loka92/test1strsteel/README.md

# test1strsteel
test for str steel design
