loka92/test1strsteel/roof/detailing/README.md

# Alternative C - fabrication drawing package (detailing) - Rev 6a

`C_detail_drawings.dxf` (DXF R2013, `$INSUNITS = 6` metres), generated by `gen/main.py` from the design Rev 6a calculation model (`design/C/calc/model.py`, `bracing.py`, `members_C.csv`) and `bases_C.md` Rev 8. Audit: 0 errors, 0 fixes; 4953 entities (161 real DIMENSION entities). Title strip on every sheet: "Rev 6a superstructure / Rev 8 bases / bracing Rev 5a", date 2026-09-29, revision table (1 first issue, 2 Rev 3, 3 Rev 6a). PNG renders `S00.png` ... `S06.png` (3360 x 2400) are for checking.

## Design state drawn
- Sections: IPE 300 primaries and eave beams (P13 K19-K20 IPE 330), IPE 240 rafters / edge beams / T2 / ST1-ST2, HEA 140 columns and WP1.
- Levels: roof plane TOS(y) = 3.33 + 0.06 (35.87 - y); primary top TOS + 0.03; cap-plate top TOS - 0.27; column top TOS - 0.29; column length TOS - 0.335 (P13 columns TOS - 0.365), cut to the surveyed plate-top level; clear height 3.03 m under the cap-plate nuts, 3.07 m under the eave primary. No precamber.
- Bracing Rev 5a: 13 roof rod panels in 5 strips (RT-N-W, RT-N-E, RT-JOG, RT-W, RT-E), 8 wall bays B1-B7 and B9; rod gussets only at rod corners, combined gussets at the NE corner; fin plates FP1 (2 M20) and FP2 (2 x 2 M20) at the chord splices.
- Bases Rev 8: all 27 type E (4 dia 16 post-installed rebars at 70 x 240, debonded through the 300 mm slab, 250-300 mm into the column head; plates 300x400x20 or key-pair plates per schedule; Key A / Key A + B / inboard key pairs; K21 pier base P with saddle; WP1). No through-bolts, no ceiling access.
- Load basis Rev 3 on S00; north face jog; stair well open to the north face; gutters G-W / G-E, DP1-DP4.

## Sheets
| Sheet | Title | Content |
|---|---|---|
| S00 | Index and general notes | sheet index, load basis Rev 3, materials, bolts, welding, galvanising, tolerances, erection sequence incl. temporary plan bracing of the south bands, site verification (scan, cores, pull-out tests, slab-top survey), open items |
| S01 | Roof framing plan | true coordinates, all marks with leaders, grids 1-11 / A-H, dimensions, levels table, legend, detail bubbles, drainage |
| S01a | Enlarged partial plans EP-A to EP-D (2x) | east bay + NE corner, jog panel, notch corner, north jog / header / return |
| S02 | Column schedule and wall elevations | schedule per column (K, section, levels, base type, bays, face); elevations W, E, N1, N2, S1, S2, notch face |
| S03 | Sections A-A, B-B, C-C | true scale, levels in mm, clear heights |
| S04 | Connection details D1-D8 | fin plates FP1/FP2, cap plate on HEA 140, chord tie, brace gusset, rod gusset, well upstand, eave gutter, purlin cleat |
| S04a | Connection details D9-D11 | girt cleat and wall panel, WP1, wall sill / base rail |
| S05 | Base details and schedule | type E plan and section, key-pair plan, K21 pier and WP1, base schedule per column, slab and column-head verification notes |
| S06 | Bill of materials | member pieces from members_C.csv Rev 6a, cold-formed, plates, bolts, rebars, keys; 22.2 t |

## Layout check (automated, `gen/common.py check_sheet`)
Every TEXT/MTEXT bounding box is tested against every other text box and against all linework of the sheet other than its own member and leader. Result of the issued build:

| Sheet | Texts | Text-on-text overlaps | Text-on-line overlaps |
|---|---|---|---|
| S00 | 84 | 0 | 0 |
| S01 | 263 | 0 | 0 |
| S01a | 116 | 0 | 0 |
| S02 | 501 | 0 | 0 |
| S03 | 114 | 0 | 0 |
| S04 | 188 | 0 | 0 |
| S04a | 109 | 0 | 0 |
| S05 | 389 | 0 | 0 |
| S06 | 804 | 0 | 0 |

Layout rules applied: member marks beside their member with a leader where needed, never across a bracing X; enlarged partial plans for the dense areas instead of stacked labels; text heights 0.25 plan marks / 0.2 dimensions / 0.5 titles; lineweights by layer; dimension strings outside the drawing; grid bubbles outside the dimensions; legend, north arrow and scale bar on the plan sheets; standard title block and revision table on every sheet.

## Layers
S-COL, S-PRIM, S-RAFT, S-PURL, S-BRACE, S-OPEN, S-GRID, S-DIM, S-TEXT-MEMBER, S-TEXT-DIM, S-TEXT-NOTE, S-TITLE, S-DETAIL, S-HATCH, S-DRAIN, S-EXIST.

## Marks
`Cn/Kn` steel column over concrete column n; `WP1` wind post; `P1-P19` primaries / eave beams; `T2` trimmer; `R1-R11` rafter lines (pieces Rn.i south to north); `ST1/ST2` roof-truss posts; `B1-B7, B9` wall X bays; `RT-*` roof rod strips; `D1-D11` connection details; `E`, `P` base types; sections `A`, `B`, `C`.

## Regenerate
`cd gen && python3 main.py` (build, audit, overlap check, renders); `--norender` skips the PNGs.
