loka92/test1strsteel/roof/3d/README.md

# Alternative C - 3D concept model (design Rev 3, bases Rev 4b)

3D model of the post-and-beam braced steel roof over the existing slab, built for the client to understand the column / beam / bracing system. Everything is generated by `build_3d.py` from the design geometry - nothing is drawn by hand and no member is invented:

- `design/C/calc/model.py` - column nodes (27 concrete columns from `geometry.json`), the 11 rafter lines, the 20 primaries / eave beams / trimmer T2, the 10 braced bays B1-B10, the north-edge jog, `TOS(y) = 3.33 + 0.06 (35.87 - y)`, column tops TOS - 0.30, primary tops TOS + 0.05.
- `design/C/calc/bracing.py` - the 24 roof rod panels (RT-N-W, RT-N-E, RT-S-E, RT-S-W, RT-W, RT-E, RT-JOG).
- `detailing/gen/geom.py` (the drawing generator, cross-checked against model.py at run time) - purlin rows, roof-truss posts ST1 / ST2, WP1 at its Rev 4b position, base types B1 / B2 / P, girt rows, eave rails and the wall header.

Units m, world coordinates identical to the plan (S01) and `geometry.json`; z = 0 is the top of the existing slab. Regenerate with `cd roof/3d && python3 build_3d.py` (ezdxf 1.4, matplotlib). `model_stats.json` holds the entity counts and the source cross-checks.

## Files

| File | Content |
|---|---|
| `C_concept_3d.dxf` | DXF R2013, metres, 368 MESH solids + 64 3D polylines + 41 TEXT marks, audit 0 errors |
| `iso_SW.png`, `iso_SE.png` | isometrics from the south-west / south-east, all layers |
| `iso_NE_no_panel.png` | isometric from the north-east with the sandwich panel hidden (purlins, rafters, roof rods) |
| `elev_N.png`, `elev_S.png` | orthographic elevations from the north and the south |
| `section_xray.png` | panel and purlins hidden, framing faded, wall bays B1-B10 and roof rod panels highlighted and labelled |
| `overview.png` | 4-view composite (SW, SE, NE no panel, x-ray) |
| `build_3d.py`, `model_stats.json` | generator and its output statistics |

## Layers (AutoCAD colour index)

| Layer | Colour | Content | Entities |
|---|---|---|---|
| `3D-EXIST-SLAB` | 253 grey | existing slab 300 mm, L-shape less the notch, stair well (open to the north face) and elevator well as openings | 1 |
| `3D-EXIST-COL` | 253 grey | 27 existing concrete columns 0.2 x 0.4 x 3.5 m below the slab | 27 |
| `3D-COL` | 5 blue | 27 HEA 160 columns C1-C27 (160 x 152, web oriented as on S02) from the base plate to TOS - 0.30, 27 cap plates 200 x 280 x 20, wind post WP1 | 55 |
| `3D-PRIM` | 1 red | 19 IPE 330 primaries / eave beams (330 x 160), level, top at TOS + 0.05, column centre to column centre | 19 |
| `3D-RAFT` | 3 green | 11 IPE 270 rafter lines (270 x 135) on the 6 % plane, split into 51 simple-span pieces at the primaries (fin plates, flange faces + 10 mm); trimmer T2; roof-truss posts ST1 / ST2 (4 pieces) | 56 |
| `3D-PURL` | 8 grey | 110 Z200 purlin pieces (200 x 70) @ 1.5 m following the plane, only over roofed cells (none over the wells or the notch); 2 C200 eave rails | 112 |
| `3D-BRACE-WALL` | 6 magenta | 20 L70x7 diagonals (2 per bay, B1-B10) from the base gusset (+0.15) to the primary / rafter centre line | 20 |
| `3D-BRACE-ROOF` | 2 yellow | 48 M24 rods (2 per panel, 24 panels) at rafter mid-depth; drawn at r = 20 mm for visibility | 48 |
| `3D-BASE` | 30 orange | 28 base plates: B1 / P 300 x 400 x 25, B2 800 x 550 x 30 (centred in the model; the real B2 plates sit 100 outboard / 450 inboard, S05), WP1 250 x 250 x 15 | 28 |
| `3D-PANEL` | 9, 60 % transparent | PIR sandwich panel 50 mm on the purlins (TOS + 0.20 to + 0.25), one plate cut around the elevator well and the stair well; freeze the layer to see the framing | 1 |
| `3D-WALL` | 251 | wall panel outline of the 7 perimeter faces + the 0.5 m return at the jog, 54 girt rows, the wall header over the stair well, the well outlines on the slab | 65 |
| `3D-TEXT` | 7 | 3D-placed TEXT: C1-C27 above each column, B1-B10 outside each braced bay (facing outwards), WP1, T2, ST1, ST2 | 41 |

## Viewing the DXF

The model-space viewport is saved as a **SW isometric, flat shaded with edges** (VPORT direction -1,-1,1, target at the building centre), so AutoCAD / BricsCAD / DWG TrueView open it in 3D. Four named views are stored: `SW-ISO`, `SE-ISO`, `NE-ISO`, `NW-ISO` (`VIEW` > Restore). If the viewer ignores the saved viewport, type `VPOINT` and enter `-1,-1,1` (SW) or `1,-1,1` (SE), then `SHADE` (or `VSCURRENT` > Conceptual); `-VIEW` `_SWISO` also works. Freeze `3D-PANEL` to look at the framing, freeze `3D-PURL` as well to see the roof rods, isolate `3D-BRACE-WALL` + `3D-BRACE-ROOF` + `3D-COL` for the lateral system alone. All bodies are MESH entities (metre units, `$INSUNITS = 6`), so they also import into Rhino, SketchUp, Navisworks and Blender.

## How the system works (plain language)

**Gravity.** Loads land on the 50 mm sandwich panel, which spans 1.5 m between the Z200 purlins; the purlins carry them to the green IPE 270 rafters, the rafters to the red IPE 330 primaries on every column row, and the primaries down the 27 blue HEA 160 columns into the existing concrete columns under the slab. Every joint is a simple pin.

**Lateral (wind, seismic).** Wind on the wall panels goes into the girts, then the columns, which send half up to the roof. The yellow M24 rod panels turn the roof into a stiff plate (diaphragm) that carries the load sideways to the ten magenta X-braced wall bays B1-B10, whose diagonals take it down to the base plates, shear keys and anchors in the slab. Those bays must stay door-free.

**Level primaries, sloping rafters.** The primaries sit level on the column cap plates, so every column and cap detail is the same; the 6 % drainage fall is made by the rafters alone, whose tops follow the plane from 4.55 m (south) to 3.33 m (north).

**Openings.** The wells are not roofed; trimmer T2 and the rafters beside the wells give the purlins and the upstand an edge to bear on. The stair well reaches the north wall, so a wall header replaces the eave beam there.

**Thermal.** East-west movement is restrained by the path B2 - roof rods - B1 and designed for; elsewhere the fin-plate clearances release it.

## Mismatches found between model.py and the drawings

- WP1 is at the notch corner (77.89, 19.97) in `model.py` (wall-load model) but at (77.61, 20.25) on S01 / S02 (Rev 4b, moved 280 mm inboard); the drawn position is used here.
- Rafter lines are not on the column centres on lines 3, 5, 6 and 11: R72 is 100 mm east of K26 (71.99), R78 110 mm west of K10 (77.89), R82 (x 81.85) is 40-70 mm off K3, K11, K17, K21 and R95 (x 95.55) 40-70 mm off K4, K14, K18, K23. The drawings accept this ("columns at true positions") because the rafters bear on the primaries, not on the columns; the model shows the rafters where the design puts them.
- `model.py`'s docstring still describes Rev 2 levels (TOS 3.30, column length TOS - 0.34) while its functions and the drawings are Rev 3 (3.33, TOS - 0.35); the functions are used.
- The rafter / primary / bay / rod-panel lists in `model.py`, `bracing.py` and `detailing/gen/geom.py` agree exactly (checked at run time).
