loka92/test1strsteel/roof/design/C/bases_C.md

# Alternative C - base and anchor design note, Rev 8 (bases_C.md)

**Rev 8 = Rev 7 re-run with the Rev 6 sections (IPE 300 / IPE 240 / HEA 140, brief Rev 7): lighter roof (G, seismic mass -7 %), column HEA 140 on the plate, all 27 reactions re-tabulated; base plates 300 x 400 x 20 (were 25: plate T-stub <= 0.13, plate strip under the key moment <= 0.72 at the E-W bay bases K23 / K22 / K27 / K20 - the governing check there now), rebars, keys and the key-pair layouts unchanged; the reactions of every base are in the tables below and in reactions_C.csv. Levels (Rev 6a, review A1): column top = cap underside TOS - 0.29, base-plate top TOS - 0.335 (grout 25 + plate 20), column length L = TOS - 0.335 exactly; K19 and K20 under the IPE 330 primary P13 30 mm lower (TOS - 0.32 / - 0.365); every column is cut to the surveyed plate-top level.**

**Rev 7 = Rev 6 re-run with the rationalised bracing of design Rev 5 (8 wall bays, B8 and B10 removed): the forces at K15, K19 (B5 alone on the x 68 line), K20, K27 (B7 alone on the x 77.8 line), K10, K16 (no bay) changed; the detail, keys and plates are unchanged.**

**Rev 6 = Rev 5a re-run with load basis Rev 3 (design Rev 4): services 0.10, Q 0.40, no wall self-weight, wind q_p by direction with the flat-roof Table 7.2 zones, net bracing uplift per braced line, and the amplified two-mass seismic case (S_a 0.65 g E-W / 0.61 g N-S, q 1.5) which now governs every braced bay and its bases. The detail is unchanged; utilisations below are the new ones. Key pairs and plate sizes are kept: they are set by the edge condition of each column (parallel-edge shear at Key A), not by the force level, and the E-W bay bases K5, K7, K22, K23 now carry 64-71 kN seismic shear (K7 key pair 0.90).**

Self-contained note for the base reviewer. Rev 5a closes the Rev 5 sign-off (V1-V6) and adopts its recommendation: **one base detail at all 27 columns** - a post-installed rebar connection into the column head (EAD 330087, designed to EN 1992-1-1 8.4 / 8.7), debonded through the 300 mm slab, with the Rev 4b/5 shear keys. No through-bolts, no slab-cone check, no solid-zone criterion anywhere. Loads from `calc/run_all.py` (reactions_C.csv: every column and load case). Units kN, mm, MPa.

**Rev 5a in one paragraph.** V1: the column-head anchorage is a post-installed rebar connection, not an anchor: **4 x dia 16 B500 bars with a threaded end** (M16 thread, or an M16 8.8 rod only if the injection system holds an EAD 330087 assessment for it), embedded **300 mm into the column head where the scan allows, 250 mm minimum**, lapped 1:1 with the corner dia14 bars; capacity by bond f_bd = 2.7 MPa (C25, good bond): 4 x 33.9 = **136 kN at 250 mm** (163 kN at 300), steel 4 x 87 = 350 kN, receiving bars 4 x 67 = 268 kN; l_0 = max(1.5 l_b,rqd, 15 d = 240, 200) <= 250; d < 20 so the existing dia6/200 links are the only transverse steel needed (8.7.4), splitting covered by the EC2 cover rules. V2: the top 300 mm of each bar is **debonded (sleeve), the column part only is injected**, so the edge-slab cone is never loaded. V3: pattern **70 x 240** (26 mm clear to the corner bars), cover-meter scan of the column faces from below projected to the slab top plus GPR from above, 10 mm pilot drill with feed monitoring, relocation +/-15 mm on steel contact, plate holes match-drilled or 30 mm oversize with 10 mm plate washers; V4: proof test of 3 bars to >= 60 kN with displacement readings. K21 is P with the same rebar logic plus the saddle. The former B1 interior detail (4 M20 h_ef 250 in the slab, 800 x 800 solid zone) is kept in the appendix as the client's fewer-holes option. Holes to scan and drill: **27 x 4 = 108** (plus 37 key pockets set by the same scan).

## 1. The base detail (type E, all 27 columns; P = E + saddle at K21)

- Base plate 300 x 400 x 20 S275 (Key A / Key A + B bases) or the key-pair plate of section 3 (20 mm, no stiffeners: no lever, concentric uplift), on 25 +/- 5 mm non-shrink grout; **columns cut to the surveyed plate-top level**.
- **4 dia 16 B500 post-installed bars, threaded end M16 (EAD 330087 injection system), at 70 x 240** - 240 along the concrete column's long axis, 70 across, centred on the column - i.e. 35 / 120 mm from the column centre, 26 mm nominal clear to the corner dia14 bars (cover 30, links dia6). Hole 20 mm, depth 300 (slab) + 300 (column head; 250 minimum); the **top 300 mm debonded with a plastic sleeve, resin injected in the column part only** (V2). Plate holes 30 mm with 10 mm plate washers (or match-drilled after the bars are set); nuts snug + 1/4 turn.
- Shear as Rev 4b/5: Key A SHS 90x90x8 under the column centre (interior and Key A + Key B bases), Key B 60 mm bar 180 inboard (c1 250) where an outward shear > 3 kN points to an edge < 0.25 m, inboard key pairs at K1, K2, K5, K7, K10, K15, K18, K19, K20, K22, K23, K25, K27; rigid-post key-moment model; saddle at K21.
- **Scan / drill procedure (V3):** (1) cover-meter scan of all four column faces below the slab over the top 600 mm: bar positions, link spacing, cover (+/-3-5 mm); (2) GPR from above over the head to confirm and to see the slab top bars and the solid zone; (3) project the bars to the slab top, mark the 70 x 240 pattern and the key pockets, adjust +/-15 mm to keep >= 20 mm clear of every bar; (4) 10 mm pilot drill 600 deep with feed monitoring - on steel contact stop, relocate within +/-15 mm, re-pilot; (5) 20 mm production hole, clean (brush/blow x2), sleeve the top 300, inject the bottom 300, set the bar; (6) proof test 3 bars (one per zone) to >= 60 kN holding 2 min with displacement <= 1 mm (V4); (7) file the scan sheet with the final pattern per head.

**Wind post WP1** (notch corner, no concrete column): post 280 mm inboard on both axes at (77.61, 20.25), plate 250 x 250 x 15, one centred 60 mm key (c1 250 both ways), 2 M12 for location, no uplift. Demand 11.4 / 8.5 kN vs 41.9 kN -> 0.27.

## 2. Resistances (EN 1992-1-1 8.4 / 8.7 for the rebar connection; EN 1992-4 for the keys; EN 1993-1-8 and EN 1992-1-1 6.7 for plates and keys)

| Item | Formula / factors | Value |
|---|---|---|
| (appendix option B1) anchor steel, per M20 | 196 / 1.4 | 140.0 kN |
| (appendix option B1) cone, single, slab 300 | k 7.2 (cracked) sqrt(25) 250^1.5 | N0_Rk,c = 142.3 kN |
| (appendix option B1) cone group, interior (800 zone) | s_cr,N 750, c_cr 375: A_c,N/A0 = 800 x 800 / 750^2 = 1.138, psi_s 0.91 (zone-limited: h_ef 250 gives the same 98 kN as 200) | N_Rd,c = 98.0 kN |
| (for reference) cone group with one edge at 100 mm / corner | outboard row 60 mm from the face | 50.5 / 37.8 kN - why edge bases are type E |
| **E / P rebar bond in the column head (EC2 8.4)** | 4 x pi x 16 x l_b x f_bd, f_bd = 2.25 x 1.0 x 1.0 x f_ctd (1.2) = 2.7 MPa (C25, good bond): embed 250 (minimum) -> 4 x 33.9 | **N_Rd = 136 kN** (embed 300: 163 kN) |
| E rebar steel | dia 16 B500, 4 x 201 x 435 | 350 kN |
| E lap with the corner dia14 bars | each bar laps 1:1 with the nearest corner dia14 (26 mm clear, close lap, alpha6 1.5): receiving capacity 4 x 154 x 435 = 268 kN; K19: sigma_sd = 18.3 kN / 201 mm2 = 91 MPa -> l_b,rqd = 4 x 91 / 2.7 = 135, l_0 = 1.5 x 135 = 203 < l_0,min = 15 d = 240 <= 250 provided; d < 20: existing dia6/200 links are the transverse steel (8.7.4); splitting by the EC2 cover rules (c 30 >= d) | 268 kN |
| E slab part | debonded (sleeve) - the slab cone and the slab bond are never loaded (V2); the bar tip sits 250-300 mm inside a column that continues downward: no cone | - |
| Eccentric tension | psi_ec,N = 1/(1 + 2 e_N/s_cr,N) per direction, e_N = M_key/N_t (key moment V x 85 mm); max anchor N_t/4 + M/(2 s) | per case |
| Plate bearing (compression) | c = 61 mm, A_eff = 663 cm2 at 10 MPa | 663 kN |
| Plate T-stub under concentric uplift, per row | m = 65, l_eff 300, t 25 | 506 kN |
| Key A bearing (centre key and inboard pairs) | rigid stub, z0 = 113 mm, p_max = V z0/(b(z0 D - D^2/2)), b 90, D 180, sigma_Rd 1.5 f_cd = 25 MPa (confined, >= 250 mm from a face) | **V_Rd,A = 83.8 kN** per key |
| Key A bending / weld | SHS 90x90x8 W_pl 75 cm3 f_y 355 -> 26.6 kNm at lever 85; a = 8 | 313 / 673 kN |
| Key A parallel to an edge (EN 1992-4 7.2.2.5 with psi_alpha = 2) | c1 = edge distance - 45: c1 55 -> 18.5 kN, c1 155 -> 56.6 kN, c1 255 -> 90.9 kN | used at K3, K4, K6, K8, K11, K14, K16, K17, K24, K26 |
| Key towards an edge (Key B c1 250; key pair c1 >= 255; Key A 0.25-0.6 m) | 7.2.2.5, k9 1.7 cracked, d_nom 60 / 90, l_f 180, A_c,V/A0, psi_h | c1 250 (d 60): **41.9 kN**; c1 255 (d 90): **45.5 kN**; c1 355 (d 90): 58.2 kN |
| Key B bearing / bending | 60 mm bar, plain f_cd; W_pl d^3/6, f_y 335 | 37.2 / 142 kN |
| P (K21) saddle | two 15 mm plates 400 x 150 on the pier faces, cantilever 150 | 82.5 kN |

**Key-moment model (T3), one model for every key:** the shear resultant acts 85 mm below the plate; the moment V x 85 mm is carried by the grouted pocket as a rigid post (pressure linear about the rotation point z0 = 113 mm, p_max <= 25 MPa - the bearing check above), not by the anchors or bolts. Justification: the 180 mm stub in a C50 grout annulus (E about 30 GPa, 25 mm thick) in a 200 mm pocket has a rotational stiffness of the order of 10 MNm/rad, two orders above the couple of four M20 anchors 80 mm apart (about 4 x 250 kN/mm x 0.04^2 = 0.1 MNm/rad); the pocket therefore takes the moment before the anchors move. Hence the rebars carry N_t only, concentric. Bars carry no shear (30 mm oversize holes); keys and saddle carry no tension.

## 3. Final base table (ULS envelope; reactions_C.csv has every case). Rebar pattern 70 x 240: the 240 runs along the concrete column's long axis (E-W for the 0.4 x 0.2 columns K1, K2, K5, K9-K14, K21-K24; N-S for the others), the 70 across it; 4 holes per base, 108 in all.

| Col | Type | Long axis | Bays | Near edges (< 0.25 m) | Keys | Rebars (mm from the column centre) | N_c max (case) | N_t max (case) | V max (case) | Tension util. | Key util. | Plate util. | **Governing** | Base plate (mm from the column centre) | Scan / drill | Slab condition (keys and plate only) |
|---|---|---|---|---|---|---|---|---|---|---|---|---|---|---|---|---|
| K1 | **E** | E-W | B1 | +y | A-pair at (-300, -200) / (300, -200) | 4 dia16 B500 at (+/-120, +/-35), embed 300 (250 min) into the head, top 300 debonded | 48.7 (ULS2E) | 37.6 (ULS3N) | 41.7 (ULS4+x) | 0.28 | 0.43 | 0.07 | **0.43** (plate strip at key moment) | x -400..400, y -300..100 (800 x 400 x 20) | face cover-meter + GPR, pilot 10, relocate +/-15, plate holes 30 | solid 300 over the key bodies x -700..700, y -600..100 |
| K2 | **E** | E-W | B1 | +y | A-pair at (-300, -200) / (300, -200) | 4 dia16 B500 at (+/-120, +/-35), embed 300 (250 min) into the head, top 300 debonded | 44.2 (ULS2W) | 38.6 (ULS3E) | 41.7 (ULS4-x) | 0.28 | 0.43 | 0.07 | **0.43** (plate strip at key moment) | x -400..400, y -300..100 (800 x 400 x 20) | face cover-meter + GPR, pilot 10, relocate +/-15, plate holes 30 | solid 300 over the key bodies x -700..700, y -600..100 |
| K3 | **E** | N-S | - | +y | A centre | 4 dia16 B500 at (+/-35, +/-120), embed 300 (250 min) into the head, top 300 debonded | 17.4 (ULS2N) | 20.6 (ULS3N) | 14.1 (ULS2N) | 0.15 | 0.37 | 0.03 | **0.37** (Key B outward +y) | 300 x 400 x 20 | face cover-meter + GPR, pilot 10, relocate +/-15, plate holes 30 | solid 300 under the plate and Key A pocket (+/- 400) |
| K4 | **E** | N-S | - | +x,+y | A centre | 4 dia16 B500 at (+/-35, +/-120), embed 300 (250 min) into the head, top 300 debonded | 10.4 (ULS2N) | 13.3 (ULS3E) | 14.3 (ULS2N) | 0.10 | 0.36 | 0.02 | **0.36** (Key B outward +x) | 300 x 400 x 20 | face cover-meter + GPR, pilot 10, relocate +/-15, plate holes 30 | solid 300 under the plate and Key A pocket (+/- 400) |
| K5 | **E** | E-W | B2 | +y | A-pair at (-300, -200) / (300, -200) | 4 dia16 B500 at (+/-120, +/-35), embed 300 (250 min) into the head, top 300 debonded | 47.6 (ULS2E) | 41.7 (ULS3W) | 63.0 (ULS4+x) | 0.31 | 0.65 | 0.07 | **0.65** (plate strip at key moment) | x -400..400, y -300..100 (800 x 400 x 20) | face cover-meter + GPR, pilot 10, relocate +/-15, plate holes 30 | solid 300 over the key bodies x -700..700, y -600..100 |
| K6 | **E** | N-S | - | -x,+y | A centre | 4 dia16 B500 at (+/-35, +/-120), embed 300 (250 min) into the head, top 300 debonded | 12.4 (ULS2N) | 15.5 (ULS3N) | 15.7 (ULS2N) | 0.11 | 0.39 | 0.02 | **0.39** (Key B outward -x) | 300 x 400 x 20 | face cover-meter + GPR, pilot 10, relocate +/-15, plate holes 30 | solid 300 under the plate and Key A pocket (+/- 400) |
| K7 | **E** | N-S | B2 | +x,+y | A-pair at (-200, -700) / (-200, -100) | 4 dia16 B500 at (+/-35, +/-120), embed 300 (250 min) into the head, top 300 debonded | 43.5 (ULS4+x) | 27.4 (ULS4-x) | 63.0 (ULS4-x) | 0.20 | 0.88 | 0.07 | **0.88** (E key pair bearing) | x -300..100, y -800..150 (400 x 950 x 20) | face cover-meter + GPR, pilot 10, relocate +/-15, plate holes 30 | solid 300 over the key bodies x -600..100, y -1100..200 |
| K8 | **E** | N-S | - | -x | A centre | 4 dia16 B500 at (+/-35, +/-120), embed 300 (250 min) into the head, top 300 debonded | 19.3 (ULS2N) | 18.6 (ULS3W) | 14.0 (ULS2N) | 0.14 | 0.37 | 0.03 | **0.37** (Key B outward -x) | 300 x 400 x 20 | face cover-meter + GPR, pilot 10, relocate +/-15, plate holes 30 | solid 300 under the plate and Key A pocket (+/- 400) |
| K9 | **E** | E-W | - | - | A centre | 4 dia16 B500 at (+/-120, +/-35), embed 300 (250 min) into the head, top 300 debonded | 48.4 (ULS2N) | 38.4 (ULS3N) | 0.0 (ULS1) | 0.28 | 0.00 | 0.07 | **0.28** (E rebar bond in the column head, embed 250 min) | 300 x 400 x 20 | face cover-meter + GPR, pilot 10, relocate +/-15, plate holes 30 | solid 300 under the plate and Key A pocket (+/- 400) |
| K10 | **E** | E-W | - | +y | A-pair at (-300, -200) / (300, -200) | 4 dia16 B500 at (+/-120, +/-35), embed 300 (250 min) into the head, top 300 debonded | 36.4 (ULS2N) | 26.1 (ULS3N) | 0.0 (ULS1) | 0.19 | 0.00 | 0.05 | **0.19** (E rebar bond in the column head, embed 250 min) | x -400..400, y -300..100 (800 x 400 x 20) | face cover-meter + GPR, pilot 10, relocate +/-15, plate holes 30 | solid 300 over the key bodies x -700..700, y -600..100 |
| K11 | **E** | E-W | - | +y | A centre | 4 dia16 B500 at (+/-120, +/-35), embed 300 (250 min) into the head, top 300 debonded | 38.0 (ULS2N) | 26.2 (ULS3N) | 0.0 (ULS1) | 0.19 | 0.00 | 0.06 | **0.19** (E rebar bond in the column head, embed 250 min) | 300 x 400 x 20 | face cover-meter + GPR, pilot 10, relocate +/-15, plate holes 30 | solid 300 under the plate and Key A pocket (+/- 400) |
| K12 | **E** | E-W | - | - | A centre | 4 dia16 B500 at (+/-120, +/-35), embed 300 (250 min) into the head, top 300 debonded | 60.4 (ULS2N) | 44.6 (ULS3N) | 0.0 (ULS1) | 0.33 | 0.00 | 0.09 | **0.33** (E rebar bond in the column head, embed 250 min) | 300 x 400 x 20 | face cover-meter + GPR, pilot 10, relocate +/-15, plate holes 30 | solid 300 under the plate and Key A pocket (+/- 400) |
| K13 | **E** | E-W | - | - | A centre | 4 dia16 B500 at (+/-120, +/-35), embed 300 (250 min) into the head, top 300 debonded | 47.6 (ULS2N) | 38.7 (ULS3E) | 0.0 (ULS1) | 0.28 | 0.00 | 0.07 | **0.28** (E rebar bond in the column head, embed 250 min) | 300 x 400 x 20 | face cover-meter + GPR, pilot 10, relocate +/-15, plate holes 30 | solid 300 under the plate and Key A pocket (+/- 400) |
| K14 | **E** | E-W | B6 | +x | A centre | 4 dia16 B500 at (+/-120, +/-35), embed 300 (250 min) into the head, top 300 debonded | 33.0 (ULS4+y) | 27.8 (ULS3N) | 35.0 (ULS4-y) | 0.20 | 0.57 | 0.05 | **0.57** (Key A parallel to edge +x) | 300 x 400 x 20 | face cover-meter + GPR, pilot 10, relocate +/-15, plate holes 30 | solid 300 under the plate and Key A pocket (+/- 400) |
| K15 | **E** | N-S | B5 | -x | A-pair at (200, -300) / (200, 300) | 4 dia16 B500 at (+/-35, +/-120), embed 300 (250 min) into the head, top 300 debonded | 44.3 (ULS4+y) | 36.3 (ULS4-y) | 48.3 (ULS4-y) | 0.27 | 0.50 | 0.07 | **0.50** (plate strip at key moment) | x -100..300, y -400..400 (400 x 800 x 20) | face cover-meter + GPR, pilot 10, relocate +/-15, plate holes 30 | solid 300 over the key bodies x -100..600, y -700..700 |
| K16 | **E** | N-S | - | - | A centre | 4 dia16 B500 at (+/-35, +/-120), embed 300 (250 min) into the head, top 300 debonded | 19.5 (ULS2N) | 5.0 (ULS3N) | 0.0 (ULS1) | 0.04 | 0.00 | 0.03 | **0.04** (E rebar bond in the column head, embed 250 min) | 300 x 400 x 20 | face cover-meter + GPR, pilot 10, relocate +/-15, plate holes 30 | solid 300 under the plate and Key A pocket (+/- 400) |
| K17 | **E** | N-S | - | - | A centre | 4 dia16 B500 at (+/-35, +/-120), embed 300 (250 min) into the head, top 300 debonded | 20.8 (ULS2N) | 5.0 (ULS3S) | 0.0 (ULS1) | 0.04 | 0.00 | 0.03 | **0.04** (E rebar bond in the column head, embed 250 min) | 300 x 400 x 20 | face cover-meter + GPR, pilot 10, relocate +/-15, plate holes 30 | solid 300 under the plate and Key A pocket (+/- 400) |
| K18 | **E** | N-S | B6,B9 | +x | A-pair at (-200, -300) / (-200, 300) | 4 dia16 B500 at (+/-35, +/-120), embed 300 (250 min) into the head, top 300 debonded | 34.2 (ULS4+y) | 14.8 (ULS3E) | 36.2 (ULS4+y) | 0.11 | 0.37 | 0.05 | **0.37** (plate strip at key moment) | x -300..100, y -400..400 (400 x 800 x 20) | face cover-meter + GPR, pilot 10, relocate +/-15, plate holes 30 | solid 300 over the key bodies x -600..100, y -700..700 |
| K19 | **E** | N-S | B5 | -x | A-pair at (200, -300) / (200, 300) | 4 dia16 B500 at (+/-35, +/-120), embed 300 (250 min) into the head, top 300 debonded | 76.0 (ULS2N) | 50.2 (ULS3W) | 48.3 (ULS4+y) | 0.37 | 0.50 | 0.11 | **0.50** (plate strip at key moment) | x -100..300, y -400..400 (400 x 800 x 20) | face cover-meter + GPR, pilot 10, relocate +/-15, plate holes 30 | solid 300 over the key bodies x -100..600, y -700..700 |
| K20 | **E** | N-S | B7 | +x | A-pair at (-200, -300) / (-200, 300) | 4 dia16 B500 at (+/-35, +/-120), embed 300 (250 min) into the head, top 300 debonded | 84.2 (ULS2S) | 43.2 (ULS3N) | 63.8 (ULS4-y) | 0.32 | 0.66 | 0.13 | **0.66** (plate strip at key moment) | x -300..100, y -400..400 (400 x 800 x 20) | face cover-meter + GPR, pilot 10, relocate +/-15, plate holes 30 | solid 300 over the key bodies x -600..150, y -700..700 |
| K21 | **P** | E-W | - | +y,-y | saddle | 4 dia16 B500 at (+/-120, +/-35), embed 300 (250 min) into the head, top 300 debonded | 27.0 (ULS2N) | 9.3 (ULS3S) | 17.1 (ULS2E) | 0.07 | 0.21 | 0.04 | **0.21** (saddle plates) | 300 x 400 x 20 + saddle | face cover-meter + GPR, pilot 10, relocate +/-15, plate holes 30 | pier top 500 mm scanned; faces accessible |
| K22 | **E** | E-W | B3 | -y | A-pair at (-300, 200) / (300, 200) | 4 dia16 B500 at (+/-120, +/-35), embed 300 (250 min) into the head, top 300 debonded | 70.3 (ULS2E) | 27.4 (ULS3W) | 69.0 (ULS4+x) | 0.20 | 0.71 | 0.11 | **0.71** (plate strip at key moment) | x -400..400, y -100..300 (800 x 400 x 20) | face cover-meter + GPR, pilot 10, relocate +/-15, plate holes 30 | solid 300 over the key bodies x -700..700, y -100..600 |
| K23 | **E** | E-W | B3,B9 | +x,-y | A-pair at (-700, 200) / (-100, 200) | 4 dia16 B500 at (+/-120, +/-35), embed 300 (250 min) into the head, top 300 debonded | 54.8 (ULS4+x) | 45.1 (ULS3E) | 70.2 (ULS4-x) | 0.33 | 0.72 | 0.08 | **0.72** (plate strip at key moment) | x -800..200, y -100..300 (1000 x 400 x 20) | face cover-meter + GPR, pilot 10, relocate +/-15, plate holes 30 | solid 300 over the key bodies x -1100..200, y -100..600 |
| K24 | **E** | E-W | - | - | A centre | 4 dia16 B500 at (+/-120, +/-35), embed 300 (250 min) into the head, top 300 debonded | 16.5 (ULS2N) | 10.5 (ULS3E) | 13.4 (ULS2E) | 0.08 | 0.23 | 0.02 | **0.23** (Key A towards edge -y) | 300 x 400 x 20 | face cover-meter + GPR, pilot 10, relocate +/-15, plate holes 30 | solid 300 under the plate and Key A pocket (+/- 400) |
| K25 | **E** | N-S | B4 | -x | A-pair at (200, 0) / (200, 600) | 4 dia16 B500 at (+/-35, +/-120), embed 300 (250 min) into the head, top 300 debonded | 40.4 (ULS4-x) | 27.8 (ULS4+x) | 31.9 (ULS4+x) | 0.20 | 0.38 | 0.06 | **0.38** (E key pair bearing) | x -100..300, y -150..700 (400 x 850 x 20) | face cover-meter + GPR, pilot 10, relocate +/-15, plate holes 30 | solid 300 over the key bodies x -100..600, y -300..1000 |
| K26 | **E** | N-S | B4 | - | A centre | 4 dia16 B500 at (+/-35, +/-120), embed 300 (250 min) into the head, top 300 debonded | 42.2 (ULS4+x) | 26.0 (ULS4-x) | 31.9 (ULS4-x) | 0.19 | 0.38 | 0.06 | **0.38** (Key A SHS bearing) | 300 x 400 x 20 | face cover-meter + GPR, pilot 10, relocate +/-15, plate holes 30 | solid 300 under the plate and Key A pocket (+/- 400) |
| K27 | **E** | N-S | B7 | +x | A-pair at (-200, 0) / (-200, 600) | 4 dia16 B500 at (+/-35, +/-120), embed 300 (250 min) into the head, top 300 debonded | 50.4 (ULS4-y) | 40.9 (ULS4+y) | 63.8 (ULS4+y) | 0.30 | 0.66 | 0.08 | **0.66** (plate strip at key moment) | x -300..100, y -150..700 (400 x 850 x 20) | face cover-meter + GPR, pilot 10, relocate +/-15, plate holes 30 | solid 300 over the key bodies x -600..150, y -300..1000 |
| WP1 | post | - | - | +x,-y | one 60 mm key centred, c1 250 | 2 M12 location | 1.7 | 0 | 11.4 | - | 0.27 | - | **0.27** (key edge) | 250 x 250 x 15 at (77.61, 20.25) | GPR for the edge beam | notch edge beam, 600 x 600 around the post |

Worst base **K7 (E): 0.88 (E key pair bearing, ULS4-x)**; worst tension 0.37 at K19; worst key 0.88 at K7; worst plate 0.13 at K20. All 27 bases and WP1 <= 1.0 with the real slab edges; tension utilisations are on the 250 mm minimum embedment (136 kN), 0.83 x these with the 300 mm target embedment.

## 4. Worked checks

**K12 (E)** - 4 dia16 post-installed rebars 70 x 240, embed 250-300 into the column head, debonded through the slab; keys A centre. Governing tension case ULS3N: N_t 44.6 kN with V = (0.0, 0.0): Key A SHS bearing 0.00; E rebar bond in the column head, embed 250 min (N_Rd 136) 0.33; E rebar steel dia 16 B500 (11 kN each) 0.13; E corner dia14 bars receiving the lap 0.17; (info) E lap length l_0 240 mm vs 250 provided 0.00; plate T-stub 0.04; plate strip at key moment 0.00. Max shear case ULS1: 0.0 kN.

**K7 (E)** - 4 dia16 post-installed rebars 70 x 240, embed 250-300 into the column head, debonded through the slab; keys inboard pair. Governing tension case ULS4-x: N_t 27.4 kN with V = (-61.2, 0.0): E key pair bearing 0.88; E key pair outward (c1 >= 255) 0.23; E rebar bond in the column head, embed 250 min (N_Rd 136) 0.20; E rebar steel dia 16 B500 (7 kN each) 0.08; E corner dia14 bars receiving the lap 0.10; (info) E lap length l_0 240 mm vs 250 provided 0.00; plate T-stub 0.03; plate strip at key moment 0.65. Max shear case ULS4-x: 63.0 kN.

**K23 (E)** - 4 dia16 post-installed rebars 70 x 240, embed 250-300 into the column head, debonded through the slab; keys inboard pair. Governing tension case ULS4-x: N_t 43.2 kN with V = (-67.3, 9.0): E key pair bearing 0.48; E key pair outward (c1 >= 255) 0.17; E rebar bond in the column head, embed 250 min (N_Rd 136) 0.32; E rebar steel dia 16 B500 (11 kN each) 0.12; E corner dia14 bars receiving the lap 0.16; (info) E lap length l_0 240 mm vs 250 provided 0.00; plate T-stub 0.04; plate strip at key moment 0.72. Max shear case ULS4-x: 70.2 kN.

**K19 (E)** - 4 dia16 post-installed rebars 70 x 240, embed 250-300 into the column head, debonded through the slab; keys inboard pair. Governing tension case ULS4+y: N_t 22.6 kN with V = (0.0, 46.4): E key pair bearing 0.35; E key pair outward (c1 >= 255) 0.35; E rebar bond in the column head, embed 250 min (N_Rd 136) 0.17; E rebar steel dia 16 B500 (6 kN each) 0.06; E corner dia14 bars receiving the lap 0.08; (info) E lap length l_0 240 mm vs 250 provided 0.00; plate T-stub 0.02; plate strip at key moment 0.50. Max shear case ULS4+y: 48.3 kN.

## 5. Site conditions: no solid-zone criterion for the anchorage

- The rebar connection depends on the column head only (6 dia14, dia6 links, C25): confirmed by the face cover-meter scan and 3-6 cores at heads (grade); no slab cone is loaded anywhere, so the 800 x 800 solid-zone criterion of Rev 4b/5 is withdrawn.
- The slab must still be solid (no blocks) and 300 mm thick under each base plate and around the key pockets (Key A: +/- 400 mm; key pairs: the key breakout bodies of the table, +/- 700 along the wall for the standard pair) - GPR from above at all 27 heads, which is also needed for the slab top bars at the pockets.
- If a column head shows fewer than 4 sound corner bars or links > 200 mm, the embedment goes to 300-350 mm (bond alone: 4 x 33.9 kN per 250 mm) and the lap is re-checked with the scanned bars before drilling; if the head cannot be drilled at all, the appendix B1 detail with its solid-zone condition applies at that head.

## 6. Before anchor installation

1. Scan sequence of section 1 (faces from below, GPR from above, pilot drill); pockets 140 / 110 mm placed to cut at most one slab top bar.
2. Proof tests (V4): 3 production bars (one interior, one edge, one corner head) loaded to >= 60 kN, held 2 min, displacement <= 1 mm; injection system with an EAD 330087 assessment for post-installed rebar, installer certified for it.
3. Drill 20 mm x 600 (300 slab + 300 head; 250 head minimum where the scan forces a shallower hole), clean, sleeve the top 300, inject the column part, set the bar; nuts snug + 1/4 turn after the grout has cured; the scan sheet with the final pattern is filed per head.

## Appendix - client option B1 for the 7 interior columns (fewer holes into column heads)

4 M20 8.8 resin anchors at 80 x 280, h_ef 250 in the 300 mm slab, cone in the 800 x 800 solid zone (98 kN interior, x 0.92 at the diagonal opening corners K16/K17), same plate and Key A. Condition: GPR-verified solid zone >= the minimum below at each of the 7 heads; saves 28 column-head holes. Utilisation and minimum zone:

| Col | B1 tension util. | Governing | Min. solid zone (mm, 300 thick) |
|---|---|---|---|
| K9 | 0.39 | anchor group cone, real edges | 550 |
| K12 | 0.46 | anchor group cone, real edges | 600 |
| K13 | 0.39 | anchor group cone, real edges | 550 |
| K16 | 0.06 | anchor group cone, real edges, -8 % diagonal corner | 400 |
| K17 | 0.07 | anchor group cone, real edges, -8 % diagonal corner | 400 |
| K24 | 0.11 | Key A towards edge -y | 400 |
| K26 | 0.33 | Key A SHS bearing | 450 |

All other 20 columns stay type E in this option (edges / corners: the slab cone with the real edge is 38-50 kN).
