loka92/test1strsteel/roof/design/C/design_report_C.md

# Alternative C - post-and-beam braced frame: design report, Rev 6a (load basis Rev 3, sections IPE 300/240 + P13 IPE 330, HEA 140, bases Rev 8, levels per review A1)

System C: E-W IPE 300 primaries on the column rows, N-S IPE 240 rafters, pinned HEA 140 columns (Rev 6: the lighter section set adopted by the client, brief Rev 7), vertical X bracing for all lateral load, roof-plane X bracing as the diaphragm. All numbers come from `calc/` (`python3 run_all.py; python3 write_report.py`); ULS design values unless stated. Companion note: `bases_C.md` (bases and anchors, self-contained).

## 0. Change log Rev 1 -> Rev 2 (basis Rev 2 and independent review, every finding addressed)

| Ref | Change |
|---|---|
| Basis: wind zones | e = 20 m: F/G strip 2.0 m deep, F corners 5.0 m along the eave; zone sets kept as the envelope (theta = 180 values for both N and S wind, F5). Roof uplift total W_S -669 kN incl. gutter (Rev 1 -614). |
| Basis / F4 | Horizontal component of the roof suction added: 14.8 kN char. northward for S wind (resultant at x 81.4, y 24.5), also as an N-S load under E/W wind; S-wind roof-level force 108.7 -> **62.5 kN** (+36 %); no friction term. Bracing, braced columns and bases re-run. |
| Basis: anchorage / F1, F2, F3 | New base for all 27 columns: 4 M20 through the slab into the column head (h_ef 300, 80 x 280 in the core), bond + cracked cone in the slab, **grouted shear key** for all shear (no anchor shear, so the cracked-edge question F2 disappears), plate 25 mm. Wall shear wL/2 is at the column base in every case (F1); base struts deleted, every base carries its full concurrent H + V_wall (F3). |
| Bracing layout | K17-K21 (Rev 1 B8) dropped - K21 is a 200 mm pier between the notch edge and the shaft opening. N-S bracing now on three lines with two bays in series each: B5 K15-K19 + **B10 K19-K25**, B7 K20-K27 + **B8 K10-K16**, B6 K14-K18 + **B9 K18-K23**; E-W B1-B4 unchanged. 10 bays; no braced-bay base has its bay shear towards a free edge < 0.25 m. |
| F6 | Gutter/fascia 0.25 kN/m (G) and -0.50 kN/m (W) on the north eave in the take-down (rafter cantilevers, eave beams, fin plates). West-block north edge kept at y 35.87 (wall line); drainage's gutter line y 35.37 to be coordinated (open item 6). |
| F7 | Column interaction with k_zy from Annex B Table B.2 (0.97-1.00): K25 0.80, K23 0.79, K22 0.75. HEA 160 confirmed. |
| F8 | Purlin uplift re-run with the 2.0 m / 5.0 m zones: corner spans (3.07 m, zone F) 8.3 kNm, stair strip 4.07 m 8.6 kNm; mid-span anti-sag row on all spans; supplier uplift capacity before order (open item 3). |
| F9 | Seismic: ULS-4 rows (1.0 G +/- 1.0 E, both directions, 5 % eccentricity) added to reactions_C.csv; floor amplification through the existing building stated as open item 5. |
| F10 | Roof diaphragm re-modelled with the rods in the drawn cells; east/west edge trusses now use diagonals over two rafter bays (depth 5.65 / 4.10 m) and posts ST1 (y 24.46, R90-R95) / ST2 (y 26.37, R68-R72) at the wall-column lines; M24 rods throughout; truss deflection by virtual work: east wall drift 10.3 mm, west 13.2 mm (SLS, incl. bay sway) vs h/150 = 26-28 mm. |
| F11 | (superseded by Rev 3: TOS(35.87) = 3.33, 3.02 m clear under the cap nuts) TOS(35.87) = 3.30 m, primary top at TOS + 0.05: clear height 3.03 m, rafter/primary bottom-flange clearance 18 mm nominal, 13 mm at the down-slope flange tip. T1 at y 35.44 and T2 at y 24.09 (half a flange inside the opening edges). R82 at x 81.85 over the shaft east wall line: client to confirm (open item 7). |
| F12 | Cap-plate bolts at pitch 200 (plate 200 x 280 x 20); primaries bolted before the rafters are landed. |
| F13 | reactions_C.csv now one row per column and load case (594 rows: ULS-1, ULS-2/3 x 4 wind directions, ULS-4 x 4, SLS) with concurrent N, V_x, V_y, near-edge flags and the base utilisation; WP1 included; envelope in section 9. |
| F14 | Angle bearing with e2 = 30 mm (124 kN per bolt): B8 gusset 0.57. |
| F15 | Base struts and wall-rail anchorage deleted; the lateral system is 10 wall bays + 13 rod panels + 2 posts. |
| **Bases Rev 3 / R1-R7** | Section 6 and `bases_C.md` re-issued after the base re-review: R1 column-cage resistance withdrawn, outward shear at the 14 near-edge bases (Rev 3 count) through a second key 180 mm inboard (c1 = 250, plain-concrete edge breakout 41.9 kN) and a saddle at the K21 pier, WP1 moved 280 mm inboard; R2 key moments V x 85 mm carried into the anchor group (psi_ec,N) and the max anchor; R3 minimum solid zone per base, coring acceptance criterion (>= 750 x 750 x 250, C25, edge beams) and a through-bolt fallback pre-designed at 9 bases; R4 anchors h_ef 200 and pockets 200 deep in the slab only, no drilling into the column heads (permitted by the client, shown unnecessary and risky); R5 f_y 335 for the bar, Key A edge check to 0.6 m; R6/R7 tables with spacing orientation, key moment, max anchor, minimum zone. Worst base at Rev 3: K19 0.91 (superseded by Rev 4). |
| **Bases Rev 4 / S1-S4** | Real slab edges modelled (column flush with the face: outboard anchor row 60 mm from the edge; shaft and stair openings as free edges): concentric cone 50 / 38 kN at edge / corner heads, Key A parallel-to-edge 18-24 kN. Base type chosen per column: **B1** concentric anchors at 0 bases (), **B2** through-bolts + inboard key pair (corrected lever statics T = N_t b/(b-c), stiffened 30 mm plate) at 0 bases (), **P** pier anchors + saddle at K21. One-sided coring criterion at edge heads. |
| **Bases Rev 4a / T1-T6** | Per-base B2 plate lengths and coring zones for the shifted layouts (K23 1000 x 550 plate, zone -1100..+250 along; K25 550 x 900 and K27 600 x 900, zone to +1000; standard 800 x 550, zone +/- 700); coring criterion made identical to the cone extents used (B1 edge heads: inboard >= 340, +/- 400 along); ONE key-moment model - rigid post in the grouted pocket - for every key (psi_ec dropped; K7 now 0.85 on the Key A parallel-edge check, cone 0.52; K14 0.49); 8 % cone reduction at the diagonal opening corners K3, K16, K17; under-slab plate 25 mm, class-3 stiffeners, skewed levers at K23/K25/K27 and the T/C couple for the slab designer stated; bond quoted with the real extents. Worst base at Rev 4a: K7 0.85 (superseded). |
| **Design Rev 3 / final critique C1-C14** | C1 north-face jog modelled: wall and roof edge at y 35.37 for x 67.89-81.79 (K6, K5, K7 on that wall), 35.87 east of x 81.79; the stair well reaches the north face, so no roof, no T1 and no eave beam across it (wall header only); 0.5 m wall return at x 81.79 on brackets from K3; rafters R68-R78 end at 35.37 (0.10-0.20 m cantilevers); gutters G-W at 35.37 and G-E at 35.87 with stop ends; roofed area 439.3 m2; loads, bracing (S-wind roof force 62.5 kN), reactions, CSVs and figure re-run. C3 plane raised 30 mm, TOS(35.87) = 3.33: **3.02 m clear under the cap-plate nuts at K1/K2**, one figure; C2 column length TOS - 0.35 (B2 0.355). C4 slotted fin plates deleted; conditioned-hall range +/-20 K, erection state +/-30 K; E-W chord path B2-RT-N-W-y 29.3-RT-N-E-B1 checked: k_eff 3.0 kN/mm, locked-in 16 kN service, ULS +15 kN with wind and 37 kN thermal-leading; K1, K2, K5, K7 checked - **K7 (and K5, whose north edge is now 0.1 m) built as B2**. C7 B2 plate extents to the slab face (100 outboard), one standard length 800; C8 drawing BOM weight quoted (25.4 t at closing sign-off, X1); C10 purlin cleat check (10.4 kN per cleat in zone F, 0.66) and panel fastener schedule from the supplier; C11 RT-JOG corrected (82.6 kN rod, 0.25); C13 K21 pattern fixed on site by the scan; C14 superseded figures removed. Worst base at Rev 3/4b: K25 0.83 (superseded by bases Rev 5). |
| **Bases Rev 5 / brief Rev 4** | Client decisions: no through-bolts, every base anchored from above; slab 300 mm. The 13 former B2 bases and the 6 lightly loaded edge bases become type **E: 4 M16 resin anchors 70 x 280 concentric in the column core, h_ef 550 (300 slab + 250 into the column head, rebar scan)**, designed as a lap with the column bars (N_Rd 257 kN, K19 0.28); the inboard lever alternatives (a)/(c) fail on the slab cone (<= 107 kN in the 800 zone vs 100-182 kN) and are not used; no bay added (d). B1 interior with h_ef 250 in the 300 slab (98 kN, zone-limited). Shear keys unchanged. Variants: B1 interior, E edge, E corner, P = K21 (superseded by Rev 5a). |
| **Bases Rev 5a / V1-V6** | Column-head anchorage re-framed as a **post-installed rebar connection (EAD 330087, EN 1992-1-1 8.4/8.7)**: 4 x dia 16 B500 threaded-end bars at 70 x 240, embedded 300 (250 min) into the column head, top 300 mm debonded so the slab cone is never loaded; f_bd 2.7 MPa: 136 kN at the 250 mm minimum (K19 0.54, K23 0.46), lap l_0 240 <= 250, receiving corner bars 268 kN, existing links suffice; scan/drill procedure (face cover-meter + GPR, pilot drill, relocation +/-15 mm, 30 mm plate holes) and proof tests to >= 60 kN. **All 27 bases built as type E** (one base detail, 108 scanned holes; K21 = E + saddle), no slab-cone check and no solid-zone criterion anywhere; B1 interior kept in an appendix as the client's fewer-holes option. Worst base at Rev 5a: K23 0.80 (superseded). |
| **Rev 4 / load basis Rev 3** | Complete re-run with the Rev 3 basis (independent load critique): services 0.10, Q 0.40 (psi 0), no wall self-weight in G / G_min (wall mass kept in the seismic mass), gutter 0.10 in G_min; wind by direction q_p N 1.25 / E, W 1.05 / S 0.75 (v_b 27, z_e 9 m, terrain I / II / III), e = 18 m, flat-roof Table 7.2 zones F -1.8 / G -1.2 / H -0.7 / I -0.2 with the pressure case I +0.2 (c_pi -0.3, +0.5 q_p) on the far half, walls D +0.75 / E -0.40 x 0.85, roof-suction component 14.8 kN, no friction; bracing uplift net per braced line; temperature +/-30 K service, +45/-25 K erection; combinations EN 1990 6.10 (6.10a/b not used). Roof-level wind N 61.9 / S 62.5 / E 63.0 / W 63.5 kN char. (Rev 3: 85.6 / 148.5 / 72.4 / 73.6). **Two-mass seismic check done: S_a at roof level 0.66 g (E-W) / 0.66 g (N-S), F 137 / 137 kN at q 1.5 - seismic now governs every braced bay** (B3 67.3 vs wind 32.5 kN ULS). Sections kept (IPE 330 / IPE 270 / HEA 160: the critic's IPE 300 / IPE 240 / HEA 140 set passes at 0.82 / 0.69 / 0.79 but with no margin on the 9.8 m primary LTB and it would re-open the detailing for 2.3 t). Bases Rev 6: same detail. Comparison table rev4_vs_rev3.md. |
| **Rev 5 / bracing rationalised (brief Rev 6)** | Roof diaphragm reduced from 24 X panels to **13 panels in five strips** (north strip west/east with rods over two rafter cells and posts at the column lines, the jog panel, the west and east edge strips over two rafter bays); both south bands unbraced - the rafters carry the south-half inertia as N-S struts to the y 29.3 chord, R78 carries the north-strip reactions down to B7; purlins act as E-W struts (Z200 3.2 kN, 0.41), eave primaries as struts to B1-B4, primaries y 29.3 as chords (0.37); ST1 / ST2 kept (truss posts under the wall-column loads). Wall bays **10 -> 8**: B8 (interior hall X) and B10 (K19-K25) removed; B5 and B7 now carry their lines alone (49 / 67 kN), bases K15, K19, K20, K27 at <= 0.52. Rods 189 m (was 366), angles 8 bays; bracing steel 1.44 t (was 2.26); worst rod 0.41, worst diagonal 0.42, worst base K7 0.88 (unchanged, K7 seismic). Analysis and figure: bracing_rev5.md / bracing_rev5.png; bases Rev 7 (forces changed at 6 bases, detail unchanged). |
| **Rev 5a / review Z1-Z6** | Z1: strut forces stated as line forces - R78 63.1 kN (= B7; the 133.6 kN of Rev 5 was the sum of the strip end shears), R68 46.4, R82 29.6, R95 63.6; every strut / chord fin plate checked for axial + shear with web bearing (68.8 kN per M20 on the 6.6 mm web), bolt shear, plate net section and weld (table in bracing_rev5.md 2b): worst web bearing 0.56 (R78); the strip-chord rafters R68 / R72 / R90 / R95 get the 3 M20 plate (2 M20 would be 0.69 at R68), R78 keeps 2 M20 (0.55). Z3: EN 1998-1 4.4.3.2 drift added - west wall 12.7 vs 19.7 mm, x 77.8 line 10.5 vs 20.1 mm. Z4: actual strip end shears stated (RT-N-W 46.4 / 27.2, jog 6.3, RT-N-E 29.6 / 63.6 kN); rods still designed for the full line force. Z5: temporary plan bracing of the south bands in the erection sequence. Z6: Z200 i_min 20 mm stated, supplier to confirm. Z2: NE corner gussets for both rod sets (E_x + 0.3 E_y) noted for S04. 3-bolt fin plate now 210 deep (e1 35) to fit the IPE 270 web. |
| **Rev 6 / lighter sections (brief Rev 7)** | Client decision: **IPE 300 primaries and eave beams, IPE 240 rafters / edge beams / T2 / ST1-ST2, HEA 140 columns and WP1** - every check re-run on load basis Rev 3 with the Rev 5a bracing. Beams: worst K19-K20 0.94 (defl: 46.0 mm = L/213 under G + the flat-roof pressure case 0.5 q_p, now enveloped for the L/200 check; LTB gravity 0.82); 9.2 m rafters 0.69 (defl), fly braces unchanged (third points on spans > 6.6 m). Columns: worst K25 0.81 (ULS2W, biaxial with Table B.2 k_zy 0.99); the earlier "HEA 140 reaches 1.06" was K25 under load basis Rev 2 (q_p 1.30 in all directions, wall self-weight in G): re-run at those loads it gives 1.00-1.06, at basis Rev 3 (q_p,W 1.05, no wall weight) 0.81. Fin plates on the 6.2 mm IPE 240 web: bearing 64.6 kN per M20 (2 M20) / 54.8 kN (2 x 2 M20, the strip-chord splices R68 / R72 / R90 / R95 - no 3-bolt row fits the 190 mm clear web); worst R78 0.55. Cap plate 200 x 280 x 20 on HEA 140 (gauge 90 inside the 140 flange, pitch 200 outside the 133 depth: cantilever 0.11, T-stub on the IPE 300 flange 0.12). Roof strips with IPE 240 chords (RT-W chord 70.2 kN -> 0.46), thermal path k_eff 3.0 kN/mm, two-mass seismic W_a 312 kN -> F 133 / 134 kN (mass -7 %), drift 12.4 vs 19.7 mm. Levels: roof plane unchanged, primary top TOS + 0.05, **column top TOS - 0.27**, column length TOS - 0.32, **clear height 3.03 m under the cap nuts**. Bases Rev 8: reactions re-tabulated (uplift max 50.6 kN, worst base 0.83 K7), base plates **300 x 400 x 20** (plate T-stub <= 0.13, plate strip under the key moment <= 0.68 at K23 / K22 / K27 / K20), rebars / keys unchanged. Weight: BOM basis **22.1 t** (25.4 - sections - bracing - plates). No exception: no member needs the heavier section (P13 IPE 330 adopted at Rev 6a on the reviewer's recommendation). |
| **Rev 6a / review A1-A4** | **A1 (major, levels):** with the primary top at TOS + 0.05 the IPE 240 bottom flange sat 0.7-4.3 mm *below* the IPE 300 bottom-flange top face at every rafter joint (the "18 mm nominal" printed since Rev 3 was wrong - the reviewer's F11 sign error, withdrawn). New levels: **primary top TOS + 0.03** (19.3 mm clear top and bottom, 14.8 mm at the primary flange edge down-slope, no cope), primary underside = cap-plate top TOS - 0.27, **column top TOS - 0.29**, **column length L = TOS - 0.335 exactly** (grout 25 + plate 20 = 45 mm; no rounding - Rev 6 printed 0.32 for 0.315, A3); **clear height 3.03 m under the cap nuts, 3.07 m under the eave primary**, 3.09 m under the rafters at the north edge; fin plate 150 deep concentric with both webs (20 mm margin to the IPE 240 root fillets, 49 mm in the IPE 300); levels table in section 1, columns cut to the surveyed plate-top level (bases Rev 8 note). **A2:** the single 9.8 m primary **P13 (K19-K20) stays IPE 330** - 0.67 (defl: 33.0 mm = L/297 under G+W_D; LTB 0.67), no precamber; its cap tops and the K19 / K20 column tops are 30 mm lower (TOS - 0.30 / - 0.32, L = TOS - 0.365). The 9.2 m IPE 240 rafters get **no precamber** either (31.8 mm = L/289 under G+W_D, 25.0 under G + Q). **A4 / Y1, Y2 closed in the calculation:** E_x + 0.3 E_y now applied to the braced columns and bases (K23 0.72, K19 0.50); S_a set to the resonance bound 5.5 a_g S = 0.66 g (F 137 / 137 kN, +3 %). Open minors carried as a table in section 11. Weight BOM basis **22.2 t** (+0.07 t for P13 in IPE 330). |

## 1. Basis and assumptions

- Loads, combinations and resistances exactly per `../load_basis.md` **Rev 3** (materials and anchorage unchanged from Rev 2); geometry per `../../geometry.json`: 27 columns, L-shape less the notch, **north face at y 35.37 for x 67.89-81.79 and at 35.87 for x 81.79-95.69** (interior_walls_y 35.37, K6/K5/K7 on that wall; 0.5 m wall return at x 81.79), stair well x 77.89-81.79 / y 29.37-35.37 open to the north wall (no roof, no eave beam: a wall header carries wall and gutter stop-ends), elevator opening not roofed; roofed area 439.3 m2 from the grid.
- One roof plane at 6 % falling north, **TOS(y) = 3.33 + 0.06 (35.87 - y)** (TOS 3.33 at y 35.87, 3.36 at the west north edge 35.37, 4.55 at 15.57); level IPE 300 primaries with their top at **TOS + 0.03** (Rev 6a, review A1). **Levels table (Rev 6a)** - all relative to the roof plane TOS(y); columns are cut to the surveyed plate-top level:

| Element | Level | at y 35.77 (K1 / K2) | at y 35.17 (K6) | at y 21.76 (K19, P13) | at y 15.87 (K25) |
|---|---|---|---|---|---|
| Rafter (IPE 240) top / underside | TOS / TOS - 0.240 | 3.336 / 3.096 | 3.372 / 3.132 | 4.177 / 3.937 | 4.530 / 4.290 |
| Primary (IPE 300) top / underside | TOS + 0.030 / TOS - 0.270 (P13 IPE 330: TOS - 0.300) | 3.366 / 3.066 | 3.402 / 3.102 | 4.207 / 3.877 | 4.560 / 4.260 |
| Rafter to primary flange clearance | 19.3 mm top and bottom, 14.8 mm at the flange edge down-slope | | | | |
| Cap-plate top = primary underside | TOS - 0.270 (K19, K20: TOS - 0.300) | 3.066 | 3.102 | 3.877 | 4.260 |
| Column top = cap-plate underside (cap 20) | **TOS - 0.290** (K19, K20: TOS - 0.320) | 3.046 | 3.082 | 3.857 | 4.240 |
| Base plate top = column bottom (grout 25 + plate 20) | TOS - 0.335 | 3.001 | 3.037 | 3.812 | 4.195 |
| **Column length L (exact, no rounding)** | **TOS - 0.335** (K19, K20: TOS - 0.365) | 3.001 | 3.037 | 3.812 | 4.195 |
| Clear height under the cap nuts (20 below the cap) | TOS - 0.310 | **3.03** | 3.06 (west wall, y 35.27) | | |
| Clear height under the eave primary / under the rafters at the north edge | TOS - 0.270 / TOS - 0.240 | **3.07** / 3.09 | | | |

The fin plate (150 deep) is centred at TOS - 0.120, the mid-depth of both the rafter and the primary: 20 mm to the IPE 240 root fillets (clear web 190), 49 mm to the IPE 300 fillets (clear web 249); bolt rows at TOS - 0.085 / - 0.155. Cap plate 200 x 280 x 20 under the primary bottom flange; at K19 / K20 it sits 30 mm lower under the IPE 330.
- Statics: all beams are chains of simple spans (fin plates, cap plates), purlins simple spans between rafters, columns pinned-pinned; girts span horizontally between columns, so each column delivers wL/2 of its wall to the roof and wL/2 to its base. The take-down integrates the roof on a 0.1 m grid (exact tributary, openings excluded) -> rafters -> primaries -> columns. Section tables IPE 200-360 / HEA 140-200 in `calc/sections.py`.
- Wind post WP1 (HEA 140) at the notch corner, set 280 mm inboard of both faces at (77.61, 20.25): wall wind only, slotted top connection, no uplift, base 250 x 250 x 15 with one centred 60 mm key (11.4 kN shear, 0.31).
- Slab: **300 mm ribbed (brief Rev 4)**, solid zone >= 800 x 800 at every column head, C25 cracked, column cage 6 dia14 + dia6/200 - all to be confirmed by GPR/cores and a rebar scan before drilling (bases_C.md sections 5-6). No through-bolts: every base is anchored from above.

## 2. Loads and combinations (kN, m)

| Action | Value | Used for |
|---|---|---|
| Panel + purlins + services G | 0.12 + 0.05 + 0.10 = 0.27 kN/m2 + member self-weight; gutter 0.25 kN/m on the north eaves; **no wall self-weight** (brief Rev 5) | gravity |
| G_min (uplift) | 0.17 kN/m2 + member self-weight; gutter 0.10 kN/m | ULS-3 |
| Imposed cat. H Q | 0.40 kN/m2, psi_0 = psi_1 = psi_2 = 0 (never with wind); Q_k 1.0 kN point for the purlin / panel-supplier check | ULS-1, SLS |
| Wind q_p by direction | v_b 27 m/s, z_e = h = 9 m, c_s c_d 1.0: **N 1.25 (sea, terrain I), E / W 1.05 (II), S 0.75 (III) kN/m2** | all wind cases |
| Roof net uplift, c_pi +0.2, e = 18 m | flat roof, Table 7.2: F -1.8, G -1.2 (windward strip 1.8 m, F corners 4.5 m), H -0.7 (1.8-9 m), I -0.2 beyond: with the N-wind q_p 1.25: F -2.50, G -1.75, H -1.13, I -0.50 kN/m2; S wind x 0.6; gutter -0.50 kN/m | ULS-3, purlins, fly braces |
| Roof pressure case, c_pi -0.3 | zone I +0.2 -> +0.5 q_p = **+0.625 kN/m2 (N wind) on the roof beyond 9 m from the windward edge** (per-cell envelope over the four directions); 1.35 G + 1.5 x 0.625 = 1.71 kN/m2 governs the south half over 1.35 G + 1.5 Q = 1.37 | ULS-2 |
| Walls, net | D +1.05 (0.75 + 0.3); A -1.4 / B -1.0 / C -0.7 / E -0.6 (c_pi +0.2); x q_p of the direction -> up to 1.75 kN/m2 char. (N) | column bending and base shear |
| Global horizontal wind at roof level | 0.85 x (0.75 + 0.40) = 0.98 q_p on the projected wall area, half to the roof, plus the horizontal component of the net roof suction (14.8 kN, S wind), no friction: **N 61.9, S 62.5, E 63.0, W 63.5 kN** char. | bracing, diaphragm |
| Wall self-weight | 0.30 kN/m2 in the seismic mass only (brief Rev 5: not in G / G_min) | seismic |
| Temperature (C4, Rev 3) | +/-30 K in service, +45 / -25 K erection state; E-W north bay pair B2-B1 restrained through the roof trusses: k_eff 3.0 kN/mm x 3.6 / 5.4 mm = 16 / 24 kN char.; ULS +15 kN on B1/B2 with wind (psi_0 0.6), 37 kN thermal-leading without wind; south pair released by the weak-axis bending of R78 (0.3 kN/mm), N-S lines by the fin-plate clearances | B1/B2 bays, bases K1, K2, K5, K7 |
| Seismic (EN 1998-1, a_g 0.10 g - Libyan zonation for the Tripoli coastal zone (a_g,R 0.10 g, to be confirmed by the client's geotechnical / seismic statement, Y3), soil B S 1.2, DCL q 1.5 with a_g S = 0.12 g), **two-mass floor amplification (4.3.5.2)** | roof + wall mass W_a = 312 kN; roof steel on the braced bays T_a = 0.13 s (E-W, k 79 kN/mm) / 0.13 s (N-S); the existing building (mass 1 on its 27 columns and infill) T_1 scanned 0.15-0.35 s, worst at 0.15 s: S_a = a_g S [3 (1 + z/H)/(1 + (1 - T_a/T_1)^2) - 0.5] = **0.66 g E-W / 0.66 g N-S** at roof level (unamplified plateau 0.30 g); **bounded below by the resonance value 5.5 a_g S = 0.66 g (Rev 6a, Y2)**; design force with q 1.5: **F = 137 kN E-W / 137 kN N-S** (was 62.4 unamplified); E_x + 0.3 E_y on the columns and bases shared by an x-bay and a y-bay (Rev 6a, Y1), 5 % eccentricity, rigid/tributary envelope -> bay forces 67.3 kN (B3) / 63.1 kN (B8): **seismic governs every braced bay** (wind ULS max 32.5 kN); ULS-4 rows in the reaction table | ULS-4, bays, bases |

Combinations (EN 1990 6.10, the 6.10a/b option not used): ULS-1 1.35 G + 1.5 Q; ULS-2 1.35 G + 1.5 W (pressure, wall D/E with c_pi -0.3, roof zone I +0.5 q_p, bracing compression); ULS-3 1.0 G_min + 1.5 W (uplift, c_pi +0.2, four wind directions, bracing uplift net per braced line); ULS-4 1.0 G +/- 1.0 E (two-mass amplified); SLS G + Q (L/200, purlins L/150) and G + W (sway H/150).

## 3. Load take-down and bracing analysis results

**Take-down (`takedown.py`).** 11 N-S rafter lines (x = 68.0, 70.0, 72.1, 74.9, 77.8, 81.85, 84.5, 87.2, 89.9, 92.5, 95.5), rafter spans 2.7-9.2 m, purlin spans 2.05-3.1 m; the west-block rafters end at the north wall y 35.37 (0.10-0.20 m cantilevers carrying gutter G-W), the east ones at 35.87 (gutter G-E); nothing spans the stair well. Example column loads (characteristic, kN): K12 interior G 19.0, Q 16.7, W_N -39.6; K19 (braced, west wall) G 16.8, Q 12.7, W_S -19.9. Sum of column loads: G 258 (roof, steel and gutters; no wall weight), Q 176 (= 0.40 x 439.3), W_N -423, W_S -262 kN.

**Bracing (`bracing.py`).** Eight X-braced wall bays after Rev 5 (B1-B7, B9). The roof force of each windward face (and the roof-suction component at its centroid) is distributed to the bays twice: (a) rigid diaphragm, 3 DOF, bay stiffness k = E A cos^2(alpha)/L_d of one L70x7 diagonal (15.6-24 kN/mm), centre of rigidity and torsion included; (b) flexible-diaphragm tributary to the bracing lines, then to the bays of a line by stiffness. **The envelope of (a) and (b) is used** (sum of bay forces 1.2-1.4 x the applied force). Wind from S, characteristic: rigid B5 23.4 / B10 22.0 / B7 23.1 / B8 26.1 / B6 28.3 / B9 25.4 kN, tributary 15.2 / 14.3 / 33.9 / 38.2 / 24.9 / 22.3 kN; wind from E: rigid B1 20.0 / B2 19.5 / B3 17.5 / B4 15.2, tributary 1.3 / 26.1 / 35.5 / 9.8 kN.

Bay forces at ULS (1.5 W), tension-only diagonal T = H L_d/w, column axial N = H h/w, base shear H at the tension-diagonal base (windward column) concurrent with that column's wall shear:

| Bay | Columns | w m | h m | Governing case | H_Ed kN (ULS, governing) | H seismic (1.0 E, amplified) | T_Ed diag. kN | N col. +/- kN | T_Rd L70x7 kN | Util. angle | Util. bolts | Sway SLS mm | h/150 mm |
|---|---|---|---|---|---|---|---|---|---|---|---|---|---|
| B1 | K1-K2 | 5.29 | 3.22 | seismic | 39.8 | 39.8 | 46.5 | 24.2 | 189.3 | 0.25 | 0.38 | 2.6 | 21.5 |
| B2 | K5-K7 | 5.70 | 3.25 | seismic | 61.2 | 61.2 | 70.4 | 34.9 | 189.3 | 0.37 | 0.57 | 2.7 | 21.7 |
| B3 | K22-K23 | 6.61 | 4.16 | seismic | 67.3 | 67.3 | 79.6 | 42.4 | 189.3 | 0.42 | 0.64 | 3.2 | 27.8 |
| B4 | K25-K26 | 4.00 | 4.42 | seismic | 29.8 | 29.8 | 44.4 | 32.9 | 189.3 | 0.23 | 0.36 | 2.7 | 29.4 |
| B5 | K15-K19 | 4.61 | 3.92 | seismic | 46.4 | 46.4 | 60.9 | 39.5 | 189.3 | 0.32 | 0.49 | 3.0 | 26.2 |
| B6 | K14-K18 | 4.81 | 3.76 | seismic | 33.6 | 33.6 | 42.6 | 26.2 | 189.3 | 0.22 | 0.34 | 2.7 | 25.0 |
| B7 | K20-K27 | 5.89 | 4.24 | seismic | 63.1 | 63.1 | 77.7 | 45.4 | 189.3 | 0.41 | 0.63 | 3.7 | 28.3 |
| B9 | K18-K23 | 4.39 | 4.03 | seismic | 30.0 | 30.0 | 40.7 | 27.6 | 189.3 | 0.22 | 0.33 | 2.7 | 26.9 |

## 4. Member checks (EN 1993-1-1)

Checks per span: bending 6.2.5 (M_pl,Rd IPE 240 = 101 kNm, IPE 300 = 173 kNm), shear 6.2.6 (V_Ed < 0.5 V_pl everywhere), LTB 6.3.2 with M_cr from I_w, I_t and C1 per restraint segment (C1 = 1.88 - 1.40 psi + 0.52 psi^2 for linear segments, 1.0 when the maximum lies inside the segment), curve b, deflection <= L/200 by numerical double integration for G + Q and (Rev 6) G + the flat-roof pressure case W_D = 0.5 q_p, whichever is larger.

Restraints: rafters - top flange held by purlins @ 1.5 m (gravity, chi_LT = 1.0); under uplift the free bottom flange is held by **fly braces to the purlins at mid-span for spans <= 6.6 m and at the third points for 7.5 and 9.2 m spans** (segments 2.2-3.25 m). Primaries - both flanges restrained at every rafter fin plate (plate over the full rafter web depth) and at the columns, segments <= 4.1 m; the K19-K20 LTB check is governed by its 2.8 m middle segment (C1 1.07).

| Member (span) | Section | L m | M_Ed kNm | V_Ed kN | 6.2.5 M | 6.2.6 V | 6.3.2 LTB gravity | 6.3.2 LTB uplift | SLS L/200 | Util. | Governs | Verdict |
|---|---|---|---|---|---|---|---|---|---|---|---|---|
| R92/P_K22K23-K13 | IPE 240 | 9.20 | 42.6 | 18.7 | 0.42 | 0.06 | 0.45 | 0.55 | 0.69 | **0.69** | defl | OK |
| P_K19K20/K19-K20 | IPE 330 | 9.79 | 120.5 | 41.2 | 0.54 | 0.08 | 0.67 | 0.48 | 0.67 | **0.67** | defl | OK |
| R85/P_K21K22-P_K11K12 | IPE 240 | 9.20 | 40.5 | 17.7 | 0.4 | 0.06 | 0.42 | 0.3 | 0.66 | **0.66** | defl | OK |
| R87/P_K21K22-K12 | IPE 240 | 9.20 | 40.9 | 17.9 | 0.41 | 0.06 | 0.43 | 0.34 | 0.66 | **0.66** | defl | OK |
| R90/P_K22K23-P_K12K13 | IPE 240 | 9.20 | 40.2 | 17.6 | 0.4 | 0.06 | 0.42 | 0.44 | 0.65 | **0.65** | defl | OK |
| R75/P_K19K20-P_K9K10 | IPE 240 | 7.51 | 28.1 | 15.2 | 0.28 | 0.05 | 0.3 | 0.27 | 0.37 | **0.37** | defl | OK |
| R72/P_K19K20-K9 | IPE 240 | 7.51 | 24.4 | 13.2 | 0.24 | 0.04 | 0.26 | 0.24 | 0.32 | **0.32** | defl | OK |
| P_K21K22/K21-K22 | IPE 300 | 7.03 | 44.8 | 22.7 | 0.26 | 0.06 | 0.3 | 0.16 | 0.26 | **0.3** | LTBg | OK |
| R92/K13-K2 | IPE 240 | 6.50 | 25.2 | 21.3 | 0.25 | 0.07 | 0.2 | 0.29 | 0.22 | **0.29** | LTBu | OK |
| R70/P_K19K20-P_K8K9 | IPE 240 | 7.56 | 21.3 | 11.5 | 0.21 | 0.04 | 0.22 | 0.25 | 0.28 | **0.28** | defl | OK |
| P_K22K23/K22-K23 | IPE 300 | 6.67 | 42.9 | 25.9 | 0.25 | 0.06 | 0.28 | 0.22 | 0.21 | **0.28** | LTBg | OK |
| R85/P_K11K12-P_K3K1 | IPE 240 | 6.40 | 22.8 | 19.5 | 0.23 | 0.06 | 0.19 | 0.26 | 0.2 | **0.26** | LTBu | OK |
| R87/K12-K1 | IPE 240 | 6.50 | 22.4 | 17.4 | 0.22 | 0.06 | 0.19 | 0.26 | 0.21 | **0.26** | LTBu | OK |
| R90/P_K12K13-P_K1K2 | IPE 240 | 6.50 | 21.7 | 16.6 | 0.22 | 0.05 | 0.19 | 0.25 | 0.21 | **0.25** | LTBu | OK |
| P_K9K10/K9-K10 | IPE 300 | 5.69 | 38.1 | 14.4 | 0.22 | 0.04 | 0.24 | 0.2 | 0.15 | **0.24** | LTBg | OK |
| P_K11K12/K11-K12 | IPE 300 | 5.34 | 39.5 | 15.7 | 0.23 | 0.04 | 0.24 | 0.19 | 0.14 | **0.24** | LTBg | OK |
| P_K12K13/K12-K13 | IPE 300 | 5.29 | 38.9 | 15.9 | 0.23 | 0.04 | 0.24 | 0.18 | 0.14 | **0.24** | LTBg | OK |
| R95/K14-K4 | IPE 240 | 6.40 | 19.8 | 12.8 | 0.2 | 0.04 | 0.12 | 0.23 | 0.14 | **0.23** | LTBu | OK |
| R75/P_K9K10-P_K5K7 | IPE 240 | 5.93 | 19.5 | 15.7 | 0.19 | 0.05 | 0.17 | 0.22 | 0.17 | **0.22** | LTBu | OK |
| R72/K9-K5 | IPE 240 | 6.00 | 18.0 | 15.9 | 0.18 | 0.05 | 0.15 | 0.21 | 0.15 | **0.21** | LTBu | OK |
| R75/K24-P_K19K20 | IPE 240 | 5.79 | 17.2 | 11.9 | 0.17 | 0.04 | 0.18 | 0.17 | 0.18 | **0.18** | LTBg | OK |
| P_K3K1/K3-K1 | IPE 300 | 5.34 | 29.3 | 11.6 | 0.17 | 0.03 | 0.12 | 0.18 | 0.07 | **0.18** | LTBu | OK |
| R70/P_K25K26-P_K19K20 | IPE 240 | 5.89 | 14.6 | 10.1 | 0.14 | 0.03 | 0.14 | 0.17 | 0.14 | **0.17** | LTBu | OK |
| R70/P_K8K9-P_K6K5 | IPE 240 | 5.90 | 15.2 | 14.3 | 0.15 | 0.05 | 0.13 | 0.17 | 0.13 | **0.17** | LTBu | OK |
| R72/K26-P_K19K20 | IPE 240 | 5.89 | 15.5 | 10.5 | 0.15 | 0.03 | 0.16 | 0.13 | 0.16 | **0.16** | defl | OK |
| R78/K27-K20 | IPE 240 | 5.89 | 13.1 | 10.1 | 0.13 | 0.03 | 0.13 | 0.15 | 0.14 | **0.15** | LTBu | OK |
| P_K5K7/K5-K7 | IPE 300 | 5.69 | 24.7 | 9.4 | 0.14 | 0.02 | 0.12 | 0.15 | 0.08 | **0.15** | LTBu | OK |
| ST1 | IPE 240 | 5.65 | 0 |  |  |  | 0.15 |  |  | **0.15** | 6.3.1 | OK |
| R68/K25-K19 | IPE 240 | 5.89 | 12.3 | 8.6 | 0.12 | 0.03 | 0.08 | 0.14 | 0.09 | **0.14** | LTBu | OK |
| R68/K8-K6 | IPE 240 | 5.80 | 12.0 | 8.5 | 0.12 | 0.03 | 0.07 | 0.14 | 0.07 | **0.14** | LTBu | OK |
| R78/K16-K10 | IPE 240 | 4.81 | 13.2 | 11.4 | 0.13 | 0.04 | 0.14 | 0.12 | 0.11 | **0.14** | LTBg | OK |
| R82/K17-K11 | IPE 240 | 4.81 | 13.0 | 11.1 | 0.13 | 0.04 | 0.14 | 0.13 | 0.11 | **0.14** | LTBg | OK |
| R82/K11-K3 | IPE 240 | 6.40 | 12.4 | 9.0 | 0.12 | 0.03 | 0.13 | 0.11 | 0.14 | **0.14** | defl | OK |
| P_K1K2/K1-K2 | IPE 300 | 5.29 | 23.5 | 9.7 | 0.14 | 0.02 | 0.11 | 0.14 | 0.07 | **0.14** | LTBu | OK |
| R78/K10-K7 | IPE 240 | 5.90 | 11.3 | 8.4 | 0.11 | 0.03 | 0.12 | 0.1 | 0.12 | **0.12** | defl | OK |
| P_K8K9/K8-K9 | IPE 300 | 4.10 | 20.7 | 10.7 | 0.12 | 0.03 | 0.12 | 0.12 | 0.06 | **0.12** | LTBg | OK |
| R95/K23-K18 | IPE 240 | 4.39 | 9.9 | 9.1 | 0.1 | 0.03 | 0.07 | 0.1 | 0.05 | **0.1** | LTBu | OK |
| P_K6K5/K6-K5 | IPE 300 | 4.10 | 16.2 | 8.3 | 0.09 | 0.02 | 0.06 | 0.1 | 0.03 | **0.1** | LTBu | OK |
| 15 further spans (eave beams, trimmers, short edge-beam spans, ST2) | IPE 300 / IPE 240 | 2.7-5.9 | <= 15 | <= 11 | | | | | | <= 0.10 | - | OK |

Governing members (Rev 6a sections): primary **P13 K19-K20 (9.79 m, IPE 330)** at 0.67 (defl: 33.0 mm = L/297 under G+W_D; LTB gravity 0.67 with C1 per rafter segment, M_Ed 120.5 kNm); 9.2 m rafters (IPE 240) at 0.69 (defl; M 0.42, LTB uplift 0.55 with two fly braces at the third points; deflection 31.8 mm = L/289 under G+W_D); posts ST1 / ST2 0.15 / 0.07. **Sections adopted: IPE 300 / IPE 240 / HEA 140, with the single 9.8 m primary P13 (K19-K20) kept as IPE 330 on the reviewer's recommendation (Rev 6a, A2: as IPE 300 it was at 0.94 with 46 mm = L/213 under the pressure case and would have needed a 15 mm precamber; as IPE 330 0.67, no precamber, +0.07 t over IPE 300, one extra mark).** No precamber for the 9.2 m rafters either: 25.0 mm under G + Q (L/367) and 31.8 mm = L/289 under the rare pressure case are inside the L/200 basis. Sections to be re-checked if v_b is confirmed above 27 m/s.

Diaphragm struts and chords (Rev 5, seismic forces): rafters as roof-truss posts and as N-S struts carrying the unbraced south bands' inertia to the y 29.3 chord (7.8 kN, 0.48 with bending); R78 as the N-S strut from the north strips to B7 (63.1 kN = the x 77.8 line force, 0.25); rafter chords R68 / R72 / R90 / R95 of the edge strips (72.2 kN, 0.47); primaries y 29.3 as chords (33.8 kN, 0.37); eave primaries as E-W struts into B1-B4 (68.7 kN, 0.23); purlin lines as E-W struts (3.2 kN in a Z200x2.0, i_min 20 mm assumed / supplier to confirm, with its gravity bending, 0.41); posts ST1 (N 24.2 kN vs 160) and ST2 (19.5 vs 283) kept. Line forces (Rev 5a): R68 46.4 kN into B5, R78 63.1 kN into B7, R82 29.6 kN, R95 63.6 kN into B6 + B9; the strut / chord forces pass through the rafter fin plates (section 5). Seismic drift (EN 1998-1 4.4.3.2, q d_e, nu 0.5, limit 0.005 h): west wall 12.7 vs 19.7 mm, east wall 9.8 vs 19.0 mm, x 77.8 line 10.5 vs 20.1 mm - passes. Erection: the unbraced south bands need temporary plan bracing until the panels are fixed (bracing_rev5.md 2d).

**Columns** (6.3.1 pinned-pinned, L_cr = L both axes, HEA 140 curve b/c; 6.3.3 Annex B method 2, Table B.2 for the LTB-susceptible member, C_m = C_mLT = 0.95 for the wall-wind UDL, web normal to the wall it supports, corners biaxial). N_b,Rd = 310 kN (L 4.20 m) to 475 kN (L 3.00 m).

| Column | Section | L m | N_Ed,c kN (case) | N_Ed,t kN (case) | M_y,Ed / M_z,Ed kNm | k_zy (B.2) | 6.3.1 N/N_b,Rd | 6.3.3 | Util. | Verdict |
|---|---|---|---|---|---|---|---|---|---|---|
| K25 | HEA 140 | 4.20 | 40.4 (ULS4-x) | 27.8 (ULS4+x) | 11.8 / 10.2 | 0.99 | 0.13 | 0.8 | **0.8** | OK |
| K23 | HEA 140 | 3.94 | 54.8 (ULS4+x) | 45.1 (ULS3E) | 15.0 / 7.4 | 0.99 | 0.16 | 0.79 | **0.79** | OK |
| K22 | HEA 140 | 3.94 | 70.3 (ULS2E) | 27.4 (ULS3W) | 21.0 / 0.0 | 0.97 | 0.21 | 0.75 | **0.75** | OK |
| K19 | HEA 140 | 3.81 | 76.0 (ULS2N) | 50.2 (ULS3W) | 17.9 / 0.0 | 0.97 | 0.21 | 0.67 | **0.67** | OK |
| K27 | HEA 140 | 4.20 | 50.4 (ULS4-y) | 40.9 (ULS4+y) | 8.5 / 7.5 | 1.00 | 0.16 | 0.59 | **0.59** | OK |
| K21 | HEA 140 | 3.94 | 27.0 (ULS2N) | 9.3 (ULS3S) | 16.8 / 0.0 | 0.99 | 0.08 | 0.52 | **0.52** | OK |
| K6 | HEA 140 | 3.04 | 12.4 (ULS2N) | 15.5 (ULS3N) | 10.9 / 4.9 | 1.00 | 0.03 | 0.5 | **0.5** | OK |
| K18 | HEA 140 | 3.68 | 34.2 (ULS4+y) | 14.8 (ULS3E) | 14.6 / 0.0 | 0.99 | 0.09 | 0.45 | **0.45** | OK |
| K24 | HEA 140 | 4.19 | 16.5 (ULS2N) | 10.5 (ULS3E) | 14.0 / 0.0 | 0.99 | 0.05 | 0.43 | **0.43** | OK |
| K26 | HEA 140 | 4.20 | 42.2 (ULS4+x) | 26.0 (ULS4-x) | 12.0 / 0.0 | 0.98 | 0.14 | 0.43 | **0.43** | OK |
| other 17 columns | HEA 140 | 3.00-3.81 | <= 84 | <= 45 | <= 15 | 0.97-1.00 | <= 0.24 | <= 0.42 | <= 0.42 | OK |

Max column utilisation 0.80 (K25, SW corner, ULS2W: N 13.4 kN, M_y 11.8 / M_z 10.2 kNm biaxial from the S and W walls, k_zy 0.99); the braced-bay columns with the seismic axial (ULS4, M = 0) are at <= 0.3. Wind post WP1 HEA 140, L 4.24 m: M_y 9.1, M_z 9.5 kNm -> 0.65. **Reconciliation of the earlier "HEA 140 reaches 1.06 at K25"**: that figure was produced at load basis Rev 2 (q_p 1.30 in every direction, global wall factor 1.3, wall self-weight in G) for K25 under ULS2 S/W with Table B.2; the same script at those loads gives 1.00-1.06 today, and at load basis Rev 3 (q_p,S 0.75 / q_p,W 1.05, wall factor 0.98, no wall weight) 0.80 - the difference is the wind, not the method. HEA 140 adopted.

**Purlins Z200x2.0 @ 1.5 m** (basis: M_Rd 12.5 kNm single span, 16 sleeved; I = 3.9e6 mm4): worst gravity M_Ed = 3.0 kNm; worst uplift M_Ed = **6.3 kNm** on the 3.07 m corner spans (x 92.5-95.5, y 35.6, zone F, N wind, w = -5.4 kN/m), 0.50 of the single-span gravity value; the 1.0 kN maintenance point load gives 0.9 kNm and the panel supplier's walkability statement is required (crawl boards otherwise). Purlin cleats (C10): zone-F end reaction 10.4 kN per cleat -> 2 M12 8.8 in tension 0.11, cleat plate 120 x 10 bending 0.66; the panel fastener schedule in zones F/G comes from the panel supplier. Because the free-flange uplift capacity of a Z200x2.0 is typically 55-70 % of the gravity value, **a mid-span anti-sag row is specified on every span and the supplier's uplift capacity (>= 9 kNm single span with one anti-sag row, or sleeved) is required before order** (open item 3). Deflection G + Q on 4.07 m: 4.4 mm < L/150 = 27.1 mm. Girts (wall net 2.15 kN/m2, zone A 2.73 within 2.4 m of a corner): 1.5 m rows single-span for bays <= 5.3 m (<= 11.3 kNm); 1.2 m rows sleeved on K5-K7, K25-K19, K8-K6 (<= 14.2 kNm); 1.0 m rows sleeved on K21-K22, K22-K23, K14-K4 (<= 14.9 kNm, 0.93).

## 5. Connections (EN 1993-1-8)

- **Rafter to primary fin plate**, one type: 100 x 150 x 10 S275, 2 M20 8.8 (pitch 70, e1 = e2 = 40), bolt line 50 mm from the primary web, 2 x 6 mm fillets. Max rafter end reaction 21.3 kN (envelope ULS-1 / reversed ULS-3 incl. the gutter): bolt shear incl. eccentricity 0.20, bearing on the 6.2 mm IPE 240 rafter web **0.29** (governs), plate bearing 0.18, plate shear 0.10, plate bending 0.10, weld 0.11, web block tearing 0.20. 9.2 m rafters: the same 2 M20 plate (0.19 at 14.4 kN; the IPE 240 web has 190 mm clear, so no 3-bolt row). No copes. **Strut / chord splices (Rev 5a, Z1)**: the same plates carry the diaphragm axial force (E_y + 0.3 E_x / E_x + 0.3 E_y) with the gravity shear - web bearing governs (64.6 kN per M20 on the 6.2 mm web, one row): R78 into B7 63.1 kN with 2 M20 (64.6 kN per bolt on the 6.2 mm web) -> 0.56; R68 (strut into B5 + RT-W chord) 86.1 kN, R95 (strut into B6 + B9 + RT-E chord) 77.5 kN, R72 / R90 (chords) with a **2 x 2 M20 plate 160 x 150 x 10** (two rows p2 60, 54.8 kN per bolt) -> 0.56 max; R82 29.6 kN 2 M20 -> 0.30; the force passes through the IPE 300 primary web (7.1 mm) plate-weld-web-weld-plate; full table in bracing_rev5.md 2b. T1/T2, ST1/ST2 and the notch eave beam use the same detail.
- **Primary to column cap plate** 200 x 280 x 20 on the HEA 140 (a = 6 all round, 792 mm perimeter), 4 M20 through the IPE 300 bottom flange (gauge 90 = 30 mm edge on the 150 flange and inside the 140 column flange; **pitch 200** so the nuts clear the passing rafter flange and the bolt rows sit 33 mm outside the 133 mm column depth: cap-plate cantilever 0.11; primaries bolted before the rafters; at K19 / K20 the cap sits under the IPE 330 of P13, 30 mm lower). Tension = roof uplift 44.6 kN (K12, ULS-3N; the bracing vertical component enters below the cap through the gusset): bolt tension 0.08, shear + tension interaction with the chord/strut force 72.2 kN 0.25, IPE 300 flange T-stub 0.12, cap plate 0.05, weld 0.08. Chord continuity across a column (<= 61 kN): 10 mm tie plate between the primary bottom flanges on the lines y 29.3 and y 20.1.
- **Bracing gussets**: 10 mm plates welded to the column web and base plate; each L70x7 with 2 M20 (e1 40, p1 110, e2 30): angle net section 189 kN, bolt shear 188 kN, gusset bearing 2 x 124 kN; max T_Ed 77.7 kN (B7, Rev 5) -> 0.42 angle; bolts 2 x 124 kN bearing.
- **Roof bracing** M24 rods 8.8 (F_t,Rd 203 kN) with turnbuckles to 8 mm gussets shop-welded to the primary webs and bolted (2 M16) to the rafter webs at the bottom flange level (no site welding, C9; rod hole in the rafter web shown on D5); on the east and west edge trusses the rods span two rafter bays and pass the intermediate rafter (R92 / R70) through a bolted web clip; sag ties to the purlins at the crossing and at 3 m centres.
- Trimmer T2 (y 24.09) IPE 240 between the rafters x 77.8 / 81.85 carries only the 150 mm upstand (0.3 kN/m, M_Ed 1.8 kNm); upstand framing 100 x 50 x 3 cold-formed C on the trimmers and along the rafters beside the openings, cricket on the south side of the stair well; the well's north edge is the wall itself (header with gutter stop-ends), T1 deleted.

## 6. Bases and anchors, Rev 6 (= Rev 5a detail re-run with load basis Rev 3 and the amplified seismic case) - full note in `bases_C.md`

**One base detail at all 27 columns (type E; K21 = E + saddle):** plate **300 x 400 x 20** (Rev 6: 20 mm; plate T-stub <= 0.13, plate strip under the key moment <= 0.72; key-pair plates per base, 20 mm, no stiffeners) on 25 +/- 5 mm grout, columns cut to the surveyed plate-top level; **4 dia 16 B500 post-installed rebars with M16 threaded ends (EAD 330087 injection system) at 70 x 240 concentric in the column core** (240 along the concrete column's long axis, 26 mm clear to the corner dia14 bars), drilled 20 mm through the 300 mm slab and **300 mm into the column head (250 mm minimum), the top 300 mm debonded by a sleeve and the column part only injected**, so no slab cone is ever loaded. Capacity to EN 1992-1-1 8.4: f_bd = 2.7 MPa (C25, good bond), **4 x 33.9 = 136 kN at 250 mm** (163 kN at 300), steel 4 x 87 = 350 kN, 1:1 lap with the corner dia14 bars (268 kN receiving; l_0 = max(1.5 l_b,rqd, 15 d) = 240 <= 250; d < 20, existing dia6/200 links suffice, splitting by the cover rules). Tension (250 mm minimum embedment, 136 kN): worst K19 50.2 kN -> 0.37; K19 0.37, K23 0.33, K12 0.33; shear as Rev 4b/5 (Key A under the column at interior bases, Key A + Key B at K3, K4, K6, K8, K14, inboard key pairs at K1, K2, K5, K7, K10, K15, K18, K19, K20, K22, K23, K25, K27; rigid-post key moments): the E-W bay bases K5, K7, K22, K23 now take the amplified seismic bay shear (64-71 kN): worst key 0.88 (K7), K23 0.53, K22 0.52; plates <= 0.10; WP1 0.31. Key pairs and plate sizes are not simplified: they are dictated by the parallel-edge condition at Key A (18.5 kN at c1 55), not by the force level, and the seismic E-W shears exceed a single key's edge value; a single key everywhere is therefore not possible, and one plate size (the 550 x 800 key-pair plate at all 27 bases) would only add steel at the 13 Key A bases. Worst base **K7: 0.88 (E key pair bearing, ULS4-x)**; all 27 bases <= 1.0.

Seismic-governed bases: K5, K7, K22, K23 (E-W bays B2, B3) and the N-S bay bases K10, K16, K14, K18, K23, K19, K25 with 1.0 G +/- 1.0 E net per line (reactions_C.csv rows ULS4). Site procedure (V3/V4): cover-meter scan of the column faces from below (+/-3-5 mm) projected to the slab top plus GPR from above, 10 mm pilot drill with feed monitoring, relocation within +/-15 mm on steel contact, plate holes 30 mm oversize with 10 mm plate washers (or match-drilled), proof tests of 3 bars to >= 60 kN with displacement <= 1 mm; **108 scanned and drilled holes (27 x 4)** plus 37 key pockets set by the same scan. No solid-zone criterion for the anchorage; the slab must be solid and 300 mm under the plates and around the key pockets (GPR at all heads). Appendix of bases_C.md: the 7 interior columns as B1 (4 M20 h_ef 250 in the slab, 800 x 800 solid zone verified by GPR, K12 0.69) as the client's fewer-holes option (-28 holes).

## 7. Deflections and sway

- Roof members SLS G + Q: worst primary K19-K20 36 mm = L/271 (limit 49 mm); 9.2 m rafters 22-24 mm = L/390; 7.5 m rafters L/700-820; purlins L/640.
- Braced-bay sway under SLS wind (diagonal elongation + 2 mm bolt-slip allowance): 2.8-3.9 mm vs h/150 = 20-28 mm. Column bending under wall wind (K22, 9.8 kN/m on 3.91 m) 8.5 mm = h/460.
- **Roof diaphragm drift** at the mid-length of the east / west walls (truss deflection by virtual work over the M24 rods, SLS, plus bay sway): **10.3 / 13.2 mm** vs h/150 = 26-28 mm (0.40).

## 8. Bracing

Vertical bays (X, one L70x7 per diagonal, tension-only; **every bay is governed by the amplified seismic case 1.0 E at q 1.5, table below**), **final list for the client after Rev 5 - these bays must stay door-free, none is inside the hall**: E-W **B1 K1-K2** (north wall, 5.3 m), **B2 K5-K7** (north wall, 5.7 m), **B3 K22-K23** (notch south wall, 6.6 m), **B4 K25-K26** (south wall, 4.0 m); N-S **B5 K15-K19** (west wall, 4.6 m), **B6 K14-K18** and **B9 K18-K23** (east wall, 4.8 + 4.4 m), **B7 K20-K27** (notch west wall / shaft west line, 5.9 m). Removed at Rev 5: B8 (K10-K16, the interior X) and B10 (K19-K25) - reasons per bay in bracing_rev5.md. Max diagonal utilisation 0.42 (B3, seismic), gusset bolts 0.64. Reason for the layout: at every braced-bay base the bay shear enters the concrete along the column's long axis or towards the slab interior, never towards a free edge < 0.25 m (the Rev 5a keys stay); K18 (B6 + B9) carries no net bracing uplift. Alternates if a bay is not door-free: B1 -> K3-K1, B3 -> K21-K22 (K21 base then needs a supplier-verified edge detail), B5 -> K19-K25, B7 -> none on that line (K10-K16 would put the X back into the hall).

Roof-plane bracing (Rev 5): M24 rods in **13 X panels in five strips** - north strip west (2 panels over two rafter cells, chords y 29.3 / 35.2, posts R68, R72, R78), north strip east (3 panels, posts R82, R87, R92, R95), the jog panel past the stair well (chords y 24.5 / 29.3), the west strip (R68 / R72, 4 panels with posts at the primaries and ST2) and the east strip (R90 / R95 over two rafter bays, 3 panels with posts at the primaries and ST1). The south bands are unbraced: the rafters carry their inertia as N-S struts to the y 29.3 chord, and R78 carries the east reaction of the north strip west and the jog-panel shear (63.1 kN) down to B7. Strip analysis, strut/chord checks and the before/after table: bracing_rev5.md.

| Roof truss | Wind | Span m | Depth m | Panels | Shear V kN | Diagonal T kN (M24, 203) | Chord kN | Post kN | Util. rod | Truss defl. ULS mm |
|---|---|---|---|---|---|---|---|---|---|---|
| RT-N-W (N band west, chords y 29.3 / 35.2) | N-S | 9.8 | 5.9 | 2 | 63.1 | 44.6 | 26.2 | 63.1 | 0.22 | 5.4 |
| RT-N-E (N band east, chords y 29.3 / 35.7) | N-S | 13.7 | 6.4 | 3 | 63.1 | 54.3 | 33.8 | 63.1 | 0.27 | 7.5 |
| RT-JOG (jog panel x 77.8-81.9 / y 24.5-29.3, carries the RT-N-E west reaction to B7 via R78) | N-S | 4.1 | 4.8 | 1 | 63.1 | 82.6 | 13.3 | 63.1 | 0.41 | 9.2 |
| RT-W (west edge, chords R68 / R72 (rods over two bays)) | E-W | 19.4 | 4.1 | 4 | 61.2 | 74.5 | 72.2 | 61.2 | 0.37 | 14.3 |
| RT-E (east edge, chords R90 / R95 (rods over two bays)) | E-W | 15.6 | 5.7 | 3 | 67.3 | 61.3 | 46.6 | 67.3 | 0.30 | 9.9 |

## 9. Reactions at the column bases (kN, ULS envelope with concurrent values; reactions_C.csv gives every column and case: ULS-1, ULS-2/3 for N, S, E, W wind, ULS-4 +/-x, +/-y, SLS, with N, V_x, V_y, near-edge flags and base utilisation)

| Col | Type | Bays | Near edges | Keys | N_c max kN (case) | N_t max kN (case) | V max kN (case) | N_c SLS | N_t SLS | Base governs | Util. | Min. zone |
|---|---|---|---|---|---|---|---|---|---|---|---|---|
| K1 | E | B1 | +y | A-pair | 48.7 (ULS2E) | 37.6 (ULS3N) | 41.7 (ULS4+x) | 18.4 | 19.5 | plate strip at key moment | **0.43** | head scanned; slab solid at keys |
| K2 | E | B1 | +y | A-pair | 44.2 (ULS2W) | 38.6 (ULS3E) | 41.7 (ULS4-x) | 14.7 | 21.3 | plate strip at key moment | **0.43** | head scanned; slab solid at keys |
| K3 | E | - | +y | A | 17.4 (ULS2N) | 20.6 (ULS3N) | 14.1 (ULS2N) | 11.2 | 10.4 | Key B outward +y | **0.37** | head scanned; slab solid at keys |
| K4 | E | - | +x,+y | A | 10.4 (ULS2N) | 13.3 (ULS3E) | 14.3 (ULS2N) | 6.6 | 6.9 | Key B outward +x | **0.36** | head scanned; slab solid at keys |
| K5 | E | B2 | +y | A-pair | 47.6 (ULS2E) | 41.7 (ULS3W) | 63.0 (ULS4+x) | 16.2 | 22.9 | plate strip at key moment | **0.65** | head scanned; slab solid at keys |
| K6 | E | - | -x,+y | A | 12.4 (ULS2N) | 15.5 (ULS3N) | 15.7 (ULS2N) | 8.0 | 7.9 | Key B outward -x | **0.39** | head scanned; slab solid at keys |
| K7 | E | B2 | +x,+y | A-pair | 43.5 (ULS4+x) | 27.4 (ULS4-x) | 63.0 (ULS4-x) | 13.7 | 12.6 | E key pair bearing | **0.88** | head scanned; slab solid at keys |
| K8 | E | - | -x | A | 19.3 (ULS2N) | 18.6 (ULS3W) | 14.0 (ULS2N) | 11.9 | 9.2 | Key B outward -x | **0.37** | head scanned; slab solid at keys |
| K9 | E | - | - | A | 48.4 (ULS2N) | 38.4 (ULS3N) | 0.0 (ULS1) | 29.0 | 18.1 | E rebar bond in the column head, embed 250 min | **0.28** | head scanned; slab solid at keys |
| K10 | E | - | +y | A-pair | 36.4 (ULS2N) | 26.1 (ULS3N) | 0.0 (ULS1) | 22.4 | 11.3 | E rebar bond in the column head, embed 250 min | **0.19** | head scanned; slab solid at keys |
| K11 | E | - | +y | A | 38.0 (ULS2N) | 26.2 (ULS3N) | 0.0 (ULS1) | 23.3 | 11.0 | E rebar bond in the column head, embed 250 min | **0.19** | head scanned; slab solid at keys |
| K12 | E | - | - | A | 60.4 (ULS2N) | 44.6 (ULS3N) | 0.0 (ULS1) | 35.6 | 20.6 | E rebar bond in the column head, embed 250 min | **0.33** | head scanned; slab solid at keys |
| K13 | E | - | - | A | 47.6 (ULS2N) | 38.7 (ULS3E) | 0.0 (ULS1) | 28.1 | 18.6 | E rebar bond in the column head, embed 250 min | **0.28** | head scanned; slab solid at keys |
| K14 | E | B6 | +x | A | 33.0 (ULS4+y) | 27.8 (ULS3N) | 35.0 (ULS4-y) | 12.8 | 16.0 | Key A parallel to edge +x | **0.57** | head scanned; slab solid at keys |
| K15 | E | B5 | -x | A-pair | 44.3 (ULS4+y) | 36.3 (ULS4-y) | 48.3 (ULS4-y) | 17.7 | 15.9 | plate strip at key moment | **0.50** | head scanned; slab solid at keys |
| K16 | E | - | - | A | 19.5 (ULS2N) | 5.0 (ULS3N) | 0.0 (ULS1) | 11.6 | 0.2 | E rebar bond in the column head, embed 250 min | **0.04** | head scanned; slab solid at keys |
| K17 | E | - | - | A | 20.8 (ULS2N) | 5.0 (ULS3S) | 0.0 (ULS1) | 12.4 | -0.0 | E rebar bond in the column head, embed 250 min | **0.04** | head scanned; slab solid at keys |
| K18 | E | B6,B9 | +x | A-pair | 34.2 (ULS4+y) | 14.8 (ULS3E) | 36.2 (ULS4+y) | 7.4 | 7.9 | plate strip at key moment | **0.37** | head scanned; slab solid at keys |
| K19 | E | B5 | -x | A-pair | 76.0 (ULS2N) | 50.2 (ULS3W) | 48.3 (ULS4+y) | 29.6 | 25.8 | plate strip at key moment | **0.50** | head scanned; slab solid at keys |
| K20 | E | B7 | +x | A-pair | 84.2 (ULS2S) | 43.2 (ULS3N) | 63.8 (ULS4-y) | 29.4 | 21.0 | plate strip at key moment | **0.66** | head scanned; slab solid at keys |
| K21 | P | - | +y,-y | saddle | 27.0 (ULS2N) | 9.3 (ULS3S) | 17.1 (ULS2E) | 15.9 | 1.9 | saddle plates | **0.21** | head scanned; slab solid at keys |
| K22 | E | B3 | -y | A-pair | 70.3 (ULS2E) | 27.4 (ULS3W) | 69.0 (ULS4+x) | 28.0 | 11.0 | plate strip at key moment | **0.71** | head scanned; slab solid at keys |
| K23 | E | B3,B9 | +x,-y | A-pair | 54.8 (ULS4+x) | 45.1 (ULS3E) | 70.2 (ULS4-x) | 12.7 | 26.7 | plate strip at key moment | **0.72** | head scanned; slab solid at keys |
| K24 | E | - | - | A | 16.5 (ULS2N) | 10.5 (ULS3E) | 13.4 (ULS2E) | 9.5 | 4.4 | Key A towards edge -y | **0.23** | head scanned; slab solid at keys |
| K25 | E | B4 | -x | A-pair | 40.4 (ULS4-x) | 27.8 (ULS4+x) | 31.9 (ULS4+x) | 11.3 | 15.9 | E key pair bearing | **0.38** | head scanned; slab solid at keys |
| K26 | E | B4 | - | A | 42.2 (ULS4+x) | 26.0 (ULS4-x) | 31.9 (ULS4-x) | 11.5 | 14.0 | Key A SHS bearing | **0.38** | head scanned; slab solid at keys |
| K27 | E | B7 | +x | A-pair | 50.4 (ULS4-y) | 40.9 (ULS4+y) | 63.8 (ULS4+y) | 24.0 | 23.1 | plate strip at key moment | **0.66** | head scanned; slab solid at keys |
| WP1 (offset 280 inboard) | post | - | +x,-y | B centred | 1.7 (self weight) | 0 | 11.4 (ULS2 E / S) | - | - | key edge breakout c1 250 | 0.27 | - |

## 10. Weight and section list

| Item | Section | Length m | Weight t |
|---|---|---|---|
| Rafters / edge beams / trimmers / posts ST1-ST2 | IPE 240 | 208.2 | 6.39 |
| Primaries / eave beams | IPE 300 | 92.5 | 3.97 |
| Columns (27) + wind post WP1 | HEA 140 | 99.9 | 2.47 |
| Plates, stiffeners, keys, bolts (BOM take-off) | S275 / S355 keys | - | 3.27 |
| **Hot-rolled total** | | | **16.1** |
| Wall bracing, 10 bays x 2 diagonals | L 70x7 | 103.8 | 0.77 |
| Roof bracing, 13 panels x 2 diagonals | M24 rods 8.8 | 188.6 | 0.67 |
| Purlins 300 m + girts 271 m (BOM lengths) | Z 200x2.0 S350GD | 571 | 3.37 |
| Calculation take-off | | | 20.9 |
| **BOM total (S06, for cost)** | | | **22.2 t** (46 kg/m2 of footprint 486 m2, 51 kg/m2 of roofed 439 m2) |

Sections (Rev 6a): **IPE 300** (E-W primaries and eave beams on the column rows, 92.5 m incl. **P13 K19-K20 in IPE 330**, 3.97 t), **IPE 240** (rafters, edge beams, trimmer T2, truss posts ST1/ST2, 208 m, 6.39 t), **HEA 140** (27 columns, WP1, 2.47 t), plus L70x7 wall bracing, M24 rod roof bracing, Z200x2.0 purlins/girts. **Weight: about 22.2 t on the BOM basis** = 25.4 t (S06 Rev 4b) less the section change, less the Rev 5 bracing saving of about 0.82 t, less 0.13 t of base plates (20 mm) (rods 189 m instead of 366, eight bays instead of ten, 44 gussets fewer; detailing to update S06); the calculation take-off above gives 20.9 t with the BOM's plates (3.4 t) and purlin/girt length (571 m), the balance being the sill rail, well header and the BOM's cut-length and connection allowances. Cost basis (Rev 6): about 22.2 t fabricated and erected at the indicative MENA rate of the final critique (about 2,040 $/t): about 45,271 $.

## 11. Open items / risks

1. **Slab verification** (bases_C.md sections 5-6): face cover-meter scan of every column head (6 dia14, links, cover) and GPR from above (slab solid and 300 mm under the plates and pockets), 3-6 cores for the concrete grade, the 70 x 240 pattern set on site (+/-15 mm), proof tests of 3 bars to >= 60 kN, an EAD 330087 injection system; K21 pier faces accessible for the saddle. A head that cannot be drilled falls back to the appendix B1 detail with its solid-zone condition.
2. Wind: v_b 27 m/s and the terrain sectors (N I, E/W II, S III) to be confirmed with the Libyan National Meteorological Centre and on the map (+/-15 deg sectors); 25 m/s would lower every wind figure by 14 %; the bays and bases are seismic-governed, so wind changes affect members and uplift only.
3. Purlin uplift capacity (>= 9 kNm single span with one anti-sag row) and the sleeved girt capacities to be confirmed with the supplier before order.
4. BoardX product data (0.30 kN/m2, girt rows per section 4) and its drift limit (h/150 assumed; diaphragm drift 10 mm, bay sway 4 mm).
5. Seismic: the two-mass check assumes T_1 of the existing building between 0.15 and 0.35 s (the worst, 0.15 s, is used); a measured period (ambient vibration test) could reduce S_a from 0.66 g towards 0.30 g; the design bay forces are on the envelope and the diagonals are at <= 0.42.
6. Existing structure (C5): the roof adds about 258 kN of characteristic gravity load (no wall weight; + 116 kN if the BoardX walls are counted), 61.9 kN of characteristic roof-level wind (N-S, worst direction) and **137 kN E-W / 137 kN N-S of design seismic force at roof level (two-mass, q 1.5)** into the 27 pinned 20 x 40 concrete columns and their foundations; as-builts, a one-page adequacy statement of the existing columns/foundations, a roof survey (screed thickness = datum for the 3.02 m and the base seating) and the slab-top datum on S00 are required before cores.
7. Client confirmations: door-free bays B1-B7 and B9 (section 8; no interior bay after Rev 5), rafter R82 over the shaft east wall line (x 81.85 vs shaft face 81.99).
8. **Open minors from the reviews (carried until closed; A4):**

| ID | Item | Owner | Status (Rev 6a) |
|---|---|---|---|
| Y1 | E_x +/- 0.3 E_y on the columns and bases shared by an x-bay and a y-bay (K23, K18, K19) | designer | **closed** - applied in the ULS-4 cases (K23 base 0.72, K19 0.50) |
| Y2 | T_1 scan misses the resonance: S_a 0.66 g, not 0.648 | designer | **closed** - S_a bounded by 5.5 a_g S = 0.66 g, F 137 / 137 kN |
| Y3 | DCL with a_g S 0.12 g: cite the zonation; reconcile the HEA 140 text (0.79 vs 1.06) | designer / client | text closed (section 2 and 3); zonation reference to be confirmed by the client's seismic statement |
| Y5 | South-sector terrain III to be confirmed on the map | designer / client | open - no governing change (S wind is the lowest) |
| Y6 | Existing structure receives 137 / 137 kN design seismic at roof level | designer -> structural engineer of record | closed in the C5 statement (item 6); adequacy check by others open |
| Z2 | NE corner gussets K2 / K4 / K13 / K14 for both rod sets (E_x + 0.3 E_y), rod crossings and the R92 clip | detailing (S04) | open - forces given in bracing_rev5.md 2b |
| Z3 | EN 1998-1 4.4.3.2 drift check | designer | **closed** (Rev 5a; 12.7 vs 19.7 mm) |
| Z4 | Strip end-shear split stated | designer | **closed** (Rev 5a, bracing_rev5.md 2a) |
| Z5 | Temporary plan bracing of the unbraced south bands during erection | detailing (S05 sequence) / erector | open - requirement stated in bracing_rev5.md 2d |
| Z6 | Z200x2.0 A and i_min (20 mm assumed) | purlin supplier | open - supplier data before order |
| A1 | Rafter / primary flange clash at TOS + 0.05 | designer -> detailing (S01-S03 levels and schedule) | **closed** in the calculation (this revision); drawings to be re-issued |
| A2 | P13 as IPE 330 rather than precambered | designer | **closed** (adopted) |
| A3 | Column length rounding | designer | **closed** (L = TOS - 0.335 exact) |

9. Thermal: no slotted holes; the locked-in E-W force is designed for (section 2); the panel supplier confirms the sandwich-panel fastening for +/-30 K. Client option (bases_C.md appendix): the 7 interior columns as B1 slab anchors, saving 28 column-head holes against a GPR-verified 800 x 800 solid zone.

Files: `design_report_C.md` (this, Rev 3), `bases_C.md` (Rev 5a), `members_C.csv` (99 rows), `reactions_C.csv` (595 rows, with base type, keys, psi_ec, max anchor/bolt and minimum zone per case), `framing_C.png`, `calc/` (sections.py, model.py, loads.py, statics.py, takedown.py, bracing.py, members.py, connections.py, bases_note.py, run_all.py, write_report.py, report_text.md, summary_C.json).
