loka92/test1strsteel/roof/design/C/calc/report_text.md

# Alternative C - post-and-beam braced frame: design report, Rev 6a (load basis Rev 3, sections IPE 300/240 + P13 IPE 330, HEA 140, bases Rev 8, levels per review A1)

System C: E-W {SP} primaries on the column rows, N-S {SR} rafters, pinned {SC} columns (Rev 6: the lighter section set adopted by the client, brief Rev 7), vertical X bracing for all lateral load, roof-plane X bracing as the diaphragm. All numbers come from `calc/` (`python3 run_all.py; python3 write_report.py`); ULS design values unless stated. Companion note: `bases_C.md` (bases and anchors, self-contained).

## 0. Change log Rev 1 -> Rev 2 (basis Rev 2 and independent review, every finding addressed)

| Ref | Change |
|---|---|
| Basis: wind zones | e = 20 m: F/G strip 2.0 m deep, F corners 5.0 m along the eave; zone sets kept as the envelope (theta = 180 values for both N and S wind, F5). Roof uplift total W_S -669 kN incl. gutter (Rev 1 -614). |
| Basis / F4 | Horizontal component of the roof suction added: {roofc} kN char. northward for S wind (resultant at x {roofx}, y {roofy}), also as an N-S load under E/W wind; S-wind roof-level force 108.7 -> **{wS} kN** (+36 %); no friction term. Bracing, braced columns and bases re-run. |
| Basis: anchorage / F1, F2, F3 | New base for all 27 columns: 4 M20 through the slab into the column head (h_ef 300, 80 x 280 in the core), bond + cracked cone in the slab, **grouted shear key** for all shear (no anchor shear, so the cracked-edge question F2 disappears), plate 25 mm. Wall shear wL/2 is at the column base in every case (F1); base struts deleted, every base carries its full concurrent H + V_wall (F3). |
| Bracing layout | K17-K21 (Rev 1 B8) dropped - K21 is a 200 mm pier between the notch edge and the shaft opening. N-S bracing now on three lines with two bays in series each: B5 K15-K19 + **B10 K19-K25**, B7 K20-K27 + **B8 K10-K16**, B6 K14-K18 + **B9 K18-K23**; E-W B1-B4 unchanged. 10 bays; no braced-bay base has its bay shear towards a free edge < 0.25 m. |
| F6 | Gutter/fascia 0.25 kN/m (G) and -0.50 kN/m (W) on the north eave in the take-down (rafter cantilevers, eave beams, fin plates). West-block north edge kept at y 35.87 (wall line); drainage's gutter line y 35.37 to be coordinated (open item 6). |
| F7 | Column interaction with k_zy from Annex B Table B.2 (0.97-1.00): K25 {K25c}, K23 {K23c}, K22 {K22c}. HEA 160 confirmed. |
| F8 | Purlin uplift re-run with the 2.0 m / 5.0 m zones: corner spans (3.07 m, zone F) 8.3 kNm, stair strip 4.07 m 8.6 kNm; mid-span anti-sag row on all spans; supplier uplift capacity before order (open item 3). |
| F9 | Seismic: ULS-4 rows (1.0 G +/- 1.0 E, both directions, 5 % eccentricity) added to reactions_C.csv; floor amplification through the existing building stated as open item 5. |
| F10 | Roof diaphragm re-modelled with the rods in the drawn cells; east/west edge trusses now use diagonals over two rafter bays (depth 5.65 / 4.10 m) and posts ST1 (y 24.46, R90-R95) / ST2 (y 26.37, R68-R72) at the wall-column lines; M24 rods throughout; truss deflection by virtual work: east wall drift {driftE} mm, west {driftW} mm (SLS, incl. bay sway) vs h/150 = 26-28 mm. |
| F11 | (superseded by Rev 3: TOS(35.87) = 3.33, 3.02 m clear under the cap nuts) TOS(35.87) = 3.30 m, primary top at TOS + 0.05: clear height 3.03 m, rafter/primary bottom-flange clearance 18 mm nominal, 13 mm at the down-slope flange tip. T1 at y 35.44 and T2 at y 24.09 (half a flange inside the opening edges). R82 at x 81.85 over the shaft east wall line: client to confirm (open item 7). |
| F12 | Cap-plate bolts at pitch 200 (plate 200 x 280 x 20); primaries bolted before the rafters are landed. |
| F13 | reactions_C.csv now one row per column and load case (594 rows: ULS-1, ULS-2/3 x 4 wind directions, ULS-4 x 4, SLS) with concurrent N, V_x, V_y, near-edge flags and the base utilisation; WP1 included; envelope in section 9. |
| F14 | Angle bearing with e2 = 30 mm (124 kN per bolt): B8 gusset 0.57. |
| F15 | Base struts and wall-rail anchorage deleted; the lateral system is 10 wall bays + {n_panels} rod panels + 2 posts. |
| **Bases Rev 3 / R1-R7** | Section 6 and `bases_C.md` re-issued after the base re-review: R1 column-cage resistance withdrawn, outward shear at the 14 near-edge bases (Rev 3 count) through a second key 180 mm inboard (c1 = 250, plain-concrete edge breakout {VRd_B} kN) and a saddle at the K21 pier, WP1 moved 280 mm inboard; R2 key moments V x 85 mm carried into the anchor group (psi_ec,N) and the max anchor; R3 minimum solid zone per base, coring acceptance criterion (>= 750 x 750 x 250, C25, edge beams) and a through-bolt fallback pre-designed at 9 bases; R4 anchors h_ef 200 and pockets 200 deep in the slab only, no drilling into the column heads (permitted by the client, shown unnecessary and risky); R5 f_y 335 for the bar, Key A edge check to 0.6 m; R6/R7 tables with spacing orientation, key moment, max anchor, minimum zone. Worst base at Rev 3: K19 0.91 (superseded by Rev 4). |
| **Bases Rev 4 / S1-S4** | Real slab edges modelled (column flush with the face: outboard anchor row 60 mm from the edge; shaft and stair openings as free edges): concentric cone 50 / 38 kN at edge / corner heads, Key A parallel-to-edge 18-24 kN. Base type chosen per column: **B1** concentric anchors at {nb1} bases ({b1list}), **B2** through-bolts + inboard key pair (corrected lever statics T = N_t b/(b-c), stiffened 30 mm plate) at {nb2} bases ({b2list}), **P** pier anchors + saddle at K21. One-sided coring criterion at edge heads. |
| **Bases Rev 4a / T1-T6** | Per-base B2 plate lengths and coring zones for the shifted layouts (K23 1000 x 550 plate, zone -1100..+250 along; K25 550 x 900 and K27 600 x 900, zone to +1000; standard 800 x 550, zone +/- 700); coring criterion made identical to the cone extents used (B1 edge heads: inboard >= 340, +/- 400 along); ONE key-moment model - rigid post in the grouted pocket - for every key (psi_ec dropped; K7 now 0.85 on the Key A parallel-edge check, cone 0.52; K14 0.49); 8 % cone reduction at the diagonal opening corners K3, K16, K17; under-slab plate 25 mm, class-3 stiffeners, skewed levers at K23/K25/K27 and the T/C couple for the slab designer stated; bond quoted with the real extents. Worst base at Rev 4a: K7 0.85 (superseded). |
| **Design Rev 3 / final critique C1-C14** | C1 north-face jog modelled: wall and roof edge at y 35.37 for x 67.89-81.79 (K6, K5, K7 on that wall), 35.87 east of x 81.79; the stair well reaches the north face, so no roof, no T1 and no eave beam across it (wall header only); 0.5 m wall return at x 81.79 on brackets from K3; rafters R68-R78 end at 35.37 (0.10-0.20 m cantilevers); gutters G-W at 35.37 and G-E at 35.87 with stop ends; roofed area {roof_area} m2; loads, bracing (S-wind roof force {wS} kN), reactions, CSVs and figure re-run. C3 plane raised 30 mm, TOS(35.87) = 3.33: **3.02 m clear under the cap-plate nuts at K1/K2**, one figure; C2 column length TOS - 0.35 (B2 0.355). C4 slotted fin plates deleted; conditioned-hall range +/-20 K, erection state +/-30 K; E-W chord path B2-RT-N-W-y 29.3-RT-N-E-B1 checked: k_eff {k_eff} kN/mm, locked-in {F_s} kN service, ULS +{F_uw} kN with wind and {F_ue} kN thermal-leading; K1, K2, K5, K7 checked - **K7 (and K5, whose north edge is now 0.1 m) built as B2**. C7 B2 plate extents to the slab face (100 outboard), one standard length 800; C8 drawing BOM weight quoted (25.4 t at closing sign-off, X1); C10 purlin cleat check ({cleatR} kN per cleat in zone F, 0.66) and panel fastener schedule from the supplier; C11 RT-JOG corrected ({jogT} kN rod, 0.25); C13 K21 pattern fixed on site by the scan; C14 superseded figures removed. Worst base at Rev 3/4b: K25 0.83 (superseded by bases Rev 5). |
| **Bases Rev 5 / brief Rev 4** | Client decisions: no through-bolts, every base anchored from above; slab 300 mm. The 13 former B2 bases and the 6 lightly loaded edge bases become type **E: 4 M16 resin anchors 70 x 280 concentric in the column core, h_ef 550 (300 slab + 250 into the column head, rebar scan)**, designed as a lap with the column bars (N_Rd 257 kN, K19 0.28); the inboard lever alternatives (a)/(c) fail on the slab cone (<= 107 kN in the 800 zone vs 100-182 kN) and are not used; no bay added (d). B1 interior with h_ef 250 in the 300 slab (98 kN, zone-limited). Shear keys unchanged. Variants: B1 interior, E edge, E corner, P = K21 (superseded by Rev 5a). |
| **Bases Rev 5a / V1-V6** | Column-head anchorage re-framed as a **post-installed rebar connection (EAD 330087, EN 1992-1-1 8.4/8.7)**: 4 x dia 16 B500 threaded-end bars at 70 x 240, embedded 300 (250 min) into the column head, top 300 mm debonded so the slab cone is never loaded; f_bd 2.7 MPa: 136 kN at the 250 mm minimum (K19 0.54, K23 0.46), lap l_0 240 <= 250, receiving corner bars 268 kN, existing links suffice; scan/drill procedure (face cover-meter + GPR, pilot drill, relocation +/-15 mm, 30 mm plate holes) and proof tests to >= 60 kN. **All 27 bases built as type E** (one base detail, 108 scanned holes; K21 = E + saddle), no slab-cone check and no solid-zone criterion anywhere; B1 interior kept in an appendix as the client's fewer-holes option. Worst base at Rev 5a: K23 0.80 (superseded). |
| **Rev 4 / load basis Rev 3** | Complete re-run with the Rev 3 basis (independent load critique): services 0.10, Q 0.40 (psi 0), no wall self-weight in G / G_min (wall mass kept in the seismic mass), gutter 0.10 in G_min; wind by direction q_p N 1.25 / E, W 1.05 / S 0.75 (v_b 27, z_e 9 m, terrain I / II / III), e = 18 m, flat-roof Table 7.2 zones F -1.8 / G -1.2 / H -0.7 / I -0.2 with the pressure case I +0.2 (c_pi -0.3, +0.5 q_p) on the far half, walls D +0.75 / E -0.40 x 0.85, roof-suction component {roofc} kN, no friction; bracing uplift net per braced line; temperature +/-30 K service, +45/-25 K erection; combinations EN 1990 6.10 (6.10a/b not used). Roof-level wind N {wN} / S {wS} / E {wE} / W {wW} kN char. (Rev 3: 85.6 / 148.5 / 72.4 / 73.6). **Two-mass seismic check done: S_a at roof level {SaX} g (E-W) / {SaY} g (N-S), F {FbX} / {FbY} kN at q 1.5 - seismic now governs every braced bay** (B3 {B3s} vs wind {B3w} kN ULS). Sections kept (IPE 330 / IPE 270 / HEA 160: the critic's IPE 300 / IPE 240 / HEA 140 set passes at 0.82 / 0.69 / 0.79 but with no margin on the 9.8 m primary LTB and it would re-open the detailing for 2.3 t). Bases Rev 6: same detail. Comparison table rev4_vs_rev3.md. |
| **Rev 5 / bracing rationalised (brief Rev 6)** | Roof diaphragm reduced from 24 X panels to **{n_panels} panels in five strips** (north strip west/east with rods over two rafter cells and posts at the column lines, the jog panel, the west and east edge strips over two rafter bays); both south bands unbraced - the rafters carry the south-half inertia as N-S struts to the y 29.3 chord, R78 carries the north-strip reactions down to B7; purlins act as E-W struts (Z200 {Npurlin} kN, {upurlin}), eave primaries as struts to B1-B4, primaries y 29.3 as chords ({uchord}); ST1 / ST2 kept (truss posts under the wall-column loads). Wall bays **10 -> 8**: B8 (interior hall X) and B10 (K19-K25) removed; B5 and B7 now carry their lines alone (49 / 67 kN), bases K15, K19, K20, K27 at <= 0.52. Rods {Lrod} m (was 366), angles 8 bays; bracing steel {Wbr} t (was 2.26); worst rod {urod}, worst diagonal {udiag_max}, worst base {worst} {wb_u} (unchanged, K7 seismic). Analysis and figure: bracing_rev5.md / bracing_rev5.png; bases Rev 7 (forces changed at 6 bases, detail unchanged). |
| **Rev 5a / review Z1-Z6** | Z1: strut forces stated as line forces - R78 {NR78} kN (= B7; the 133.6 kN of Rev 5 was the sum of the strip end shears), R68 {NR68}, R82 {NR82}, R95 {NR95}; every strut / chord fin plate checked for axial + shear with web bearing (68.8 kN per M20 on the 6.6 mm web), bolt shear, plate net section and weld (table in bracing_rev5.md 2b): worst web bearing {ufin_max} ({ufin_mem}); the strip-chord rafters R68 / R72 / R90 / R95 get the 3 M20 plate (2 M20 would be 0.69 at R68), R78 keeps 2 M20 (0.55). Z3: EN 1998-1 4.4.3.2 drift added - west wall {drW} vs {drWl} mm, x 77.8 line {dr778} vs {dr778l} mm. Z4: actual strip end shears stated (RT-N-W {sNWa} / {sNWb}, jog {sJ}, RT-N-E {sNEa} / {sNEb} kN); rods still designed for the full line force. Z5: temporary plan bracing of the south bands in the erection sequence. Z6: Z200 i_min 20 mm stated, supplier to confirm. Z2: NE corner gussets for both rod sets (E_x + 0.3 E_y) noted for S04. 3-bolt fin plate now 210 deep (e1 35) to fit the IPE 270 web. |
| **Rev 6 / lighter sections (brief Rev 7)** | Client decision: **IPE 300 primaries and eave beams, IPE 240 rafters / edge beams / T2 / ST1-ST2, HEA 140 columns and WP1** - every check re-run on load basis Rev 3 with the Rev 5a bracing. Beams: worst K19-K20 0.94 (defl: 46.0 mm = L/213 under G + the flat-roof pressure case 0.5 q_p, now enveloped for the L/200 check; LTB gravity 0.82); 9.2 m rafters 0.69 (defl), fly braces unchanged (third points on spans > 6.6 m). Columns: worst K25 0.81 (ULS2W, biaxial with Table B.2 k_zy 0.99); the earlier "HEA 140 reaches 1.06" was K25 under load basis Rev 2 (q_p 1.30 in all directions, wall self-weight in G): re-run at those loads it gives 1.00-1.06, at basis Rev 3 (q_p,W 1.05, no wall weight) 0.81. Fin plates on the 6.2 mm IPE 240 web: bearing 64.6 kN per M20 (2 M20) / 54.8 kN (2 x 2 M20, the strip-chord splices R68 / R72 / R90 / R95 - no 3-bolt row fits the 190 mm clear web); worst R78 0.55. Cap plate 200 x 280 x 20 on HEA 140 (gauge 90 inside the 140 flange, pitch 200 outside the 133 depth: cantilever 0.11, T-stub on the IPE 300 flange 0.12). Roof strips with IPE 240 chords (RT-W chord 70.2 kN -> 0.46), thermal path k_eff 3.0 kN/mm, two-mass seismic W_a 312 kN -> F 133 / 134 kN (mass -7 %), drift 12.4 vs 19.7 mm. Levels: roof plane unchanged, primary top TOS + 0.05, **column top TOS - 0.27**, column length TOS - 0.32, **clear height {clN} m under the cap nuts**. Bases Rev 8: reactions re-tabulated (uplift max 50.6 kN, worst base 0.83 K7), base plates **300 x 400 x 20** (plate T-stub <= 0.13, plate strip under the key moment <= 0.68 at K23 / K22 / K27 / K20), rebars / keys unchanged. Weight: BOM basis **22.1 t** (25.4 - sections - bracing - plates). No exception: no member needs the heavier section (P13 IPE 330 adopted at Rev 6a on the reviewer's recommendation). |
| **Rev 6a / review A1-A4** | **A1 (major, levels):** with the primary top at TOS + 0.05 the IPE 240 bottom flange sat 0.7-4.3 mm *below* the IPE 300 bottom-flange top face at every rafter joint (the "18 mm nominal" printed since Rev 3 was wrong - the reviewer's F11 sign error, withdrawn). New levels: **primary top TOS + 0.03** ({flC} mm clear top and bottom, {flT} mm at the primary flange edge down-slope, no cope), primary underside = cap-plate top TOS - 0.27, **column top TOS - 0.29**, **column length L = TOS - 0.335 exactly** (grout 25 + plate 20 = 45 mm; no rounding - Rev 6 printed 0.32 for 0.315, A3); **clear height {clN} m under the cap nuts, {clP} m under the eave primary**, {clR} m under the rafters at the north edge; fin plate 150 deep concentric with both webs ({finR} mm margin to the IPE 240 root fillets, {finP} mm in the IPE 300); levels table in section 1, columns cut to the surveyed plate-top level (bases Rev 8 note). **A2:** the single 9.8 m primary **P13 (K19-K20) stays IPE 330** - {B19u} ({K19gov}: {K19d} mm = L/{K19L} under {K19dc}; LTB {K19ltb}), no precamber; its cap tops and the K19 / K20 column tops are 30 mm lower (TOS - 0.30 / - 0.32, L = TOS - 0.365). The 9.2 m IPE 240 rafters get **no precamber** either ({R92d} mm = L/{R92L} under {R92dc}, {R92dq} under G + Q). **A4 / Y1, Y2 closed in the calculation:** E_x + 0.3 E_y now applied to the braced columns and bases (K23 {K23u}, K19 {K19b}); S_a set to the resonance bound 5.5 a_g S = 0.66 g (F {FbX} / {FbY} kN, +3 %). Open minors carried as a table in section 11. Weight BOM basis **{Wbom6} t** (+{WP13} t for P13 in IPE 330). |

## 1. Basis and assumptions

- Loads, combinations and resistances exactly per `../load_basis.md` **Rev 3** (materials and anchorage unchanged from Rev 2); geometry per `../../geometry.json`: 27 columns, L-shape less the notch, **north face at y 35.37 for x 67.89-81.79 and at 35.87 for x 81.79-95.69** (interior_walls_y 35.37, K6/K5/K7 on that wall; 0.5 m wall return at x 81.79), stair well x 77.89-81.79 / y 29.37-35.37 open to the north wall (no roof, no eave beam: a wall header carries wall and gutter stop-ends), elevator opening not roofed; roofed area {roof_area} m2 from the grid.
- One roof plane at 6 % falling north, **TOS(y) = 3.33 + 0.06 (35.87 - y)** (TOS 3.33 at y 35.87, 3.36 at the west north edge 35.37, 4.55 at 15.57); level {SP} primaries with their top at **TOS + 0.03** (Rev 6a, review A1). **Levels table (Rev 6a)** - all relative to the roof plane TOS(y); columns are cut to the surveyed plate-top level:

| Element | Level | at y 35.77 (K1 / K2) | at y 35.17 (K6) | at y 21.76 (K19, P13) | at y 15.87 (K25) |
|---|---|---|---|---|---|
| Rafter ({SR}) top / underside | TOS / TOS - 0.240 | 3.336 / 3.096 | 3.372 / 3.132 | 4.177 / 3.937 | 4.530 / 4.290 |
| Primary ({SP}) top / underside | TOS + 0.030 / TOS - 0.270 (P13 IPE 330: TOS - 0.300) | 3.366 / 3.066 | 3.402 / 3.102 | 4.207 / 3.877 | 4.560 / 4.260 |
| Rafter to primary flange clearance | {flC} mm top and bottom, {flT} mm at the flange edge down-slope | | | | |
| Cap-plate top = primary underside | TOS - 0.270 (K19, K20: TOS - 0.300) | 3.066 | 3.102 | 3.877 | 4.260 |
| Column top = cap-plate underside (cap 20) | **TOS - 0.290** (K19, K20: TOS - 0.320) | 3.046 | 3.082 | 3.857 | 4.240 |
| Base plate top = column bottom (grout 25 + plate 20) | TOS - 0.335 | 3.001 | 3.037 | 3.812 | 4.195 |
| **Column length L (exact, no rounding)** | **TOS - 0.335** (K19, K20: TOS - 0.365) | {LK1} | {LK6} | {LcK19} | {LK25} |
| Clear height under the cap nuts (20 below the cap) | TOS - 0.310 | **{clN}** | {clW} (west wall, y 35.27) | | |
| Clear height under the eave primary / under the rafters at the north edge | TOS - 0.270 / TOS - 0.240 | **{clP}** / {clR} | | | |

The fin plate (150 deep) is centred at TOS - 0.120, the mid-depth of both the rafter and the primary: {finR} mm to the IPE 240 root fillets (clear web 190), {finP} mm to the IPE 300 fillets (clear web 249); bolt rows at TOS - 0.085 / - 0.155. Cap plate 200 x 280 x 20 under the primary bottom flange; at K19 / K20 it sits 30 mm lower under the IPE 330.
- Statics: all beams are chains of simple spans (fin plates, cap plates), purlins simple spans between rafters, columns pinned-pinned; girts span horizontally between columns, so each column delivers wL/2 of its wall to the roof and wL/2 to its base. The take-down integrates the roof on a 0.1 m grid (exact tributary, openings excluded) -> rafters -> primaries -> columns. Section tables IPE 200-360 / HEA 140-200 in `calc/sections.py`.
- Wind post WP1 ({SC}) at the notch corner, set 280 mm inboard of both faces at (77.61, 20.25): wall wind only, slotted top connection, no uplift, base 250 x 250 x 15 with one centred 60 mm key ({wpV} kN shear, 0.31).
- Slab: **300 mm ribbed (brief Rev 4)**, solid zone >= 800 x 800 at every column head, C25 cracked, column cage 6 dia14 + dia6/200 - all to be confirmed by GPR/cores and a rebar scan before drilling (bases_C.md sections 5-6). No through-bolts: every base is anchored from above.

## 2. Loads and combinations (kN, m)

| Action | Value | Used for |
|---|---|---|
| Panel + purlins + services G | 0.12 + 0.05 + 0.10 = 0.27 kN/m2 + member self-weight; gutter 0.25 kN/m on the north eaves; **no wall self-weight** (brief Rev 5) | gravity |
| G_min (uplift) | 0.17 kN/m2 + member self-weight; gutter 0.10 kN/m | ULS-3 |
| Imposed cat. H Q | 0.40 kN/m2, psi_0 = psi_1 = psi_2 = 0 (never with wind); Q_k 1.0 kN point for the purlin / panel-supplier check | ULS-1, SLS |
| Wind q_p by direction | v_b 27 m/s, z_e = h = 9 m, c_s c_d 1.0: **N 1.25 (sea, terrain I), E / W 1.05 (II), S 0.75 (III) kN/m2** | all wind cases |
| Roof net uplift, c_pi +0.2, e = 18 m | flat roof, Table 7.2: F -1.8, G -1.2 (windward strip 1.8 m, F corners 4.5 m), H -0.7 (1.8-9 m), I -0.2 beyond: with the N-wind q_p 1.25: F -2.50, G -1.75, H -1.13, I -0.50 kN/m2; S wind x 0.6; gutter -0.50 kN/m | ULS-3, purlins, fly braces |
| Roof pressure case, c_pi -0.3 | zone I +0.2 -> +0.5 q_p = **+0.625 kN/m2 (N wind) on the roof beyond 9 m from the windward edge** (per-cell envelope over the four directions); 1.35 G + 1.5 x 0.625 = 1.71 kN/m2 governs the south half over 1.35 G + 1.5 Q = 1.37 | ULS-2 |
| Walls, net | D +1.05 (0.75 + 0.3); A -1.4 / B -1.0 / C -0.7 / E -0.6 (c_pi +0.2); x q_p of the direction -> up to 1.75 kN/m2 char. (N) | column bending and base shear |
| Global horizontal wind at roof level | 0.85 x (0.75 + 0.40) = 0.98 q_p on the projected wall area, half to the roof, plus the horizontal component of the net roof suction ({roofc} kN, S wind), no friction: **N {wN}, S {wS}, E {wE}, W {wW} kN** char. | bracing, diaphragm |
| Wall self-weight | 0.30 kN/m2 in the seismic mass only (brief Rev 5: not in G / G_min) | seismic |
| Temperature (C4, Rev 3) | +/-30 K in service, +45 / -25 K erection state; E-W north bay pair B2-B1 restrained through the roof trusses: k_eff {k_eff} kN/mm x 3.6 / 5.4 mm = {F_s} / {F_e} kN char.; ULS +{F_uw} kN on B1/B2 with wind (psi_0 0.6), {F_ue} kN thermal-leading without wind; south pair released by the weak-axis bending of R78 (0.3 kN/mm), N-S lines by the fin-plate clearances | B1/B2 bays, bases K1, K2, K5, K7 |
| Seismic (EN 1998-1, a_g 0.10 g - Libyan zonation for the Tripoli coastal zone (a_g,R 0.10 g, to be confirmed by the client's geotechnical / seismic statement, Y3), soil B S 1.2, DCL q 1.5 with a_g S = 0.12 g), **two-mass floor amplification (4.3.5.2)** | roof + wall mass W_a = {seisW} kN; roof steel on the braced bays T_a = {TaX} s (E-W, k {kX} kN/mm) / {TaY} s (N-S); the existing building (mass 1 on its 27 columns and infill) T_1 scanned 0.15-0.35 s, worst at {T1X} s: S_a = a_g S [3 (1 + z/H)/(1 + (1 - T_a/T_1)^2) - 0.5] = **{SaX} g E-W / {SaY} g N-S** at roof level (unamplified plateau 0.30 g); **bounded below by the resonance value 5.5 a_g S = 0.66 g (Rev 6a, Y2)**; design force with q 1.5: **F = {FbX} kN E-W / {FbY} kN N-S** (was {Fb} unamplified); E_x + 0.3 E_y on the columns and bases shared by an x-bay and a y-bay (Rev 6a, Y1), 5 % eccentricity, rigid/tributary envelope -> bay forces {H4max} kN (B3) / {H4maxy} kN (B8): **seismic governs every braced bay** (wind ULS max {B3w} kN); ULS-4 rows in the reaction table | ULS-4, bays, bases |

Combinations (EN 1990 6.10, the 6.10a/b option not used): ULS-1 1.35 G + 1.5 Q; ULS-2 1.35 G + 1.5 W (pressure, wall D/E with c_pi -0.3, roof zone I +0.5 q_p, bracing compression); ULS-3 1.0 G_min + 1.5 W (uplift, c_pi +0.2, four wind directions, bracing uplift net per braced line); ULS-4 1.0 G +/- 1.0 E (two-mass amplified); SLS G + Q (L/200, purlins L/150) and G + W (sway H/150).

## 3. Load take-down and bracing analysis results

**Take-down (`takedown.py`).** 11 N-S rafter lines (x = 68.0, 70.0, 72.1, 74.9, 77.8, 81.85, 84.5, 87.2, 89.9, 92.5, 95.5), rafter spans 2.7-9.2 m, purlin spans 2.05-3.1 m; the west-block rafters end at the north wall y 35.37 (0.10-0.20 m cantilevers carrying gutter G-W), the east ones at 35.87 (gutter G-E); nothing spans the stair well. Example column loads (characteristic, kN): K12 interior G {K12[G]:.1f}, Q {K12[Q]:.1f}, W_N {K12[W_N]:.1f}; K19 (braced, west wall) G {K19[G]:.1f}, Q {K19[Q]:.1f}, W_S {K19[W_S]:.1f}. Sum of column loads: G {sumG} (roof, steel and gutters; no wall weight), Q {sumQ} (= 0.40 x {roof_area}), W_N {sumWN}, W_S {sumWS} kN.

**Bracing (`bracing.py`).** Eight X-braced wall bays after Rev 5 (B1-B7, B9). The roof force of each windward face (and the roof-suction component at its centroid) is distributed to the bays twice: (a) rigid diaphragm, 3 DOF, bay stiffness k = E A cos^2(alpha)/L_d of one L70x7 diagonal (15.6-24 kN/mm), centre of rigidity and torsion included; (b) flexible-diaphragm tributary to the bracing lines, then to the bays of a line by stiffness. **The envelope of (a) and (b) is used** (sum of bay forces 1.2-1.4 x the applied force). Wind from S, characteristic: rigid B5 23.4 / B10 22.0 / B7 23.1 / B8 26.1 / B6 28.3 / B9 25.4 kN, tributary 15.2 / 14.3 / 33.9 / 38.2 / 24.9 / 22.3 kN; wind from E: rigid B1 20.0 / B2 19.5 / B3 17.5 / B4 15.2, tributary 1.3 / 26.1 / 35.5 / 9.8 kN.

Bay forces at ULS (1.5 W), tension-only diagonal T = H L_d/w, column axial N = H h/w, base shear H at the tension-diagonal base (windward column) concurrent with that column's wall shear:

{bay_table}

## 4. Member checks (EN 1993-1-1)

Checks per span: bending 6.2.5 (M_pl,Rd {SR} = {MplR} kNm, {SP} = {MplP} kNm), shear 6.2.6 (V_Ed < 0.5 V_pl everywhere), LTB 6.3.2 with M_cr from I_w, I_t and C1 per restraint segment (C1 = 1.88 - 1.40 psi + 0.52 psi^2 for linear segments, 1.0 when the maximum lies inside the segment), curve b, deflection <= L/200 by numerical double integration for G + Q and (Rev 6) G + the flat-roof pressure case W_D = 0.5 q_p, whichever is larger.

Restraints: rafters - top flange held by purlins @ 1.5 m (gravity, chi_LT = 1.0); under uplift the free bottom flange is held by **fly braces to the purlins at mid-span for spans <= 6.6 m and at the third points for 7.5 and 9.2 m spans** (segments 2.2-3.25 m). Primaries - both flanges restrained at every rafter fin plate (plate over the full rafter web depth) and at the columns, segments <= 4.1 m; the K19-K20 LTB check is governed by its 2.8 m middle segment (C1 1.07).

{member_table}

Governing members (Rev 6a sections): primary **P13 K19-K20 (9.79 m, {P13sec})** at {B19u} ({K19gov}: {K19d} mm = L/{K19L} under {K19dc}; LTB gravity {K19ltb} with C1 per rafter segment, M_Ed {K19M} kNm); 9.2 m rafters ({SR}) at {R92u} ({R92gov}; M {R92M}, LTB uplift {R92ltb} with two fly braces at the third points; deflection {R92d} mm = L/{R92L} under {R92dc}); posts ST1 / ST2 {st1u} / {st2u}. **Sections adopted: {SP} / {SR} / {SC}, with the single 9.8 m primary P13 (K19-K20) kept as IPE 330 on the reviewer's recommendation (Rev 6a, A2: as IPE 300 it was at 0.94 with 46 mm = L/213 under the pressure case and would have needed a 15 mm precamber; as IPE 330 {B19u}, no precamber, +{WP13} t over IPE 300, one extra mark).** No precamber for the 9.2 m rafters either: {R92dq} mm under G + Q (L/{R92Lq}) and {R92d} mm = L/{R92L} under the rare pressure case are inside the L/200 basis. Sections to be re-checked if v_b is confirmed above 27 m/s.

Diaphragm struts and chords (Rev 5, seismic forces): rafters as roof-truss posts and as N-S struts carrying the unbraced south bands' inertia to the y 29.3 chord ({Nraftstrut} kN, {uraftstrut} with bending); R78 as the N-S strut from the north strips to B7 ({NR78} kN = the x 77.8 line force, {uR78}); rafter chords R68 / R72 / R90 / R95 of the edge strips ({Nchord} kN, {uchord_r}); primaries y 29.3 as chords ({Nchordp} kN, {uchord}); eave primaries as E-W struts into B1-B4 ({Neave} kN, {ueave}); purlin lines as E-W struts ({Npurlin} kN in a Z200x2.0, i_min 20 mm assumed / supplier to confirm, with its gravity bending, {upurlin}); posts ST1 (N {st1} kN vs {st1b}) and ST2 ({st2} vs {st2b}) kept. Line forces (Rev 5a): R68 {NR68} kN into B5, R78 {NR78} kN into B7, R82 {NR82} kN, R95 {NR95} kN into B6 + B9; the strut / chord forces pass through the rafter fin plates (section 5). Seismic drift (EN 1998-1 4.4.3.2, q d_e, nu 0.5, limit 0.005 h): west wall {drW} vs {drWl} mm, east wall {drE} vs {drEl} mm, x 77.8 line {dr778} vs {dr778l} mm - passes. Erection: the unbraced south bands need temporary plan bracing until the panels are fixed (bracing_rev5.md 2d).

**Columns** (6.3.1 pinned-pinned, L_cr = L both axes, {SC} curve b/c; 6.3.3 Annex B method 2, Table B.2 for the LTB-susceptible member, C_m = C_mLT = 0.95 for the wall-wind UDL, web normal to the wall it supports, corners biaxial). N_b,Rd = {NbMin} kN (L {LcMax} m) to {NbMax} kN (L {LcMin} m).

{column_table}

Max column utilisation {maxcol} (K25, SW corner, {K25case}: N {K25N} kN, M_y {K25My} / M_z {K25Mz} kNm biaxial from the S and W walls, k_zy {K25kzy}); the braced-bay columns with the seismic axial (ULS4, M = 0) are at <= 0.3. Wind post WP1 {SC}, L {wpL} m: M_y {wpMy}, M_z {wpMz} kNm -> {wpu}. **Reconciliation of the earlier "HEA 140 reaches 1.06 at K25"**: that figure was produced at load basis Rev 2 (q_p 1.30 in every direction, global wall factor 1.3, wall self-weight in G) for K25 under ULS2 S/W with Table B.2; the same script at those loads gives 1.00-1.06 today, and at load basis Rev 3 (q_p,S 0.75 / q_p,W 1.05, wall factor 0.98, no wall weight) {maxcol} - the difference is the wind, not the method. HEA 140 adopted.

**Purlins Z200x2.0 @ 1.5 m** (basis: M_Rd 12.5 kNm single span, 16 sleeved; I = 3.9e6 mm4): worst gravity M_Ed = {Mg} kNm; worst uplift M_Ed = **{Mu} kNm** on the 3.07 m corner spans ({Mu_where}, zone F, N wind, w = -5.4 kN/m), 0.50 of the single-span gravity value; the 1.0 kN maintenance point load gives 0.9 kNm and the panel supplier's walkability statement is required (crawl boards otherwise). Purlin cleats (C10): zone-F end reaction {cleatR} kN per cleat -> 2 M12 8.8 in tension 0.11, cleat plate 120 x 10 bending 0.66; the panel fastener schedule in zones F/G comes from the panel supplier. Because the free-flange uplift capacity of a Z200x2.0 is typically 55-70 % of the gravity value, **a mid-span anti-sag row is specified on every span and the supplier's uplift capacity (>= 9 kNm single span with one anti-sag row, or sleeved) is required before order** (open item 3). Deflection G + Q on {Lp} m: {dp} mm < L/150 = {dplim} mm. Girts (wall net 2.15 kN/m2, zone A 2.73 within 2.4 m of a corner): 1.5 m rows single-span for bays <= 5.3 m (<= 11.3 kNm); 1.2 m rows sleeved on K5-K7, K25-K19, K8-K6 (<= 14.2 kNm); 1.0 m rows sleeved on K21-K22, K22-K23, K14-K4 (<= 14.9 kNm, 0.93).

## 5. Connections (EN 1993-1-8)

- **Rafter to primary fin plate**, one type: 100 x 150 x 10 S275, 2 M20 8.8 (pitch 70, e1 = e2 = 40), bolt line 50 mm from the primary web, 2 x 6 mm fillets. Max rafter end reaction {Vfin} kN (envelope ULS-1 / reversed ULS-3 incl. the gutter): bolt shear incl. eccentricity {fin2_bs}, bearing on the {twR} mm {SR} rafter web **{fin2}** (governs), plate bearing {fin2_bp}, plate shear {fin2_ps}, plate bending {fin2_pb}, weld {fin2_w}, web block tearing {fin2_bt}. 9.2 m rafters: the same 2 M20 plate ({fin3} at {Vfin_long} kN; the IPE 240 web has 190 mm clear, so no 3-bolt row). No copes. **Strut / chord splices (Rev 5a, Z1)**: the same plates carry the diaphragm axial force (E_y + 0.3 E_x / E_x + 0.3 E_y) with the gravity shear - web bearing governs ({FbRd2} kN per M20 on the {twR} mm web, one row): R78 into B7 {NR78} kN with 2 M20 ({FbRd2} kN per bolt on the {twR} mm web) -> {uR78f}; R68 (strut into B5 + RT-W chord) {NR68f} kN, R95 (strut into B6 + B9 + RT-E chord) {NR95f} kN, R72 / R90 (chords) with a **2 x 2 M20 plate 160 x 150 x 10** (two rows p2 60, {FbRd4} kN per bolt) -> {ufin_max} max; R82 {NR82} kN 2 M20 -> {uR82f}; the force passes through the {SP} primary web (7.1 mm) plate-weld-web-weld-plate; full table in bracing_rev5.md 2b. T1/T2, ST1/ST2 and the notch eave beam use the same detail.
- **Primary to column cap plate** 200 x 280 x 20 on the {SC} (a = 6 all round, 792 mm perimeter), 4 M20 through the {SP} bottom flange (gauge 90 = 30 mm edge on the 150 flange and inside the 140 column flange; **pitch 200** so the nuts clear the passing rafter flange and the bolt rows sit 33 mm outside the 133 mm column depth: cap-plate cantilever {capCant}; primaries bolted before the rafters; at K19 / K20 the cap sits under the IPE 330 of P13, 30 mm lower). Tension = roof uplift {Nt_cap} kN (K12, ULS-3N; the bracing vertical component enters below the cap through the gusset): bolt tension {cap_bt}, shear + tension interaction with the chord/strut force {Vh_cap} kN {cap_bi}, {SP} flange T-stub {cap_ts}, cap plate 0.05, weld {cap_w}. Chord continuity across a column (<= 61 kN): 10 mm tie plate between the primary bottom flanges on the lines y 29.3 and y 20.1.
- **Bracing gussets**: 10 mm plates welded to the column web and base plate; each L70x7 with 2 M20 (e1 40, p1 110, e2 30): angle net section 189 kN, bolt shear 188 kN, gusset bearing 2 x 124 kN; max T_Ed {B8T} kN (B7, Rev 5) -> {udiag_max} angle; bolts 2 x 124 kN bearing.
- **Roof bracing** M24 rods 8.8 (F_t,Rd 203 kN) with turnbuckles to 8 mm gussets shop-welded to the primary webs and bolted (2 M16) to the rafter webs at the bottom flange level (no site welding, C9; rod hole in the rafter web shown on D5); on the east and west edge trusses the rods span two rafter bays and pass the intermediate rafter (R92 / R70) through a bolted web clip; sag ties to the purlins at the crossing and at 3 m centres.
- Trimmer T2 (y 24.09) {SR} between the rafters x 77.8 / 81.85 carries only the 150 mm upstand (0.3 kN/m, M_Ed 1.8 kNm); upstand framing 100 x 50 x 3 cold-formed C on the trimmers and along the rafters beside the openings, cricket on the south side of the stair well; the well's north edge is the wall itself (header with gutter stop-ends), T1 deleted.

## 6. Bases and anchors, Rev 6 (= Rev 5a detail re-run with load basis Rev 3 and the amplified seismic case) - full note in `bases_C.md`

**One base detail at all 27 columns (type E; K21 = E + saddle):** plate **300 x 400 x 20** (Rev 6: 20 mm; plate T-stub <= {uplate_max}, plate strip under the key moment <= {ustrip}; key-pair plates per base, 20 mm, no stiffeners) on 25 +/- 5 mm grout, columns cut to the surveyed plate-top level; **4 dia 16 B500 post-installed rebars with M16 threaded ends (EAD 330087 injection system) at 70 x 240 concentric in the column core** (240 along the concrete column's long axis, 26 mm clear to the corner dia14 bars), drilled 20 mm through the 300 mm slab and **300 mm into the column head (250 mm minimum), the top 300 mm debonded by a sleeve and the column part only injected**, so no slab cone is ever loaded. Capacity to EN 1992-1-1 8.4: f_bd = 2.7 MPa (C25, good bond), **4 x 33.9 = 136 kN at 250 mm** (163 kN at 300), steel 4 x 87 = 350 kN, 1:1 lap with the corner dia14 bars (268 kN receiving; l_0 = max(1.5 l_b,rqd, 15 d) = 240 <= 250; d < 20, existing dia6/200 links suffice, splitting by the cover rules). Tension (250 mm minimum embedment, 136 kN): worst {Ntmax_col} {Ntmax} kN -> {uten_max}; K19 {K19t}, K23 {K23t}, K12 {K12t}; shear as Rev 4b/5 (Key A under the column at interior bases, Key A + Key B at K3, K4, K6, K8, K14, inboard key pairs at K1, K2, K5, K7, K10, K15, K18, K19, K20, K22, K23, K25, K27; rigid-post key moments): the E-W bay bases K5, K7, K22, K23 now take the amplified seismic bay shear (64-71 kN): worst key {ukey_max} ({ukey_col}), K23 0.53, K22 0.52; plates <= 0.10; WP1 0.31. Key pairs and plate sizes are not simplified: they are dictated by the parallel-edge condition at Key A (18.5 kN at c1 55), not by the force level, and the seismic E-W shears exceed a single key's edge value; a single key everywhere is therefore not possible, and one plate size (the 550 x 800 key-pair plate at all 27 bases) would only add steel at the 13 Key A bases. Worst base **{worst}: {wb_u} ({wb_gov}, {wb_case})**; all 27 bases <= 1.0.

Seismic-governed bases: K5, K7, K22, K23 (E-W bays B2, B3) and the N-S bay bases K10, K16, K14, K18, K23, K19, K25 with 1.0 G +/- 1.0 E net per line (reactions_C.csv rows ULS4). Site procedure (V3/V4): cover-meter scan of the column faces from below (+/-3-5 mm) projected to the slab top plus GPR from above, 10 mm pilot drill with feed monitoring, relocation within +/-15 mm on steel contact, plate holes 30 mm oversize with 10 mm plate washers (or match-drilled), proof tests of 3 bars to >= 60 kN with displacement <= 1 mm; **108 scanned and drilled holes (27 x 4)** plus 37 key pockets set by the same scan. No solid-zone criterion for the anchorage; the slab must be solid and 300 mm under the plates and around the key pockets (GPR at all heads). Appendix of bases_C.md: the 7 interior columns as B1 (4 M20 h_ef 250 in the slab, 800 x 800 solid zone verified by GPR, K12 0.69) as the client's fewer-holes option (-28 holes).

## 7. Deflections and sway

- Roof members SLS G + Q: worst primary K19-K20 36 mm = L/271 (limit 49 mm); 9.2 m rafters 22-24 mm = L/390; 7.5 m rafters L/700-820; purlins L/640.
- Braced-bay sway under SLS wind (diagonal elongation + 2 mm bolt-slip allowance): 2.8-3.9 mm vs h/150 = 20-28 mm. Column bending under wall wind (K22, 9.8 kN/m on 3.91 m) 8.5 mm = h/460.
- **Roof diaphragm drift** at the mid-length of the east / west walls (truss deflection by virtual work over the M24 rods, SLS, plus bay sway): **{driftE} / {driftW} mm** vs h/150 = 26-28 mm (0.40).

## 8. Bracing

Vertical bays (X, one L70x7 per diagonal, tension-only; **every bay is governed by the amplified seismic case 1.0 E at q 1.5, table below**), **final list for the client after Rev 5 - these bays must stay door-free, none is inside the hall**: E-W **B1 K1-K2** (north wall, 5.3 m), **B2 K5-K7** (north wall, 5.7 m), **B3 K22-K23** (notch south wall, 6.6 m), **B4 K25-K26** (south wall, 4.0 m); N-S **B5 K15-K19** (west wall, 4.6 m), **B6 K14-K18** and **B9 K18-K23** (east wall, 4.8 + 4.4 m), **B7 K20-K27** (notch west wall / shaft west line, 5.9 m). Removed at Rev 5: B8 (K10-K16, the interior X) and B10 (K19-K25) - reasons per bay in bracing_rev5.md. Max diagonal utilisation {udiag_max} ({udiag_bay}, seismic), gusset bolts {ubolt_max}. Reason for the layout: at every braced-bay base the bay shear enters the concrete along the column's long axis or towards the slab interior, never towards a free edge < 0.25 m (the Rev 5a keys stay); K18 (B6 + B9) carries no net bracing uplift. Alternates if a bay is not door-free: B1 -> K3-K1, B3 -> K21-K22 (K21 base then needs a supplier-verified edge detail), B5 -> K19-K25, B7 -> none on that line (K10-K16 would put the X back into the hall).

Roof-plane bracing (Rev 5): M24 rods in **{n_panels} X panels in five strips** - north strip west (2 panels over two rafter cells, chords y 29.3 / 35.2, posts R68, R72, R78), north strip east (3 panels, posts R82, R87, R92, R95), the jog panel past the stair well (chords y 24.5 / 29.3), the west strip (R68 / R72, 4 panels with posts at the primaries and ST2) and the east strip (R90 / R95 over two rafter bays, 3 panels with posts at the primaries and ST1). The south bands are unbraced: the rafters carry their inertia as N-S struts to the y 29.3 chord, and R78 carries the east reaction of the north strip west and the jog-panel shear ({jogV} kN) down to B7. Strip analysis, strut/chord checks and the before/after table: bracing_rev5.md.

{truss_table}

## 9. Reactions at the column bases (kN, ULS envelope with concurrent values; reactions_C.csv gives every column and case: ULS-1, ULS-2/3 for N, S, E, W wind, ULS-4 +/-x, +/-y, SLS, with N, V_x, V_y, near-edge flags and base utilisation)

{reaction_table}

## 10. Weight and section list

{weight_table}

Sections (Rev 6a): **{SP}** (E-W primaries and eave beams on the column rows, 92.5 m incl. **P13 K19-K20 in IPE 330**, {Wpri} t), **{SR}** (rafters, edge beams, trimmer T2, truss posts ST1/ST2, {Lraft} m, {Wraf} t), **{SC}** (27 columns, WP1, {Wcol} t), plus L70x7 wall bracing, M24 rod roof bracing, Z200x2.0 purlins/girts. **Weight: about {Wbom6} t on the BOM basis** = 25.4 t (S06 Rev 4b) less the section change, less the Rev 5 bracing saving of about {Wsave} t, less 0.13 t of base plates (20 mm) (rods {Lrod} m instead of 366, eight bays instead of ten, 44 gussets fewer; detailing to update S06); the calculation take-off above gives {Wtot} t with the BOM's plates (3.4 t) and purlin/girt length (571 m), the balance being the sill rail, well header and the BOM's cut-length and connection allowances. Cost basis (Rev 6): about {Wbom6} t fabricated and erected at the indicative MENA rate of the final critique (about 2,040 $/t): about {Wcost} $.

## 11. Open items / risks

1. **Slab verification** (bases_C.md sections 5-6): face cover-meter scan of every column head (6 dia14, links, cover) and GPR from above (slab solid and 300 mm under the plates and pockets), 3-6 cores for the concrete grade, the 70 x 240 pattern set on site (+/-15 mm), proof tests of 3 bars to >= 60 kN, an EAD 330087 injection system; K21 pier faces accessible for the saddle. A head that cannot be drilled falls back to the appendix B1 detail with its solid-zone condition.
2. Wind: v_b 27 m/s and the terrain sectors (N I, E/W II, S III) to be confirmed with the Libyan National Meteorological Centre and on the map (+/-15 deg sectors); 25 m/s would lower every wind figure by 14 %; the bays and bases are seismic-governed, so wind changes affect members and uplift only.
3. Purlin uplift capacity (>= 9 kNm single span with one anti-sag row) and the sleeved girt capacities to be confirmed with the supplier before order.
4. BoardX product data (0.30 kN/m2, girt rows per section 4) and its drift limit (h/150 assumed; diaphragm drift 10 mm, bay sway 4 mm).
5. Seismic: the two-mass check assumes T_1 of the existing building between 0.15 and 0.35 s (the worst, {T1X} s, is used); a measured period (ambient vibration test) could reduce S_a from {SaX} g towards 0.30 g; the design bay forces are on the envelope and the diagonals are at <= {udiag_max}.
6. Existing structure (C5): the roof adds about {sumG} kN of characteristic gravity load (no wall weight; + 116 kN if the BoardX walls are counted), {wN} kN of characteristic roof-level wind (N-S, worst direction) and **{FbX} kN E-W / {FbY} kN N-S of design seismic force at roof level (two-mass, q 1.5)** into the 27 pinned 20 x 40 concrete columns and their foundations; as-builts, a one-page adequacy statement of the existing columns/foundations, a roof survey (screed thickness = datum for the 3.02 m and the base seating) and the slab-top datum on S00 are required before cores.
7. Client confirmations: door-free bays B1-B7 and B9 (section 8; no interior bay after Rev 5), rafter R82 over the shaft east wall line (x 81.85 vs shaft face 81.99).
8. **Open minors from the reviews (carried until closed; A4):**

| ID | Item | Owner | Status (Rev 6a) |
|---|---|---|---|
| Y1 | E_x +/- 0.3 E_y on the columns and bases shared by an x-bay and a y-bay (K23, K18, K19) | designer | **closed** - applied in the ULS-4 cases (K23 base {K23u}, K19 {K19b}) |
| Y2 | T_1 scan misses the resonance: S_a 0.66 g, not 0.648 | designer | **closed** - S_a bounded by 5.5 a_g S = 0.66 g, F {FbX} / {FbY} kN |
| Y3 | DCL with a_g S 0.12 g: cite the zonation; reconcile the HEA 140 text (0.79 vs 1.06) | designer / client | text closed (section 2 and 3); zonation reference to be confirmed by the client's seismic statement |
| Y5 | South-sector terrain III to be confirmed on the map | designer / client | open - no governing change (S wind is the lowest) |
| Y6 | Existing structure receives {FbX} / {FbY} kN design seismic at roof level | designer -> structural engineer of record | closed in the C5 statement (item 6); adequacy check by others open |
| Z2 | NE corner gussets K2 / K4 / K13 / K14 for both rod sets (E_x + 0.3 E_y), rod crossings and the R92 clip | detailing (S04) | open - forces given in bracing_rev5.md 2b |
| Z3 | EN 1998-1 4.4.3.2 drift check | designer | **closed** (Rev 5a; {drW} vs {drWl} mm) |
| Z4 | Strip end-shear split stated | designer | **closed** (Rev 5a, bracing_rev5.md 2a) |
| Z5 | Temporary plan bracing of the unbraced south bands during erection | detailing (S05 sequence) / erector | open - requirement stated in bracing_rev5.md 2d |
| Z6 | Z200x2.0 A and i_min (20 mm assumed) | purlin supplier | open - supplier data before order |
| A1 | Rafter / primary flange clash at TOS + 0.05 | designer -> detailing (S01-S03 levels and schedule) | **closed** in the calculation (this revision); drawings to be re-issued |
| A2 | P13 as IPE 330 rather than precambered | designer | **closed** (adopted) |
| A3 | Column length rounding | designer | **closed** (L = TOS - 0.335 exact) |

9. Thermal: no slotted holes; the locked-in E-W force is designed for (section 2); the panel supplier confirms the sandwich-panel fastening for +/-30 K. Client option (bases_C.md appendix): the 7 interior columns as B1 slab anchors, saving 28 column-head holes against a GPR-verified 800 x 800 solid zone.

Files: `design_report_C.md` (this, Rev 3), `bases_C.md` (Rev 5a), `members_C.csv` (99 rows), `reactions_C.csv` (595 rows, with base type, keys, psi_ec, max anchor/bolt and minimum zone per case), `framing_C.png`, `calc/` (sections.py, model.py, loads.py, statics.py, takedown.py, bracing.py, members.py, connections.py, bases_note.py, run_all.py, write_report.py, report_text.md, summary_C.json).
