loka92/test1strsteel/roof/offer/pricing_internal_RevD.md

# Internal pricing of offer RTV-2026-01 Rev D (design Rev 8a, client cost basis of 29 Sep 2026, 25 % margin) - not for the client

| Cost item | Basis | LYD |
|---|---|---|
| Steel material incl. plates, 11.0 t | sections at supplier quotation 11486 prices (Rev 8a cutting plan) + plates and small items | 103,200 |
| Sections assembly (fabrication and erection) | client figure | 20,000 |
| Roof sandwich panels 316 m2, supply and assembly | client figure | 47,000 |
| **Total cost** | | **170,200** |
| Profit margin | 25 % of the total cost | 42,550 |
| **Offer price (rounded)** | | **213,000 LYD** |

Not priced separately in this basis (covered by the lump sum and the margin): gutters and downpipes, base works (scans, 92 rebar holes, key pockets, grout, pull-out tests), transport. Earlier allowances were 12,000 and 18,500 LYD. Corrosion protection is excluded from the scope (Jotun Barrier 80 / Jotamastic 90 / Hardtop XP recommended, to be priced on request).
Superseded: Rev A 284,000 LYD (Rev 7, 6,950 LYD/t all-in, 50 %), Rev B 343,000 LYD (Rev 7, quotation-based, 25 %), Rev C 217,000 LYD (Rev 8, client basis with material 106,600). Payment: 106,500 advance / 53,250 at erection start / 53,250 at handover. Valid 15 days to 14 October 2026. Warranty 12 months.
Generated by make_offer_rev10.py (pricing_internal_RevD.json holds the same numbers).
