loka92/test1strsteel/roof/review/review_C_rev5a_bases_signoff.md

# Alternative C - bases Rev 5a: confirmation of V1-V6 (written with the Rev 4 review)

Checked on the Rev 5a files (scripts regenerated them byte-identical) and re-confirmed on Rev 6, which keeps the detail unchanged. Units kN, mm.

- **V1 closed** - post-installed rebar connection (EAD 330087, EN 1992-1-1 8.4 / 8.7): 4 x dia 16 B500 with M16 threaded ends, f_bd 2.7 MPa; 4 x 33.9 = 136 kN at the 250 mm minimum embedment, 163 kN at the 300 mm target; 1:1 lap with the corner dia14 bars (268 kN). Rev 5a: K19 0.54, K23 0.80 reproduced; Rev 6: tension 0.32, K7 key 0.90.
- **V5 closed** - at K19 l_0 = 1.5 x 135 = 203 < l_0,min = 15 d = 240 <= 250 provided, 300 targeted; the per-base line "l_0 240 vs 250 provided" is correct.
- **V2 closed** - top 300 mm debonded by a sleeve, resin in the column part only: the slab cone and slab bond are never loaded, and the bar tip sits 250-300 mm inside a column that continues downward, so no cone exists.
- **V3 closed** - 70 x 240 with the 240 along the long axis: (+/-120, +/-35) at the E-W columns, (+/-35, +/-120) at the N-S ones; rod (35, 120) to corner bar (57, 157): 43 - 7 - 10 = **26 mm clear**. Face scan from below (+/-3-5 mm) plus GPR, 10 mm pilot, relocation +/-15, 30 mm plate holes or match-drilling.
- **V4 closed** - 3 production bars (interior, edge, corner head) to >= 60 kN, 2 min, displacement <= 1 mm; EAD 330087 system, certified installer.
- **V6 closed** - all 27 bases type E (K21 E + saddle); B1 an appendix option only.

**Verdict: Rev 5a bases ACCEPTABLE**; superseded numerically by Rev 6, signed off in `review_C_rev4.md`.
