loka92/test1strsteel/roof/systems/comparison.md

# Structural system comparison – steel roof over the existing slab (Rev 1)

Rev 1: stair well and elevator shaft are unroofed openings (trimmed, upstand + flashing); roof is ONE plane at 6 % falling north. Roofed area about 446 m2 of the 486 m2 footprint.

All three schemes: 27 steel columns on the existing column positions, mono-pitch 6 % falling north,
3.0 m clear at the north eave, PIR 50 mm roof on Z200 purlins at 1.5 m, S275, bolted site joints,
pinned base plates with 4 x M20 resin anchors into the solid column-head zone of the hollow-block slab.
Roofed area about 485 m2 (the notch x 77.9-95.7 / y 15.6-20.1 is outside the footprint).

| | A – Portal frames | B – Lattice trusses | C – Post-and-beam braced |
|---|---|---|---|
| Primary members | 7 mono-pitch portal frames N-S, IPE 300 / IPE 240 rafters, HEA 200 / HEA 160 columns, haunched bolted moment knees | 7 Warren trusses N-S, 1.40 m deep, SHS 120x120x5 / 100x100x5 chords, SHS 70x70x4 diagonals, SHS 150x150x5 posts | IPE 330 primaries E-W on column rows, IPE 270 rafters N-S, HEA 160 columns, all pinned (fin plates and cap plates) |
| Longest span | 13.4 m rafter (x 72.1), 9.2 m rafters propped on a transfer eave girder | 19.3 m and 15.6 m trusses, no interior posts | 9.2 m rafters, 9.8 m primary K19-K20 |
| Columns used | all 27 | 19 (8 interior columns unused) | all 27 |
| Lateral stability | N-S by portal action, E-W by 4 braced wall bays + roof bracing | X bracing in 8 wall bays + roof bracing, both directions | X bracing in 7 wall bays (must be door-free) + perimeter roof bracing |
| Different hot-rolled sections | 4 (+ SHS posts) | 4 SHS + IPE girder | 3 |
| Site connections | moment end plates (fit-up sensitive) + pins | shop-welded trusses, site splice on 19.3 m trusses, pins | 2 simple details only |
| Roof profile height (top of steel) | 3.45 m N to 4.67 m S | 4.52 m N to 5.74 m S (deep trusses) | 3.28 m N to 4.50 m S |
| Steel weight (approx., Rev 1) | 16.3 t = 34 kg/m2 footprint | 14.9 t = 31 kg/m2 footprint (+1 t girts) | 20.5 t = 42 kg/m2 footprint |
| Openings handled by | 4 trimmers IPE 200 between F3/F4; roof bracing moved east | trimmers SHS 100x100x4 between trusses; roof bracing moved east | trimmers T1/T2 IPE 270; primaries and rafters already bound the openings |
| Base uplift (worst, ULS) | 25-35 kN | about 88 kN on truss posts | 63-70 kN |
| Main advantage | Standard portal system, lowest profile, no bracing needed on north/south facades | Lightest, column-free hall, small reactions per post | Simplest to fabricate and erect; irregular grid absorbed by beam-on-beam framing; plumb columns |
| Main drawback | 7 different frame geometries, transfer girder and hung post at the notch, moment knees on short columns | Tallest walls (about 20 % more cladding), hollow-section joint welding, high uplift per post, site splice | Heaviest; stability relies entirely on 7 braced wall bays; every base in net uplift |

## Recommendation
For the client's stated priority (simplicity) and an enclosed hall whose perimeter walls can carry bracing,
**System C** is the best fit: three sections, two bolted details, no moment connections, no transfer members.
Its extra steel (about 4-5 t over A) is cheaper than the fabrication and fit-up effort that A and B add.
**System A** is the economical alternative if tonnage matters more than repetition.
**System B** should be chosen only if a fully column-free hall is wanted; its height and welded trusses conflict with the simplicity priority.

Whichever is chosen, the slab anchorage is the critical unknown: the solid-zone extent and slab thickness over the
column heads must be confirmed on site (trial cores) before the anchor design is final.

Files: A_portal.md, B_truss.md, C_postbeam.md and the *_plan.png / elevation images in this folder.

## Cost, simplicity and programme (indicative MENA rates, relative use only)

| | A: Portal frames | B: Lattice trusses | C: Post-and-beam |
|---|---|---|---|
| Steel tonnage | 16.3 t | 15.9 t incl. girts | 20.5 t |
| Steel rate, fabricated + erected | ~2,300 $/t | ~2,900 $/t | ~2,000 $/t |
| Steel cost | 37,500 $ | 46,000 $ | 41,000 $ |
| Roof panel, 446 m2 | 18,000 $ | 18,000 $ | 18,000 $ |
| Wall cladding (96 m perimeter) | 420 m2, 14,800 $ | 520 m2, 18,200 $ | 405 m2, 14,100 $ |
| Bases, grout, anchors (27) | 6,800 $ | 6,800 $ | 6,800 $ |
| Total, indicative | 77,000 $ | 89,000 $ | 80,000 $ |
| Relative cost | 1.00 | 1.16 | 1.04 |
| Simplicity | medium | low | high |
| Fabrication | 4 weeks | 5-6 weeks | 3-4 weeks |
| Erection | 2.5 weeks, crane | 2 weeks, splice + larger crane | 3 weeks, small crane/hoist |
| Cladding | 2 weeks | 2.5 weeks | 2 weeks |
| Programme total | ~9 weeks | ~10-11 weeks | ~8-9 weeks |
