loka92/test1strsteel/roof/offer/Sections_and_quantities_EN_AR_Rev7.pdf

## SECTIONS AND QUANTITIES - STEEL ROOF, ADMINISTRATION BUILDING, REGATTA TOURIST VILLAGE, TRIPOLI

## جدول القطاعات والكميات - السقف الحديدي المبنى الإداري، قرية ريقاطة السياحية، طرابلس

Design Rev 7, reduced roofed area per the architect 2nd-level plan (29 Sep 2026), no detailing yet. Issued by Eng. MALEK ABOZRAIG, malek.abozraig@gmail.com. Steel S275 hot-dip galvanised or shop-primed; roofed area 316 m2 on 20 of the 27 existing columns.

التصميم مراجعة 7 (29 سبتمبر 2026)، قبل التفصيل: مساحة السقف المخفضة حسب مخطط المعماري. إعداد: م. مالك أبوزريق. الحديد 275S مجلفن بالغمس الساخن أو مدهون بالورشة. مساحة السقف 316 م2 على 20 من الأعمدة القائمة الـ.27

No. | Element | العنصر | Section / grade | Pieces | Length m | Weight t | Remarks
1 | Columns (one on each of the 20 concrete columns under the roof) | ( السقف تحت خرسانيا عمودا 20 فوق ( الأعمدة | HEA 140, S275 | 20 | 67.1 | 1.66 | L = TOS - 0.335 m, cut to the surveyed level
2 | Wind posts on the two south eaves | الجنوبيين الطنفين على الرياح أعمدة | HEA 140, S275 | 3 | 12.1 | 0.30 | WP2, WP3, WP4: shear only, no roof load
3 | Primary and eave beams on the column rows | الطنف وكمرات الرئيسية الكمرات | IPE 300, S275 | 14 | 64.9 | 2.74 | level, on cap plates
4 | South eave beam of the east block (K17 -K18, 13.7 m) | كمرة الطنف الجنوبي | | | | 0.67 13.7 1 275S 330, IPE للكتلة الشرقية (13.7 م)
5 | Rafters, chord T3 and post ST2 | ST2 والقائم T3 والكمرة المائلة العوارض | IPE 240, S275 | 24 | 144.6 | 4.44 | single plane, 6 % falling north
6 | Roof purlins @ 1.5 m | م 1.5 كل السقف مدادات | Z 200 x 2.0, S350GD galvanised | | 217.0 | 1.28 | with anti-sag rows and fly braces
7 | Wall X-bracing, 6 bays x 2 diagonals | 2 × حيزات X، 6 الجدران شكالات | L 70 x 70 x 7, S275 | 12 | 73.1 | 0.54 | tension-only, gusset plates 10 mm
8 | Roof plane bracing, 12 panels x 2 rods | 2 × لوح 12 ، السقف شكالات قضبان | M24 rods, grade 8.8, turnbuckles | 24 | 167.8 | 0.60
9 | Base plates | القواعد صفائح | 300 x 400 x 20, S275 | 23 | | 0.45 | grout bed 25 mm
10 | Post-installed anchor bars | المزروعة التثبيت أسياخ | dia 16 B500, threaded end, 550-600 mm | 80 | 47.0 | 0.08 | 4 per column into the column head, EAD 330087 resin
11 | Shear keys | القص مفاتيح | SHS 90 x 90 x 8 (30) and dia 60 bar (6) | 36 | | 0.16 | in cored pockets, grouted
12 | Cap plates, fin plates, gussets, cleats, stiffeners, bolts | والمسامير والحوامل والأغطية الوصلات صفائح | S275 plates 8 - 20 mm, bolts 8.8 HDG | | | 1.78 | allowance scaled from the Rev 6a BOM; detailing to follow
13 | Roof sandwich panels | للسقف الساندوتش ألواح | PIR 50 mm, colour-coated steel both faces | | | | 316 m2 net + 5 % laps; flashings and well upstand
14 | Box gutters and downpipes (north) | ( شمال ( النزول ومواسير الصندوقية المزاريب | Gutter 150 x 100, 4 downpipes dia 100 | | | | 24 m gutter, 4 x 7.4 m downpipes
15 | Wall girts (NOT included - wall system open) | مدادات الجدران ( مفتوح النظام -مشمولة غير ( | Z 200 x 2.0, S350GD galvanised | | 270.0 | 1.59 | only if panel walls are chosen
| Total structural steel in the offer (girts excluded) | ( الجدران مدادات بدون ( إجمالي الحديد الإنشائي في العرض | | | | 14.7 | offer basis (take-off 16.3 t incl. girts line; girts 1.6 t excluded)

Notes: lengths are net member lengths from the member schedule; pieces are erection pieces. Wall panels, their
fixings and the existing-structure verification are not included. Bolt, fastener and flashing quantities follow with the detailing.

ملاحظات: الأطوال هي الأطوال الصافية للعناصر من جدول العناصر؛ القطع هي قطع التركيب. لا تشمل ألواح الجدران وتثبيتاتها ولا التحقق من المبنى القائم. كميات المسامير والمثبتات والفلاشينج تأتي مع التفصيل.
