loka92/test1strsteel/roof/offer/Steel_sections_list_EN_AR.pdf

## STEEL SECTIONS LIST - STEEL ROOF, ADMINISTRATION

BUILDING,

## REGATTA TOURIST VILLAGE, TRIPOLI

## قائمة القطاعات الحديدية السقف الحديدي - المبنى الإداري قرية ريقاطة السياحية، طرابلس

Design Rev 6a, drawings RTV-ST-S00 to S06, 29 Sep 2026. Issued by Eng. MALEK ABOZRAIG, malek.abozraig@gmail.com. Lengths are net member lengths from the member schedule; add cutting and connection allowances for ordering.

التصميم مراجعة a،6 الرسومات 00S-ST-RTV إلى 29 06،S سبتمبر .2026 إعداد: م. مالك أبوزريق.
الأطوال صافية من جدول العناصر؛ تضاف نسبة للقطع والوصلات عند الطلب.
No. | Section | Used for | الاستخدام | Steel grade | Total length m | Weight t
1 | HEA 140 | Columns and wind post | الرياح وعمود الأعمدة | S275 JR (EN 10025-2) | 99.9 | 2.47
2 | IPE 300 | Primary and eave beams | الطنف وكمرات الرئيسية الكمرات | S275 JR (EN 10025-2) | 82.7 | 3.49
3 | IPE 330 | Primary beam P13 (9.8 m span) | P13 الرئيسية الكمرة | S275 JR (EN 10025-2) | 9.8 | 0.48
4 | IPE 240 | Rafters, edge beams, trimmer, truss posts | الحافة وكمرات المائلة العوارض | S275 JR (EN 10025-2) | 204.4 | 6.28
5 | Z 200 x 2.0 (cold-formed) | Roof purlins and wall girts | والجدران السقف مدادات | S350GD + Z275 (EN 10346) | 571.0 | 3.37
6 | L 70 x 70 x 7 | Wall X-bracing | (X) الجدران شكالات | S275 JR (EN 10025-2) | 103.8 | 0.77
7 | Round bar M24 (threaded rod) | Roof plane bracing rods | السقف شكالات قضبان | Grade 8.8 (EN ISO 898-1) | 188.6 | 0.67
8 | SHS 90 x 90 x 8 | Shear keys at the bases | القواعد عند القص مفاتيح | S275 J0H (EN 10210) | 7.0 | 0.14
9 | Round bar dia 60 | Edge shear keys | الجانبية القص مفاتيح | S355 J2 (EN 10025-2) | 1.5 | 0.03
10 | Rebar dia 16 (threaded end) | Post-installed base anchors | القواعد تثبيت أسياخ | B500B (EN 10080) | 63.0 | 0.10
11 | Plates 8 - 20 mm | Base, cap, fin and gusset plates | والوصلات القواعد صفائح | S275 JR (EN 10025-2)
| Total | all sections above | الإجمالي | | 1332 | 17.8
Sections above 17.8 t; with plates, keys and anchors 3.3 t the bill-of-materials total is 22.2 t. | طن 3.3 | والأسياخ | والمفاتيح | الصفائح | مع | طن؛ | 17.8 | أعلاه | القطاعات
يكون إجمالي جدول الكميات 22.2 طن.

Surface protection: hot-dip galvanising to EN ISO 1461 (or shop primer + two-coat paint system as
agreed); cold-formed sections pre-galvanised Z275. Bolts M20 / M16 / M12 grade 8.8 hot-dip galvanised, quantities on drawing S06.

الحماية السطحية: جلفنة بالغمس الساخن وفق 1461 ISO EN أو دهان أساس بالورشة مع طبقتين حسب الاتفاق. القطاعات المشكلة على البارد مجلفنة مسبقا 275Z. المسامير 12M / 16M / 20M درجة 8.8 مجلفنة؛ الكميات في الرسم 06S.
