loka92/test1strsteel/roof/design/C7/members_C7.csv

id | type | section | length | frm | to | N_Ed | M_Ed | V_Ed | u_M | u_V | u_LTB_g | u_LTB_up | u_defl | utilisation | governing | verdict
T3/R75-K16 | trimmer/chord | IPE 180 | 2.88 | R75 | K16 | 0.0 | 0.3 | 0.4 | 0.01 | 0.0 | 0.01 | 0.01 | 0.0 | 0.01 | LTBg | OK
R68/K19-K15 | rafter | IPE 180 | 4.61 | K19 | K15 | 0.0 | 6.3 | 7.9 | 0.14 | 0.04 | 0.08 | 0.16 | 0.07 | 0.16 | LTBu | OK
R68/K15-K8 | rafter | IPE 180 | 3.0 | K15 | K8 | 0.0 | -0.2 | 9.0 | -0.0 | 0.05 | 0.1 | 0.19 | 0.04 | 0.19 | LTBu | OK
R68/K8-K6 | rafter | IPE 180 | 5.8 | K8 | K6 | 0.0 | 9.1 | 9.0 | 0.2 | 0.05 | 0.11 | 0.31 | 0.12 | 0.31 | LTBu | OK
R70/P_K19K28-P_K8K9 | rafter | IPE 180 | 7.56 | P_K19K28 | P_K8K9 | 0.0 | 15.5 | 14.5 | 0.34 | 0.08 | 0.4 | 0.44 | 0.42 | 0.44 | LTBu | OK
R70/P_K8K9-P_K6K5 | rafter | IPE 180 | 5.9 | P_K8K9 | P_K6K5 | 0.0 | 10.8 | 13.0 | 0.24 | 0.07 | 0.43 | 0.45 | 0.07 | 0.45 | LTBu | OK
R72/K28-K9 | rafter | IPE 180 | 7.51 | K28 | K9 | 0.0 | 15.0 | 14.4 | 0.33 | 0.08 | 0.47 | 0.39 | 0.47 | 0.47 | defl | OK
R72/K9-K5 | rafter | IPE 180 | 6.0 | K9 | K5 | 0.0 | 12.4 | 14.1 | 0.27 | 0.08 | 0.5 | 0.44 | 0.09 | 0.5 | LTBg | OK
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
