loka92/test1strsteel/roof/design/C7/reactions_C7.csv

column | x | y | braced_bays | case | N_kN | Vx_kN | Vy_kN | Vcross_x | Vcross_y | V_total | base_util | base_gov | near_edges | base_type | keys | max_anchor_kN
K1 | 87.19 | 35.77 | B1 | ULS1 | 19.7 | 0.0 | 0.0 | 0.0 | 0.0 | 0.0 | 0.03 | bearing | +y | E | A-pair | 0.0
K1 | 87.19 | 35.77 | B1 | SLS | 13.9 | 0.0 | 0.0 | 0.0 | 0.0 | 0.0 |  |  | +y | E | A-pair
K1 | 87.19 | 35.77 | B1 | ULS2N | 22.5 | 0.0 | -15.5 | 0.4 | 0.0 | 15.5 | 0.16 | plate strip at key moment | +y | E | A-pair | 0.0
K1 | 87.19 | 35.77 | B1 | ULS3N | -34.2 | 0.0 | -15.5 | 0.4 | 0.0 | 15.5 | 0.25 | E rebar bond in the column head, embed 250 min (N_Rd 136) | +y | E | A-pair | 8.6
K1 | 87.19 | 35.77 | B1 | SLSWN | -18.6 | 0.0 | -10.4 | 0.2 | 0.0 | 10.4 |  |  | +y | E | A-pair
K1 | 87.19 | 35.77 | B1 | ULS2S | 22.5 | 0.0 | 5.3 | 0.2 | 0.0 | 5.3 | 0.05 | plate strip at key moment | +y | E | A-pair | 0.0
K1 | 87.19 | 35.77 | B1 | ULS3S | -6.9 | 0.0 | 5.3 | 0.2 | 0.0 | 5.3 | 0.05 | plate strip at key moment | +y | E | A-pair | 1.7
K1 | 87.19 | 35.77 | B1 | SLSWS | -0.4 | 0.0 | 3.6 | 0.2 | 0.0 | 3.6 |  |  | +y | E | A-pair
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
