loka92/test1strsteel/roof/design/C/members_C.csv

id | type | section | length | frm | to | N_Ed | M_Ed | V_Ed | u_M | u_V | u_LTB_g | u_LTB_up | u_defl | utilisation | governing | verdict
T2/R78-R82 | trimmer | IPE 240 | 4.07 | R78 | R82 | 0.0 | 1.7 | 1.7 | 0.02 | 0.01 | 0.03 | 0.02 | 0.01 | 0.03 | LTBg | OK
P_NOTCH/R78-K21 | eave beam | IPE 300 | 4.07 | R78 | K21 | 0.0 | 2.0 | 2.0 | 0.01 | 0.0 | 0.02 | 0.01 | 0.01 | 0.02 | LTBg | OK
R68/K25-K19 | rafter | IPE 240 | 5.89 | K25 | K19 | 0.0 | 12.3 | 8.6 | 0.12 | 0.03 | 0.08 | 0.14 | 0.09 | 0.14 | LTBu | OK
R68/K19-K15 | rafter | IPE 240 | 4.61 | K19 | K15 | 0.0 | 5.2 | 4.5 | 0.05 | 0.01 | 0.05 | 0.06 | 0.04 | 0.06 | LTBu | OK
R68/K15-K8 | rafter | IPE 240 | 3.0 | K15 | K8 | 0.0 | 2.2 | 2.9 | 0.02 | 0.01 | 0.02 | 0.02 | 0.01 | 0.02 | LTBu | OK
R68/K8-K6 | rafter | IPE 240 | 5.8 | K8 | K6 | 0.0 | 12.0 | 8.5 | 0.12 | 0.03 | 0.07 | 0.14 | 0.07 | 0.14 | LTBu | OK
R70/P_K25K26-P_K19K20 | rafter | IPE 240 | 5.89 | P_K25K26 | P_K19K20 | 0.0 | 14.6 | 10.1 | 0.14 | 0.03 | 0.14 | 0.17 | 0.14 | 0.17 | LTBu | OK
R70/P_K19K20-P_K8K9 | rafter | IPE 240 | 7.56 | P_K19K20 | P_K8K9 | 0.0 | 21.3 | 11.5 | 0.21 | 0.04 | 0.22 | 0.25 | 0.28 | 0.28 | defl | OK
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
