loka92/test1strsteel/roof/design/C/reactions_C.csv

column | x | y | braced_bays | case | N_kN | Vx_kN | Vy_kN | Vcross_x | Vcross_y | V_total | base_util | base_gov | near_edges | base_type | keys | psi_ec | max_anchor_kN | min_zone_mm
K1 | 87.19 | 35.77 | B1 | ULS1 | 25.9 | 0.0 | 0.0 | 0.0 | 0.0 | 0.0 | 0.04 | bearing | +y | E | A-pair | 1.0 | 0.0 | 0
K1 | 87.19 | 35.77 | B1 | SLS | 18.4 | 0.0 | 0.0 | 0.0 | 0.0 | 0.0 |  |  | +y | E | A-pair
K1 | 87.19 | 35.77 | B1 | ULS2N | 30.8 | 0.0 | -15.6 | 2.5 | 0.0 | 15.8 | 0.16 | plate strip at key moment | +y | E | A-pair | 1.0 | 0.0 | 0
K1 | 87.19 | 35.77 | B1 | ULS3N | -37.6 | 0.0 | -15.6 | 2.5 | 0.0 | 15.8 | 0.28 | E rebar bond in the column head, embed 250 min (N_Rd 136) | +y | E | A-pair | 1.0 | 9.4 | 0
K1 | 87.19 | 35.77 | B1 | SLSWN | -19.5 | 0.0 | -10.4 | 1.7 | 0.0 | 10.4 |  |  | +y | E | A-pair
K1 | 87.19 | 35.77 | B1 | ULS2S | 30.9 | 0.0 | 5.4 | 2.7 | 0.0 | 6.0 | 0.08 | E key pair outward (c1 >= 255) | +y | E | A-pair | 1.0 | 0.0 | 0
K1 | 87.19 | 35.77 | B1 | ULS3S | -4.0 | 0.0 | 5.4 | 2.7 | 0.0 | 6.0 | 0.08 | E key pair outward (c1 >= 255) | +y | E | A-pair | 1.0 | 1.0 | 0
K1 | 87.19 | 35.77 | B1 | SLSWS | 2.9 | 0.0 | 3.6 | 1.8 | 0.0 | 3.6 |  |  | +y | E | A-pair
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
