loka92/test1strsteel/roof/design/A/reactions_A.csv

column | x | y | position | Nc_ULS_kN | Nt_ULS_kN | Vx_ULS_kN | Vy_ULS_kN | Vy_toward_edge_ULS_kN | Nc_SLS_kN | Nt_SLS_kN | Vx_SLS_kN | Vy_SLS_kN | combo_Nc | combo_Nt | anchor_util
K1 | 87.19 | 35.77 | edge | 33.7 | 31.9 | 27.4 | 29.6 | 23.9 | 23.5 | 19.8 | 18.3 | 19.8 | ULS2_S0 | ULS3_N | 0.6
K2 | 92.48 | 35.77 | edge | 28.6 | 28.0 | 27.4 | 23.7 | 19.8 | 20.0 | 15.6 | 18.3 | 15.8 | ULS2_S0 | ULS3_R | 0.59
K3 | 81.89 | 35.67 | edge | 29.0 | 29.1 | 27.4 | 21.5 | 16.1 | 20.5 | 12.9 | 18.3 | 14.3 | ULS2_S0 | ULS3_R | 0.46
K4 | 95.59 | 35.67 | corner | 17.3 | 13.0 | 12.6 | 8.0 | 8.0 | 12.3 | 7.4 | 8.4 | 5.2 | ULS2_S0 | ULS3_N | 0.19
K5 | 72.09 | 35.27 | edge | 29.5 | 25.9 | 27.4 | 25.7 | 19.2 | 20.6 | 16.0 | 18.3 | 17.1 | ULS2_S0 | ULS3_N | 0.57
K6 | 67.99 | 35.17 | corner | 21.5 | 41.6 | 27.4 | 9.4 | 8.6 | 15.3 | 15.5 | 18.3 | 6.2 | ULS2_R | ULS3_R | 0.79
K7 | 77.79 | 35.17 | edge | 30.2 | 25.4 | 27.4 | 20.4 | 15.4 | 21.4 | 12.4 | 18.3 | 13.5 | ULS2_R | ULS3_R | 0.47
K8 | 67.99 | 29.37 | edge | 29.8 | 25.9 | 18.1 | 3.4 | 11.5 | 21.3 | 9.1 | 12.1 | 1.8 | ULS1- | ULS3_R | 0.37
K9 | 72.09 | 29.27 | interior | 98.7 | 95.5 | 0 | 21.6 | 0 | 68.7 | 57.4 | 0 | 13.8 | ULS1- | ULS3_N | 0.37
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
