loka92/test1strsteel/roof/offer/pricing_internal_RevB.md

# Internal pricing of offer RTV-2026-01 Rev B (design Rev 7, invoice-based cost, 25 % margin) - not for the client

| Cost item | Basis | LYD |
|---|---|---|
| Steel sections, 14.4 t bought | supplier quotation 11486 unit prices, 12 m bar cutting plan | 121,365 |
| Plates, keys, rebars, bolts, 2.5 t | assumed 7,500 LYD/t (not on the quotation) | 18,535 |
| Fabrication, drilling, welding, coating, transport | 30 % of the steel material (assumption, fabricator to confirm) | 41,970 |
| Column and beam assembly | 10 % of the sections cost | 12,137 |
| Roof PIR panels 316 m2 + 5 % laps and flashings | 150 LYD/m2 | 49,770 |
| Gutters, downpipes, flashings (north) | allowance | 12,000 |
| Base works: scans, 80 rebar holes, 26 key pockets + 3 post keys, grout, pull-out tests | allowance | 18,500 |
| **Total cost** | | **274,277** |
| Profit margin | 25 % of the total cost | 68,569 |
| **Offer price (rounded)** | | **343,000 LYD** |

Rev A (6,950 LYD/t all-in, 50 % margin): 284,000 LYD - withdrawn: the quotation shows bare material at about 8,400 LYD/t. The same 25 % margin on the Rev A cost basis would give 236,500 LYD, below the invoice-based cost of 274,277 LYD.
Payment: 171,500 advance / 85,750 at erection start / 85,750 at handover. Valid 15 days to 14 October 2026. Warranty 12 months.
Generated by make_offer_rev8.py (pricing_internal_RevB.json holds the same numbers).
