loka92/test1strsteel/roof/offer/Steel_sections_list_4col_EN_AR.pdf

## STEEL SECTIONS LIST

Steel roof - Administration Building,

## Regatta Tourist Village, Tripoli

## قائمة القطاعات الحديدية السقف الحديدي - المبنى الإداري قرية ريقاطة السياحية، طرابلس

Design Rev 6a, drawings RTV-ST-S00 to S06, 29 Sep 2026. Issued by Eng. MALEK ABOZRAIG, malek.abozraig@gmail.com.

S06 | إلى RTV-ST-S00 | الرسومات | ،6a | مراجعة | التصميم
29 سبتمبر 2026 - إعداد: م. مالك أبوزريق
No. م | Section القطاع | Grade الدرجة | Total length الطول الإجمالي
1 | HEA 140 | S275 JR | 99.9 m
2 | IPE 300 | S275 JR | 82.7 m
3 | IPE 330 | S275 JR | 9.8 m
4 | IPE 240 | S275 JR | 204.4 m
5 | Z 200 x 2.0 cold-formed | S350GD + Z275 | 571 m
6 | L 70 x 70 x 7 | S275 JR | 103.8 m
7 | Round bar M24, threaded | Grade 8.8 | 188.6 m
8 | SHS 90 x 90 x 8 | S275 J0H | 7.0 m
9 | Round bar dia 60 | S355 J2 | 1.5 m
10 | Rebar dia 16, threaded end | B500B | 63 m
11 | Plates 8 to 20 mm | S275 JR | by weight
| Total الإجمالي | | 1,332 m, 17.8 t

Lengths are net member lengths from the member schedule; add cutting and connection allowances for ordering. Plates, keys and anchors add 3.3 t; the bill-of-materials total is 22.2 t. Hot-dip galvanised to EN ISO 1461 or shop-primed and painted as agreed; cold-formed sections pre-galvanised Z275.

الأطوال صافية من جدول العناصر؛ تضاف نسبة للقطع والوصلات عند الطلب. الصفائح والمفاتيح والأسياخ تضيف 3.3 طن؛ إجمالي جدول الكميات 22.2 طن. جلفنة بالغمس الساخن وفق 1461 ISO EN أو دهان بالورشة حسب الاتفاق؛ القطاعات المشكلة على البارد مجلفنة مسبقا 275Z.
