loka92/test1strsteel/roof/offer/Sections_and_quantities_EN_AR.pdf

## SECTIONS AND QUANTITIES - STEEL ROOF, ADMINISTRATION BUILDING, REGATTA TOURIST VILLAGE, TRIPOLI

## جدول القطاعات والكميات - السقف الحديدي المبنى الإداري، قرية ريقاطة السياحية، طرابلس

Design Rev 6a, drawings RTV-ST-S00 to S06 (29 Sep 2026). Issued by Eng. MALEK ABOZRAIG, malek.abozraig@gmail.com. Steel S275 hot-dip galvanised or shop-primed; roofed area 439 m2; footprint 486 m2.

التصميم مراجعة a،6 الرسومات 00S-ST-RTV إلى 29) 06S سبتمبر 2026). إعداد: م. مالك أبوزريق. الحديد 275S مجلفن بالغمس الساخن أو مدهون بالورشة. مساحة السقف 439 م2؛ مساحة المسقط 486 م.2

No. | Element | العنصر | Section / grade | Pieces | Length m | Weight t | Remarks
1 | Columns (one on each existing concrete column) | ( القائمة الخرسانية الأعمدة فوق ( الأعمدة | HEA 140, S275 | 27 | 95.7 | 2.36 | L = TOS - 0.335 m, cut to the surveyed level
2 | Wind post at the notch corner | التجويف زاوية عند الرياح عمود | HEA 140, S275 | 1 | 4.2 | 0.10
3 | Primary beams on the column rows | الأعمدة صفوف على الرئيسية الكمرات | IPE 300, S275 | 12 | 61.7 | 2.60 | level, on cap plates
4 | Primary beam P13 (K19 - K20, 9.8 m) | (م 9.8 بحر (P13 الرئيسية الكمرة | IPE 330, S275 | 1 | 9.8 | 0.48
5 | Eave beams | الطنف كمرات | IPE 300, S275 | 6 | 21.0 | 0.89
6 | Rafters and edge beams | الحافة وكمرات المائلة العوارض | IPE 240, S275 | 31 | 190.5 | 5.85 | single plane, 6 % falling north
7 | Trimmer T2 at the lift well | T2 المصعد فتحة تحديد كمرة | IPE 240, S275 | 1 | 4.1 | 0.13
8 | Roof truss posts ST1, ST2 | ST2 و ST1 السقف شكالات قوائم | IPE 240, S275 | 2 | 9.8 | 0.30
9 | Roof purlins @ 1.5 m | م 1.5 كل السقف مدادات | Z 200 x 2.0, S350GD galvanised | | 300.0 | 1.77 | with anti-sag rows and fly braces
10 | Wall girts | الجدران مدادات | Z 200 x 2.0, S350GD galvanised | | 271.0 | 1.60 | for the wall panels (panels excluded)
11 | Wall X-bracing, 8 bays x 2 diagonals | 2 × حيزات X، 8 الجدران شكالات | L 70 x 70 x 7, S275 | 16 | 103.8 | 0.77 | tension-only, gusset plates 10 mm
12 | Roof plane bracing, 13 panels x 2 rods | 2 × لوح 13 ، السقف شكالات قضبان | M24 rods, grade 8.8, turnbuckles | 26 | 188.6 | 0.67
13 | Base plates | القواعد صفائح | 300 x 400 x 20 (edge bases per schedule), S275 | 28 | | 0.55 | grout bed 25 mm
14 | Post-installed anchor bars | المزروعة التثبيت أسياخ | dia 16 B500, threaded end, 550-600 mm | 108 | 63.0 | 0.10 | 4 per column into the column head, EAD 330087 resin
15 | Shear keys | القص مفاتيح | SHS 90 x 90 x 8 (37) and dia 60 bar (8) | 45 | | 0.20 | in cored pockets, grouted
16 | Cap plates, fin plates, gussets, cleats, stiffeners | والحوامل والأغطية الوصلات صفائح | S275 plates 8 - 20 mm | | | 2.42 | per S04 / S06
17 | Bolts | المسامير | M20 / M16 / M12 grade 8.8, hot-dip galvanised | | | | quantities per S06
18 | Roof sandwich panels | للسقف الساندوتش ألواح | PIR 50 mm, colour-coated steel both faces | | | | 439 m2 net + 5 % laps; flashings and well upstands
19 | Box gutters and downpipes | النزول ومواسير الصندوقية المزاريب | Gutter 150 x 100, 4 downpipes dia 100 | | | | 24 m gutter, 4 x 7.4 m downpipes
| Total structural steel (bill of materials | | | | | 22.2 إجمالي الحديد الإنشائي (أساس جدول الكميات) (basis | calculated take-off 20.8 t; BOM adds cut-length and connection allowances

Notes: lengths are net member lengths from the member schedule; pieces are erection pieces. Wall panels, their
fixings and the existing-structure verification are not included. Bolt, fastener and flashing quantities are on drawing S06.

ملاحظات: الأطوال هي الأطوال الصافية للعناصر من جدول العناصر؛ القطع هي قطع التركيب. لا تشمل ألواح الجدران وتثبيتاتها ولا التحقق من المبنى القائم. كميات المسامير والمثبتات والفلاشينج في الرسم 06S.
