loka92/test1strsteel/roof/offer/pricing_internal_RevA.md

# Internal pricing of offer RTV-2026-01 Rev A (design Rev 7) - not for the client

| Cost item | Basis | LYD |
|---|---|---|
| Steel supply, fabrication, erection, 14.7 t (girts excluded) | 6,950 LYD/t | 102,165 |
| Column and beam assembly | 10 % of the sections cost (9.8 t x 6,950 = 68,110) | 6,811 |
| Roof PIR panels 316 m2 + 5 % laps and flashings | 150 LYD/m2 | 49,770 |
| Gutters, downpipes, flashings (north, unchanged) | allowance | 12,000 |
| Base works: scans, 80 rebar holes, 26 key pockets + 3 post keys, grout, pull-out tests | allowance (25,000 x 20/27) | 18,500 |
| **Total cost** | | **189,246** |
| Profit margin | 50 % of the total cost | 94,623 |
| **Offer price (rounded)** | | **284,000 LYD** |

Previous issue (Rev 6a, 439 m2, 22.2 t): 404,000 LYD. Payment: 142,000 advance / 71,000 at erection start / 71,000 at handover. Valid 15 days to 14 October 2026. Warranty 12 months.
Generated by make_offer_rev7.py (pricing_internal_RevA.json holds the same numbers).
