loka92/test1strsteel/roof/offer/pricing_internal.md

# Internal pricing of offer RTV-2026-01 (not for the client)

| Cost item | Basis | LYD |
|---|---|---|
| Steel supply, fabrication, erection, 22.2 t | 6,950 LYD/t | 154,290 |
| Column and beam assembly | 10 % of the sections cost (12.8 t x 6,950 = 88,960) | 8,896 |
| Roof PIR panels 439 m2 + 5 % laps and flashings | 150 LYD/m2 | 69,142 |
| Gutters, downpipes, flashings | allowance | 12,000 |
| Base works: scans, 108 rebar holes, 37 key pockets, grout, pull-out tests | allowance | 25,000 |
| **Total cost** | | **269,328** |
| Profit margin | 50 % of the total cost | 134,664 |
| **Offer price (rounded)** | | **404,000 LYD** |

Payment: 202,000 advance / 101,000 at erection start / 101,000 at handover. Valid 15 days to 14 October 2026. Warranty 12 months.
Generated by make_offer.py (pricing_internal.json holds the same numbers).
