loka92/test1strsteel/roof/3d/elev_N.png

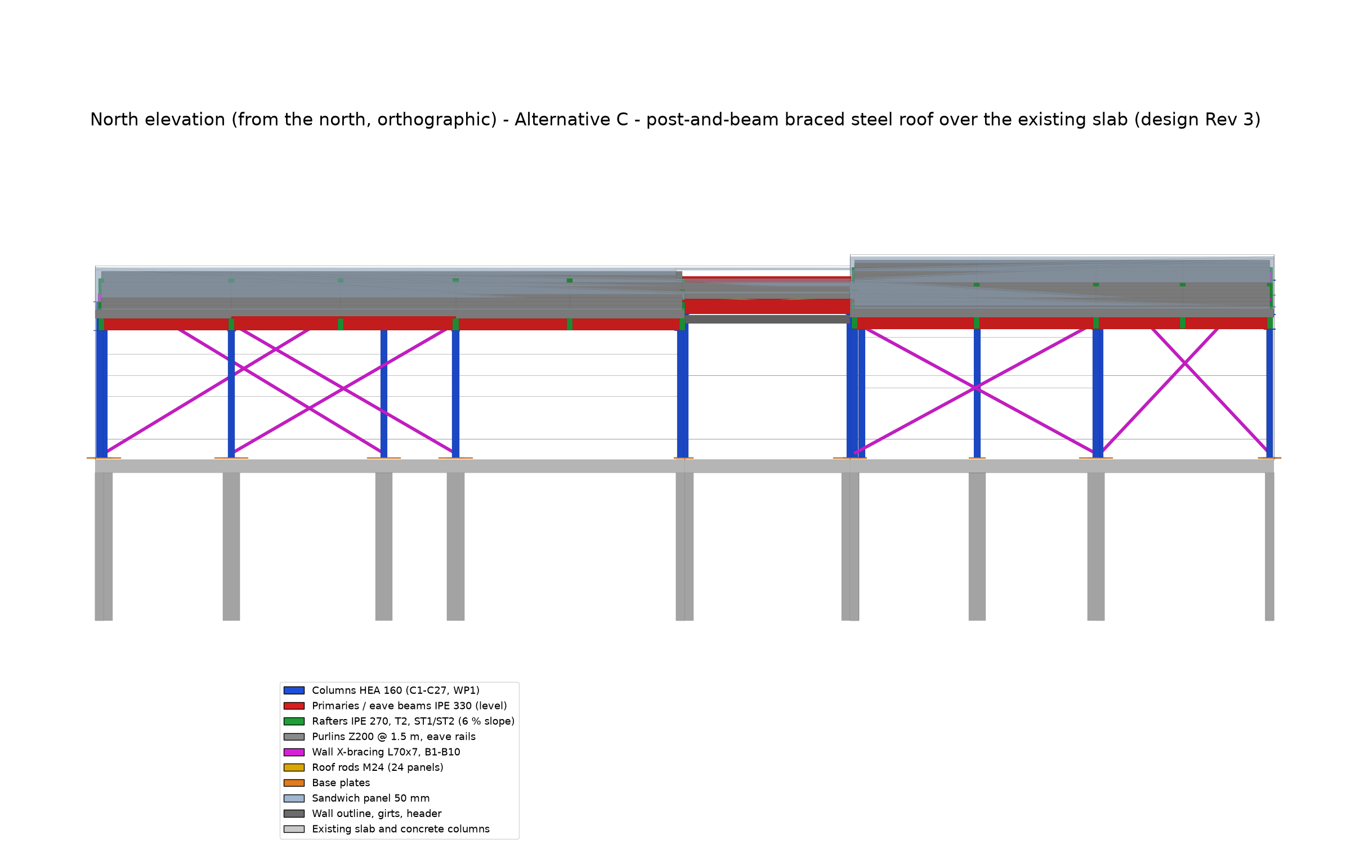
roof/3d/elev_N.png
