loka92/test1strsteel/roof/3d/elev_S.png

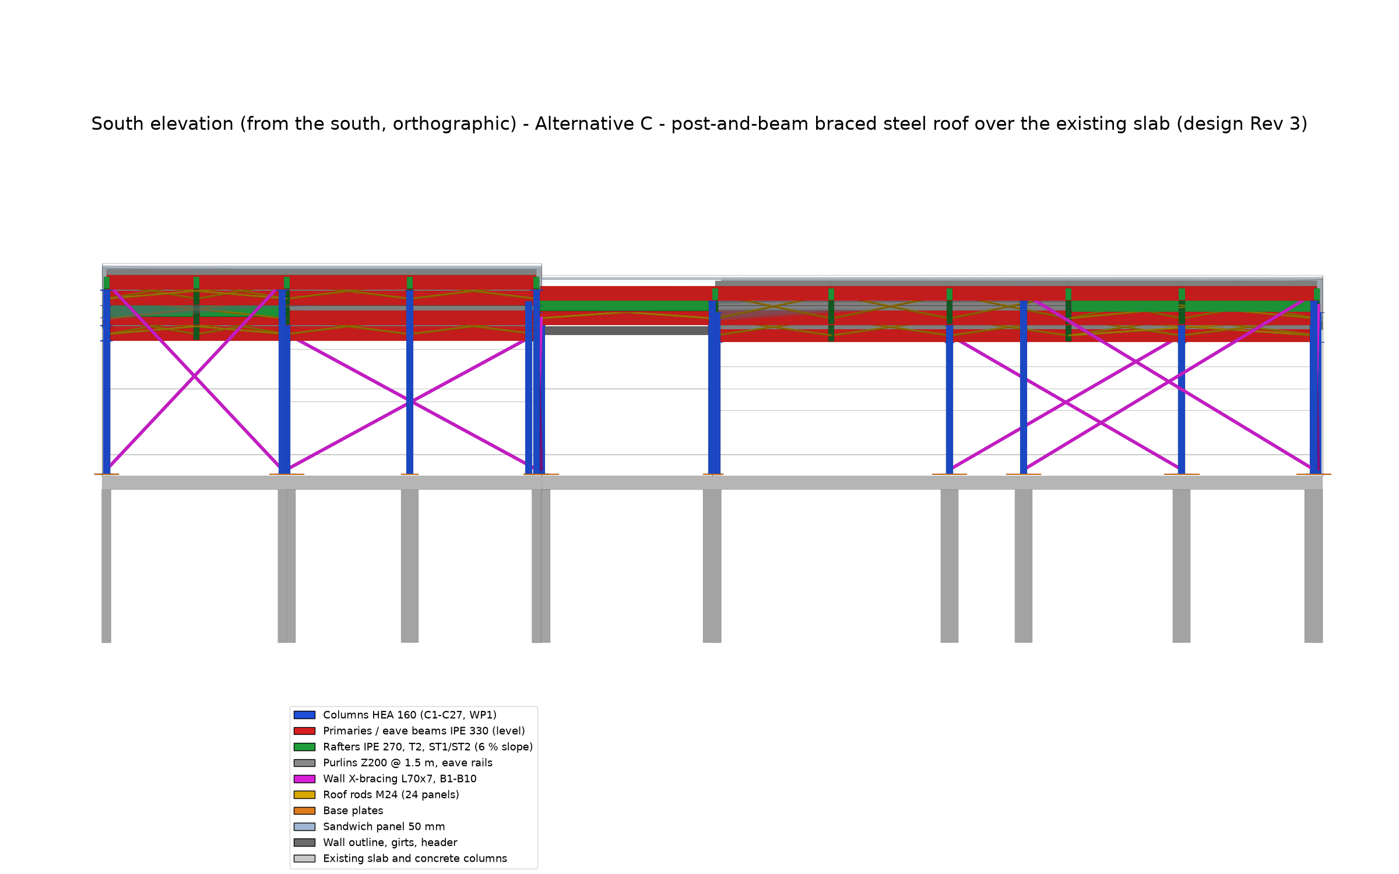
roof/3d/elev_S.png
