loka92/test1strsteel/roof/3d/iso_NE_no_panel.png

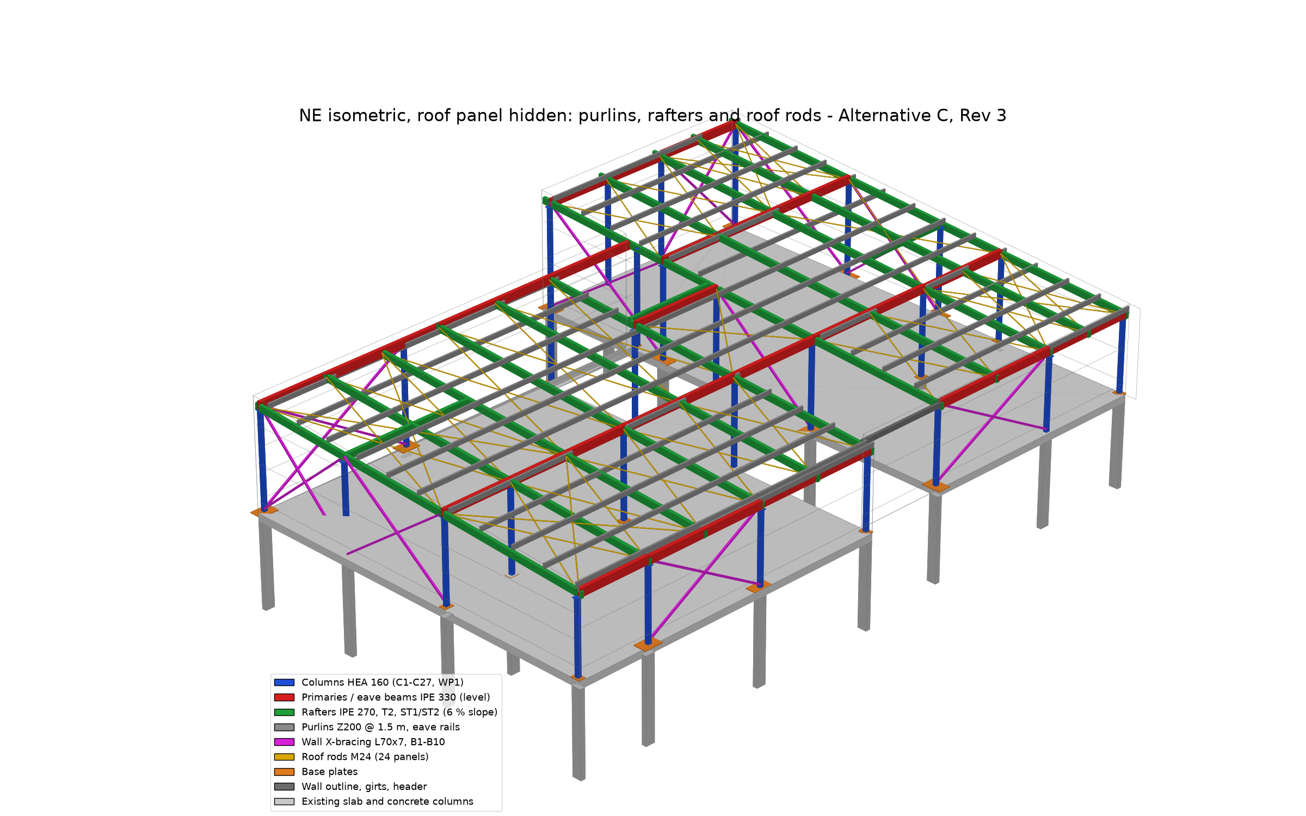
roof/3d/iso_NE_no_panel.png
