loka92/test1strsteel/roof/3d/iso_SE.png

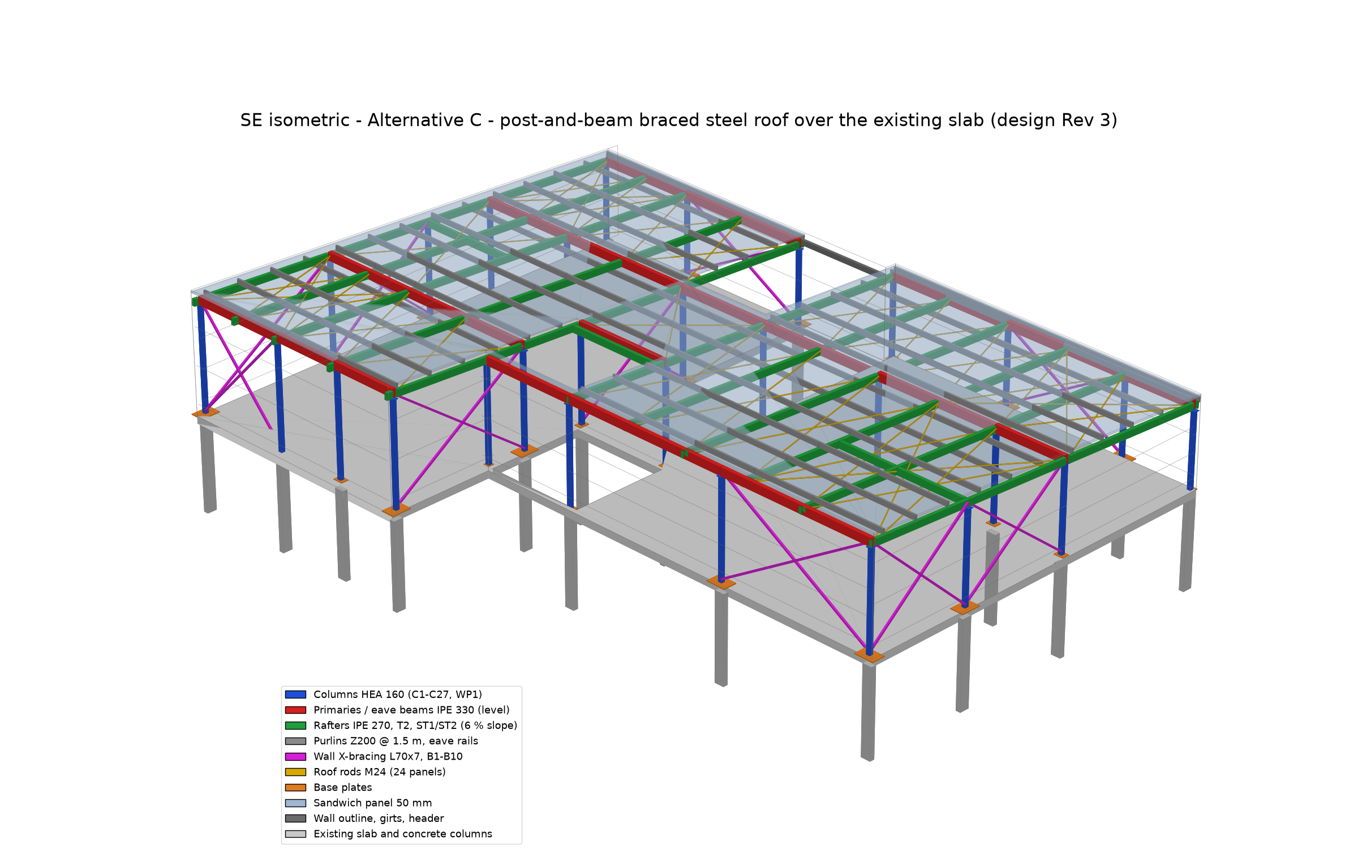
roof/3d/iso_SE.png
