loka92/test1strsteel/roof/3d/iso_SW.png

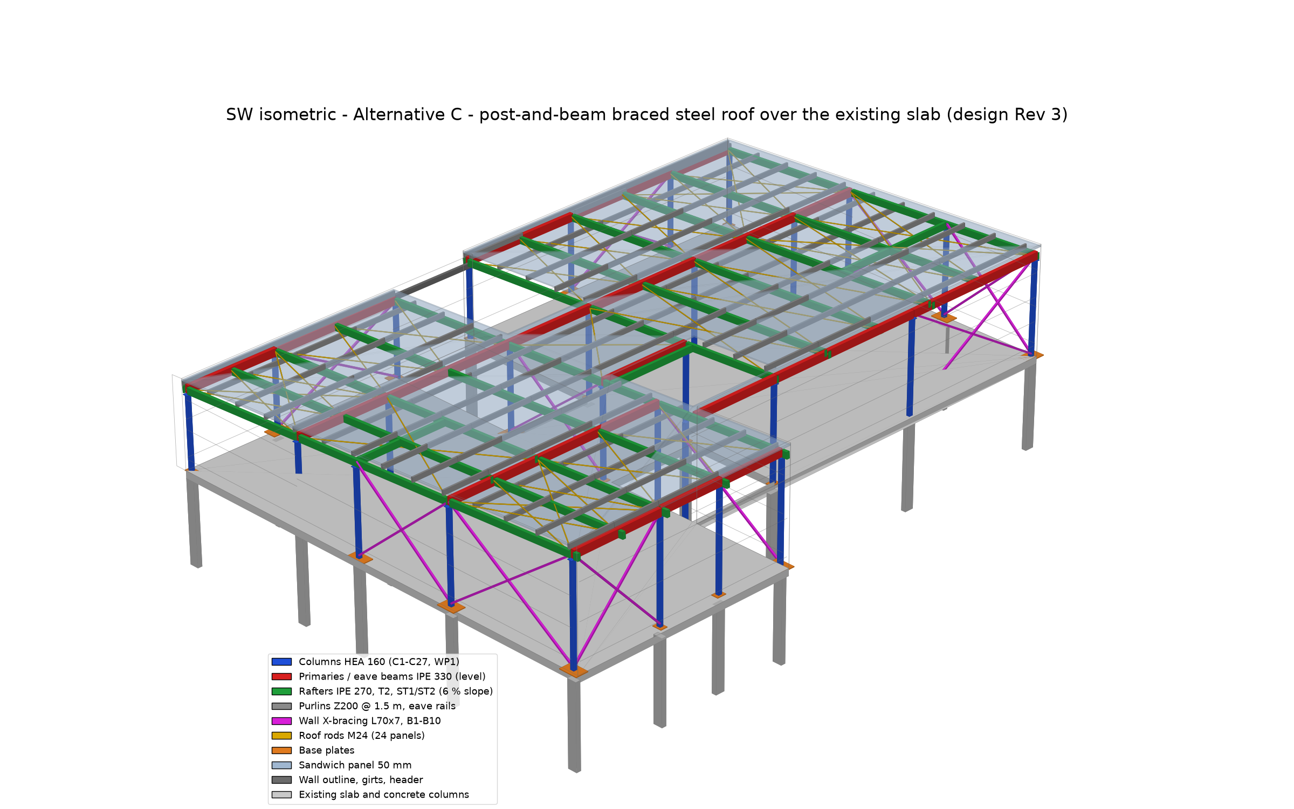
roof/3d/iso_SW.png
