loka92/test1strsteel/roof/3d/overview.png

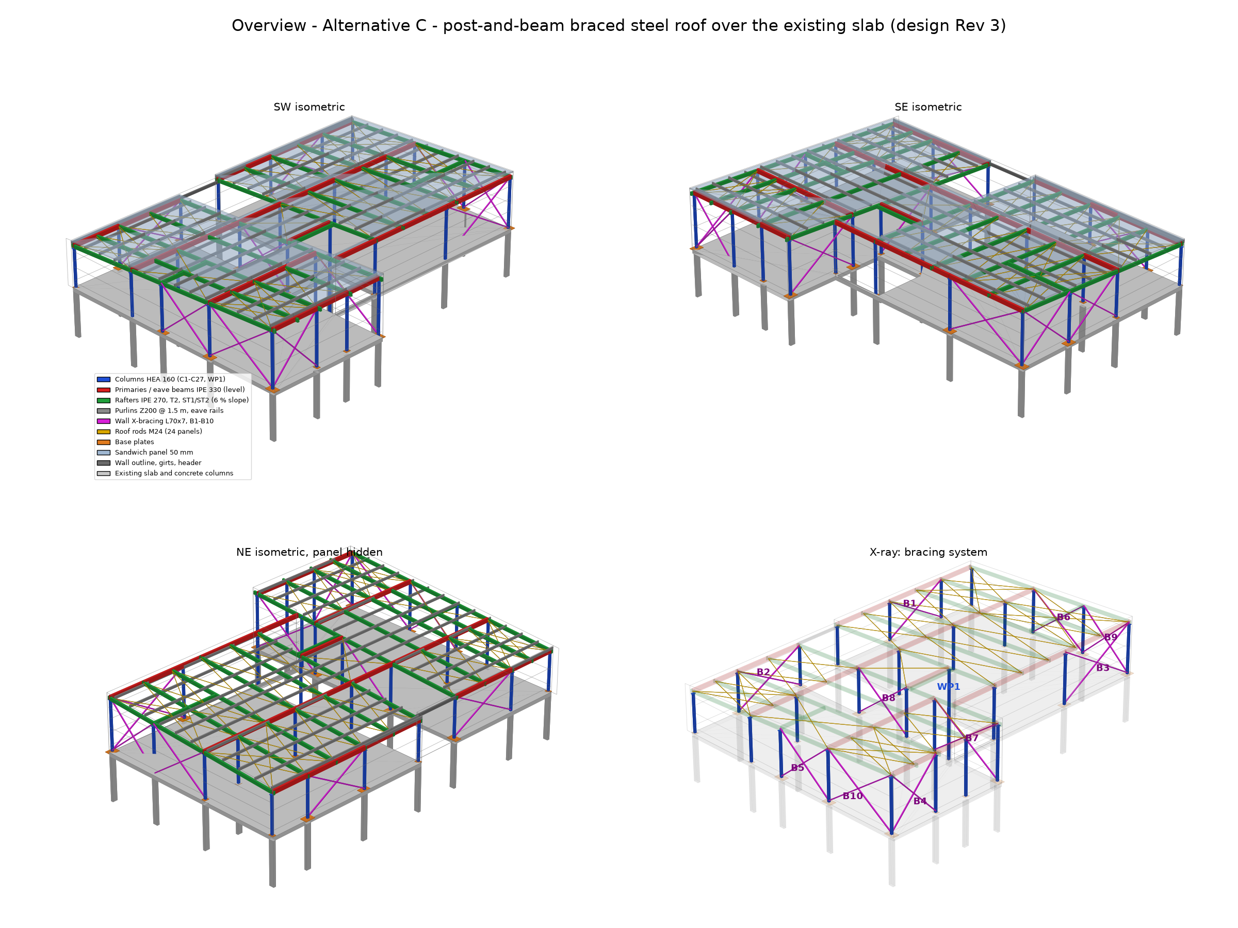
roof/3d/overview.png
