loka92/test1strsteel/roof/3d/section_xray.png

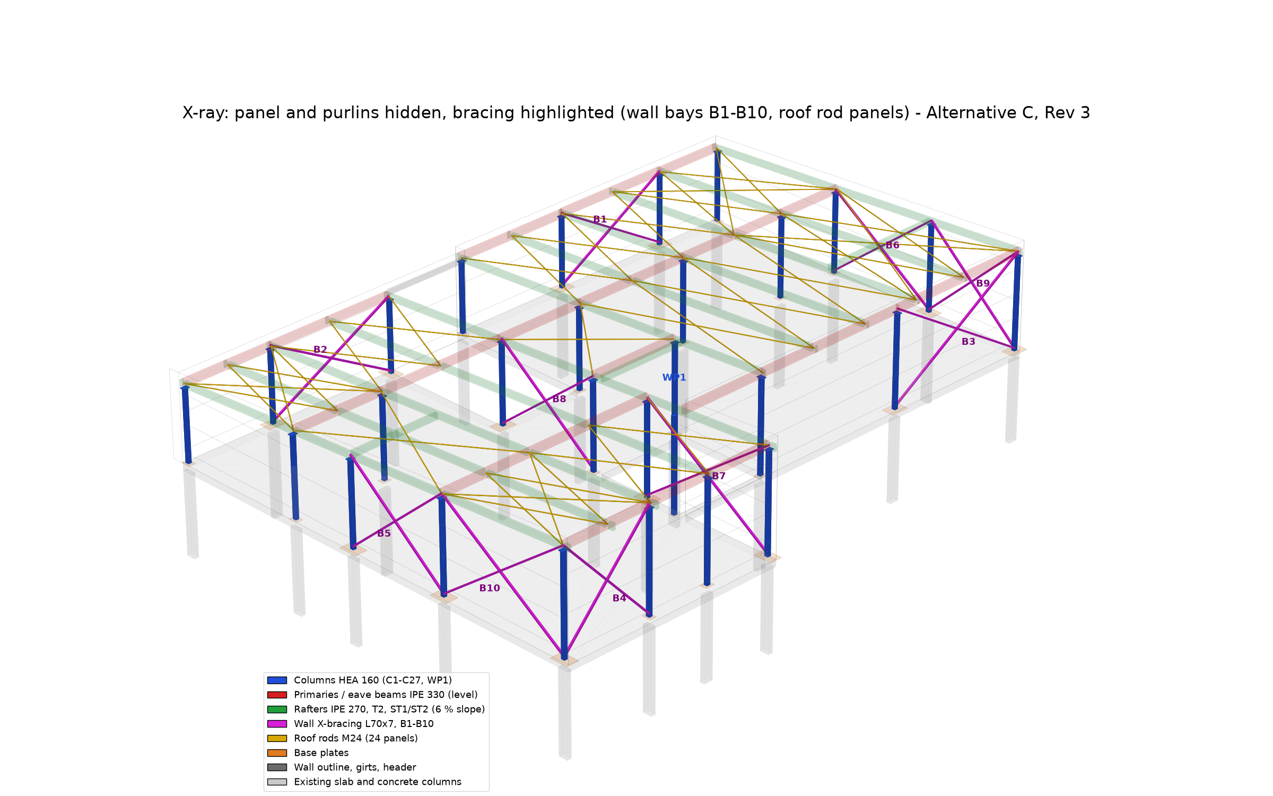
roof/3d/section_xray.png
