loka92/test1strsteel/roof/column_plan.png

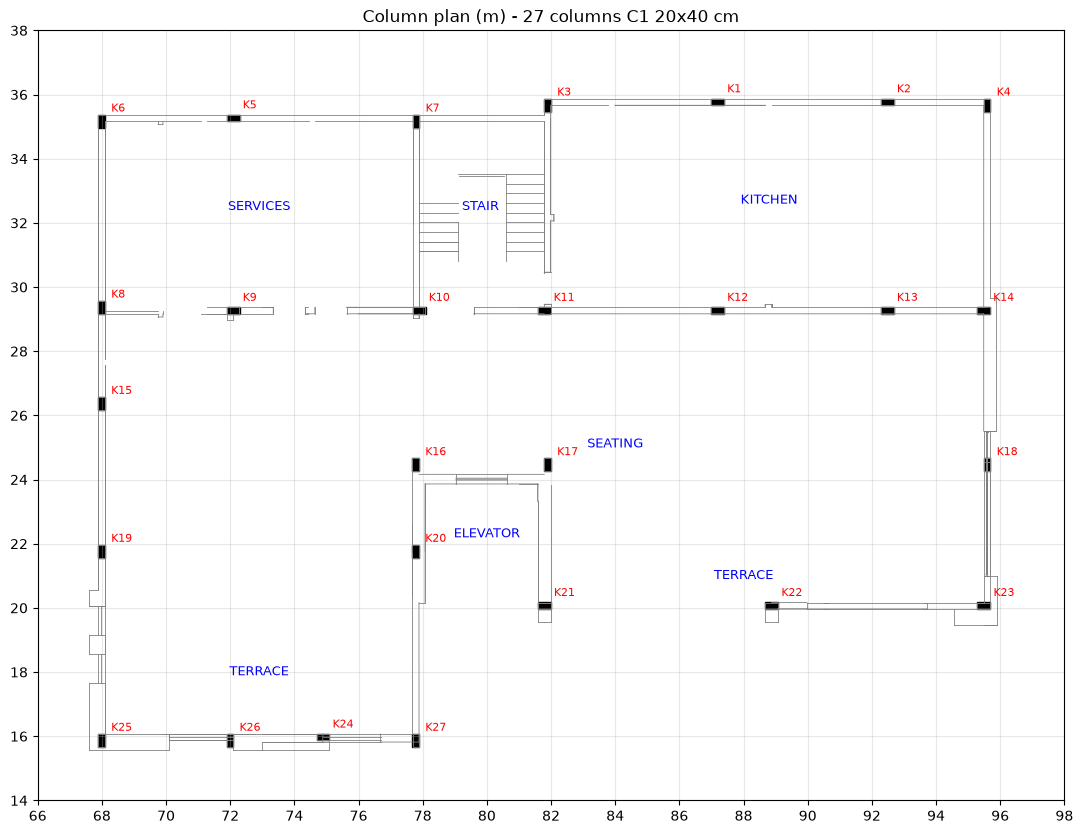
roof/column_plan.png
