loka92/test1strsteel/roof/design/A/frames_A.png

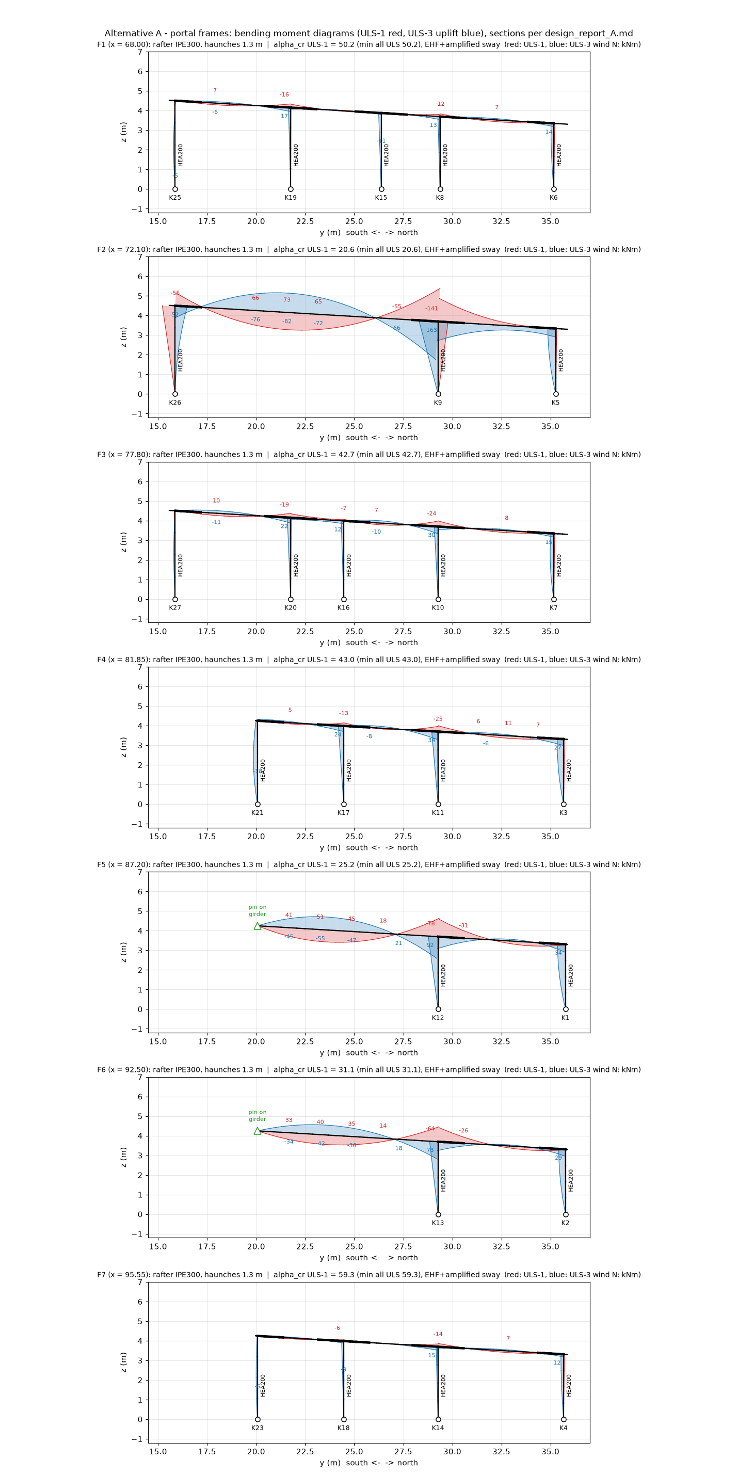
roof/design/A/frames_A.png
