loka92/test1strsteel/roof/design/C7/framing_C7.png

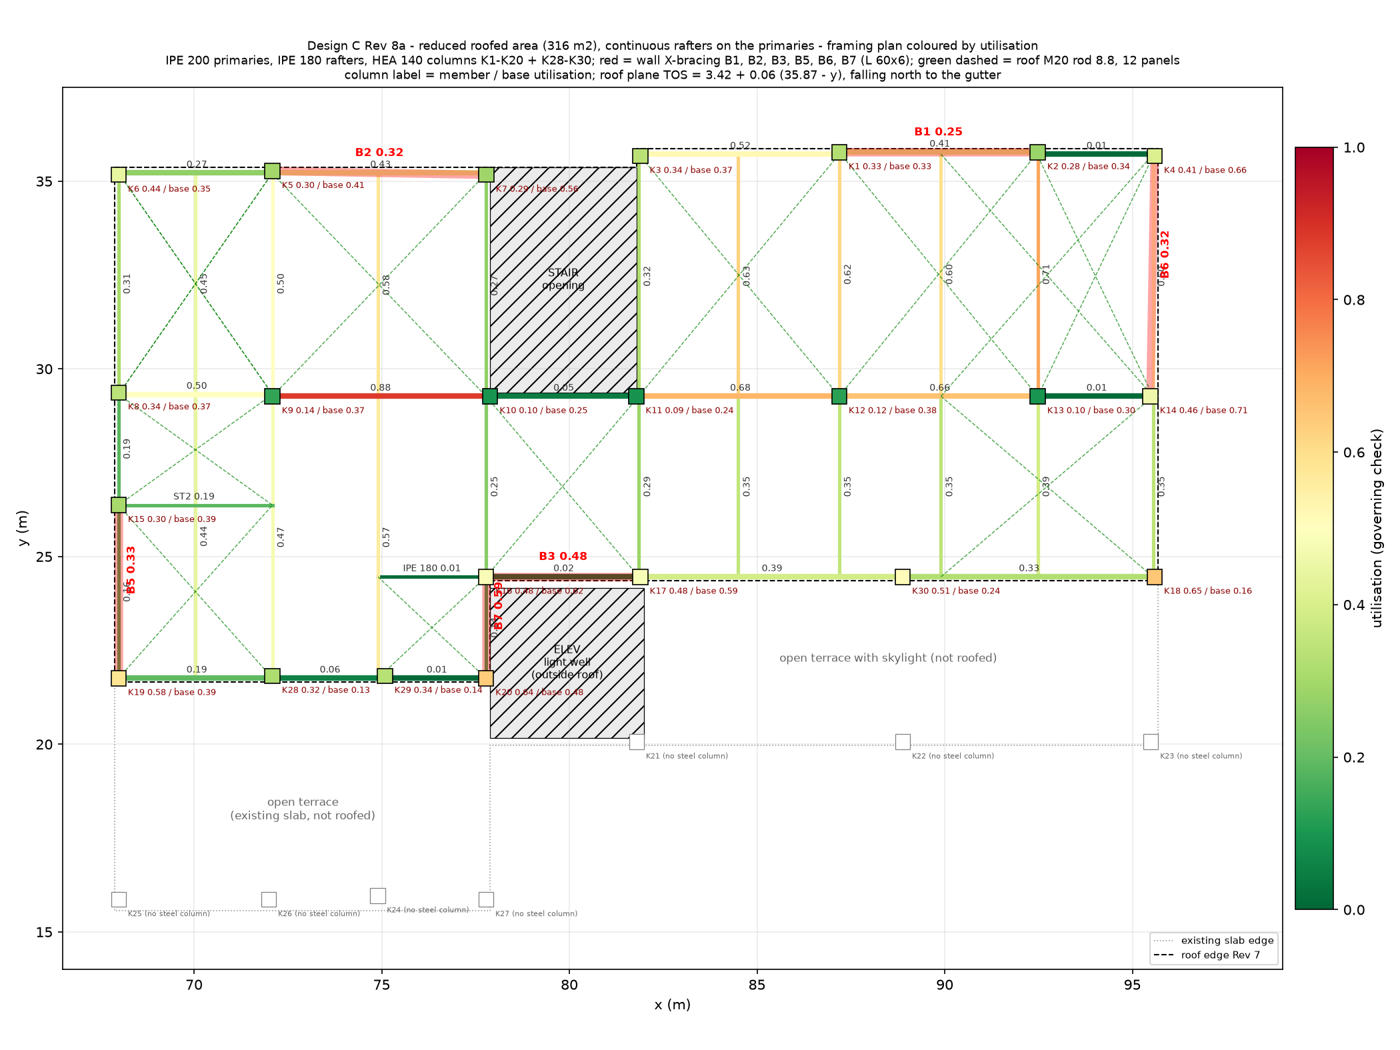
roof/design/C7/framing_C7.png
