loka92/test1strsteel/roof/design/C7/view3d_C7.png

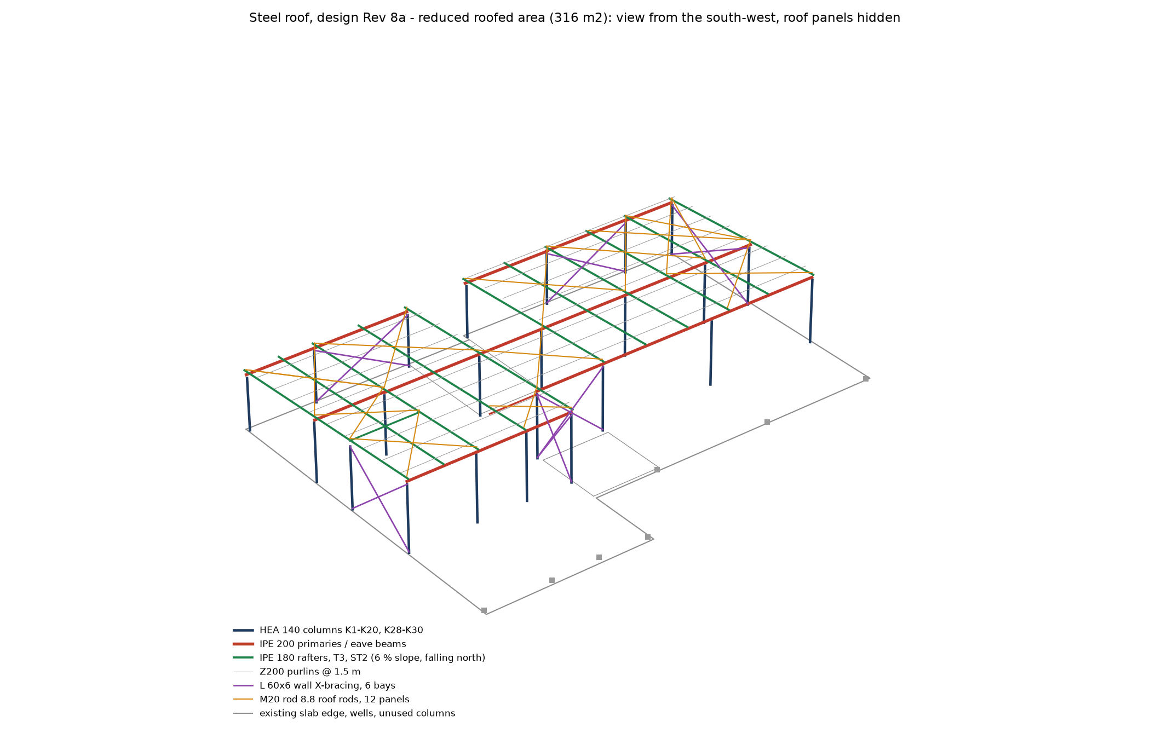
roof/design/C7/view3d_C7.png
