loka92/test1strsteel/roof/design/C/bracing_rev5.png

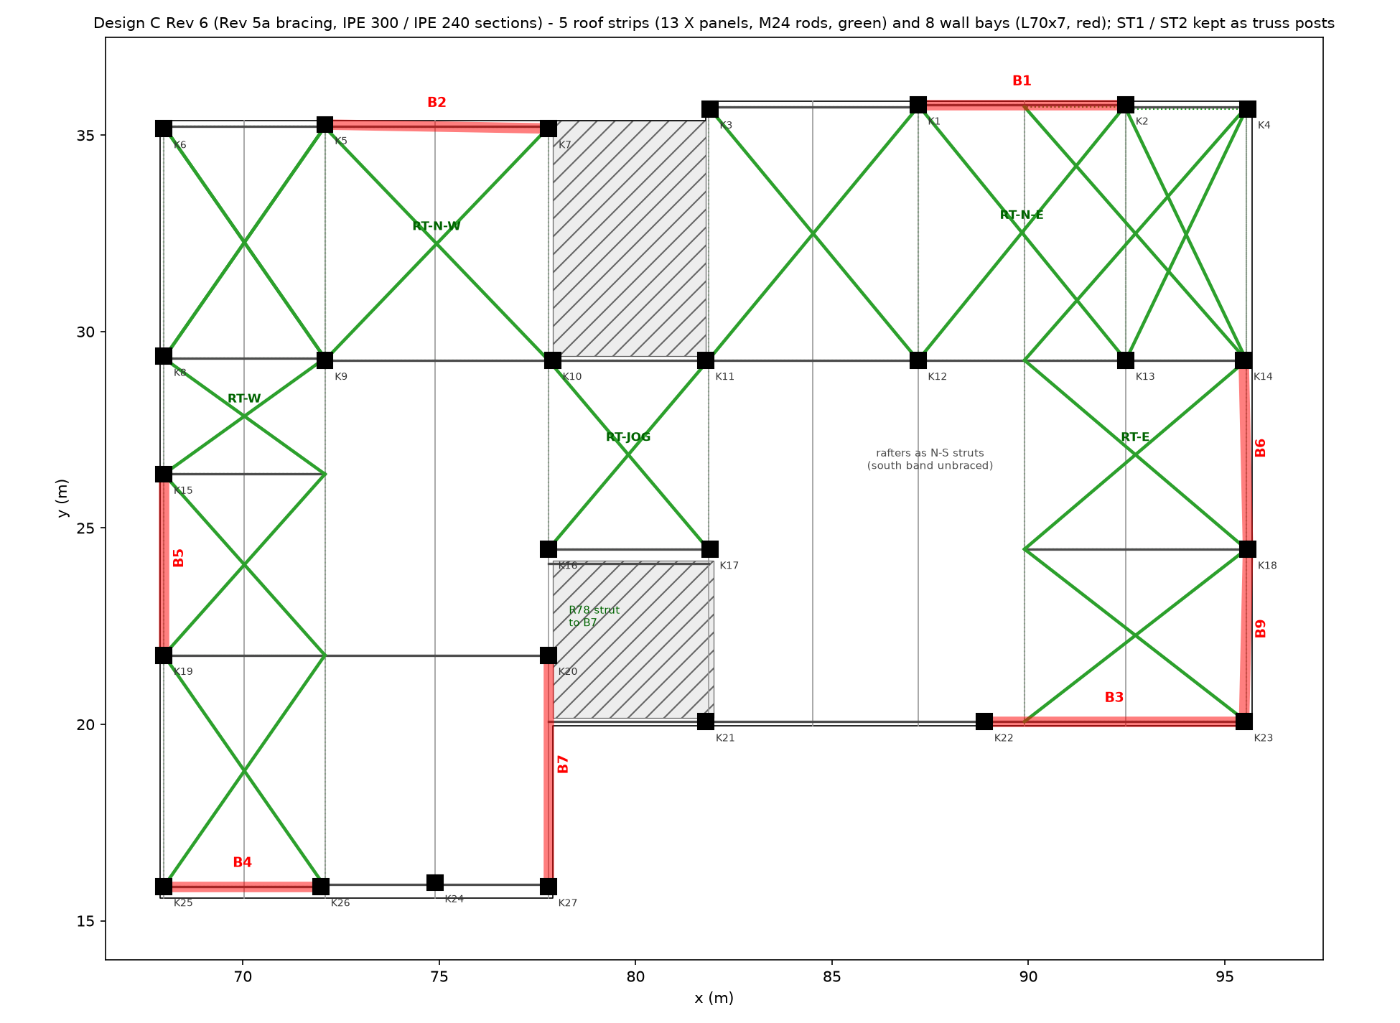
roof/design/C/bracing_rev5.png
