loka92/test1strsteel/roof/design/C/framing_C.png

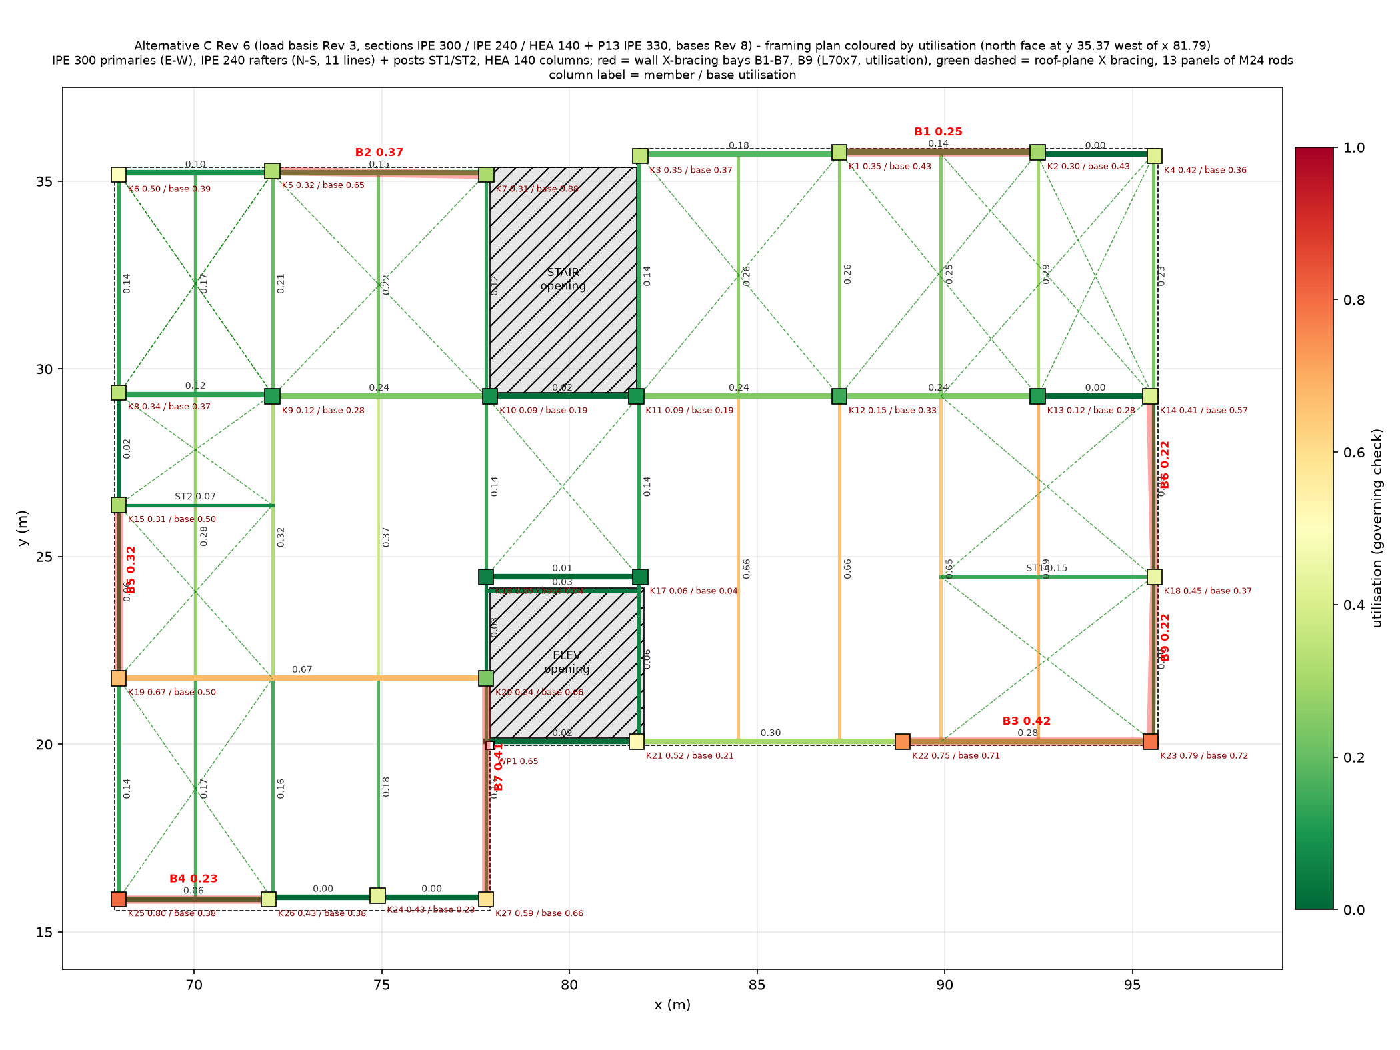
roof/design/C/framing_C.png
