loka92/test1strsteel/roof/detailing/pdf/preview_S01_A2.png

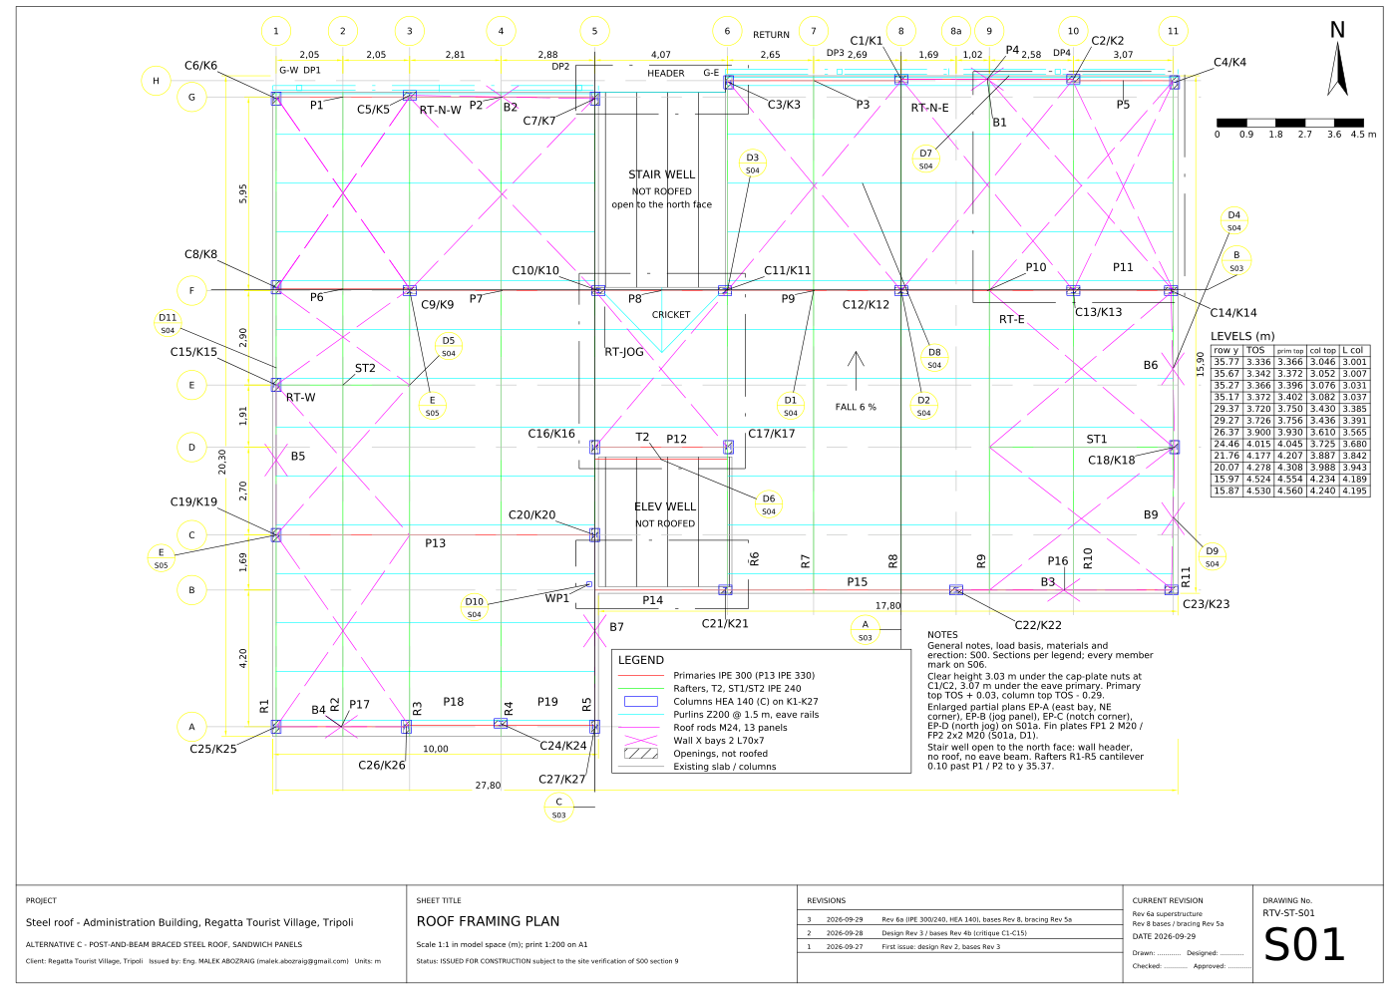
roof/detailing/pdf/preview_S01_A2.png
