loka92/test1strsteel/roof/detailing/S00.png

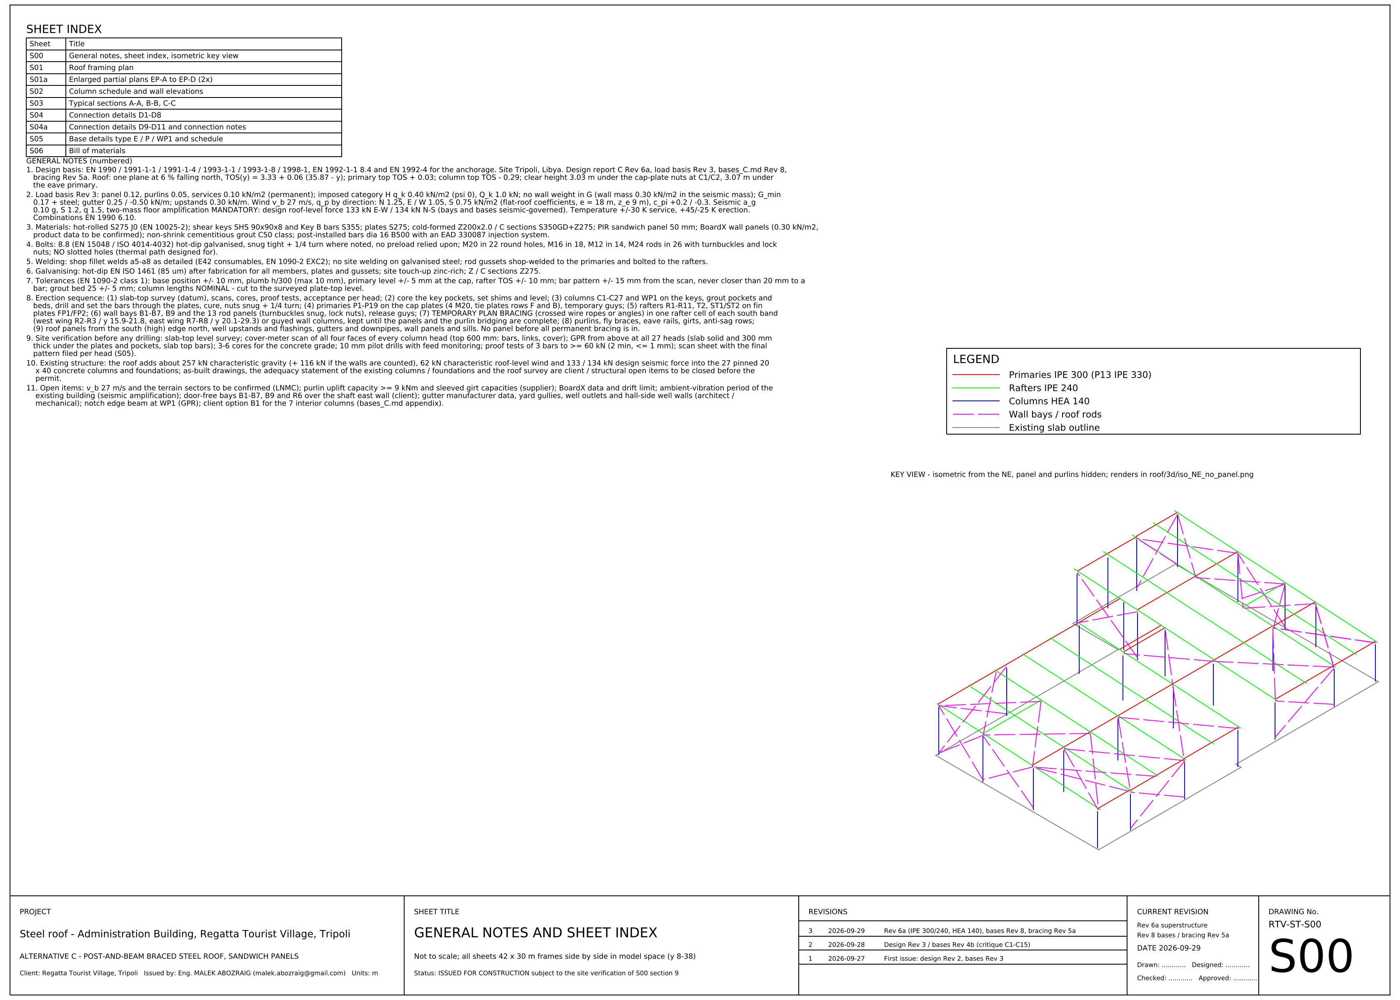
roof/detailing/S00.png
