loka92/test1strsteel/roof/detailing/S01a.png

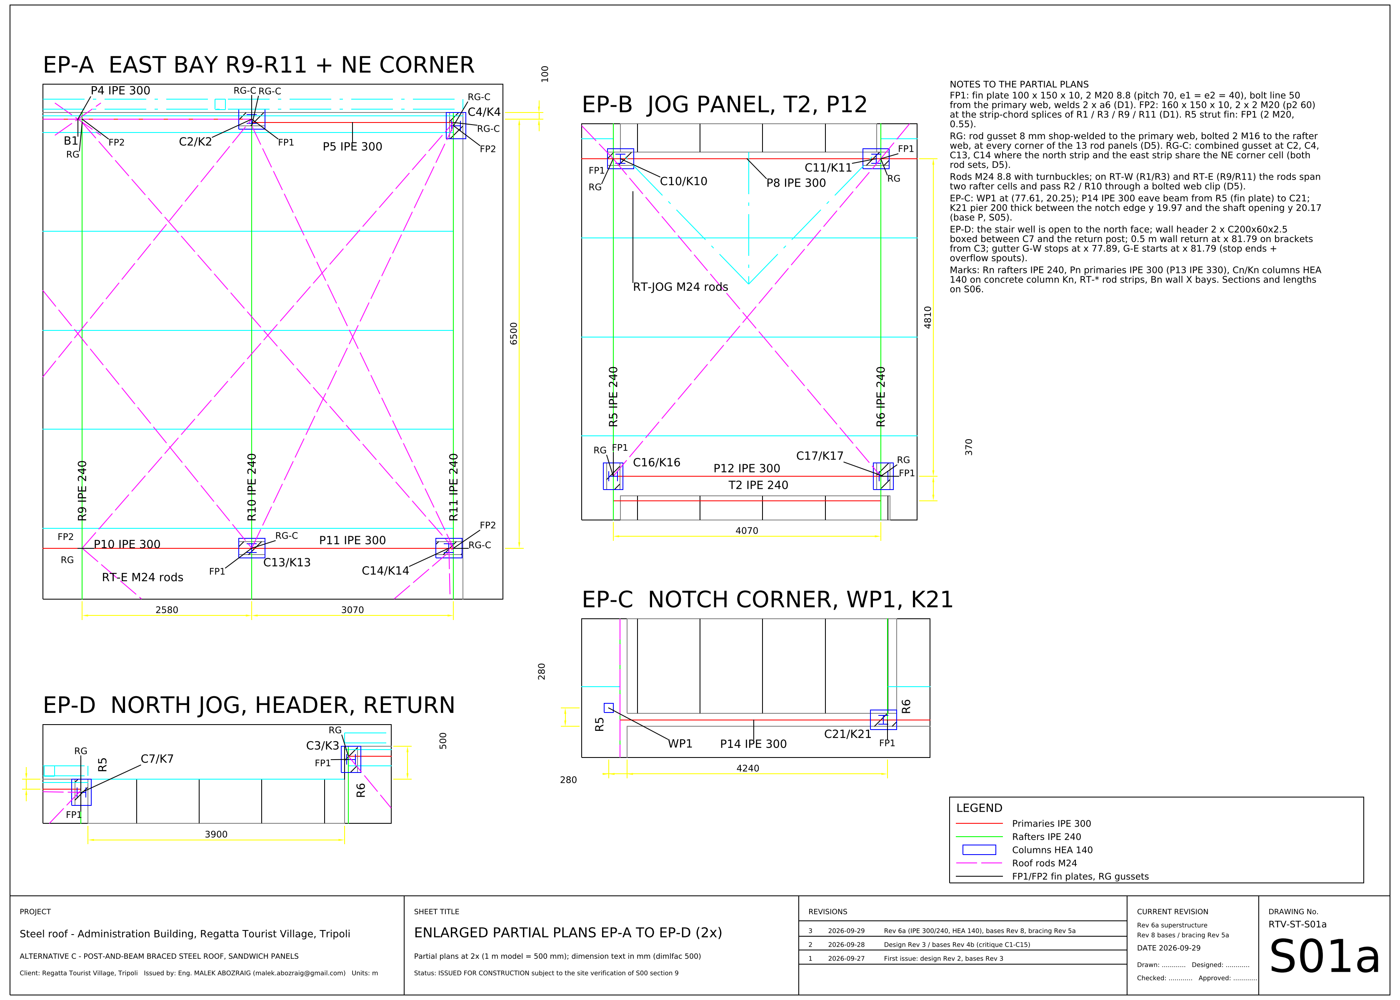
roof/detailing/S01a.png
