loka92/test1strsteel/roof/detailing/S02.png

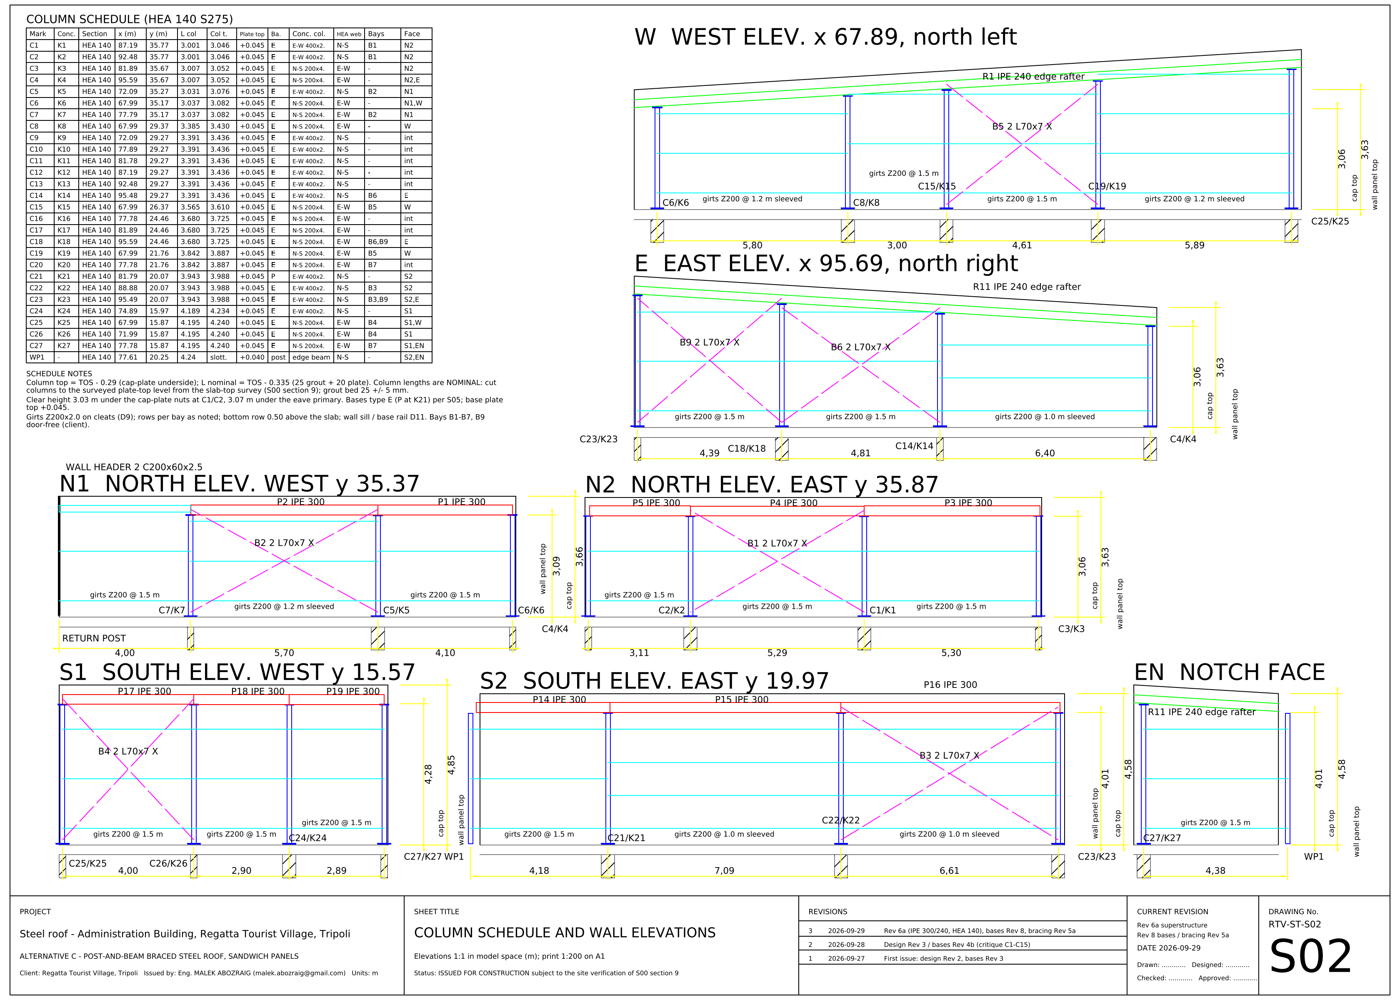
roof/detailing/S02.png
