loka92/test1strsteel/roof/detailing/S03.png

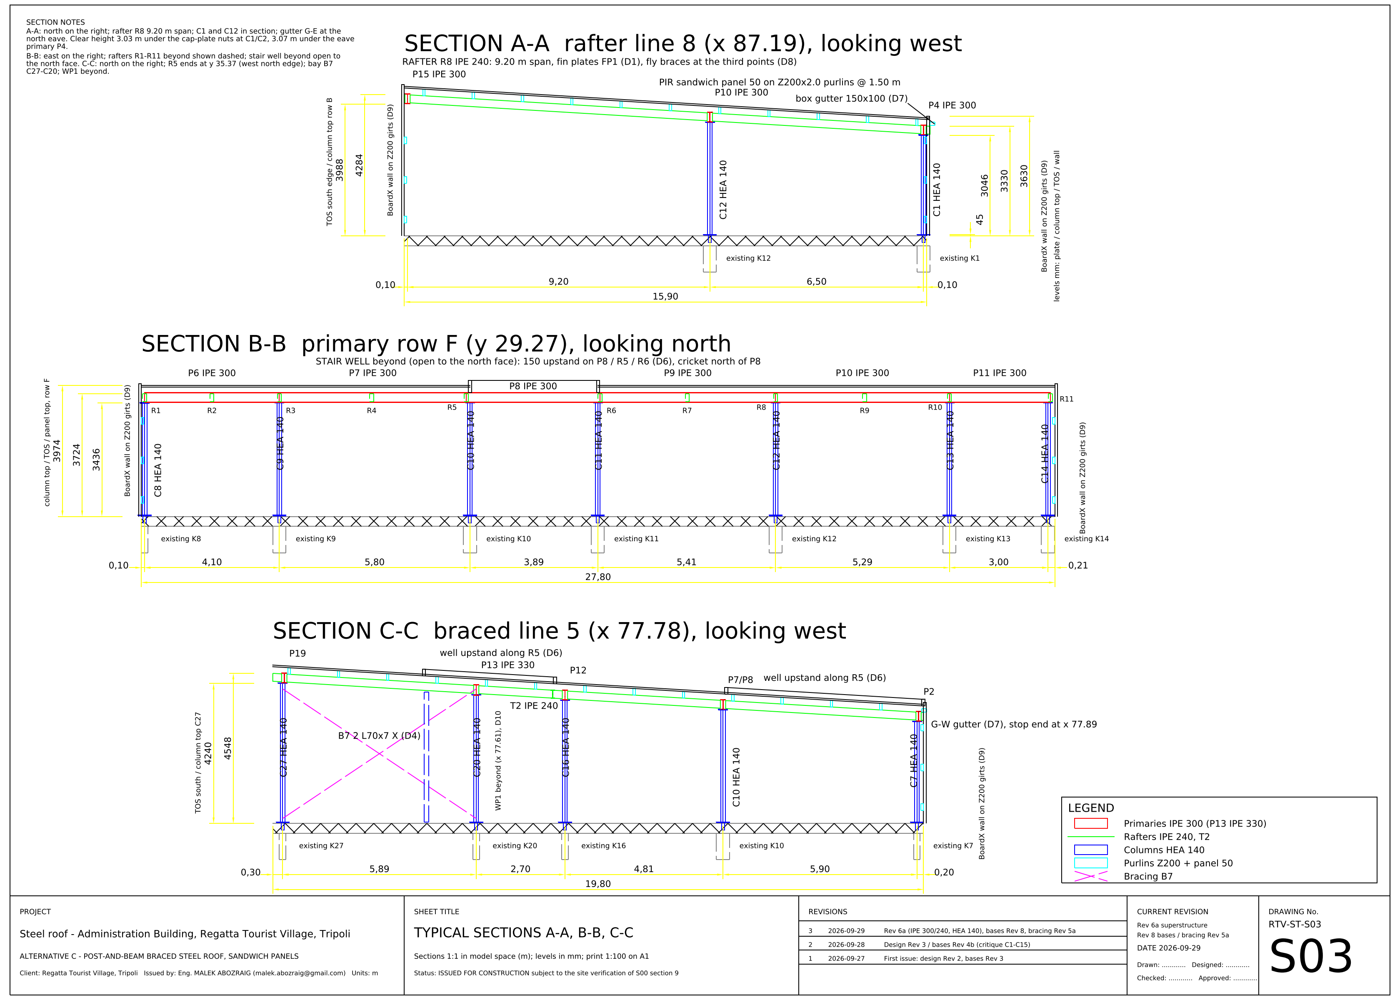
roof/detailing/S03.png
