loka92/test1strsteel/roof/detailing/S04.png

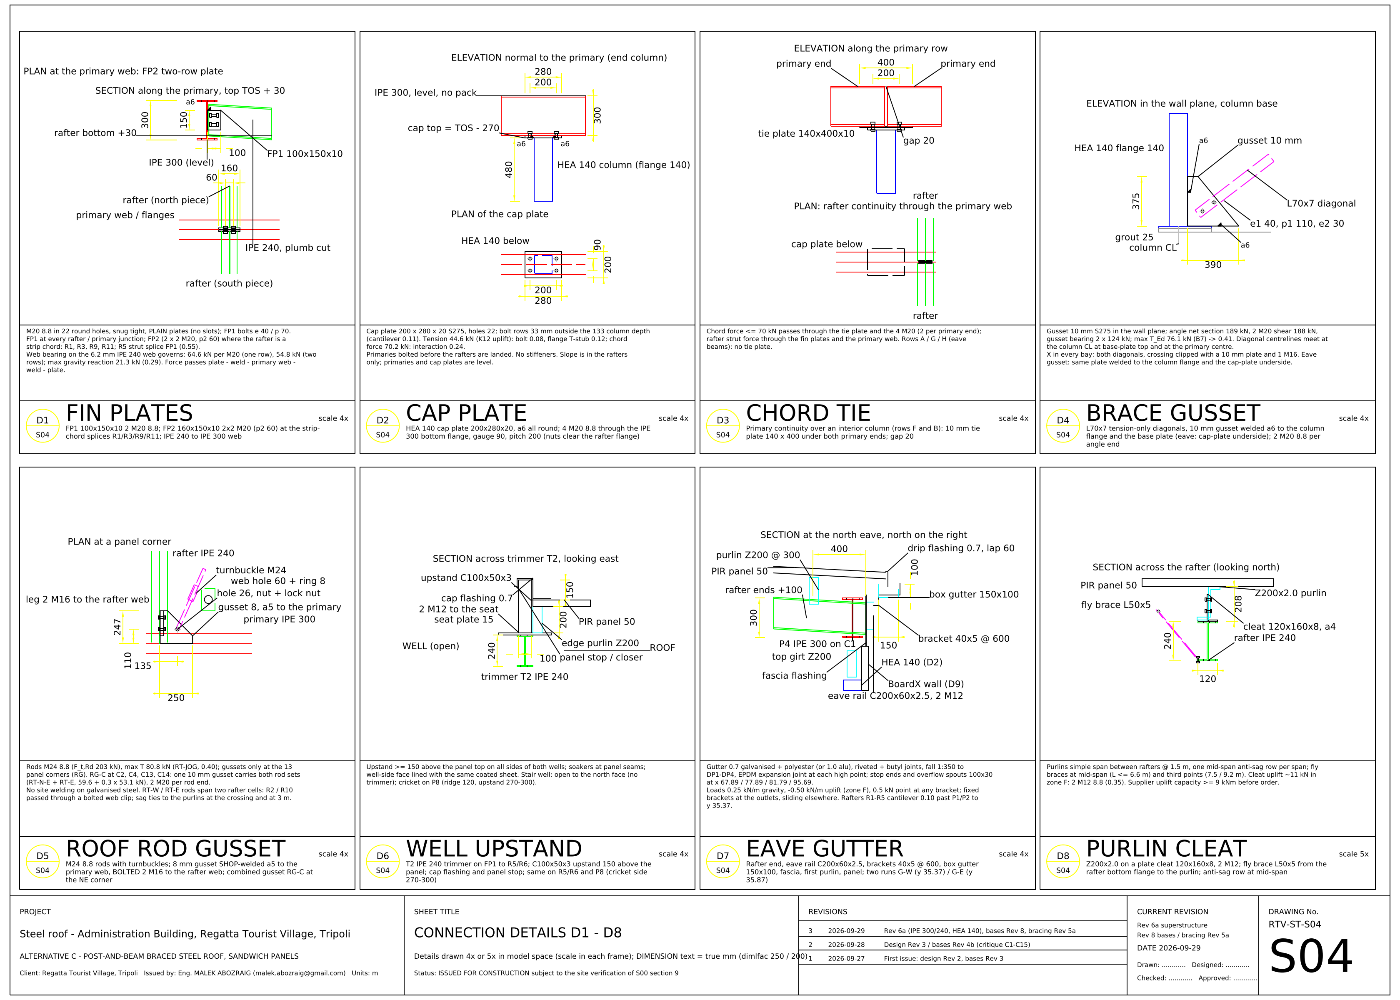
roof/detailing/S04.png
