loka92/test1strsteel/roof/detailing/S04a.png

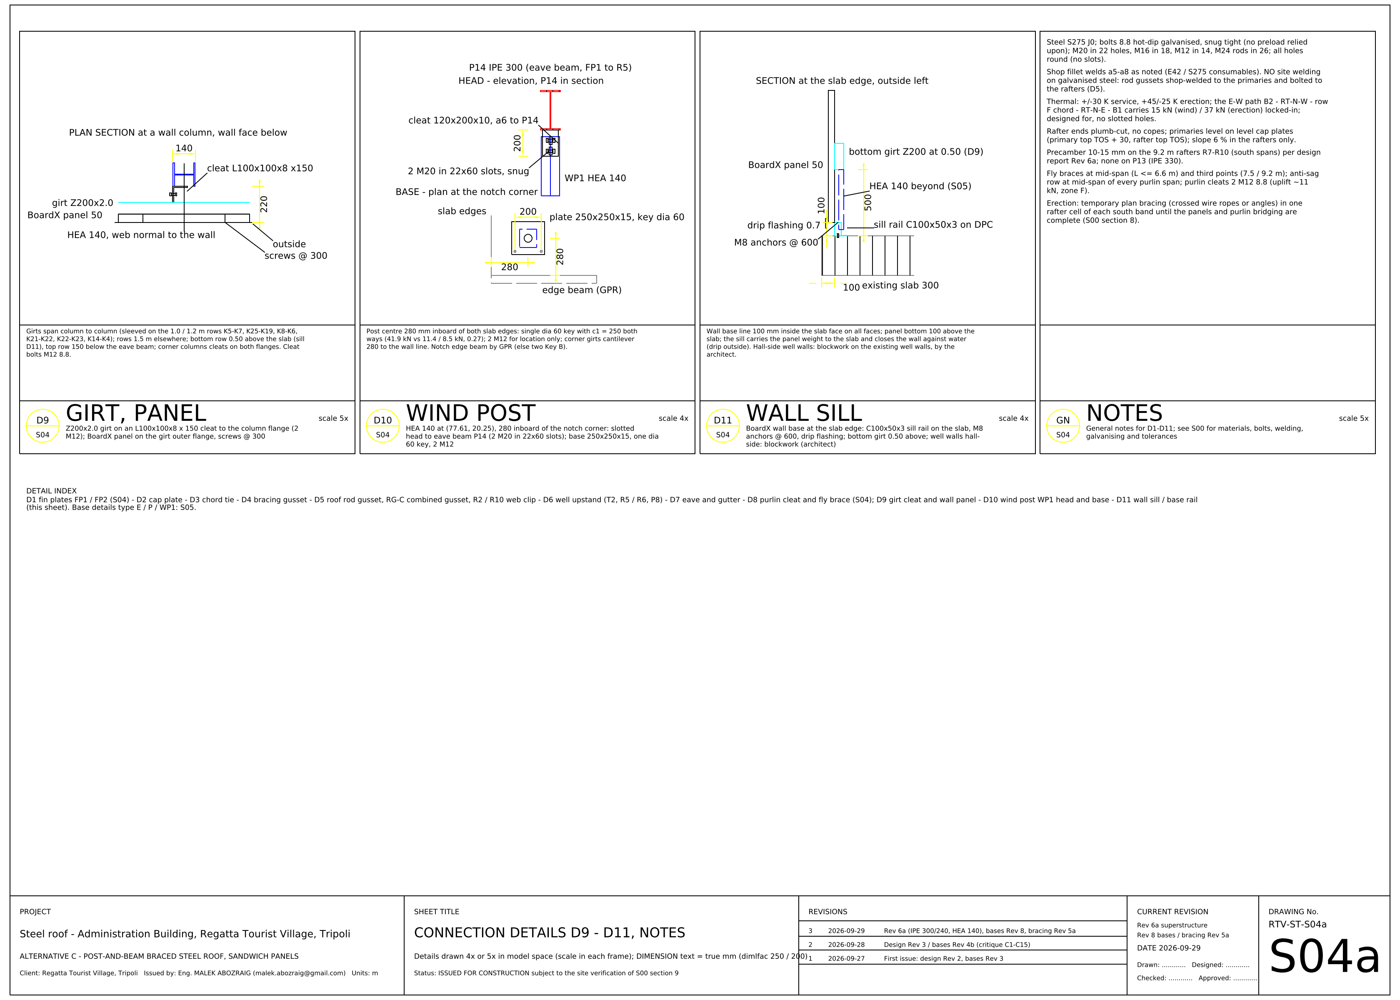
roof/detailing/S04a.png
