loka92/test1strsteel/roof/detailing/S05.png

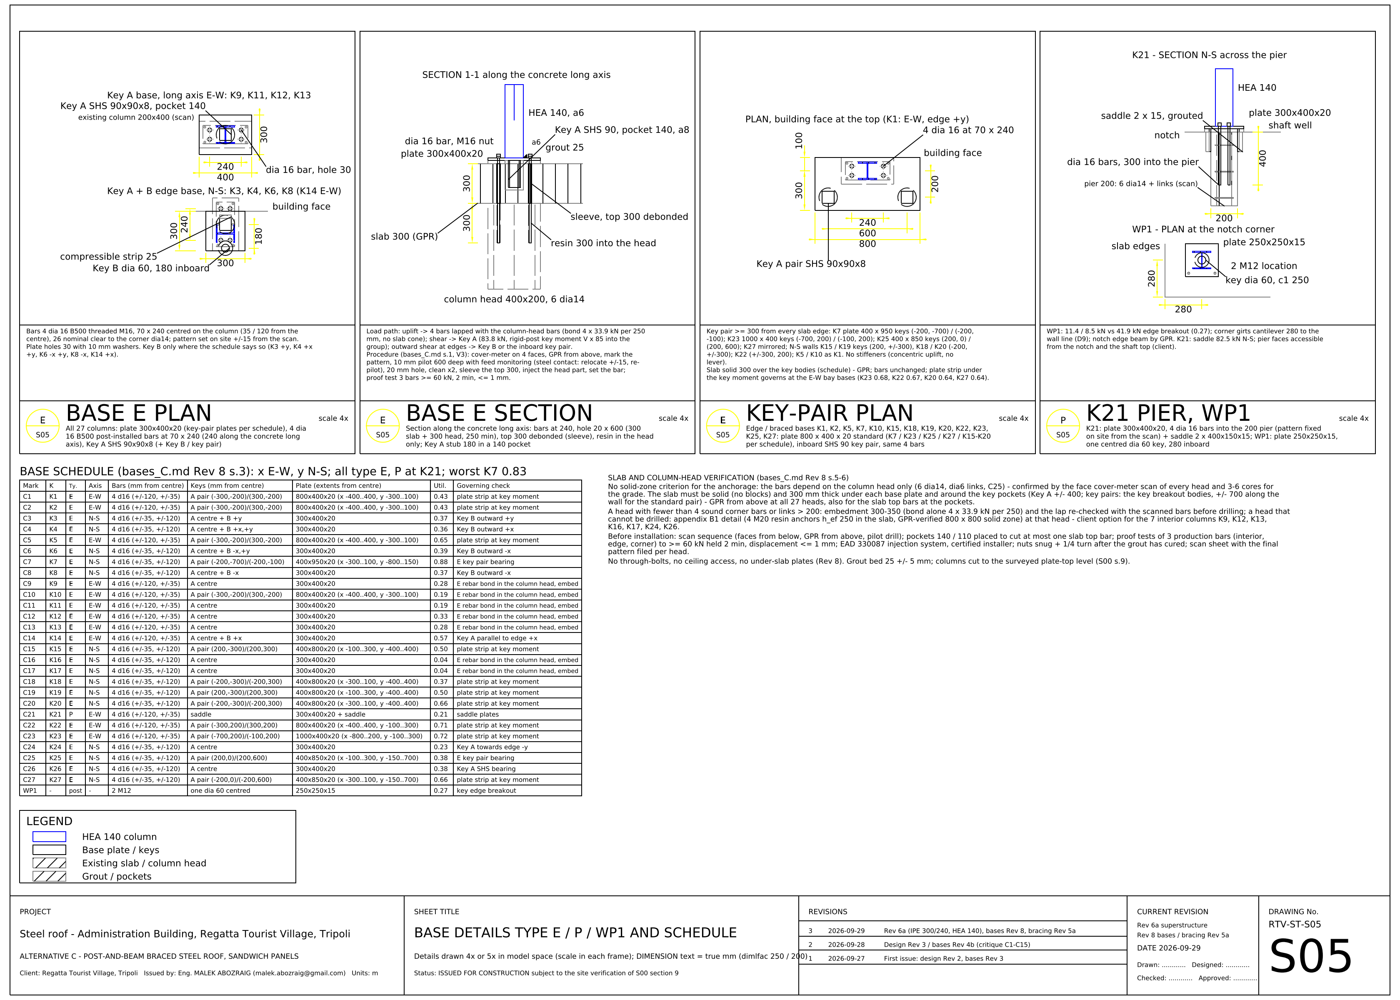
roof/detailing/S05.png
