loka92/test1strsteel/roof/detailing/S06.png

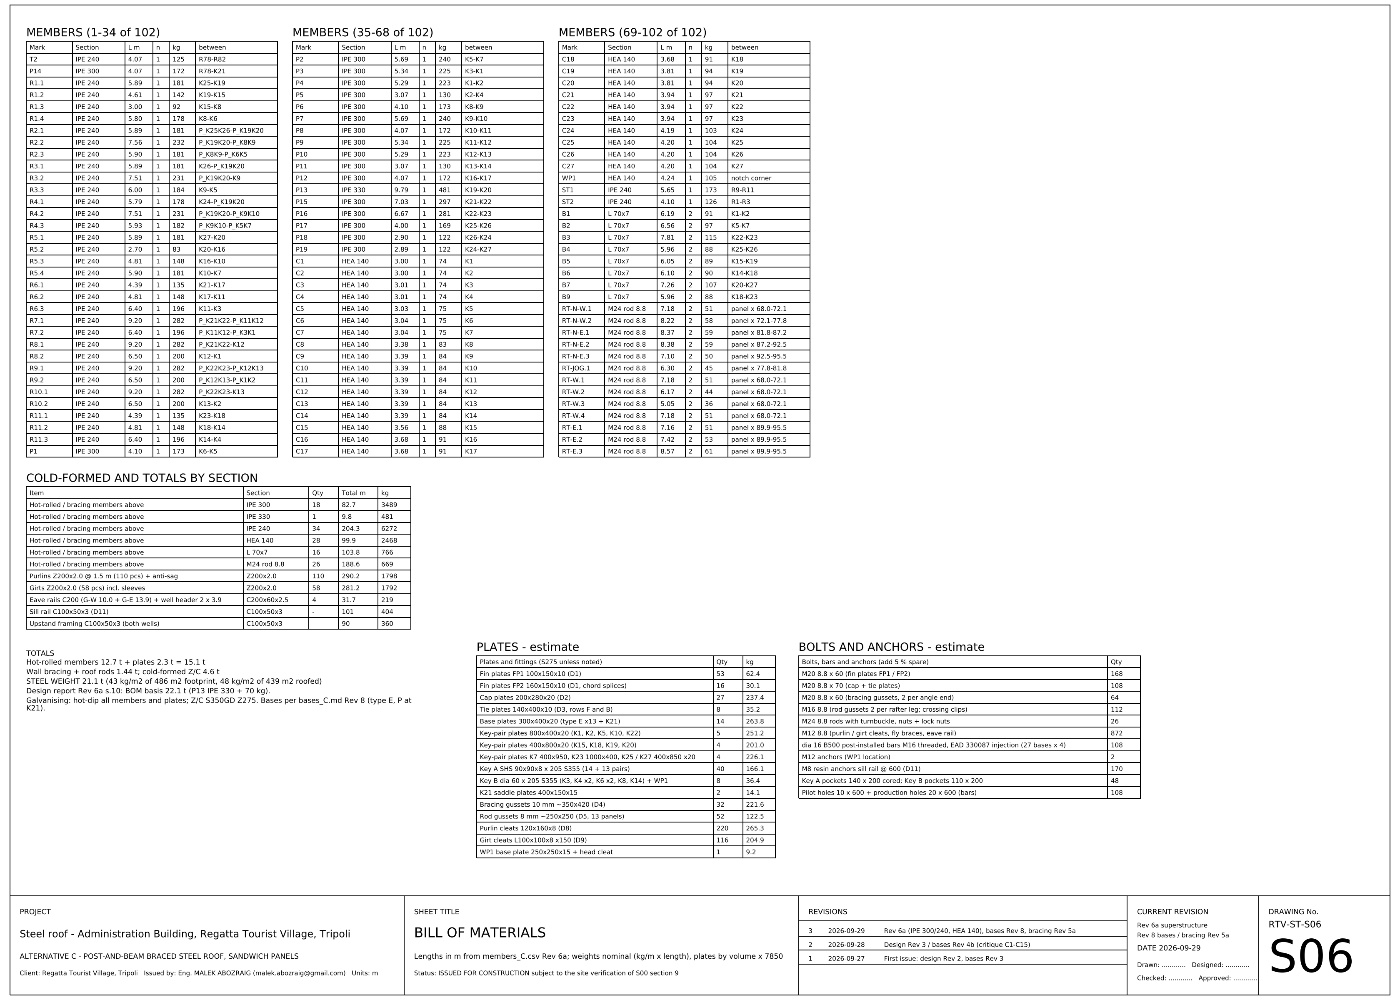
roof/detailing/S06.png
