loka92/test1strsteel/roof/drainage/drainage_layout.png

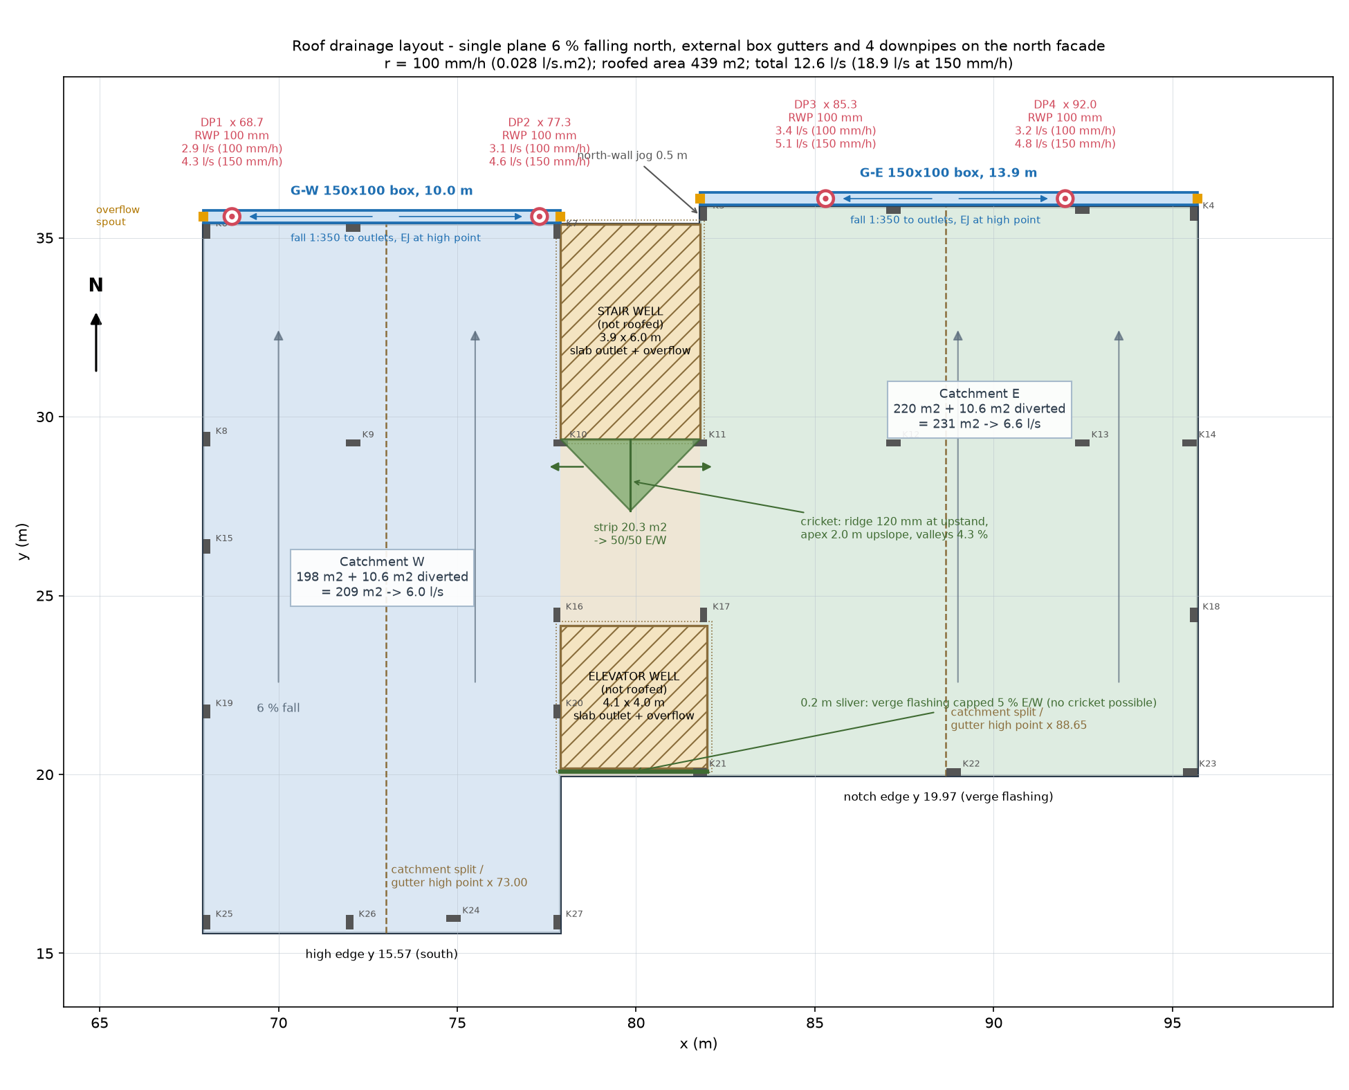
roof/drainage/drainage_layout.png
