loka92/test1strsteel/roof/drainage/gutter_section.png

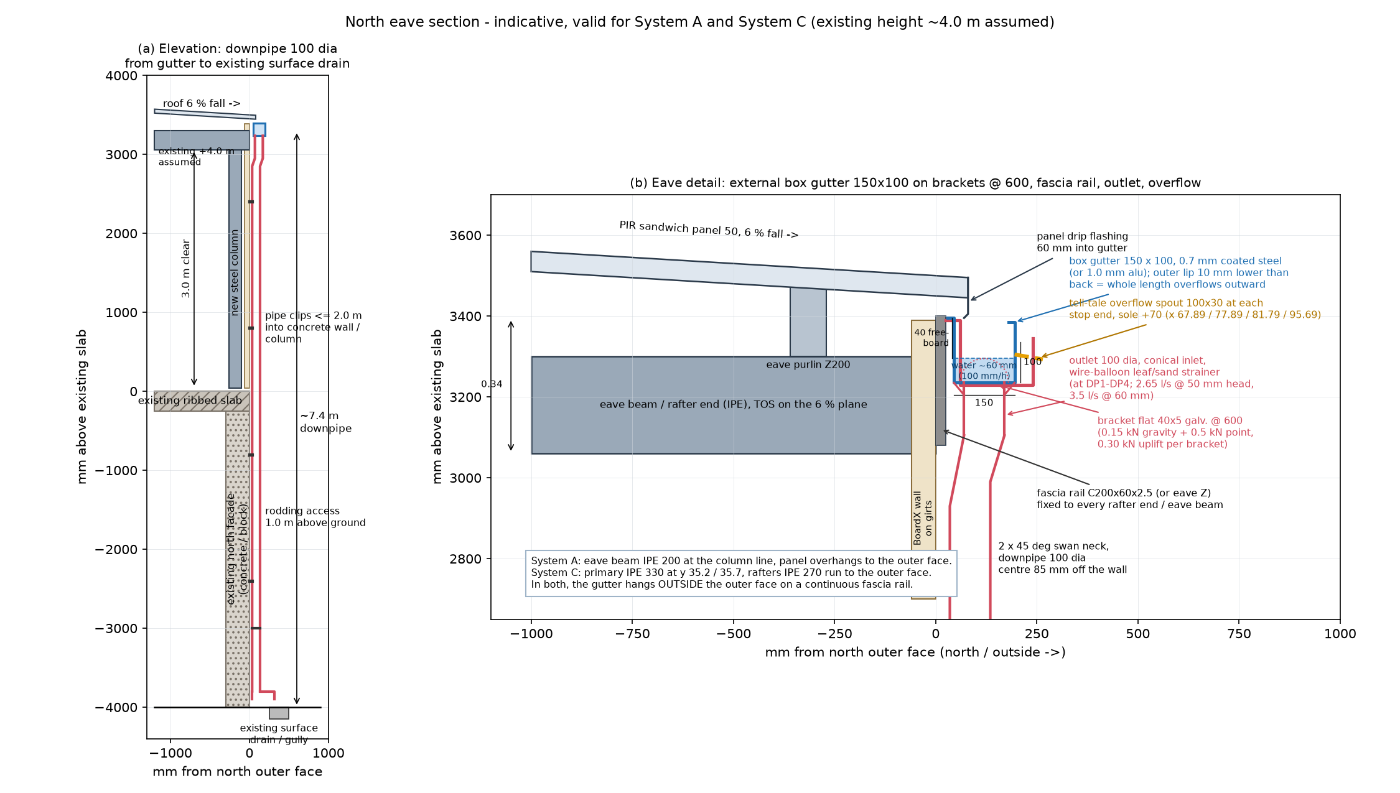
roof/drainage/gutter_section.png
