loka92/test1strsteel/roof/offer/preview_offer_RevA_p2.png

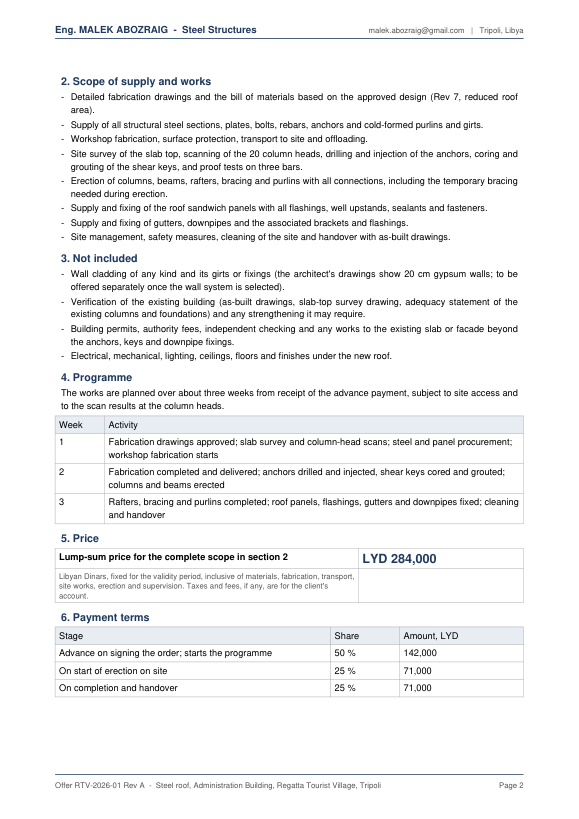
roof/offer/preview_offer_RevA_p2.png
