loka92/test1strsteel/roof/offer/preview_offer_RevC_p1.png

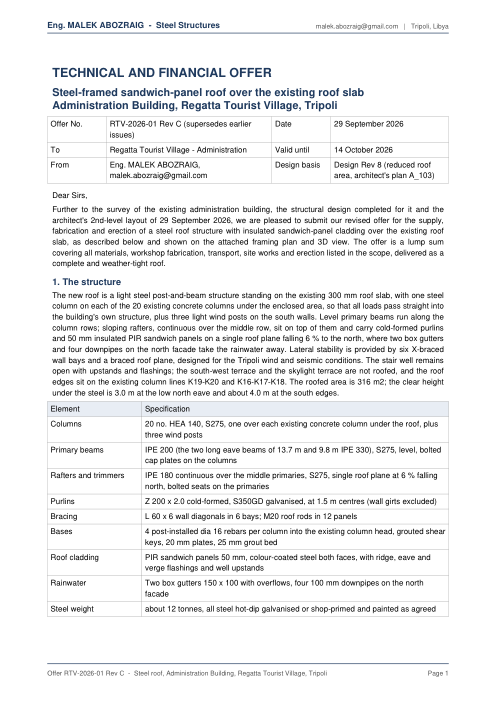
roof/offer/preview_offer_RevC_p1.png
