loka92/test1strsteel/roof/offer/preview_offer_RevD_p3.png

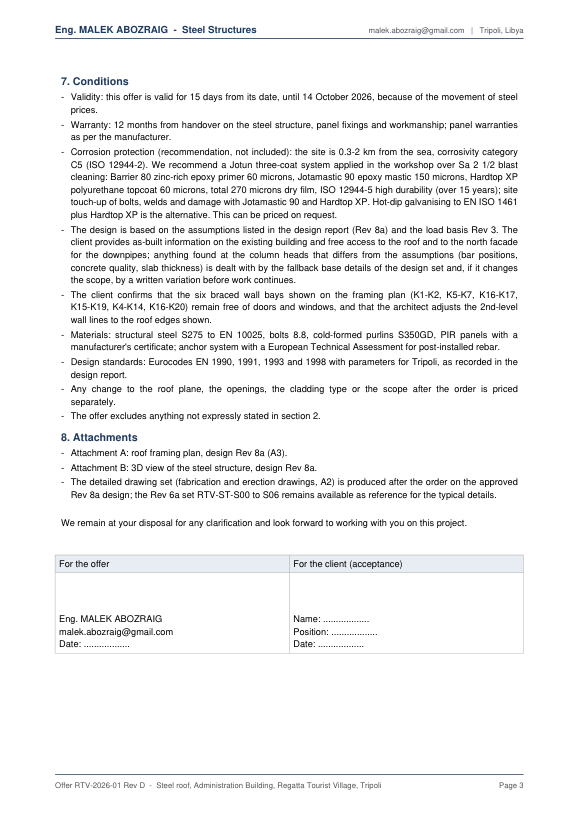
roof/offer/preview_offer_RevD_p3.png
