loka92/test1strsteel/roof/offer/preview_p1.png

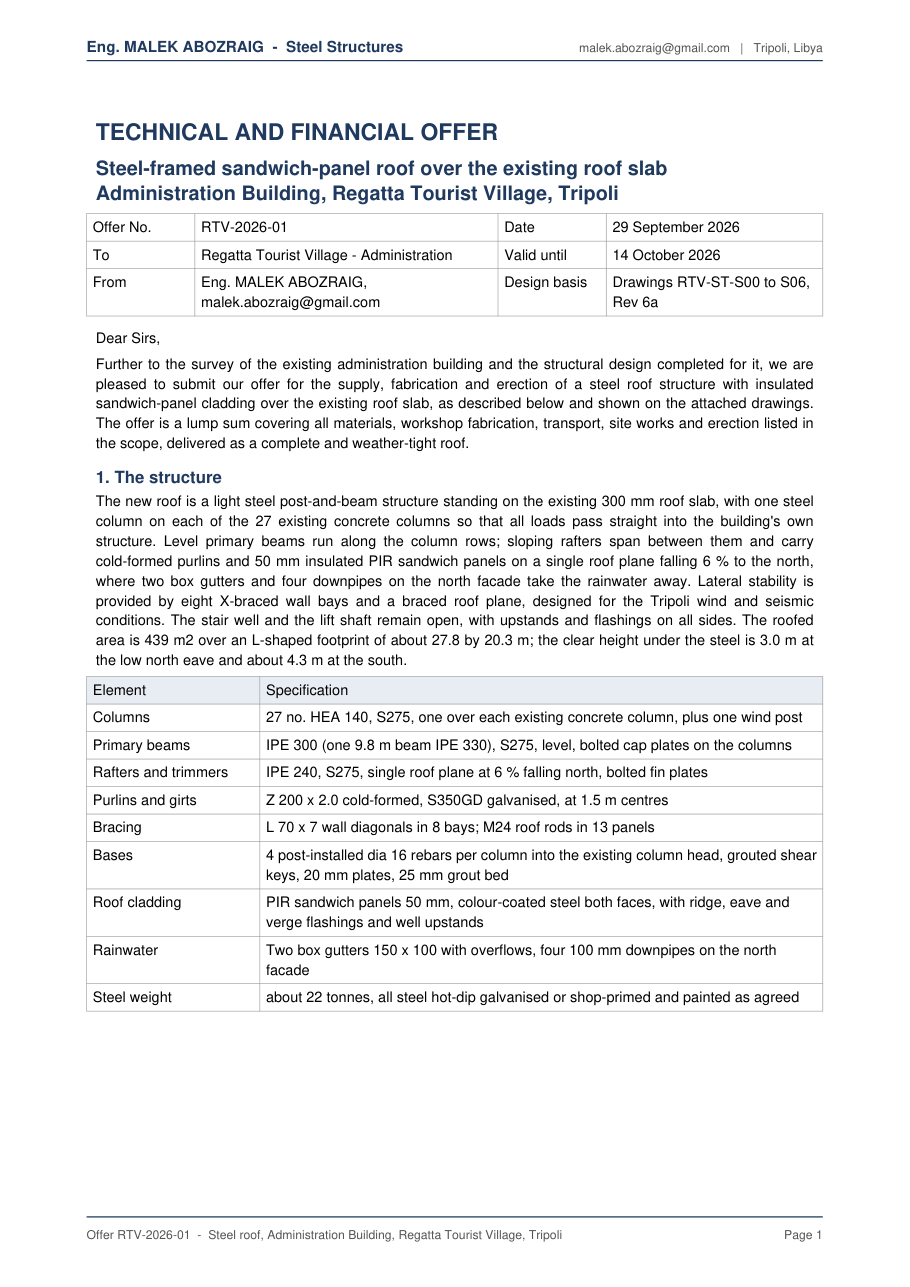
roof/offer/preview_p1.png
