loka92/test1strsteel/roof/offer/preview_p4.png

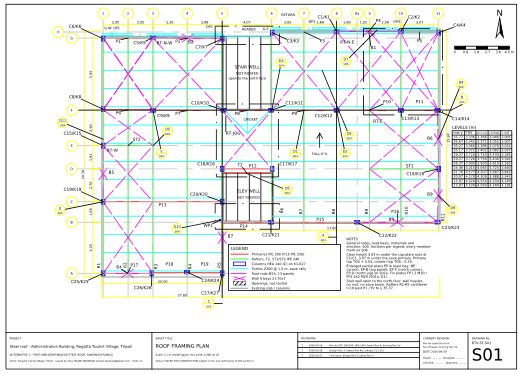
roof/offer/preview_p4.png
