loka92/test1strsteel/roof/offer/preview_sections.png

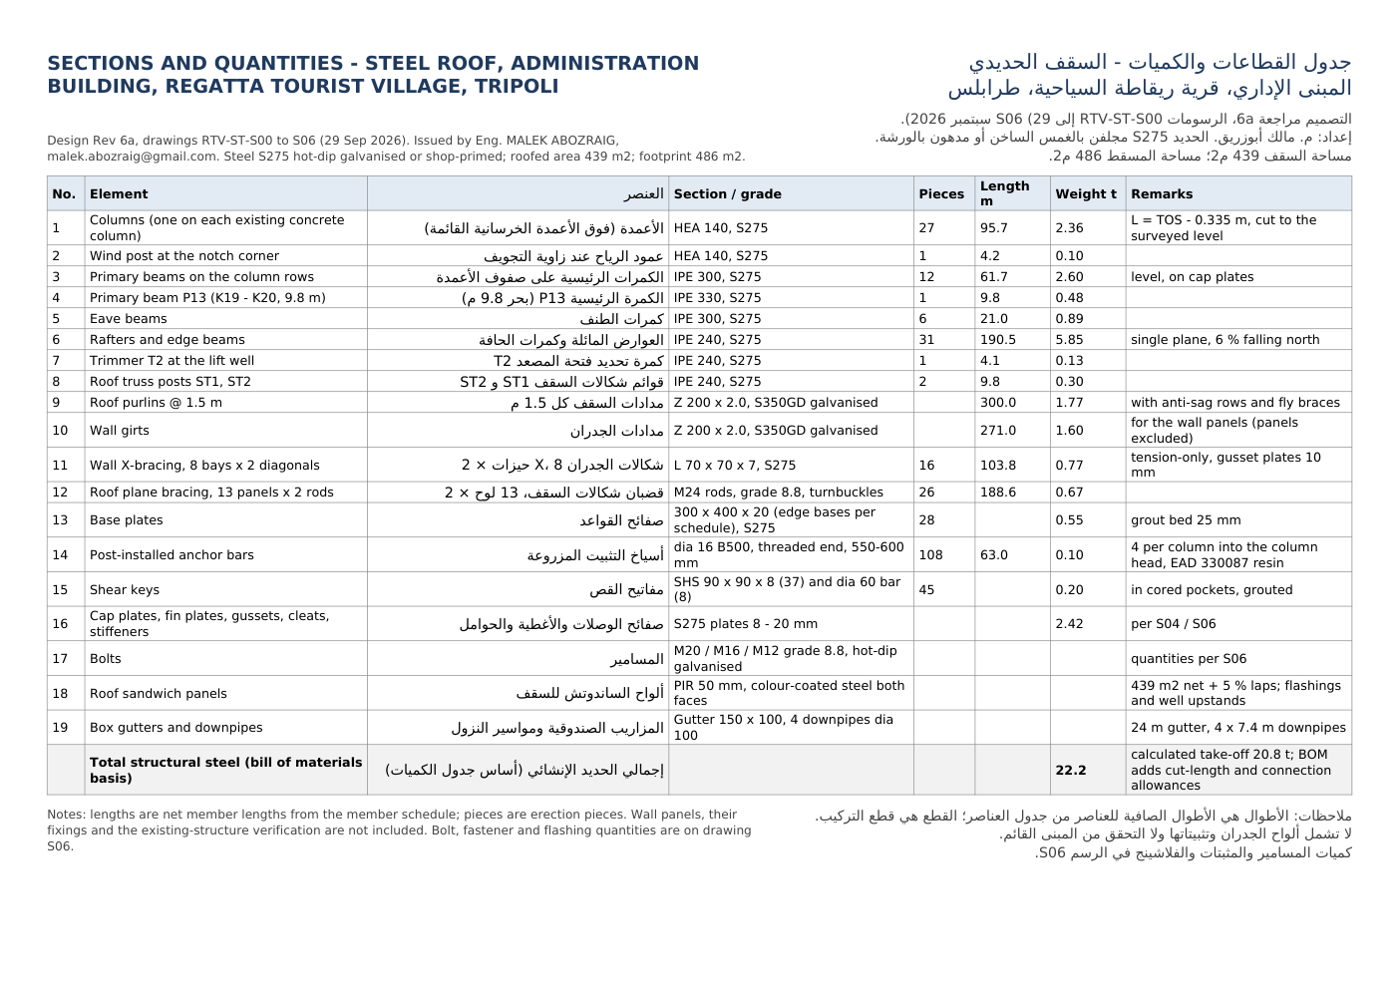
roof/offer/preview_sections.png
