loka92/test1strsteel/roof/offer/preview_sections_list4.png

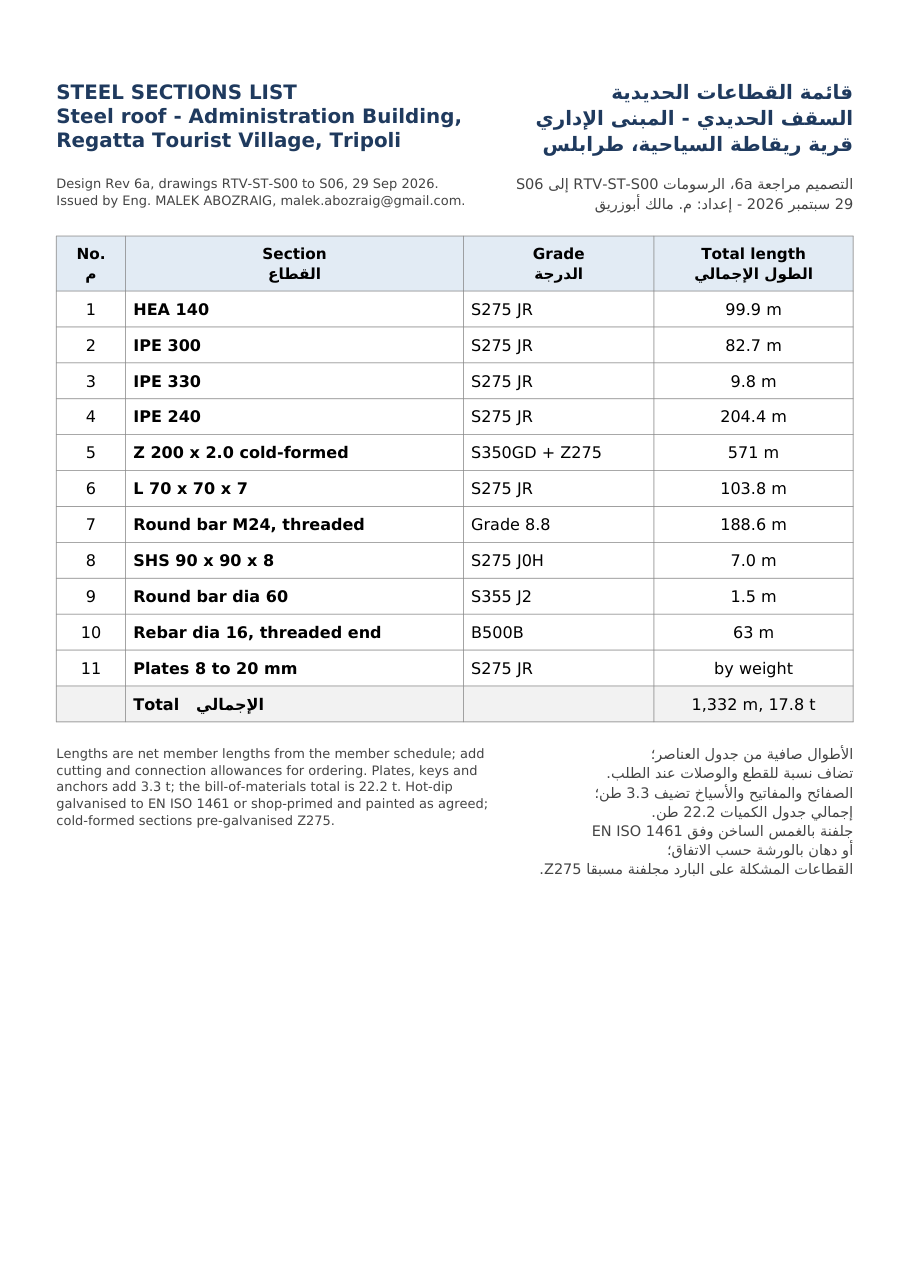
roof/offer/preview_sections_list4.png
