loka92/test1strsteel/roof/offer/preview_sections_list4_rev7.png

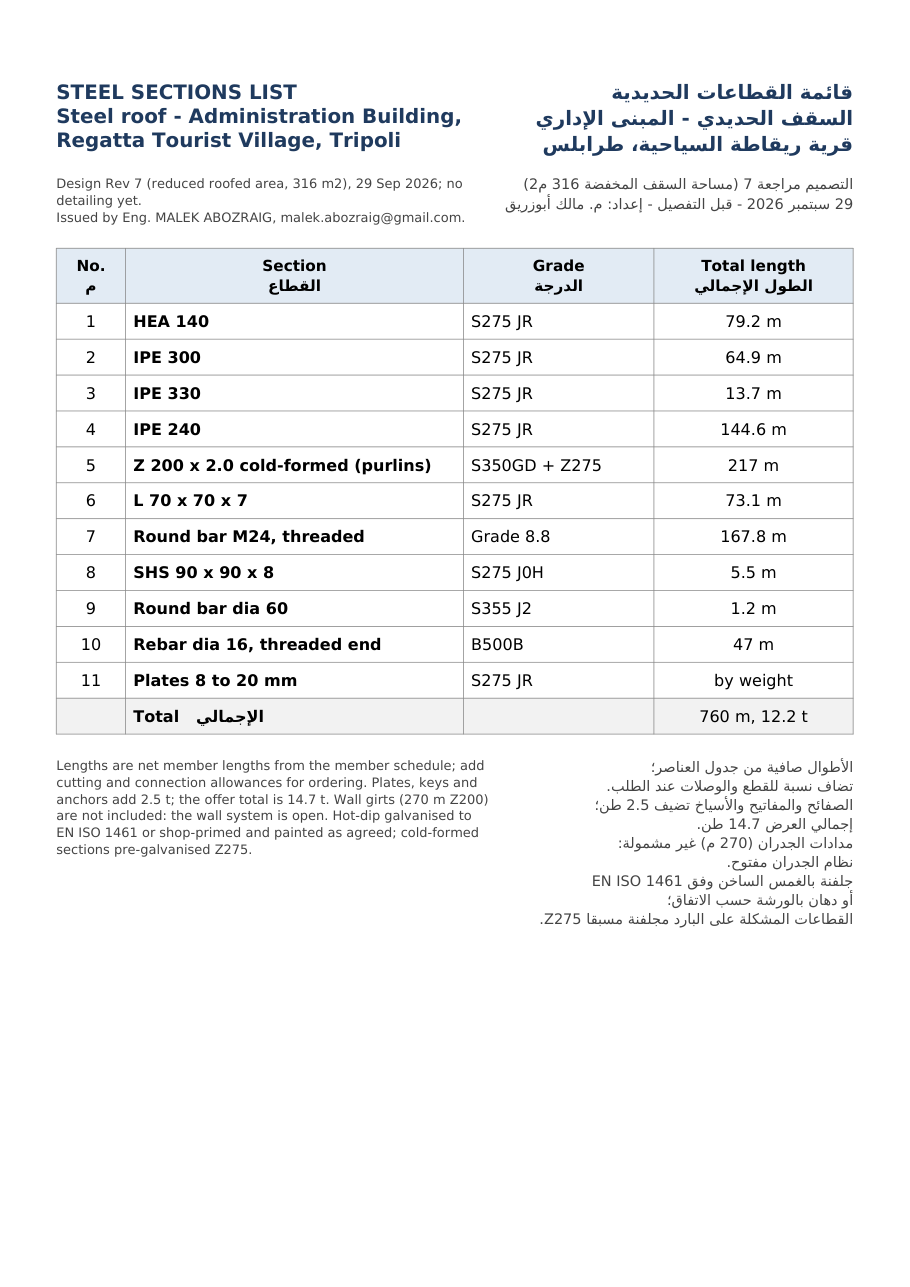
roof/offer/preview_sections_list4_rev7.png
