loka92/test1strsteel/roof/offer/preview_sections_list.png

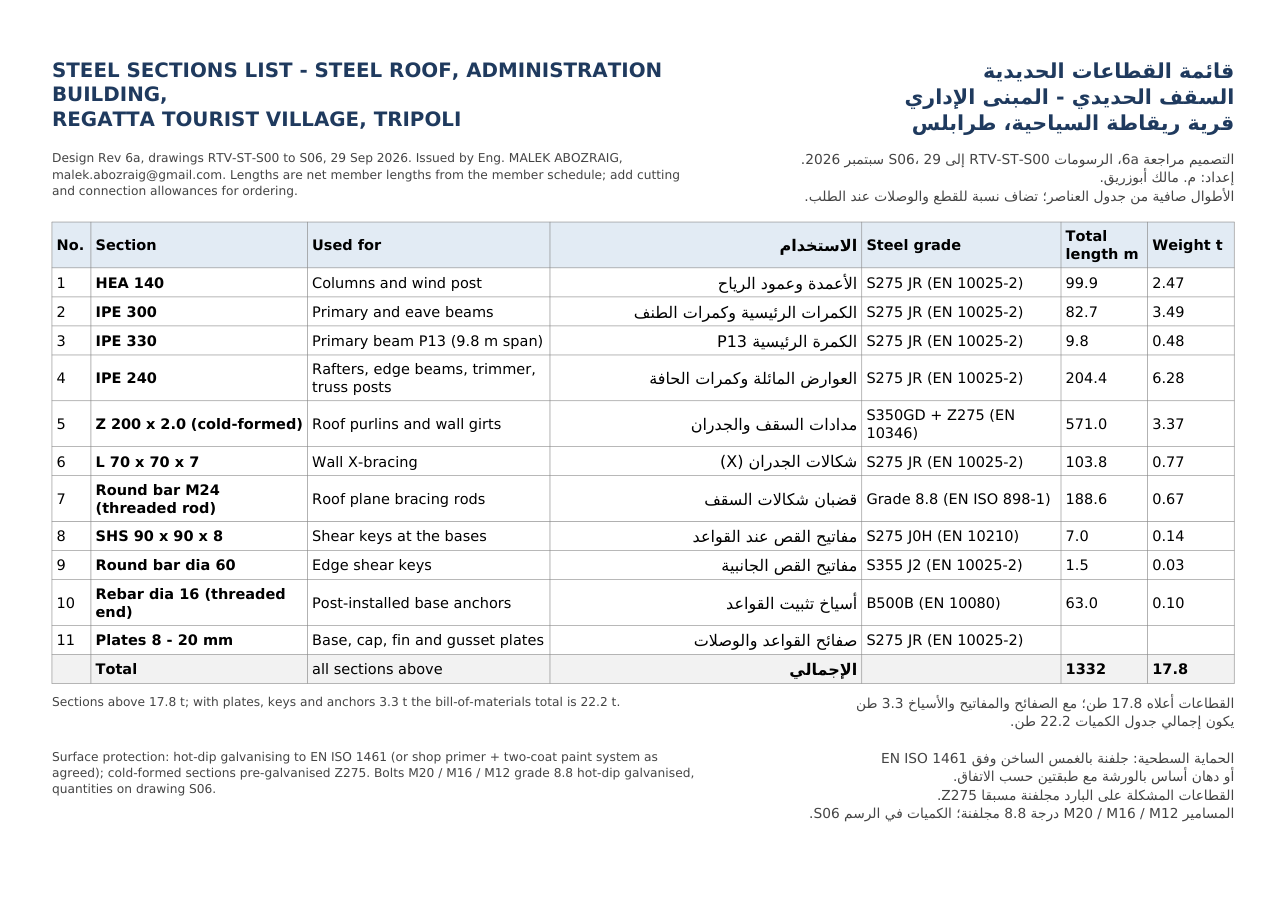
roof/offer/preview_sections_list.png
