loka92/test1strsteel/roof/offer/preview_sections_rev7.png

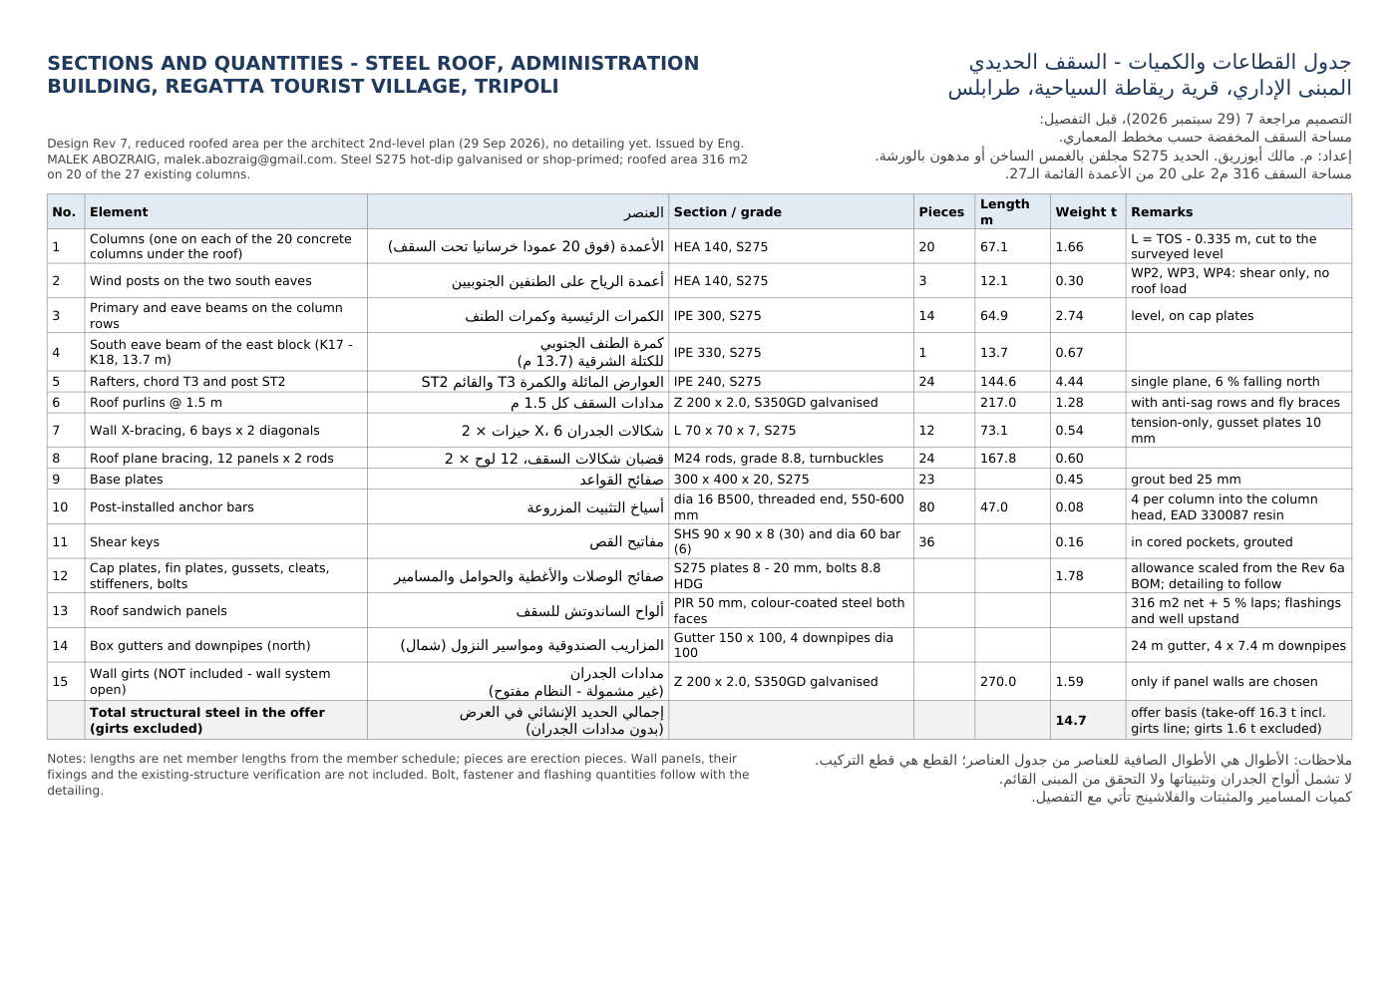
roof/offer/preview_sections_rev7.png
