loka92/test1strsteel/roof/systems/A_portal_dxf_check.png

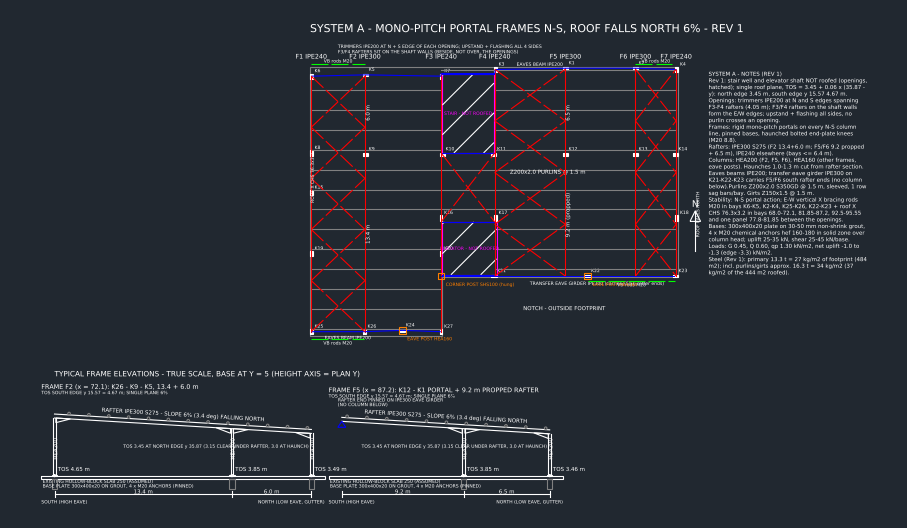
roof/systems/A_portal_dxf_check.png
