loka92/test1strsteel/roof/systems/A_portal_frame.png

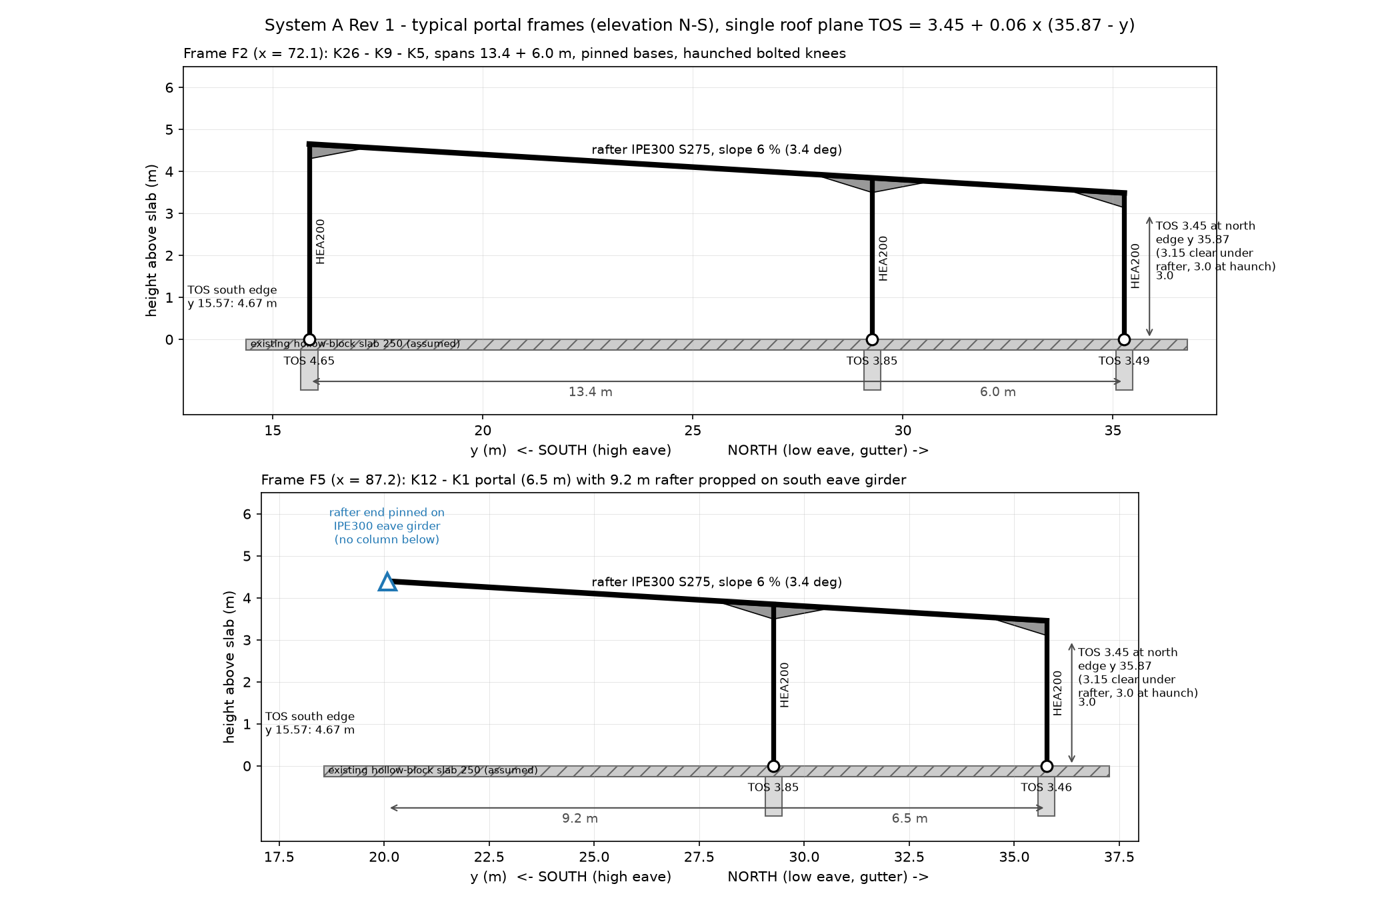
roof/systems/A_portal_frame.png
