loka92/test1strsteel/roof/systems/A_portal_plan.png

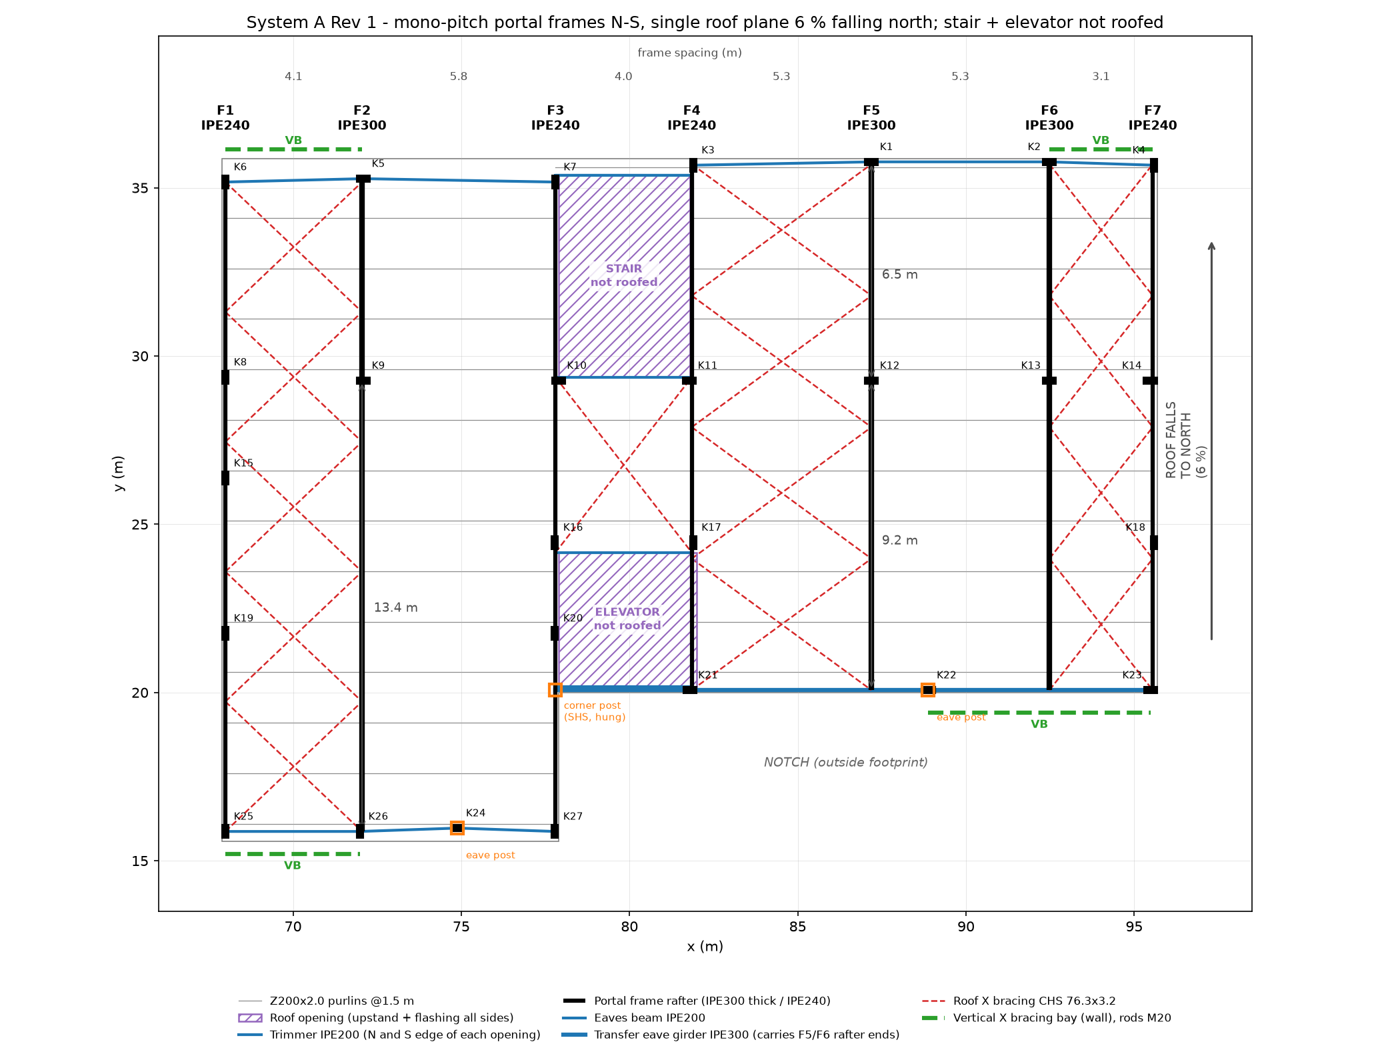
roof/systems/A_portal_plan.png
