loka92/test1strsteel/roof/systems/B_truss_dxf_check.png

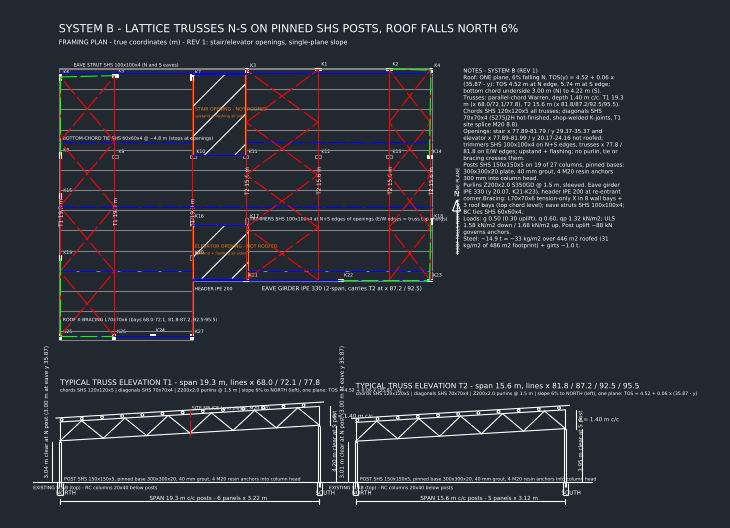
roof/systems/B_truss_dxf_check.png
