loka92/test1strsteel/roof/systems/B_truss_elev.png

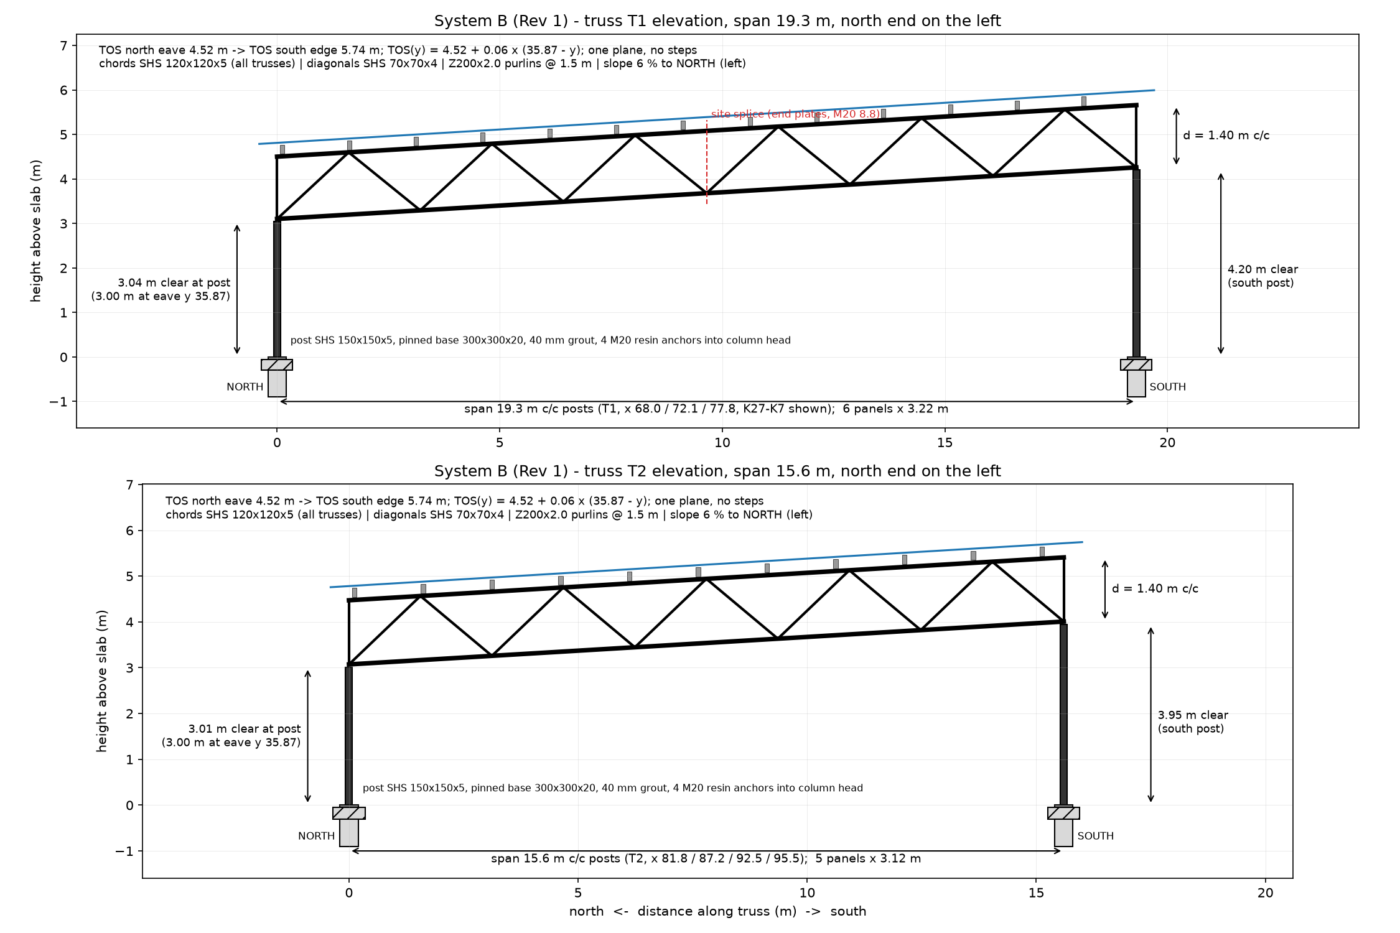
roof/systems/B_truss_elev.png
