loka92/test1strsteel/roof/systems/B_truss_plan.png

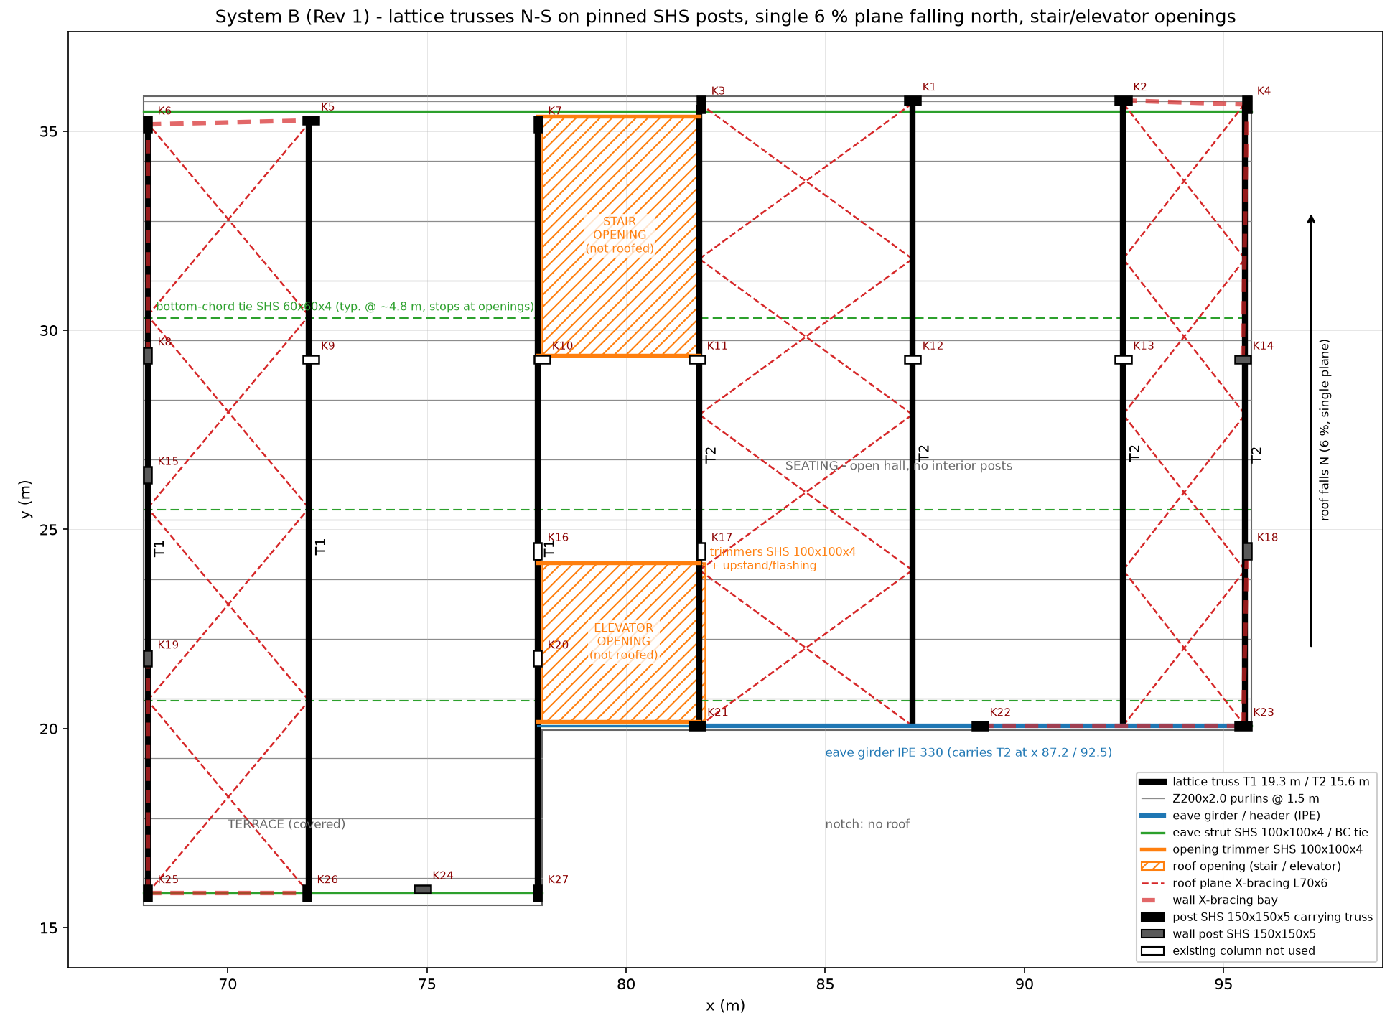
roof/systems/B_truss_plan.png
