loka92/test1strsteel/roof/systems/C_postbeam_dxf_check.png

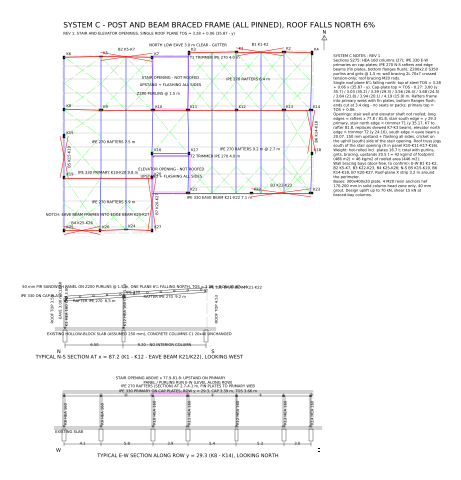
roof/systems/C_postbeam_dxf_check.png
