loka92/test1strsteel/roof/systems/C_postbeam_plan.png

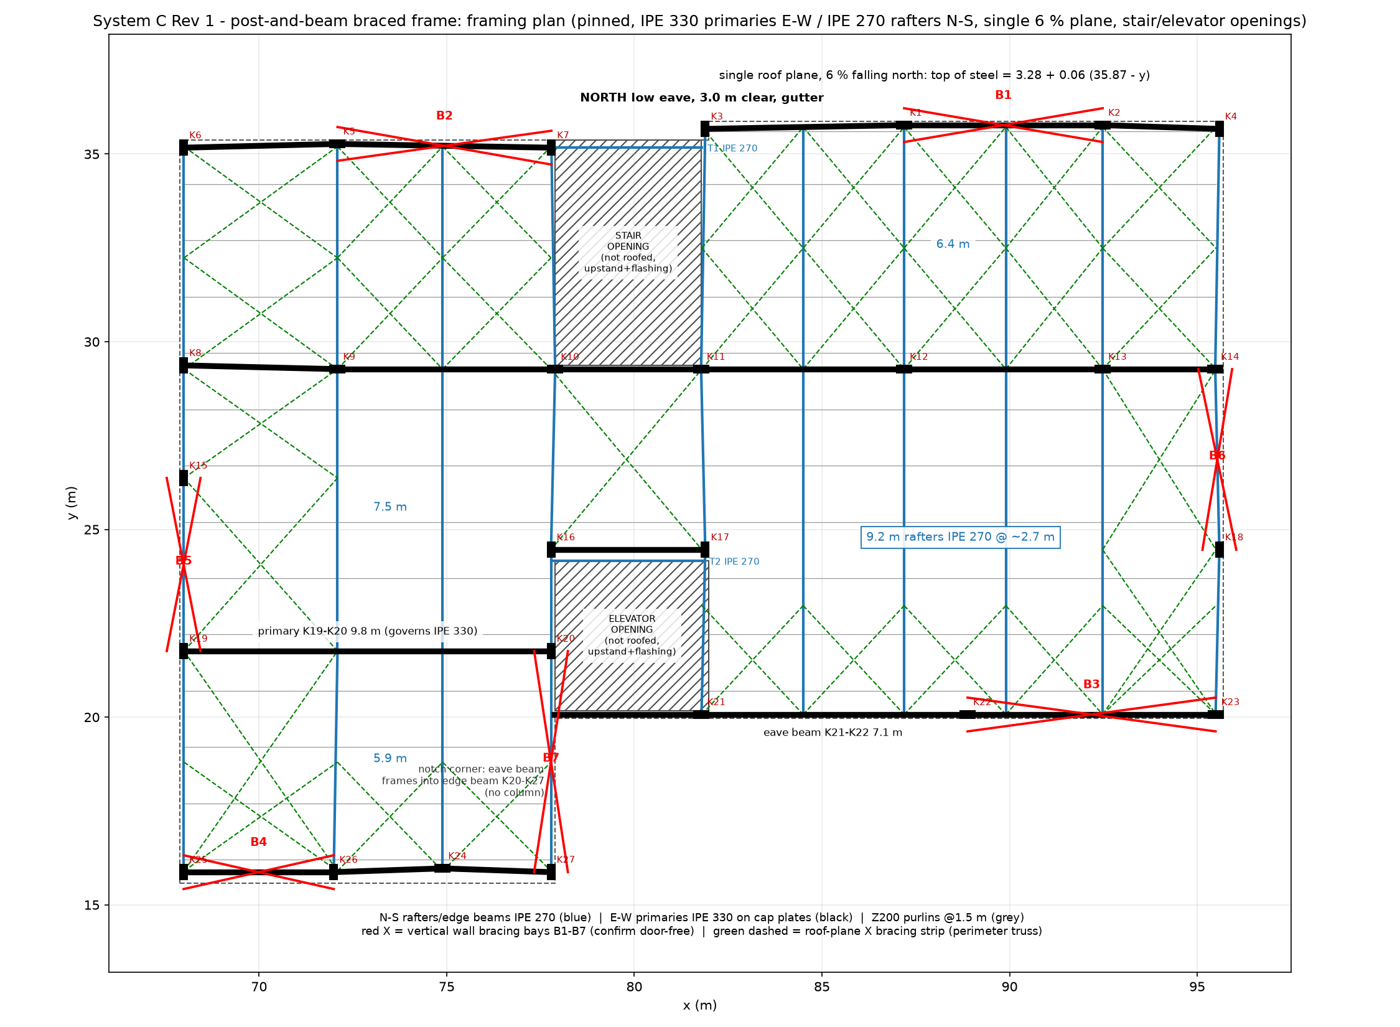
roof/systems/C_postbeam_plan.png
