loka92/test1strsteel/roof/systems/C_postbeam_section.png

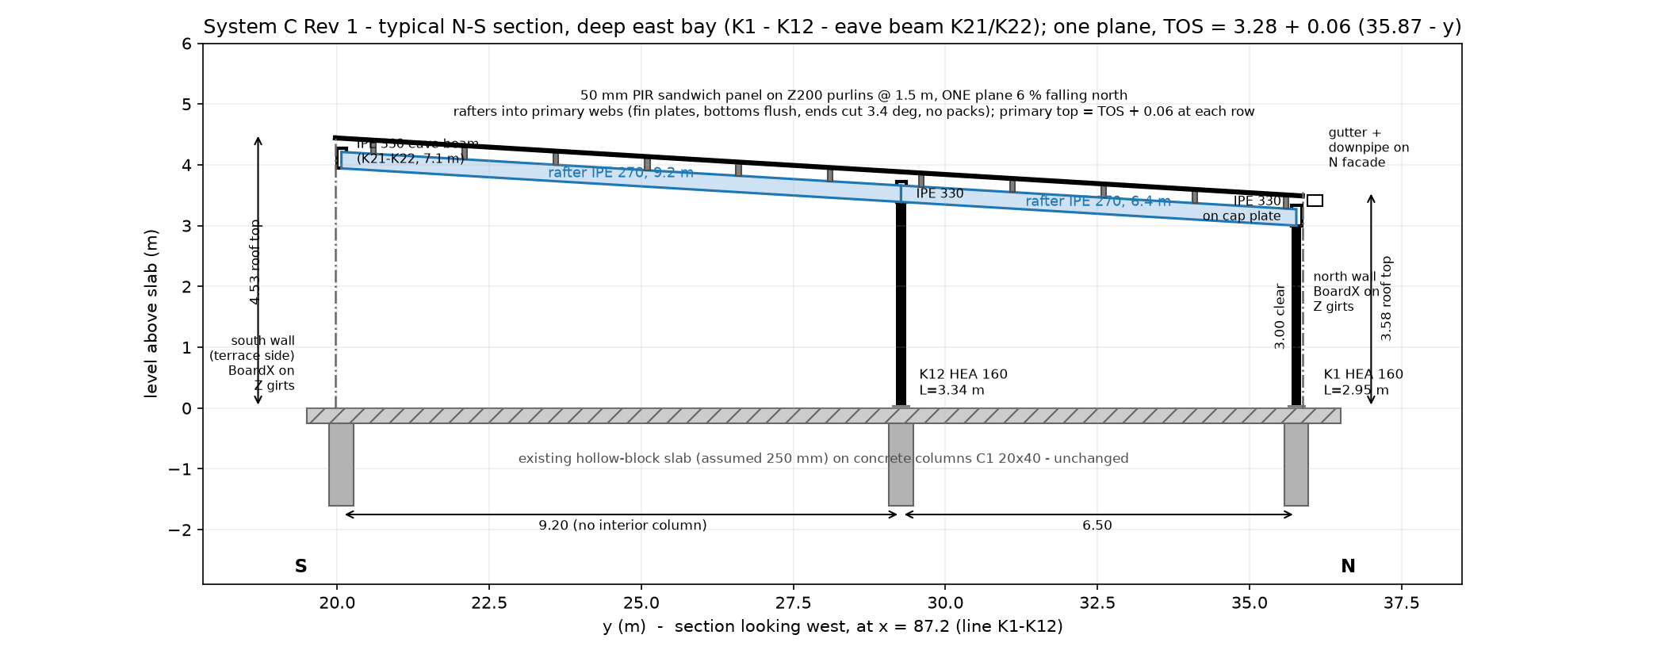
roof/systems/C_postbeam_section.png
