loka92/test1strsteel/roof/systems/three_systems_check.png

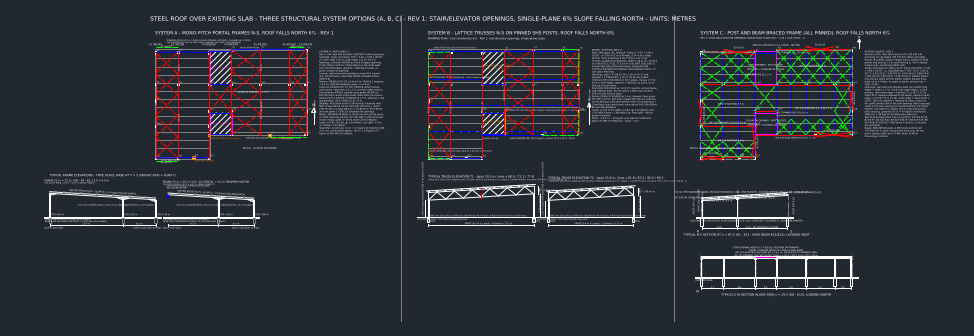
roof/systems/three_systems_check.png
