loka92/test1strsteel/roof/cost_LYD.md

# Cost estimate - design C Rev 8a (economic scheme, 23 columns), Rev 8 and Rev 7, reduced roofed area (2026-09-29)

**Rev 8a (offer/cost_sections_invoice_rev8a.md): sections 84,700 LYD (9.7 t bought), plates and small items 18,500 LYD, material 103,200 LYD. Offer Rev D: material 103,200 + assembly 20,000 + panels 47,000 = 170,200; margin 25 %; price 213,000 LYD.**

**Rev 8 at the supplier's quotation prices (offer/cost_sections_invoice_rev8.md): sections 88,068 LYD (10.1 t bought), plates and small items 18,499 LYD, material 106,567 LYD; Rev 7 was 139,901 LYD material. The 6,950 LYD/t all-in rate below is superseded: it is lower than the bare material price of the quotation.**

Client rates: **6,950 LYD per tonne** of steel (supplied, fabricated, galvanised/painted and erected) and **150 LYD/m2** of roof sandwich panel supplied and fixed. Previous estimate (Rev 6a, 439 m2): steel 22.2 t = 154,300 LYD, panels 69,200 LYD, total 223,500 LYD.

## Steel (design Rev 7 take-off, 14.7 t; girts excluded)
| Item | Tonnes | LYD |
|---|---|---|
| IPE 300 primaries and eave beams (64.9 m) | 2.74 | 19,037 |
| IPE 330 south eave beam K17-K18 (13.7 m) | 0.67 | 4,675 |
| IPE 240 rafters, T3, ST2 (144.6 m) | 4.44 | 30,850 |
| HEA 140 columns K1-K20 and wind posts WP2-WP4 (79.2 m) | 1.96 | 13,593 |
| Plates: base, cap, fin, keys, rebars, gussets, bolts (allowance scaled from the Rev 6a BOM) | 2.47 | 17,176 |
| Wall bracing L70x7 (73 m) and roof rods M24 (168 m) | 1.14 | 7,889 |
| Z200 purlins (217 m) | 1.28 | 8,898 |
| **Steel total** | **14.7** | **102,165 LYD** |
| (Z200 wall girts, 270 m, only if panel walls are chosen - not included) | 1.59 | 11,071 |

## Roof panels (client rate)
| Item | Basis | LYD |
|---|---|---|
| PIR 50 mm sandwich roof panels, 316 m2 net roofed area, supplied and fixed | 150 LYD/m2 | 47,452 |
| Allowance for laps, cutting at the well, the jog and the verges, flashings (about 5 %) | | 2,318 |
| **Roof panels total** | | **49,770 LYD** |

## Steel + roof panels
| | LYD |
|---|---|
| Steel 14.7 t at 6,950 | 102,165 |
| Roof panels 316 m2 at 150 + 5 % | 49,770 |
| **Total steel and roof cladding** | **151,935 LYD** |

## Offer Rev A build-up (offer/pricing_internal_RevA.md)
Steel 102,165 + assembly 10 % of sections 6,811 + panels 49,770 + gutters 12,000 + base works 18,500 = cost 189,246; margin 50 % = 94,623; **offer price 284,000 LYD** (Rev 6a issue: 404,000 LYD).

## Not in either rate
| Item | Status |
|---|---|
| Walls (architect: 20 cm gypsum; brief: BoardX) with girts/fixings | to be quoted once the wall system is chosen |
| Lift tower east of the building (architect) | separate structure, not in this package |
| Existing-structure verification, as-builts, scans/cores, permits | client / conditions precedent |

## Change history of the steel figure
| | Tonnes | Steel cost |
|---|---|---|
| Rev 4 drawings BOM | 25.4 | |
| Rev 5a (bracing rationalised) | 24.1 | |
| Rev 6a (lighter sections, P13 IPE 330) | 22.2 (incl. 1.6 t girts) | 154,300 LYD |
| Rev 7 (reduced roofed area 316 m2, girts excluded) | 14.7 | 102,165 LYD at 6,950/t; material 139,900 LYD at quotation prices |
| Rev 7b (IPE 200 rafters, IPE 240 primaries) | 13.0 | material 120,800 LYD at quotation prices |
| Rev 8 (continuous IPE 180 on IPE 200, L60x6, M20 rods) | 11.6 | material 106,600 LYD at quotation prices |
| **Rev 8a (Rev 8 + existing columns K28-K30 under the south eaves, all primaries IPE 200)** | **11.0** | **material 103,200 LYD at quotation prices** |
