loka92/test1strsteel/roof/cost_sections_invoice_rev8.md

# Steel section cost from the supplier quotation (29 Sep 2026) - design Rev 8

Source: pro-forma invoice 11486, Al-Salama Industrial Steel Trading (محلات السلامة لتجارة الحديد الصناعي), total 142,379 LYD. Its quantities are the **Rev 6a** sections list (8 x 12 m + 1 x 6 m HEA 140, 7 x IPE 300, 1 x IPE 330, 17 x IPE 240, 95 x 6 m purlins, 13 x angle): supply of sections only, no plates, bolts, fabrication, coating or erection.

## 1. Unit rates from the invoice

| Item | Bar | Price LYD | LYD / m | kg / m | LYD / tonne |
|---|---|---|---|---|---|
| 1596 HEA 140 x 133, 12 m, imported | 12 m | 3,375 | 281.2 | 24.70 | 11,387 |
| 85 IPE 300, 12 m, imported | 12 m | 3,750 | 312.5 | 42.20 | 7,405 |
| 83 IPE 330, 12 m, imported | 12 m | 4,650 | 387.5 | 49.10 | 7,892 |
| 81 IPE 240, 12 m, imported | 12 m | 2,725 | 227.1 | 30.70 | 7,397 |
| 2707 Galvanised purlin 200, 6 m | 6 m | 285 | 47.5 | 5.90 | 8,051 |
| 341 Angle 75 x 75 x 7, 12 m | 12 m | 720 | 60.0 | 7.94 | 7,557 |
| 1351 Threaded bolt M24 x 60 cm | 0.6 m | 29 | 48.3 | 3.55 | 13,615 |
| 1985 HEA 140 x 133, 6 m, imported | 6 m | 1,690 | 281.7 | 24.70 | 11,404 |

Supply-only section prices are 7,400-7,900 LYD/t for IPE, about 11,400 LYD/t for HEA 140, 8,050 LYD/t for the purlin (if 2.0 mm) and 7,560 LYD/t for the angle. **The 6,950 LYD/t used so far as an all-in rate (supplied, fabricated, erected) is below the bare material price**, so the cost build-up changes: material at invoice prices plus fabrication, coating and erection as separate items.

## 2. Rev 8 section bill at invoice prices (12 m stock bars, first-fit cutting plan, 10 mm kerf)

| Section | Net m | Bars | Bought m | kg | LYD / m | Cost LYD | Cutting note |
|---|---|---|---|---|---|---|---|
| HEA 140 | 78.6 | 8 | 96.0 | 2,371 | 281.2 | 27,000 | 23 pieces, longest 4.23 m |
| IPE 200 | 55.1 | 5 | 60.0 | 1,344 | 165.8 | 9,946 | 12 pieces, longest 5.69 m; not on the quotation, priced by weight at the invoice rate |
| IPE 180 | 144.6 | 13 | 156.0 | 2,933 | 139.1 | 21,703 | 12 rafter lines up to 13.71 m: continuous, 5 spliced at a low-moment point (over 12 m); not on the quotation, priced by weight at the invoice rate |
| L60x6 | 72.5 | 8 | 96.0 | 520 | 41.0 | 3,932 | 12 pieces, longest 7.22 m; not on the quotation, priced by weight at the invoice rate |
| IPE 330 | 23.5 | 2 | 24.0 | 1,178 | 387.5 | 9,300 | 13.7 m beam: 12 m bar + 1.7 m piece (splice) or one 14 m special length; the 9.8 m beam uses the rest of the second bar |
| Z200 purlin, 6 m bars | 217.0 | 37 | 222.0 | 1,310 | 47.5 | 10,545 | gauge 2.0 mm S350GD to confirm with the supplier |
| M20 threaded rod | 167.8 | - | 167.8 | 414 | 33.6 | 5,643 | priced from the 60 cm M24 bolt (29 LYD) by weight; ask for rod in 3 m lengths |
| **Sections total** | | | | **10,071** | | **88,068** | average 8,745 LYD/t on bought weight |
| Plates, keys, rebars, bolts (2.5 t, not on the invoice) | | | | 2,467 | | 18,499 | assumed 7,500 LYD/t, to be quoted |
| **Material total** | | | | **12,538** | | **106,567** | |

Waste: bought 10071 kg against a net take-off of 9136 kg (10 % offcuts); the offcuts of the rafter and column bars are usable for T3, ST2, the wind posts and stiffeners.

## 3. Notes on the quotation

- The IPE 330 eave beam K17-K18 is 13.7 m; the stock length is 12 m. Either a 14 m bar is ordered (ask the supplier) or the beam is spliced with a bolted end-plate splice near a rafter, about 3 m from K18.
- The angle offered is 75 x 75 x 7 (7.94 kg/m); the design uses L60x6 (priced by weight at the same rate).
- Purlin "galvanised 200, 6 m": confirm Z (not C) profile, 2.0 mm, S350GD, Z275; the design needs sleeved laps at the rafters, so 6 m bars suit the 2.6-4.1 m rafter spacing with one lap per two bays.
- HEA 140 columns: 20 columns of about 3.0-3.8 m and 3 posts of about 4.0 m cut from 8 x 12 m bars (three pieces per bar); the 6 m bar is not needed.
- The M24 item is a 60 cm bolt; the roof rods need about 168 m of threaded rod with turnbuckles, to be quoted as rod.
- Prices are dated 29/09/2026 and imported stock; keep the 15-day offer validity.
