loka92/test1strsteel/roof/3d/C_concept_3d.dxf

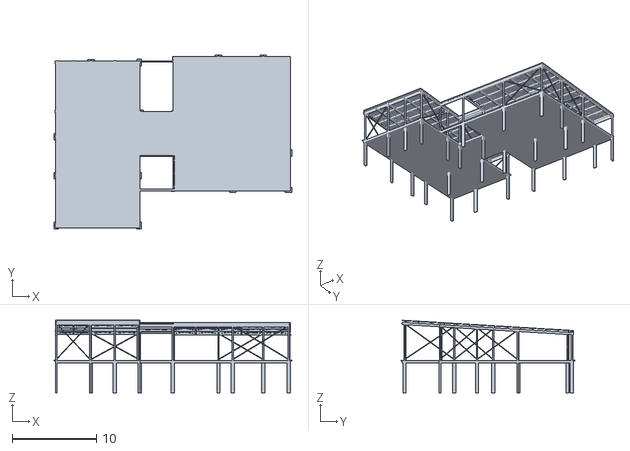
[picture p49: CAD file, 2026-09-28]
roof/3d/C_concept_3d.dxf
28.2 x 20.6 x 8.60
