loka92/test1strsteel/roof/systems/B_truss.dxf

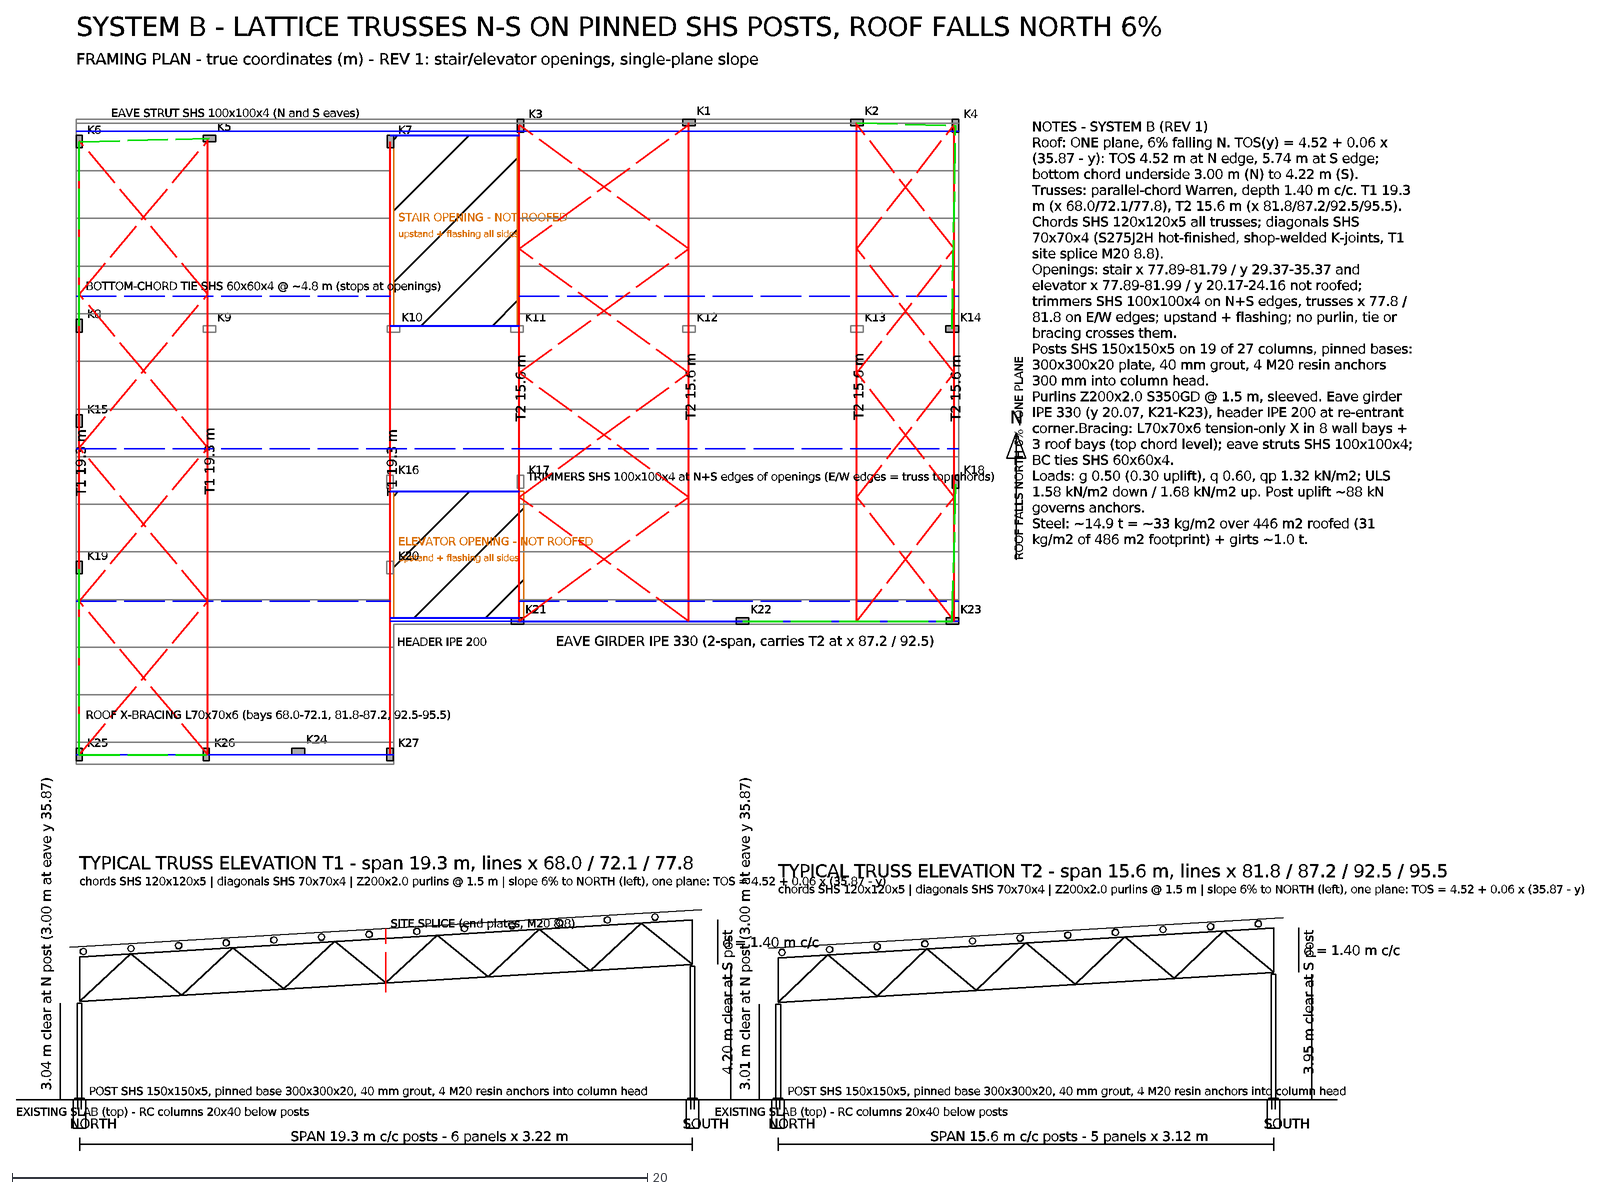
[picture p50: CAD file, 2026-09-27]
roof/systems/B_truss.dxf
STAIR OPENING - NOT ROOFED
upstand + flashing all sides
ELEVATOR OPENING - NOT ROOFED
K1
K2
K3
K4
K5
K6
K7
K8
K9
K10
K11
K12
K13
K14
K15
K16
K17
K18
K19
K20
K21
K22
K23
K24
K25
K26
K27
T1 19.3 m
T2 15.6 m
EAVE GIRDER IPE 330 (2-span, carries T2 at x 87.2 / 92.5)
HEADER IPE 200
EAVE STRUT SHS 100x100x4 (N and S eaves)
TRIMMERS SHS 100x100x4 at N+S edges of openings (E/W edges = truss top chords)
BOTTOM-CHORD TIE SHS 60x60x4 @ ~4.8 m (stops at openings)
ROOF X-BRACING L70x70x6 (bays 68.0-72.1, 81.8-87.2, 92.5-95.5)
N
ROOF FALLS NORTH 6% - ONE PLANE
SYSTEM B - LATTICE TRUSSES N-S ON PINNED SHS POSTS, ROOF FALLS NORTH 6%
FRAMING PLAN - true coordinates (m) - REV 1: stair/elevator openings, single-plane slope
NOTES - SYSTEM B (REV 1) Roof: ONE plane, 6% falling N. TOS(y) = 4.52 + 0.06 x (35.87 - y): TOS 4.52 m at N edge, 5.74 m at S edge; bottom chord underside 3.00 
EXISTING SLAB (top) - RC columns 20x40 below posts
SITE SPLICE (end plates, M20 8.8)
SPAN 19.3 m c/c posts - 6 panels x 3.22 m
d = 1.40 m c/c
3.04 m clear at N post (3.00 m at eave y 35.87)
4.20 m clear at S post
TYPICAL TRUSS ELEVATION T1 - span 19.3 m, lines x 68.0 / 72.1 / 77.8
chords SHS 120x120x5 | diagonals SHS 70x70x4 | Z200x2.0 purlins @ 1.5 m | slope 6% to NORTH (left), one plane: TOS = 4.52 + 0.06 x (35.87 - y)
POST SHS 150x150x5, pinned base 300x300x20, 40 mm grout, 4 M20 resin anchors into column head
NORTH
SOUTH
SPAN 15.6 m c/c posts - 5 panels x 3.12 m
3.01 m clear at N post (3.00 m at eave y 35.87)
3.95 m clear at S post
TYPICAL TRUSS ELEVATION T2 - span 15.6 m, lines x 81.8 / 87.2 / 92.5 / 95.5
