loka92/test1strsteel/roof/systems/A_portal.dxf

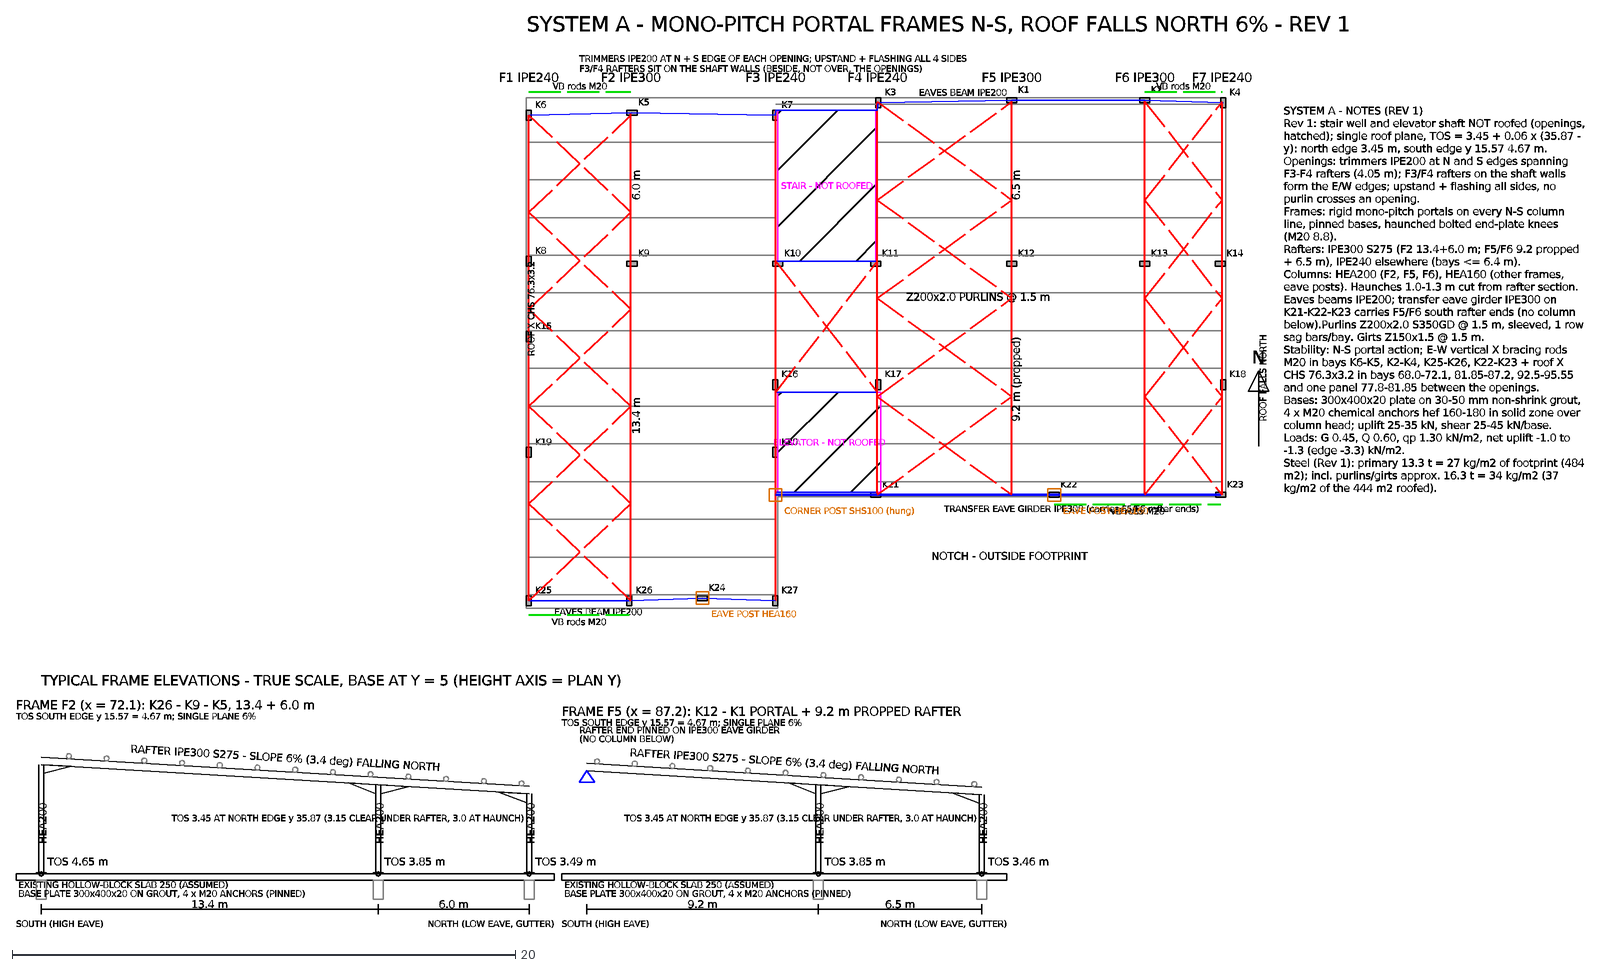
[picture p51: CAD file, 2026-09-27]
roof/systems/A_portal.dxf
K1
K2
K3
K4
K5
K6
K7
K8
K9
K10
K11
K12
K13
K14
K15
K16
K17
K18
K19
K20
K21
K22
K23
K24
K25
K26
K27
Z200x2.0 PURLINS @ 1.5 m
STAIR - NOT ROOFED
ELEVATOR - NOT ROOFED
TRIMMERS IPE200 AT N + S EDGE OF EACH OPENING; UPSTAND + FLASHING ALL 4 SIDES
F3/F4 RAFTERS SIT ON THE SHAFT WALLS (BESIDE, NOT OVER, THE OPENINGS)
F1 IPE240
F2 IPE300
F3 IPE240
F4 IPE240
F5 IPE300
F6 IPE300
F7 IPE240
EAVES BEAM IPE200
TRANSFER EAVE GIRDER IPE300 (carries F5/F6 rafter ends)
ROOF X CHS 76.3x3.2
VB rods M20
EAVE POST HEA160
CORNER POST SHS100 (hung)
13.4 m
6.0 m
9.2 m (propped)
6.5 m
NOTCH - OUTSIDE FOOTPRINT
SYSTEM A - MONO-PITCH PORTAL FRAMES N-S, ROOF FALLS NORTH 6% - REV 1
N
ROOF FALLS NORTH
SYSTEM A - NOTES (REV 1) Rev 1: stair well and elevator shaft NOT roofed (openings, hatched); single roof plane, TOS = 3.45 + 0.06 x (35.87 - y): north edge 3.4
EXISTING HOLLOW-BLOCK SLAB 250 (ASSUMED)
RAFTER IPE300 S275 - SLOPE 6% (3.4 deg) FALLING NORTH
HEA200
TOS 4.65 m
TOS 3.85 m
TOS 3.49 m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
