loka92/test1strsteel/roof/systems/C_postbeam.dxf

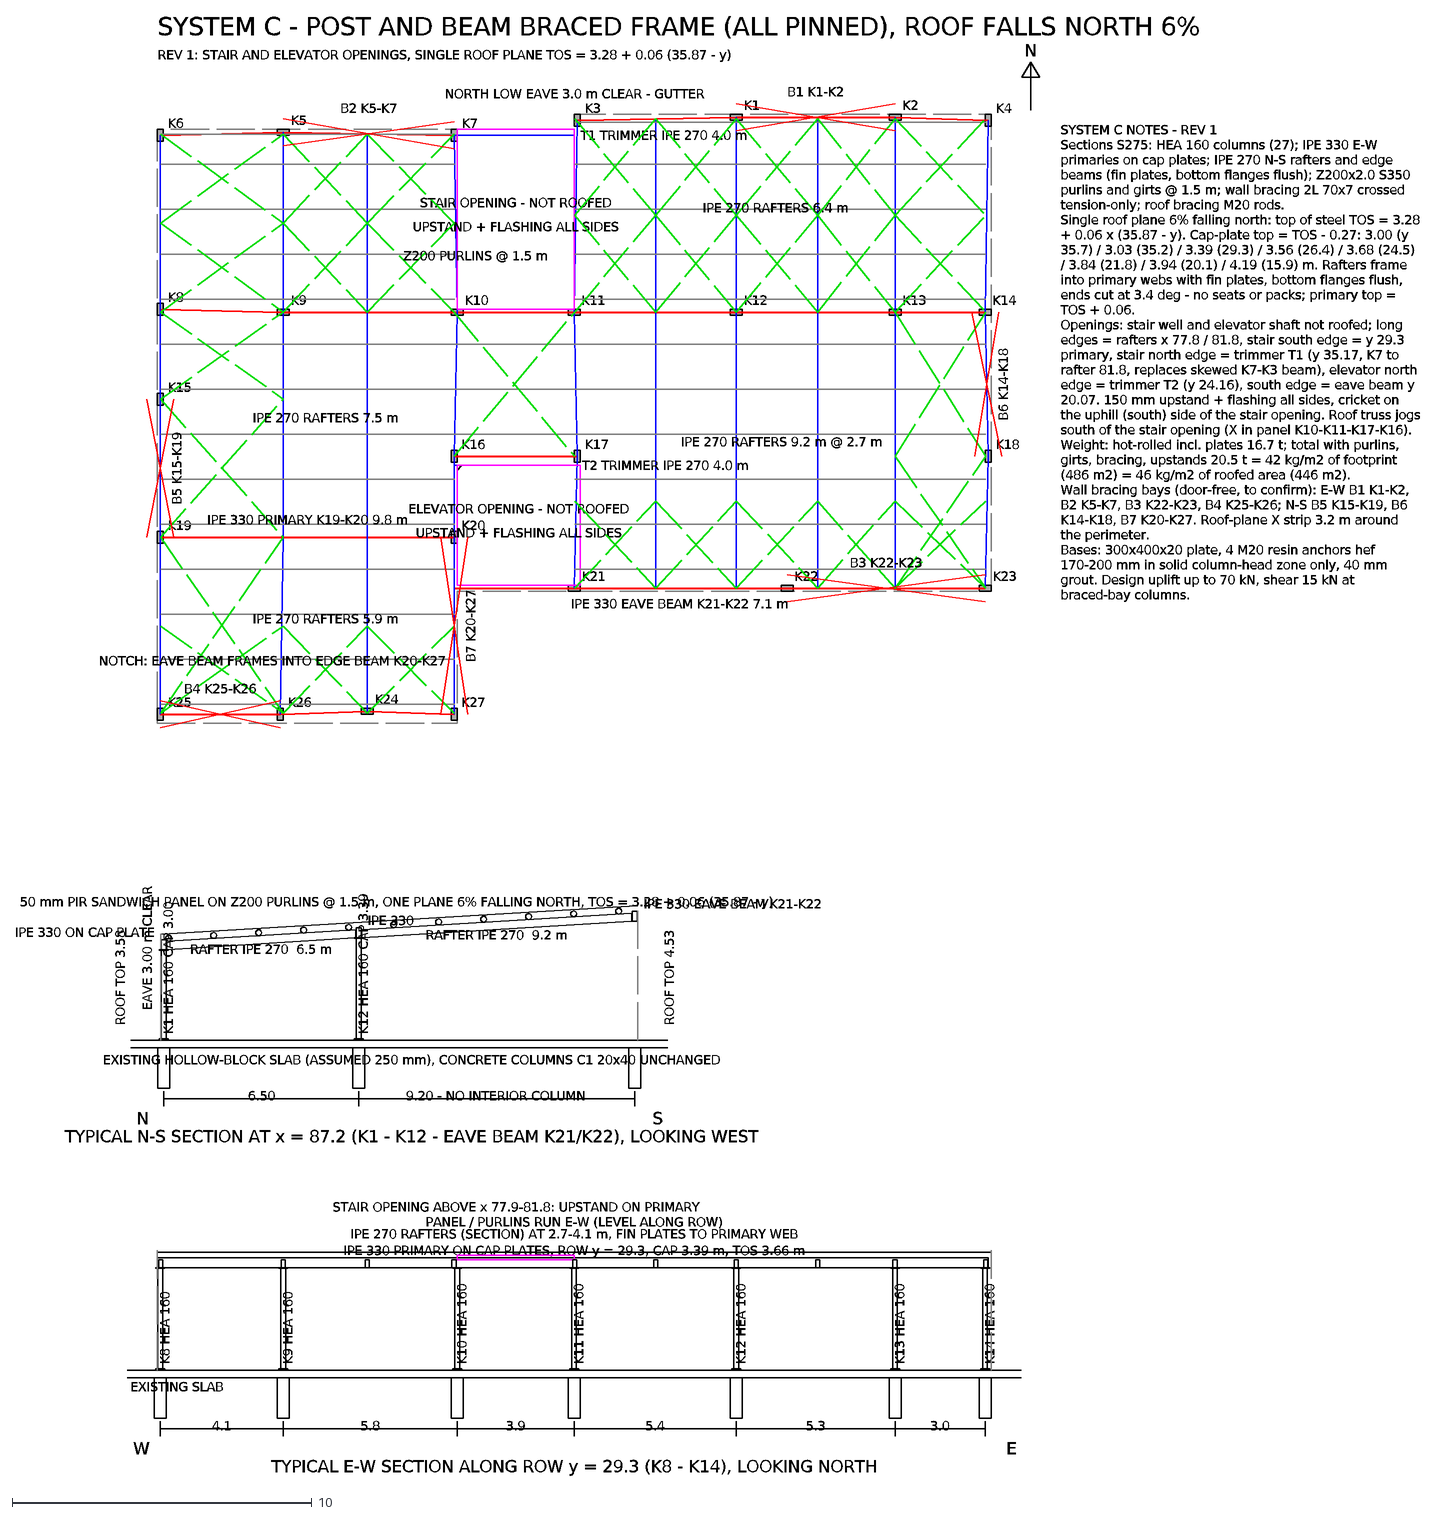
[picture p52: CAD file, 2026-09-27]
roof/systems/C_postbeam.dxf
K1
K2
K3
K4
K5
K6
K7
K8
K9
K10
K11
K12
K13
K14
K15
K16
K17
K18
K19
K20
K21
K22
K23
K24
K25
K26
K27
T1 TRIMMER IPE 270 4.0 m
T2 TRIMMER IPE 270 4.0 m
STAIR OPENING - NOT ROOFED
UPSTAND + FLASHING ALL SIDES
ELEVATOR OPENING - NOT ROOFED
B1 K1-K2
B2 K5-K7
B3 K22-K23
B4 K25-K26
B5 K15-K19
B6 K14-K18
B7 K20-K27
IPE 330 PRIMARY K19-K20 9.8 m
IPE 330 EAVE BEAM K21-K22 7.1 m
IPE 270 RAFTERS 9.2 m @ 2.7 m
IPE 270 RAFTERS 7.5 m
IPE 270 RAFTERS 5.9 m
IPE 270 RAFTERS 6.4 m
Z200 PURLINS @ 1.5 m
NOTCH: EAVE BEAM FRAMES INTO EDGE BEAM K20-K27
NORTH LOW EAVE 3.0 m CLEAR - GUTTER
SYSTEM C - POST AND BEAM BRACED FRAME (ALL PINNED), ROOF FALLS NORTH 6%
REV 1: STAIR AND ELEVATOR OPENINGS, SINGLE ROOF PLANE TOS = 3.28 + 0.06 (35.87 - y)
N
SYSTEM C NOTES - REV 1 Sections S275: HEA 160 columns (27); IPE 330 E-W primaries on cap plates; IPE 270 N-S rafters and edge beams (fin plates, bottom flanges 
EXISTING HOLLOW-BLOCK SLAB (ASSUMED 250 mm), CONCRETE COLUMNS C1 20x40 UNCHANGED
K1 HEA 160 CAP 3.00
K12 HEA 160 CAP 3.39
IPE 330 ON CAP PLATE
IPE 330
IPE 330 EAVE BEAM K21-K22
RAFTER IPE 270 6.5 m
RAFTER IPE 270 9.2 m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
