loka92/test1strsteel/(list of files, cad)

Other CAD files:
Drawing1.dxf
roof/detailing/C_detail_drawings.dxf
roof/systems/three_systems.dxf
