loka92/test1strsteel/roof/detailing/C_detail_drawings_A2.pdf

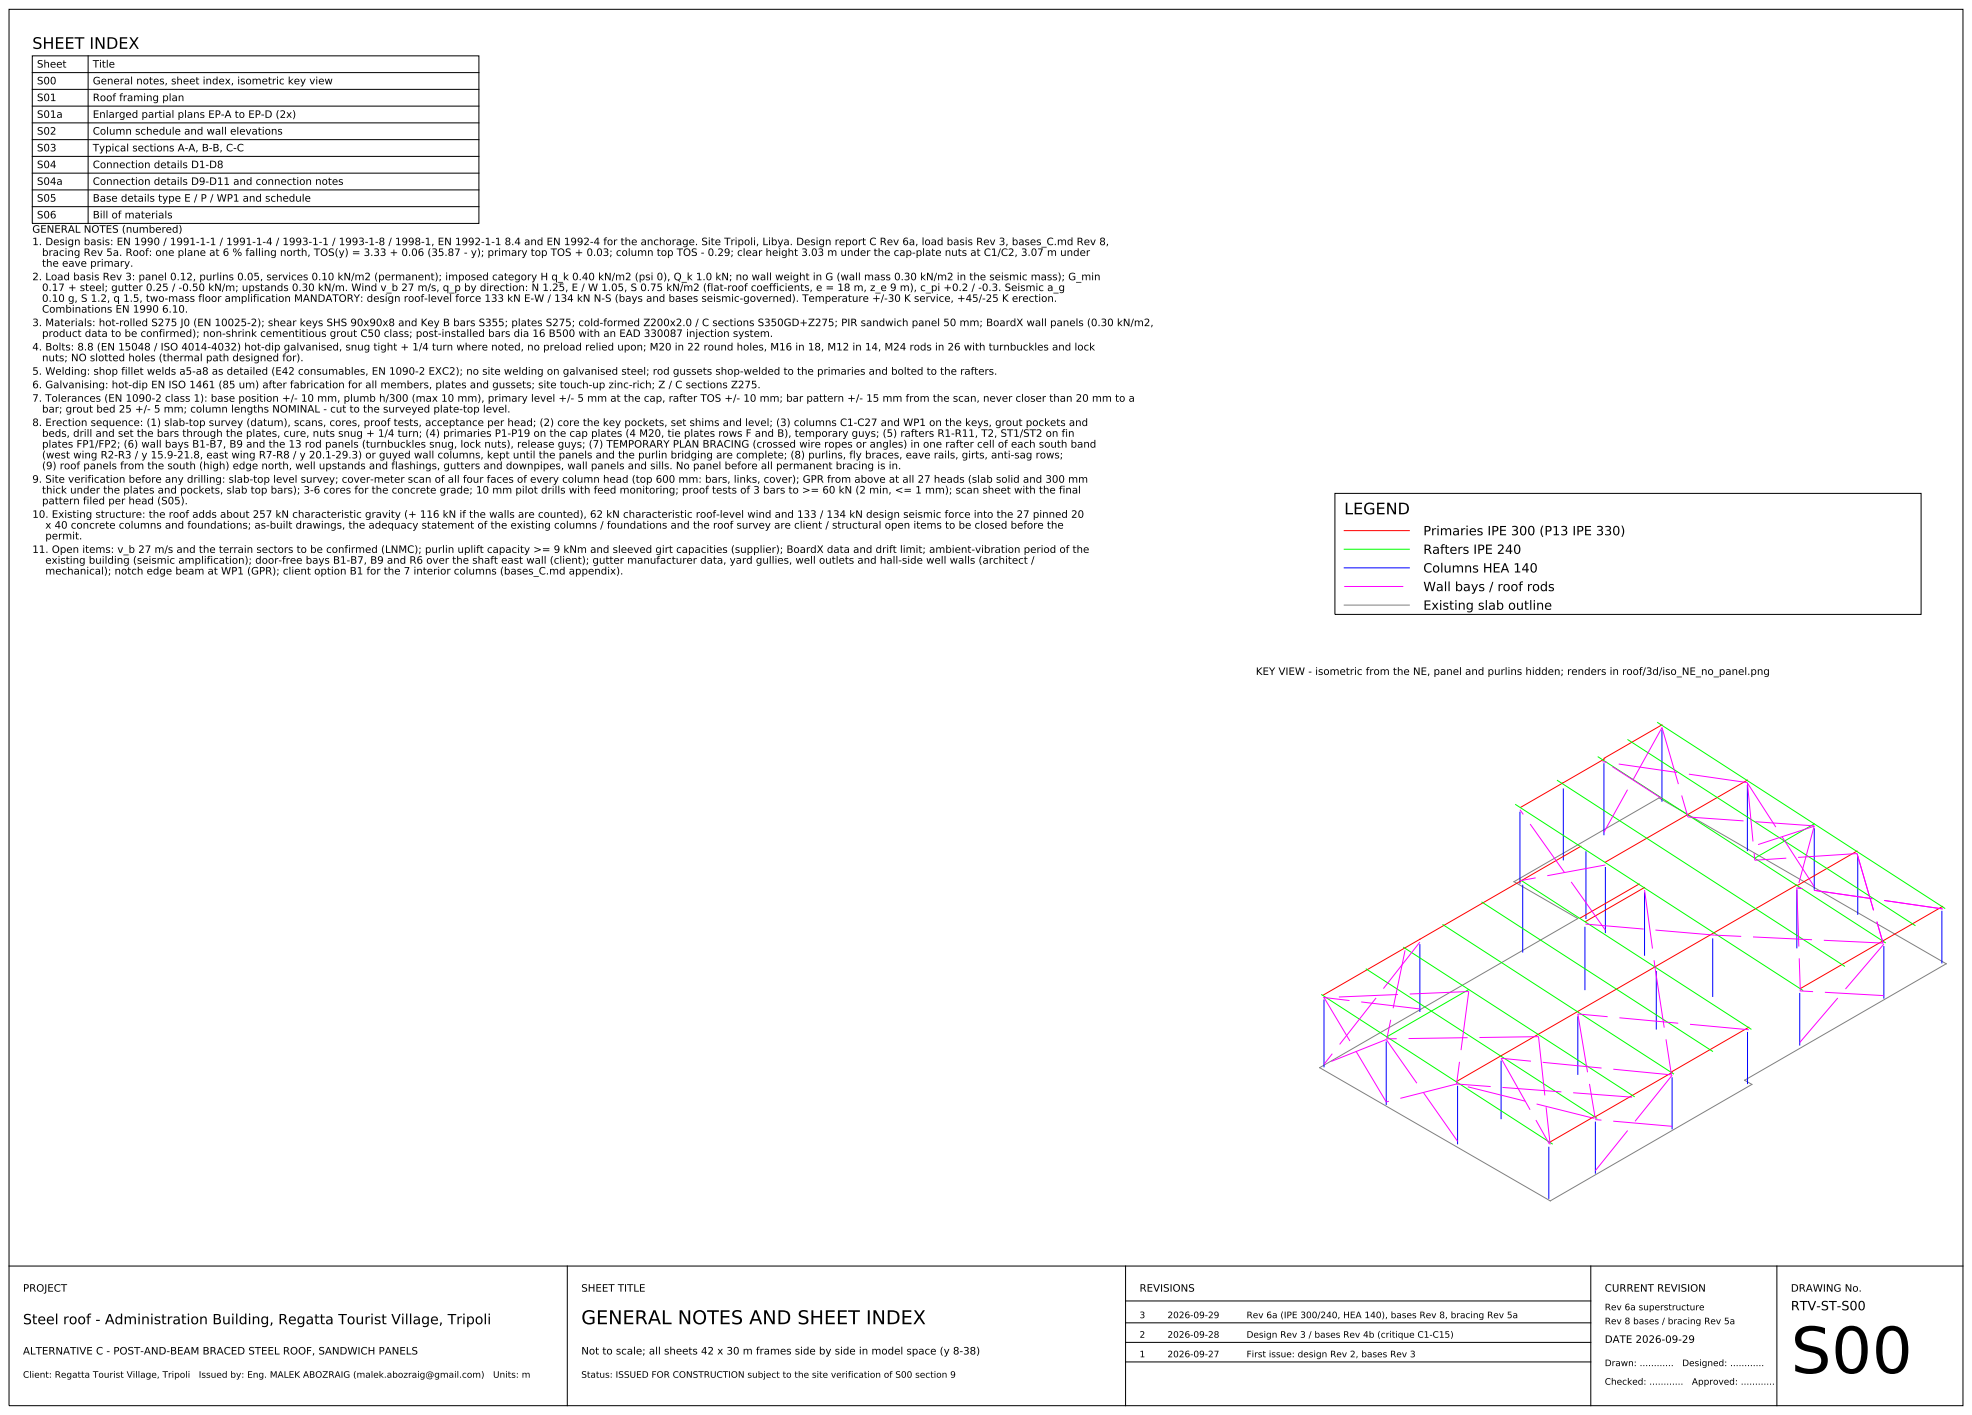
[picture p53: page 1]

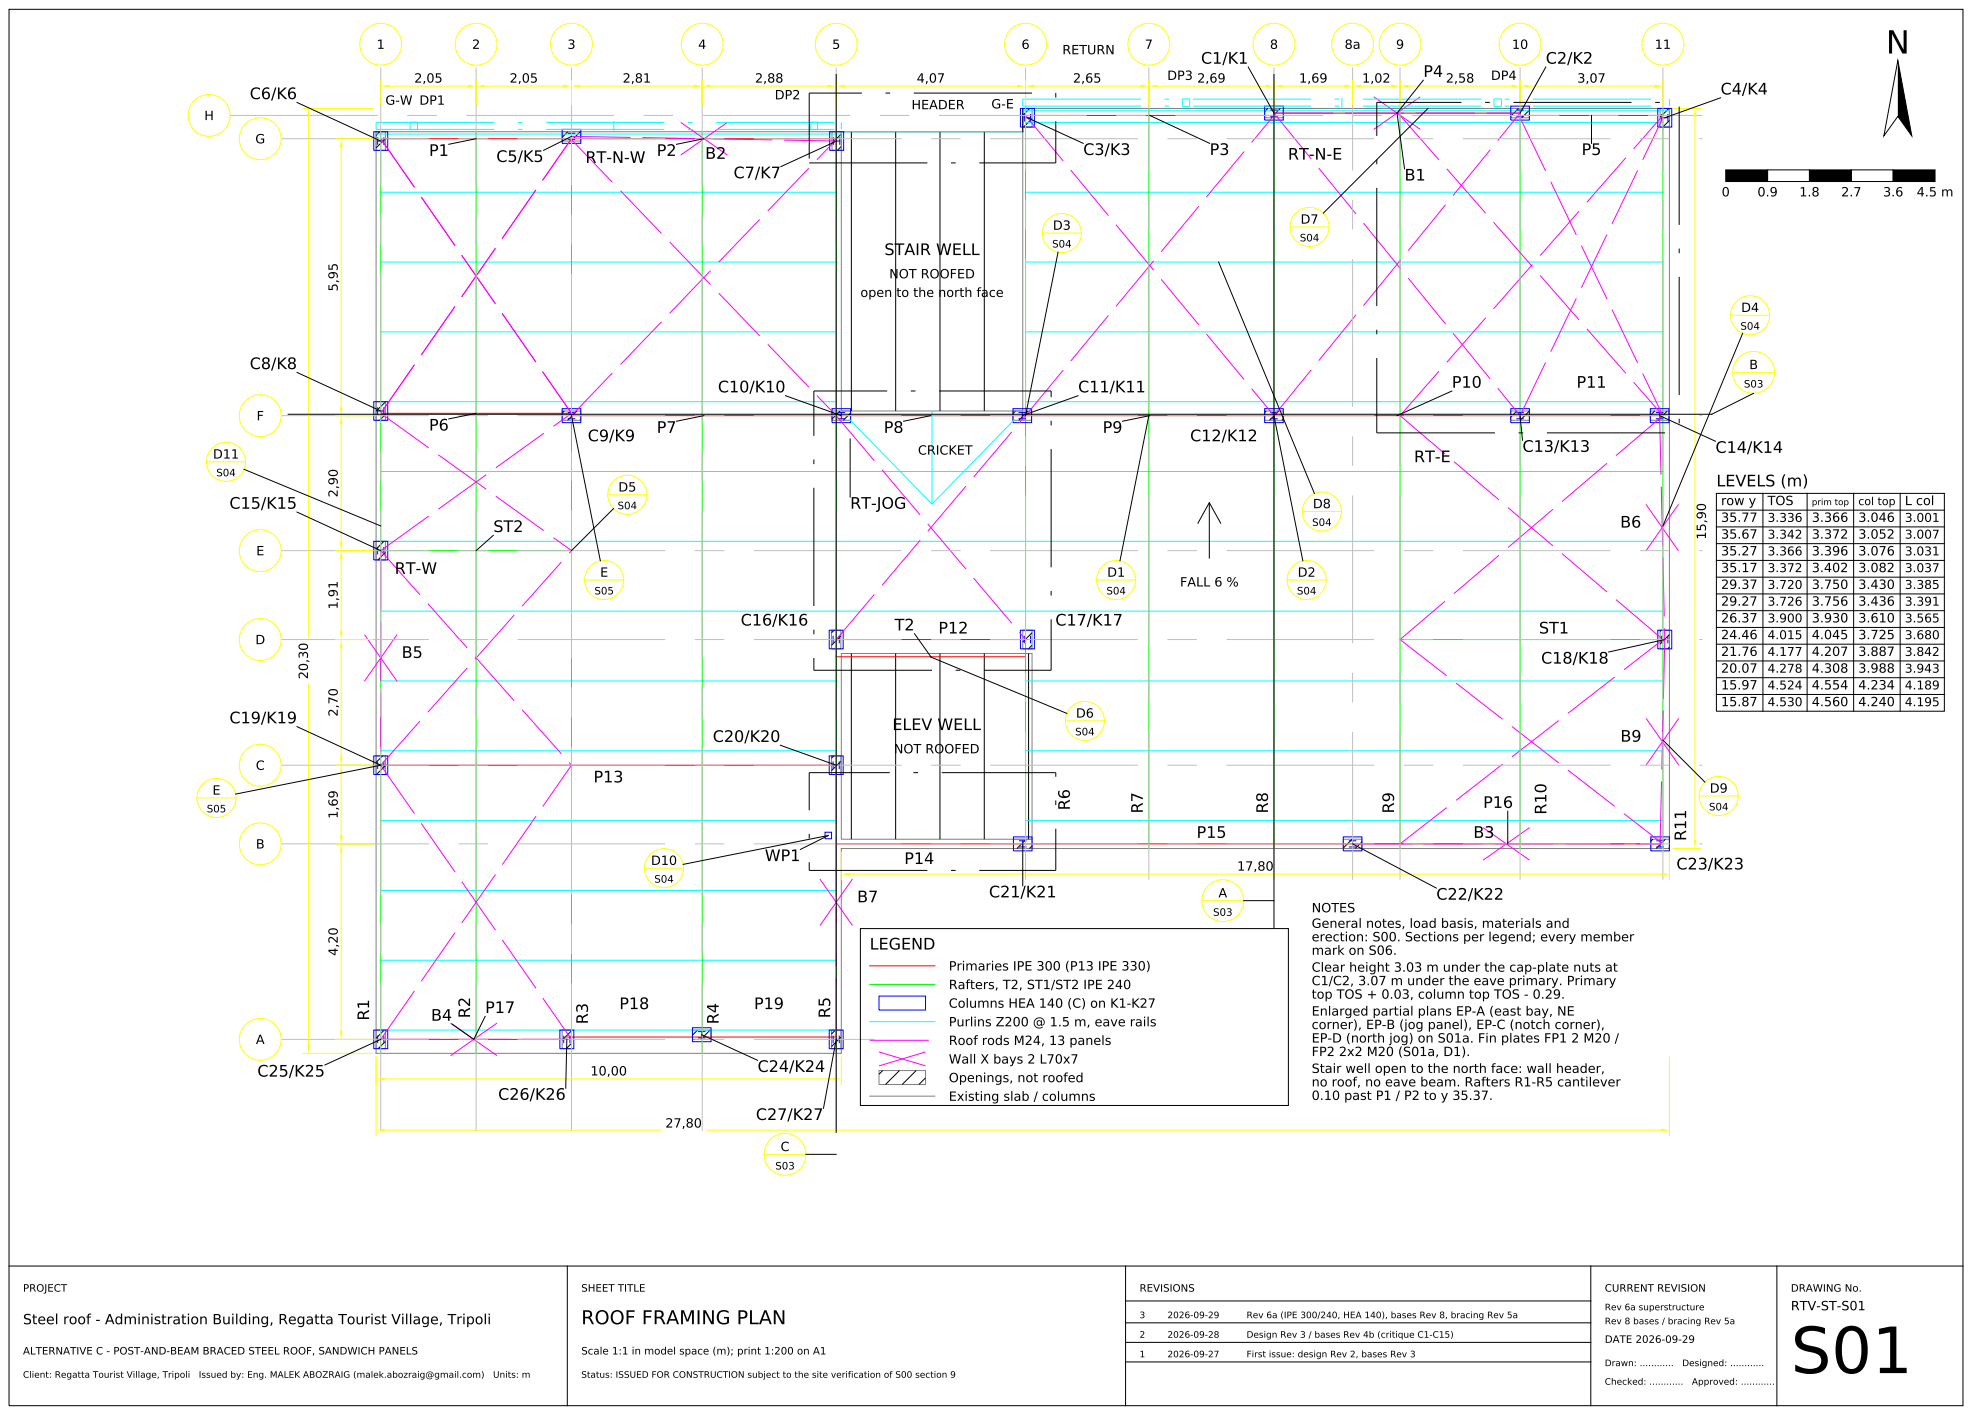
[picture p54: page 2]

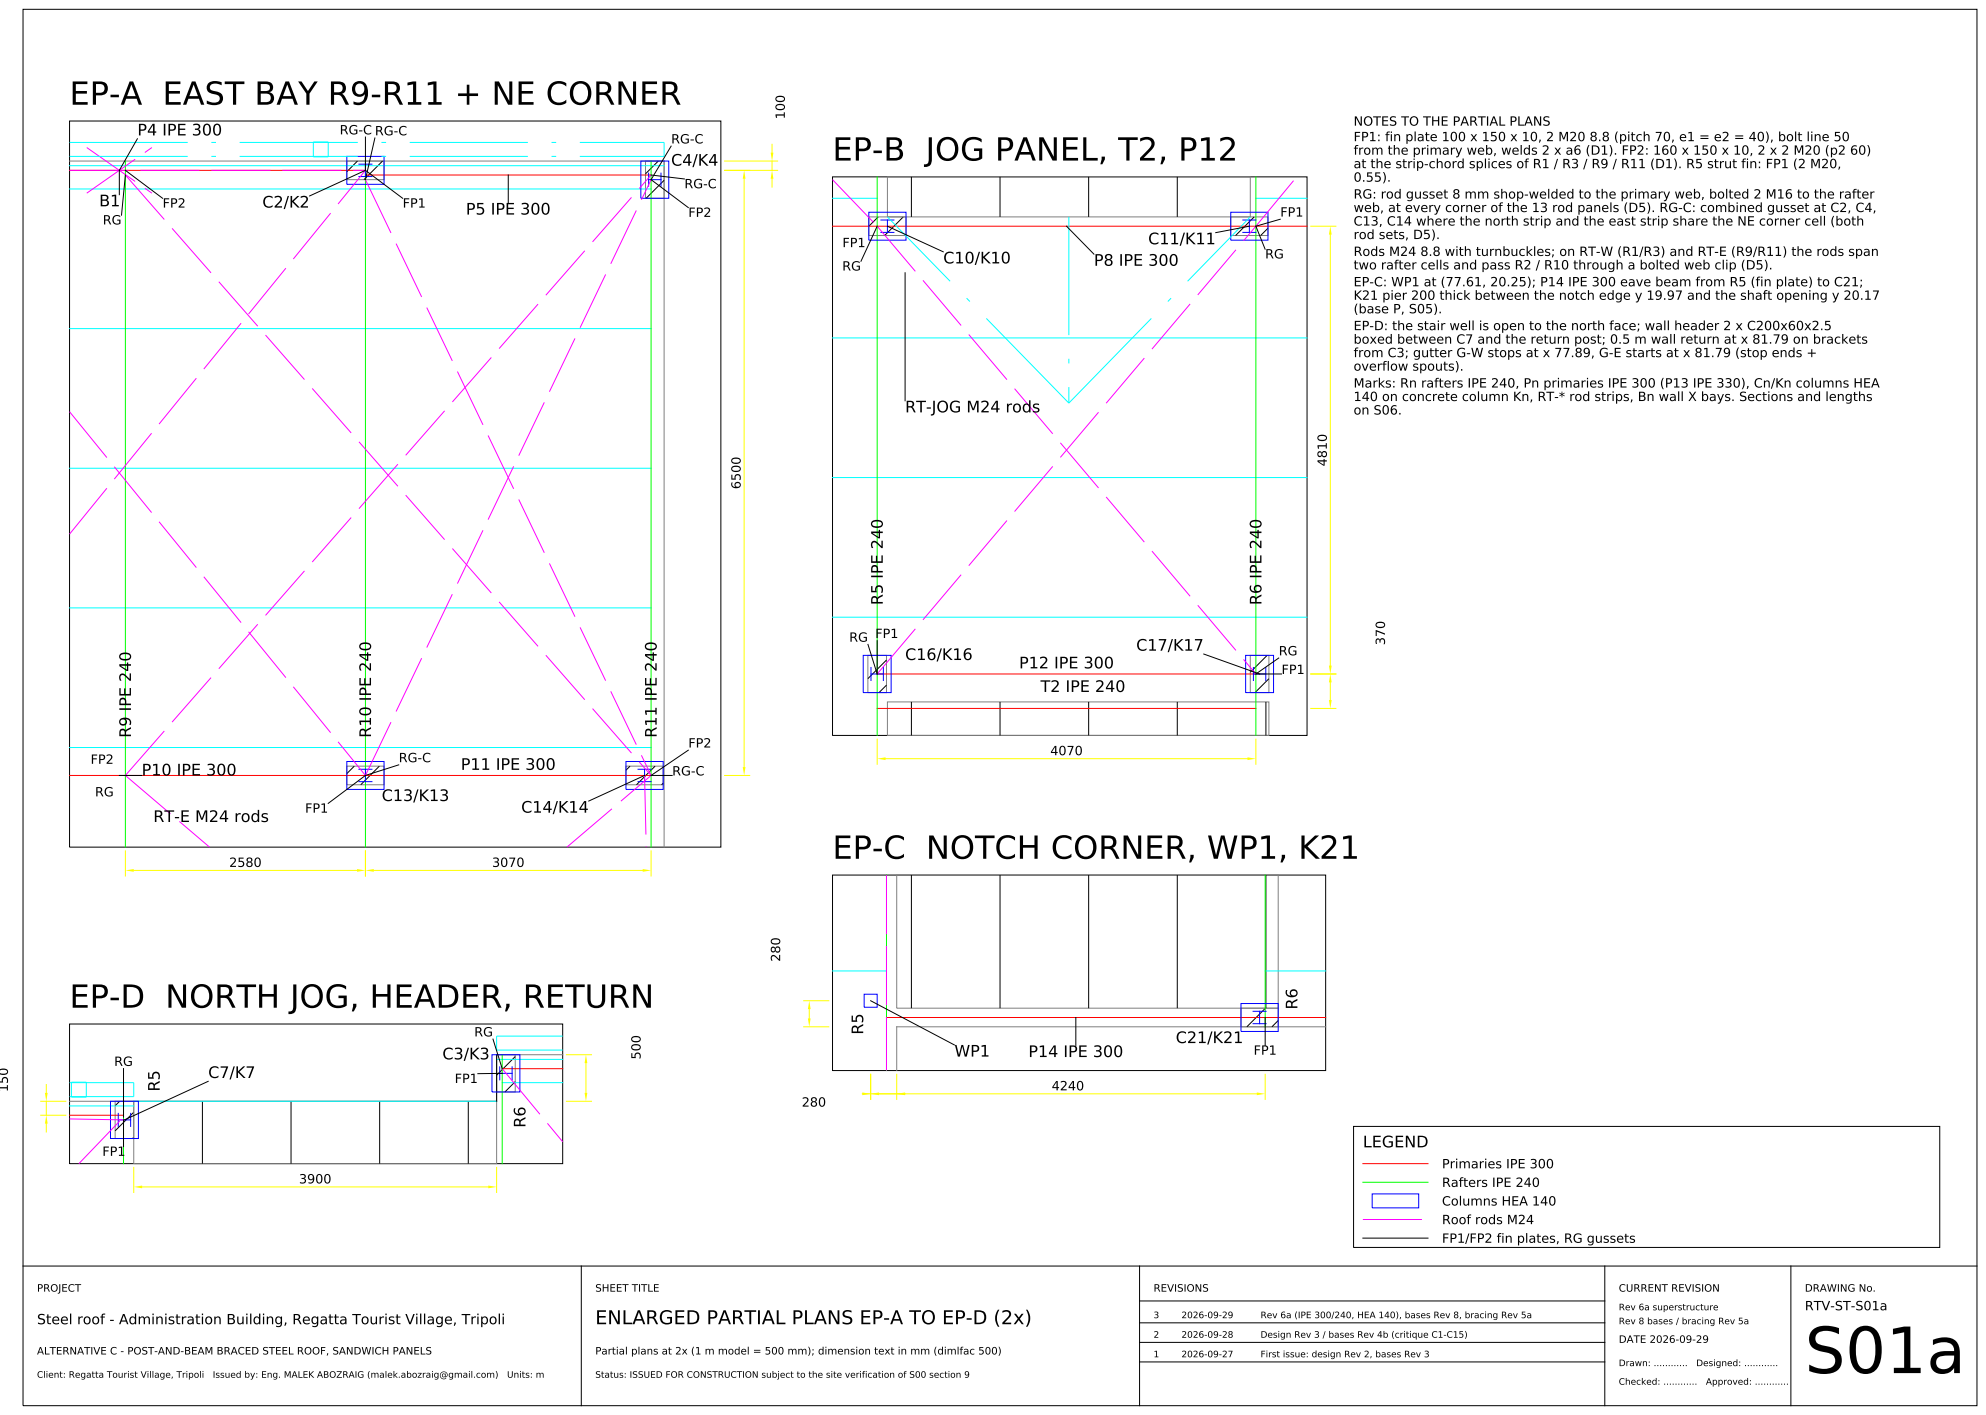
[picture p55: page 3]

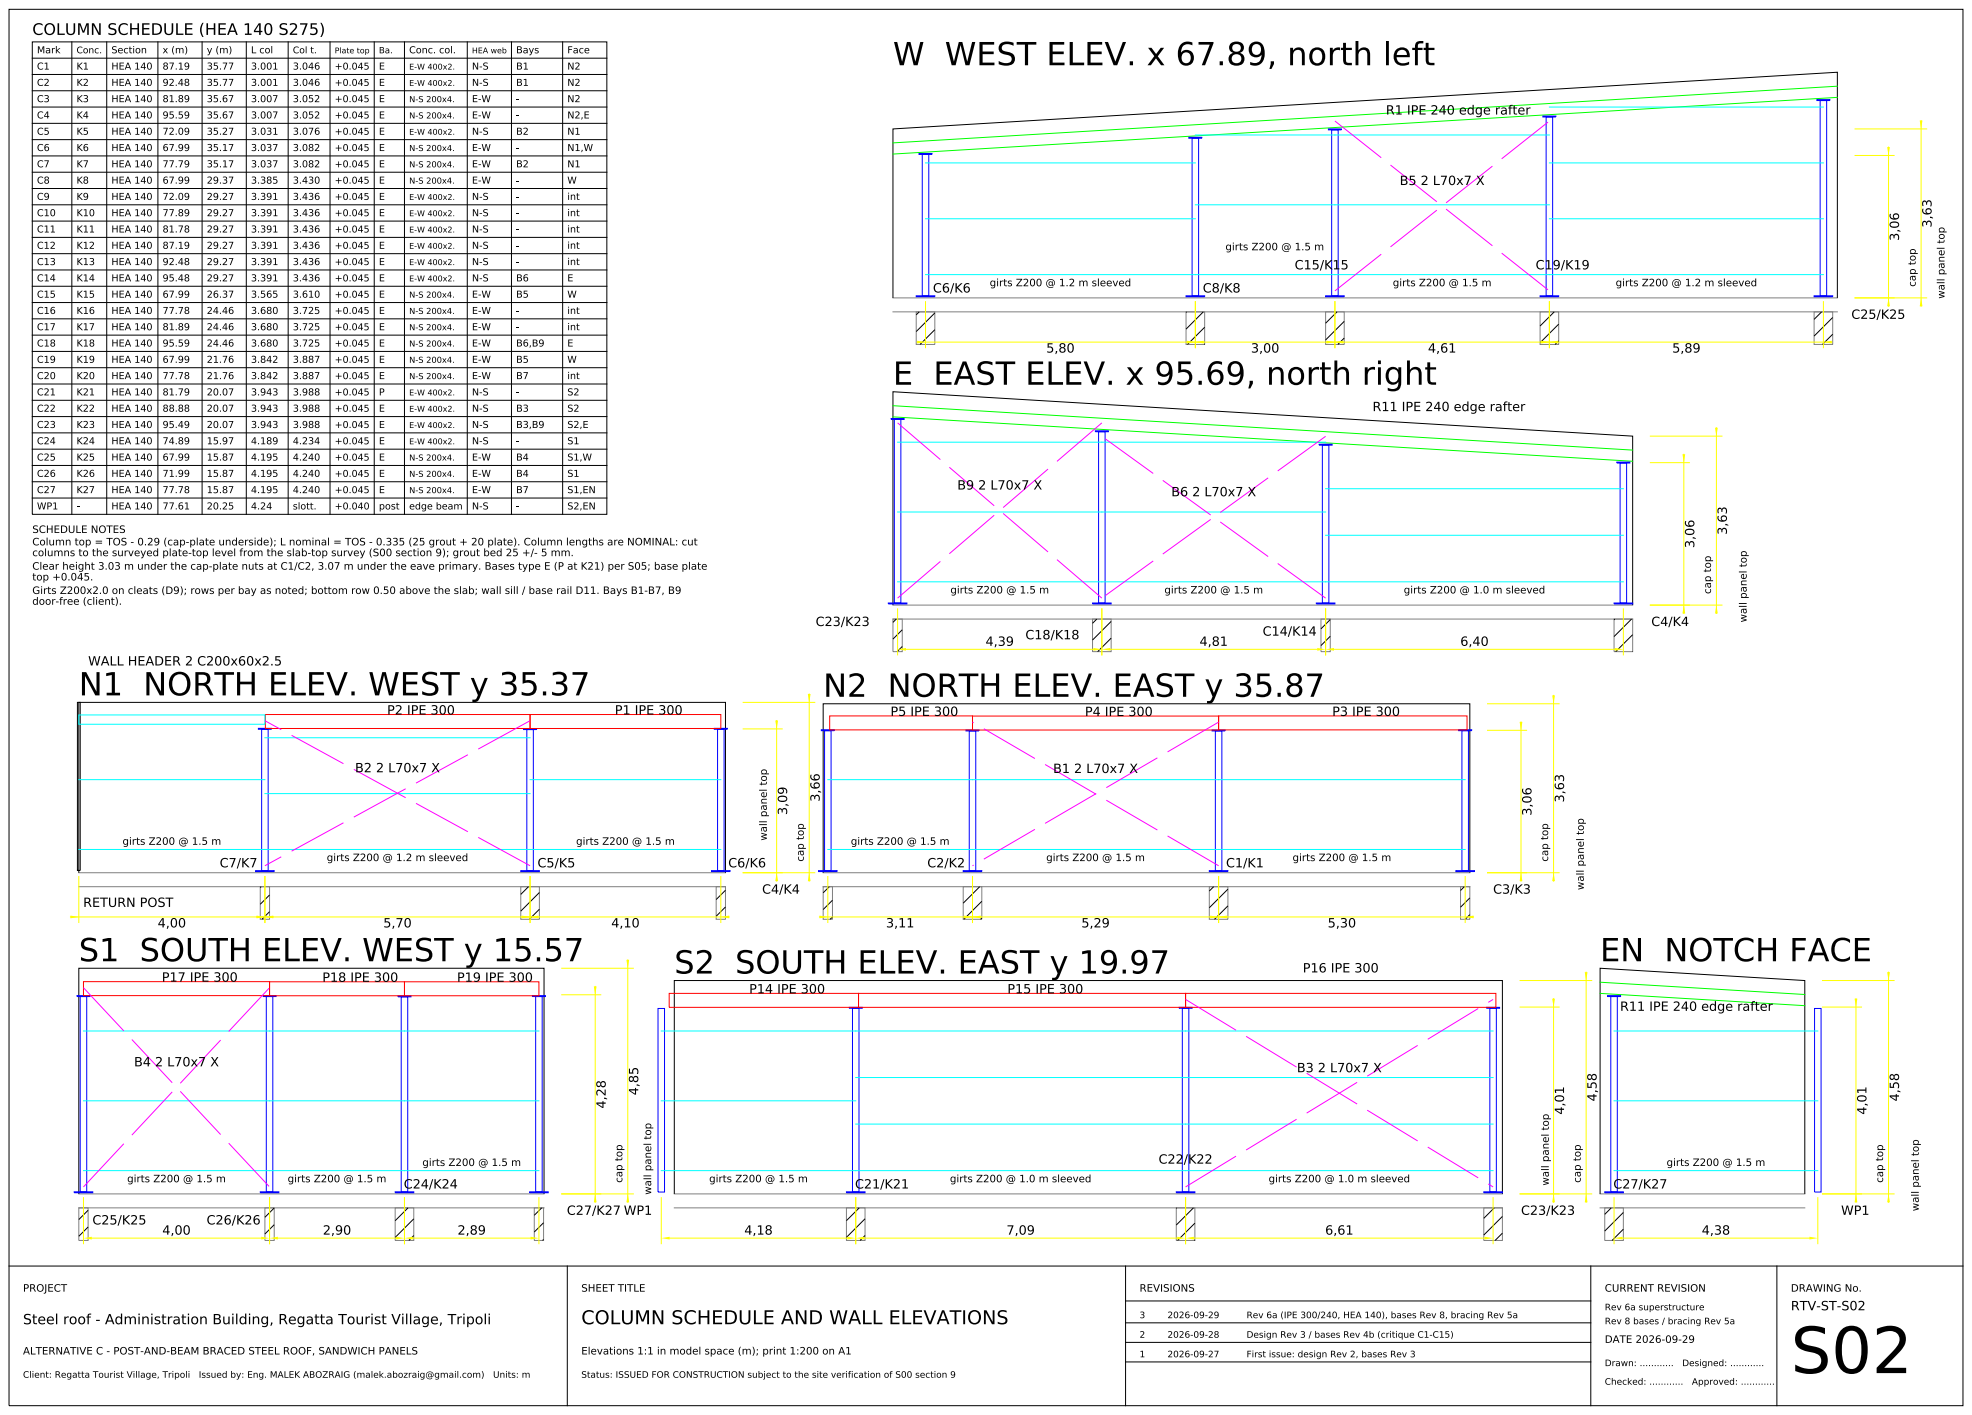
[picture p56: page 4]

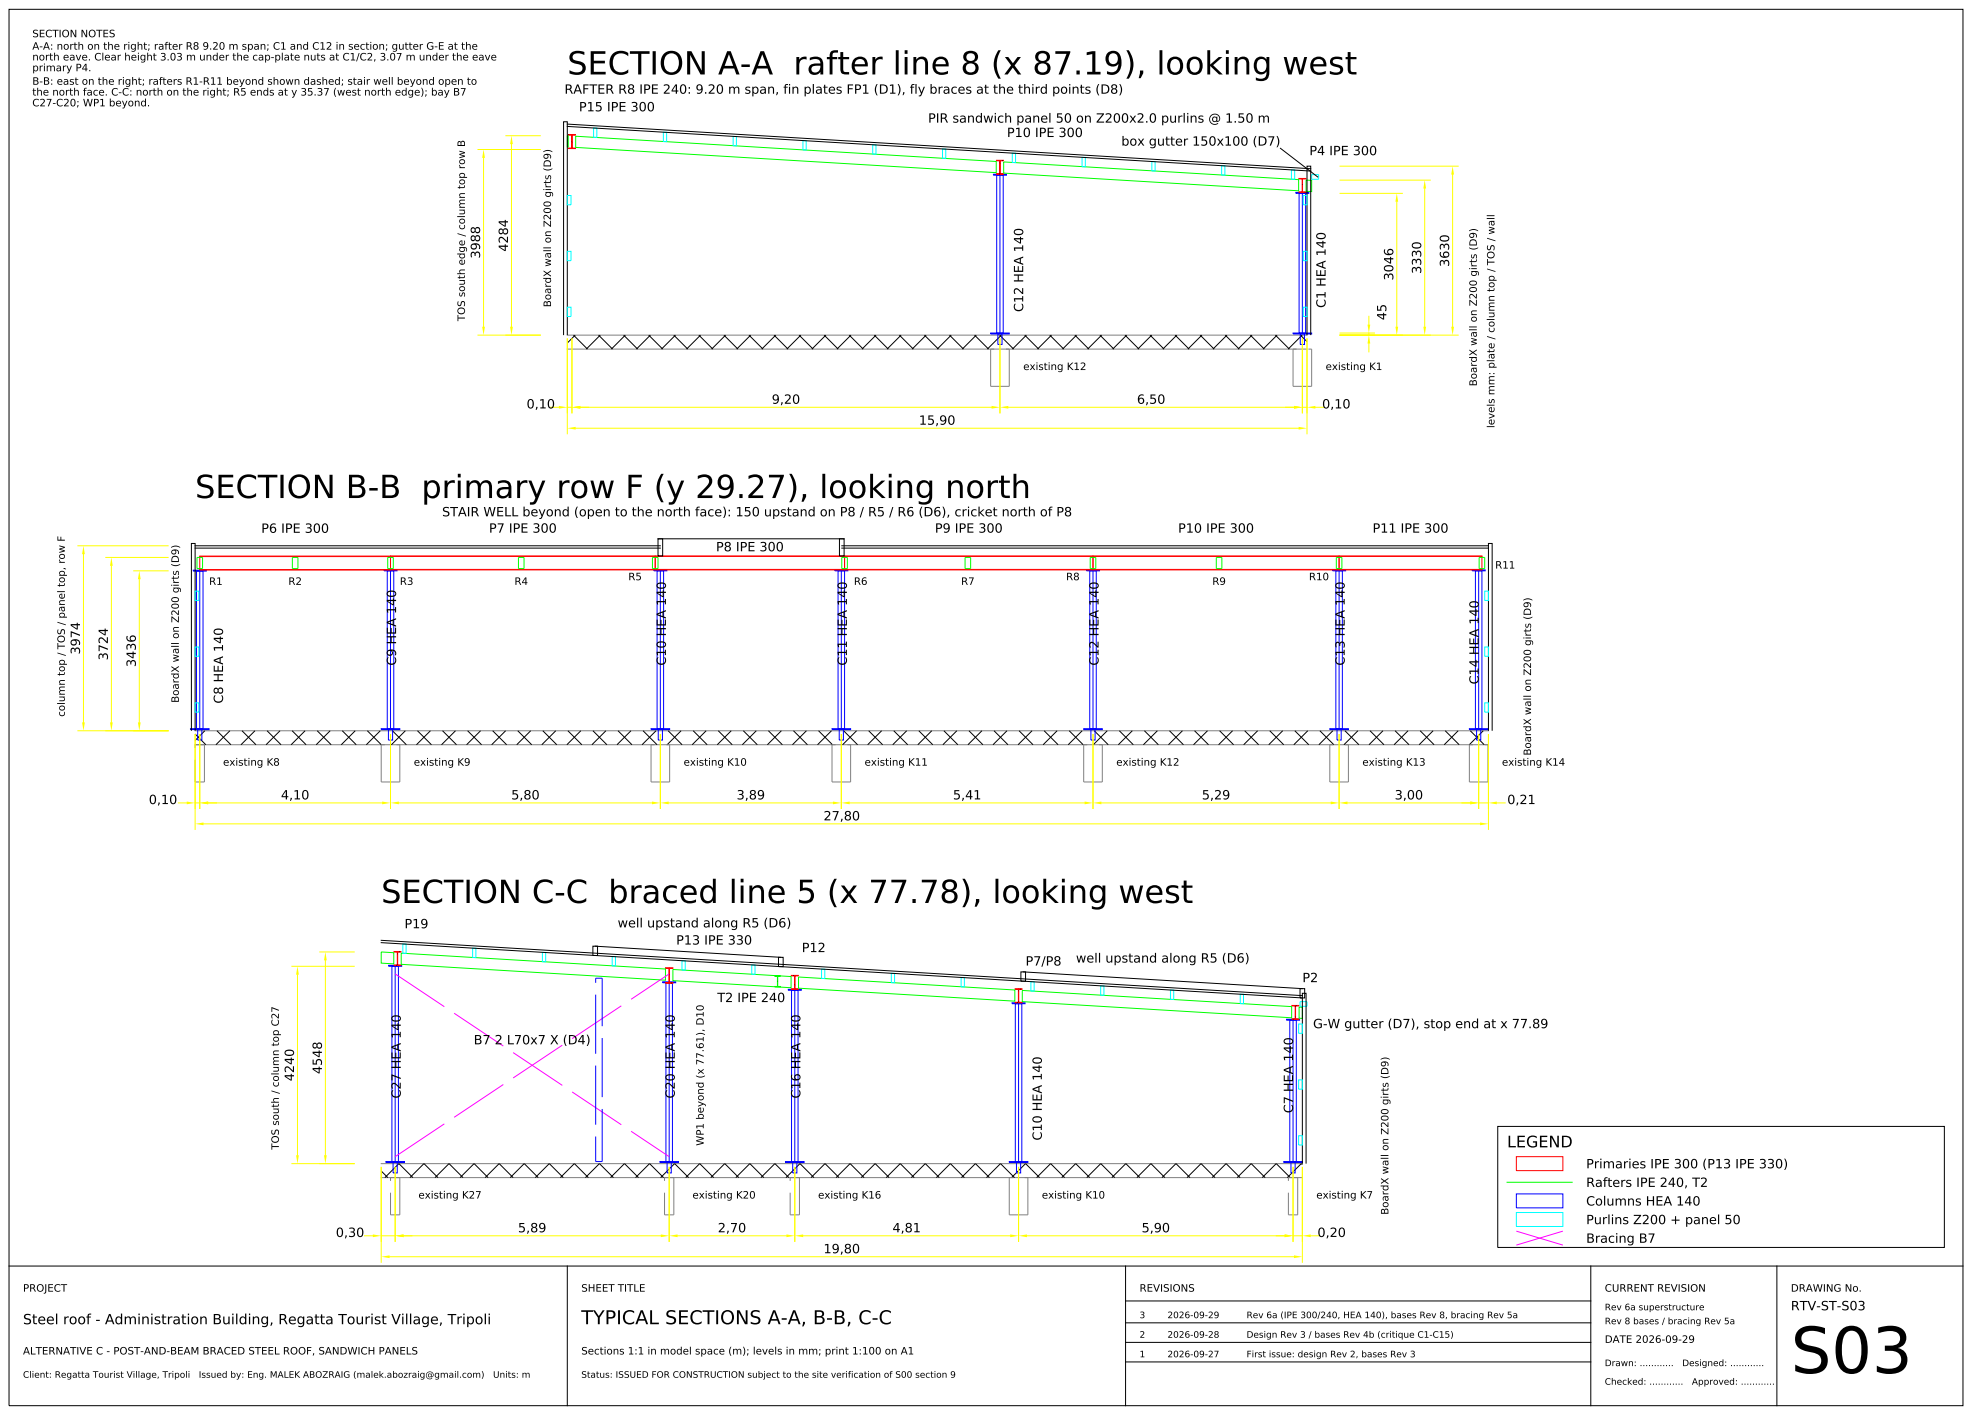
[picture p57: page 5]

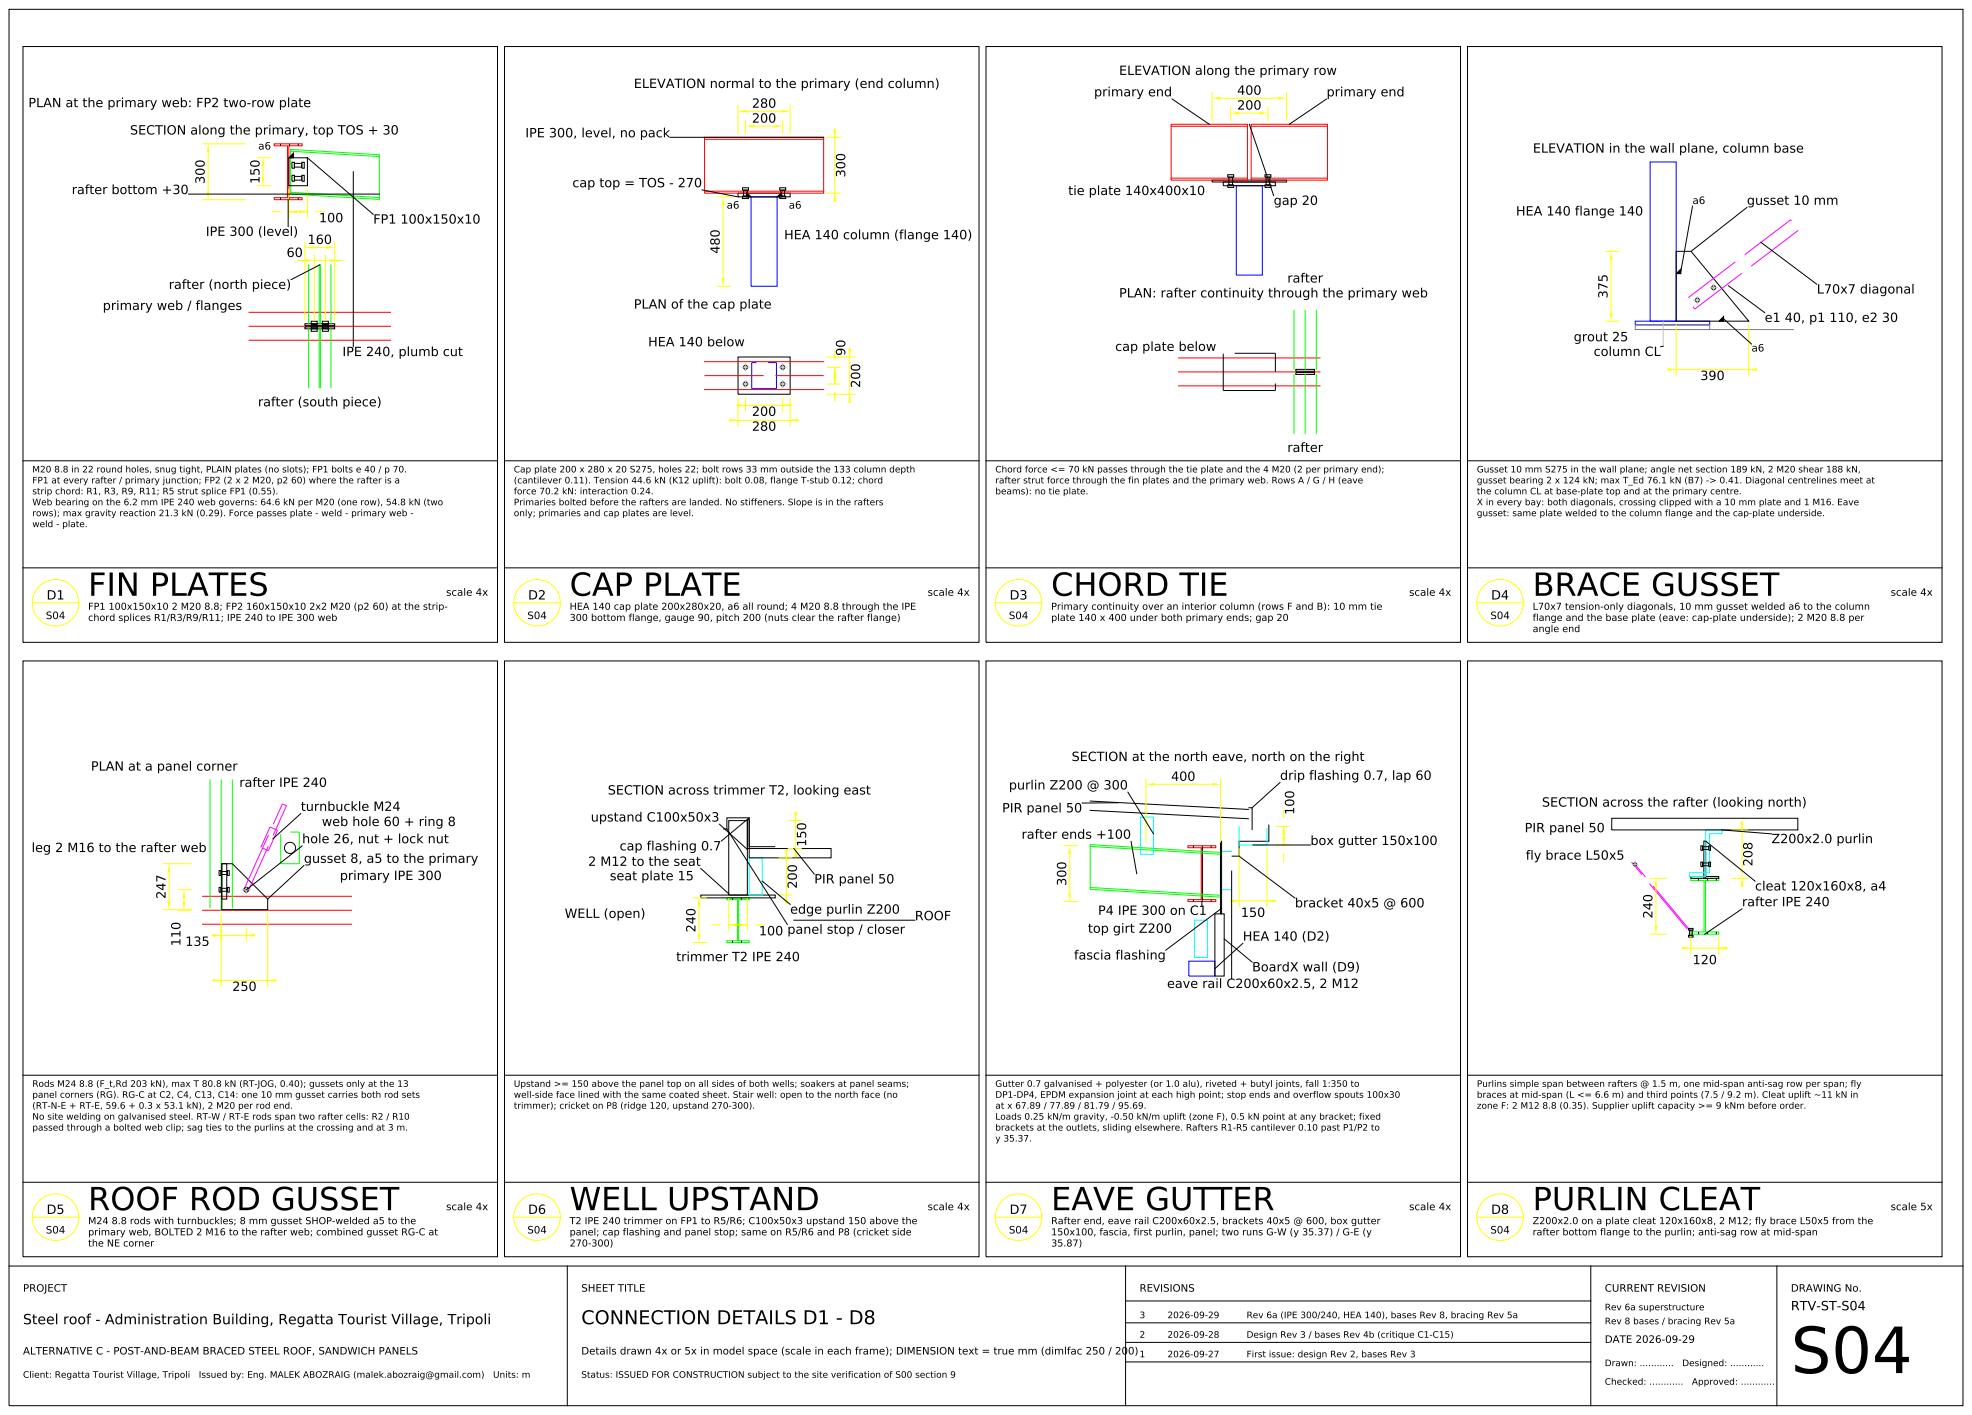
[picture p58: page 6]

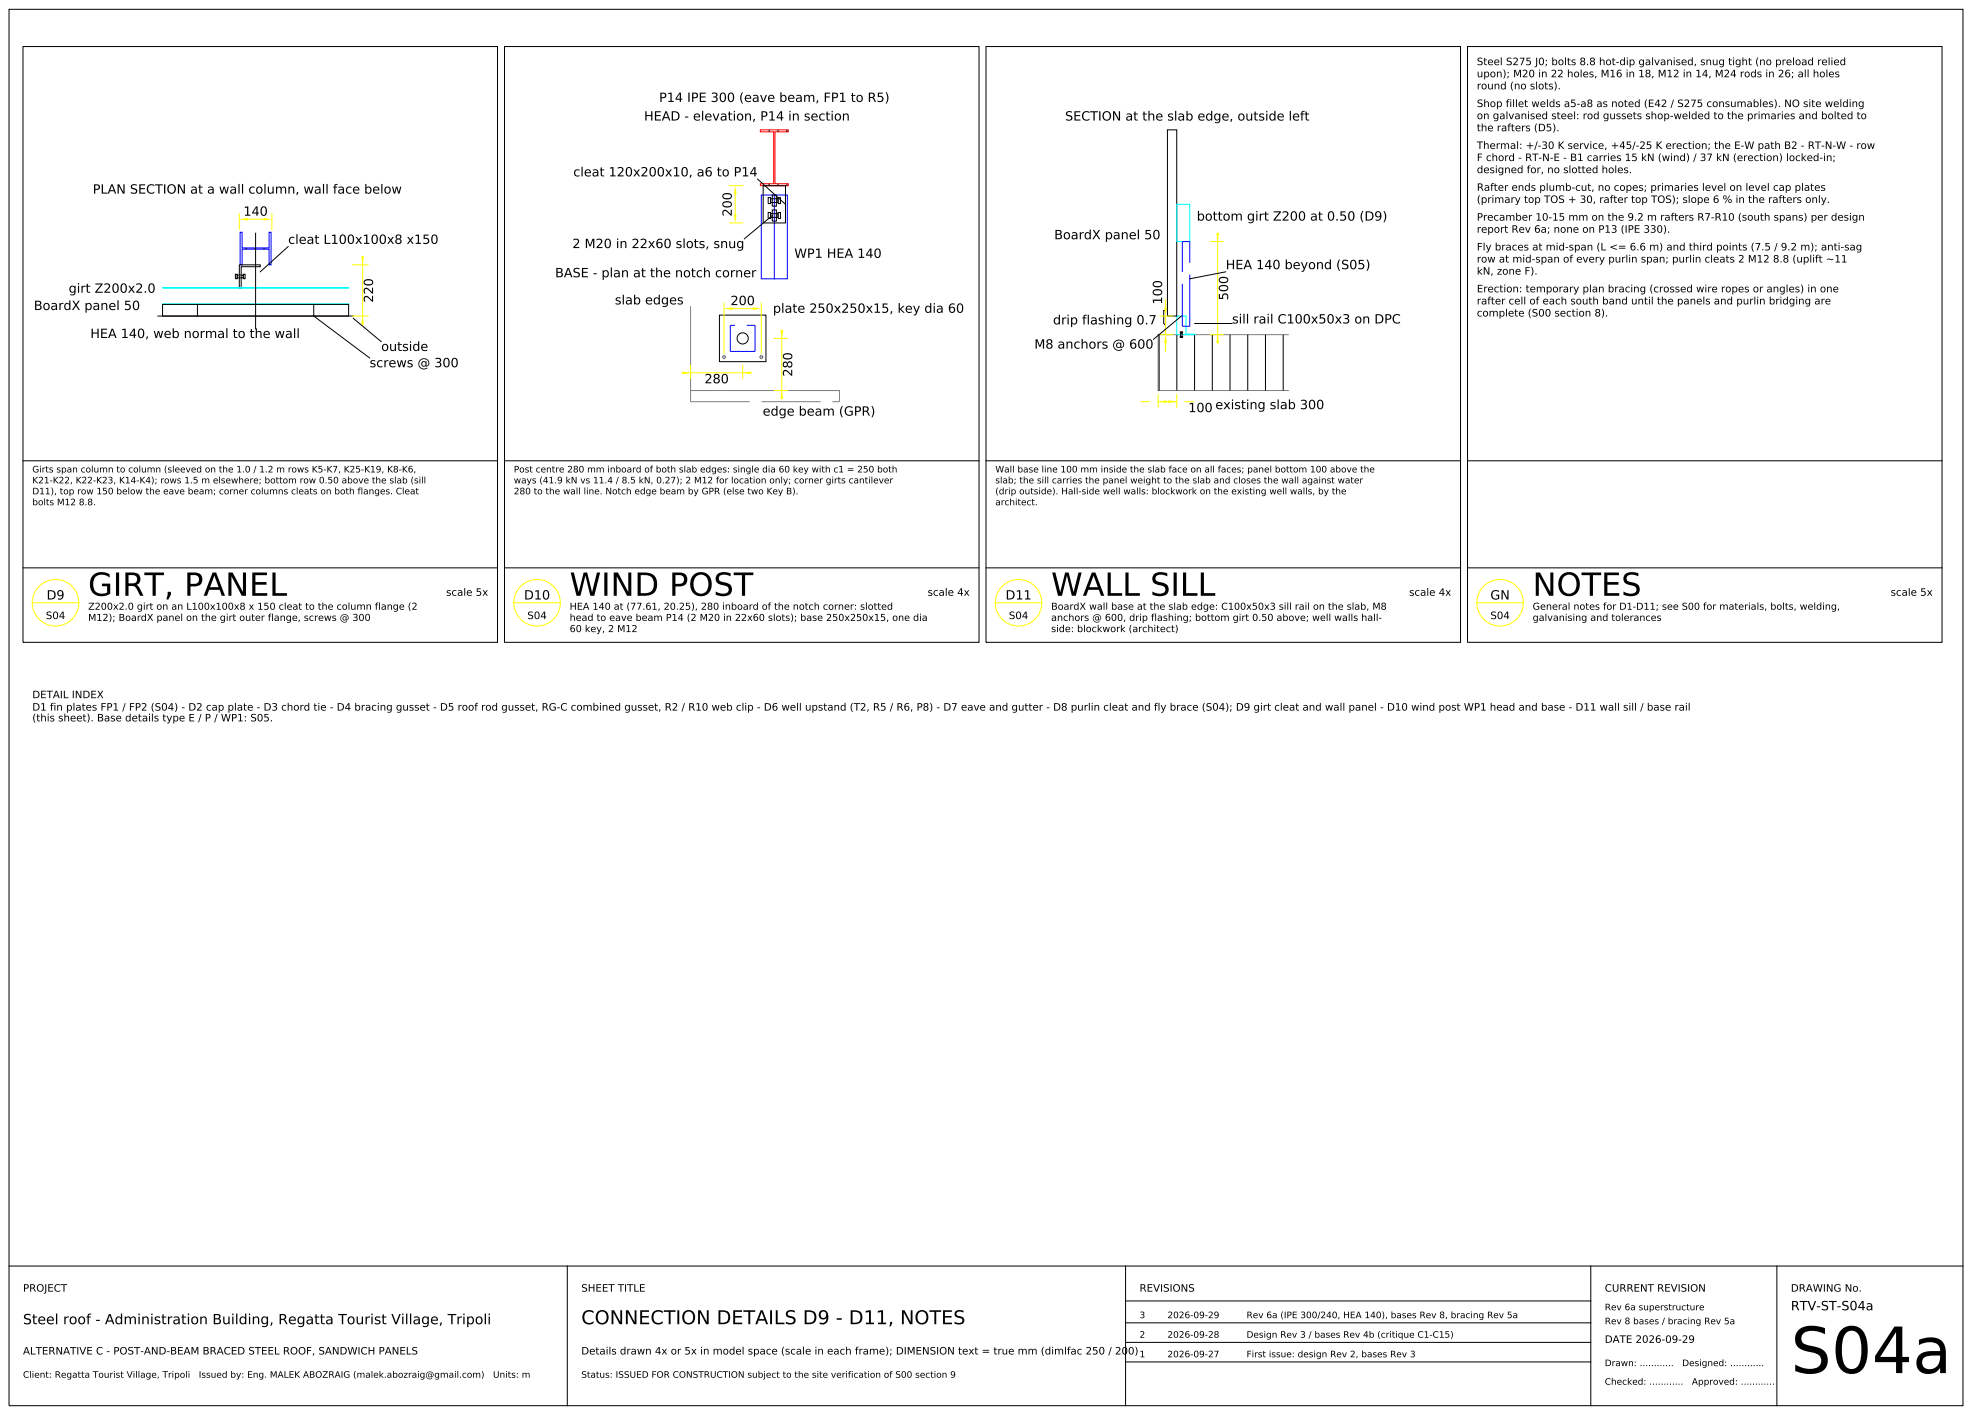
[picture p59: page 7]

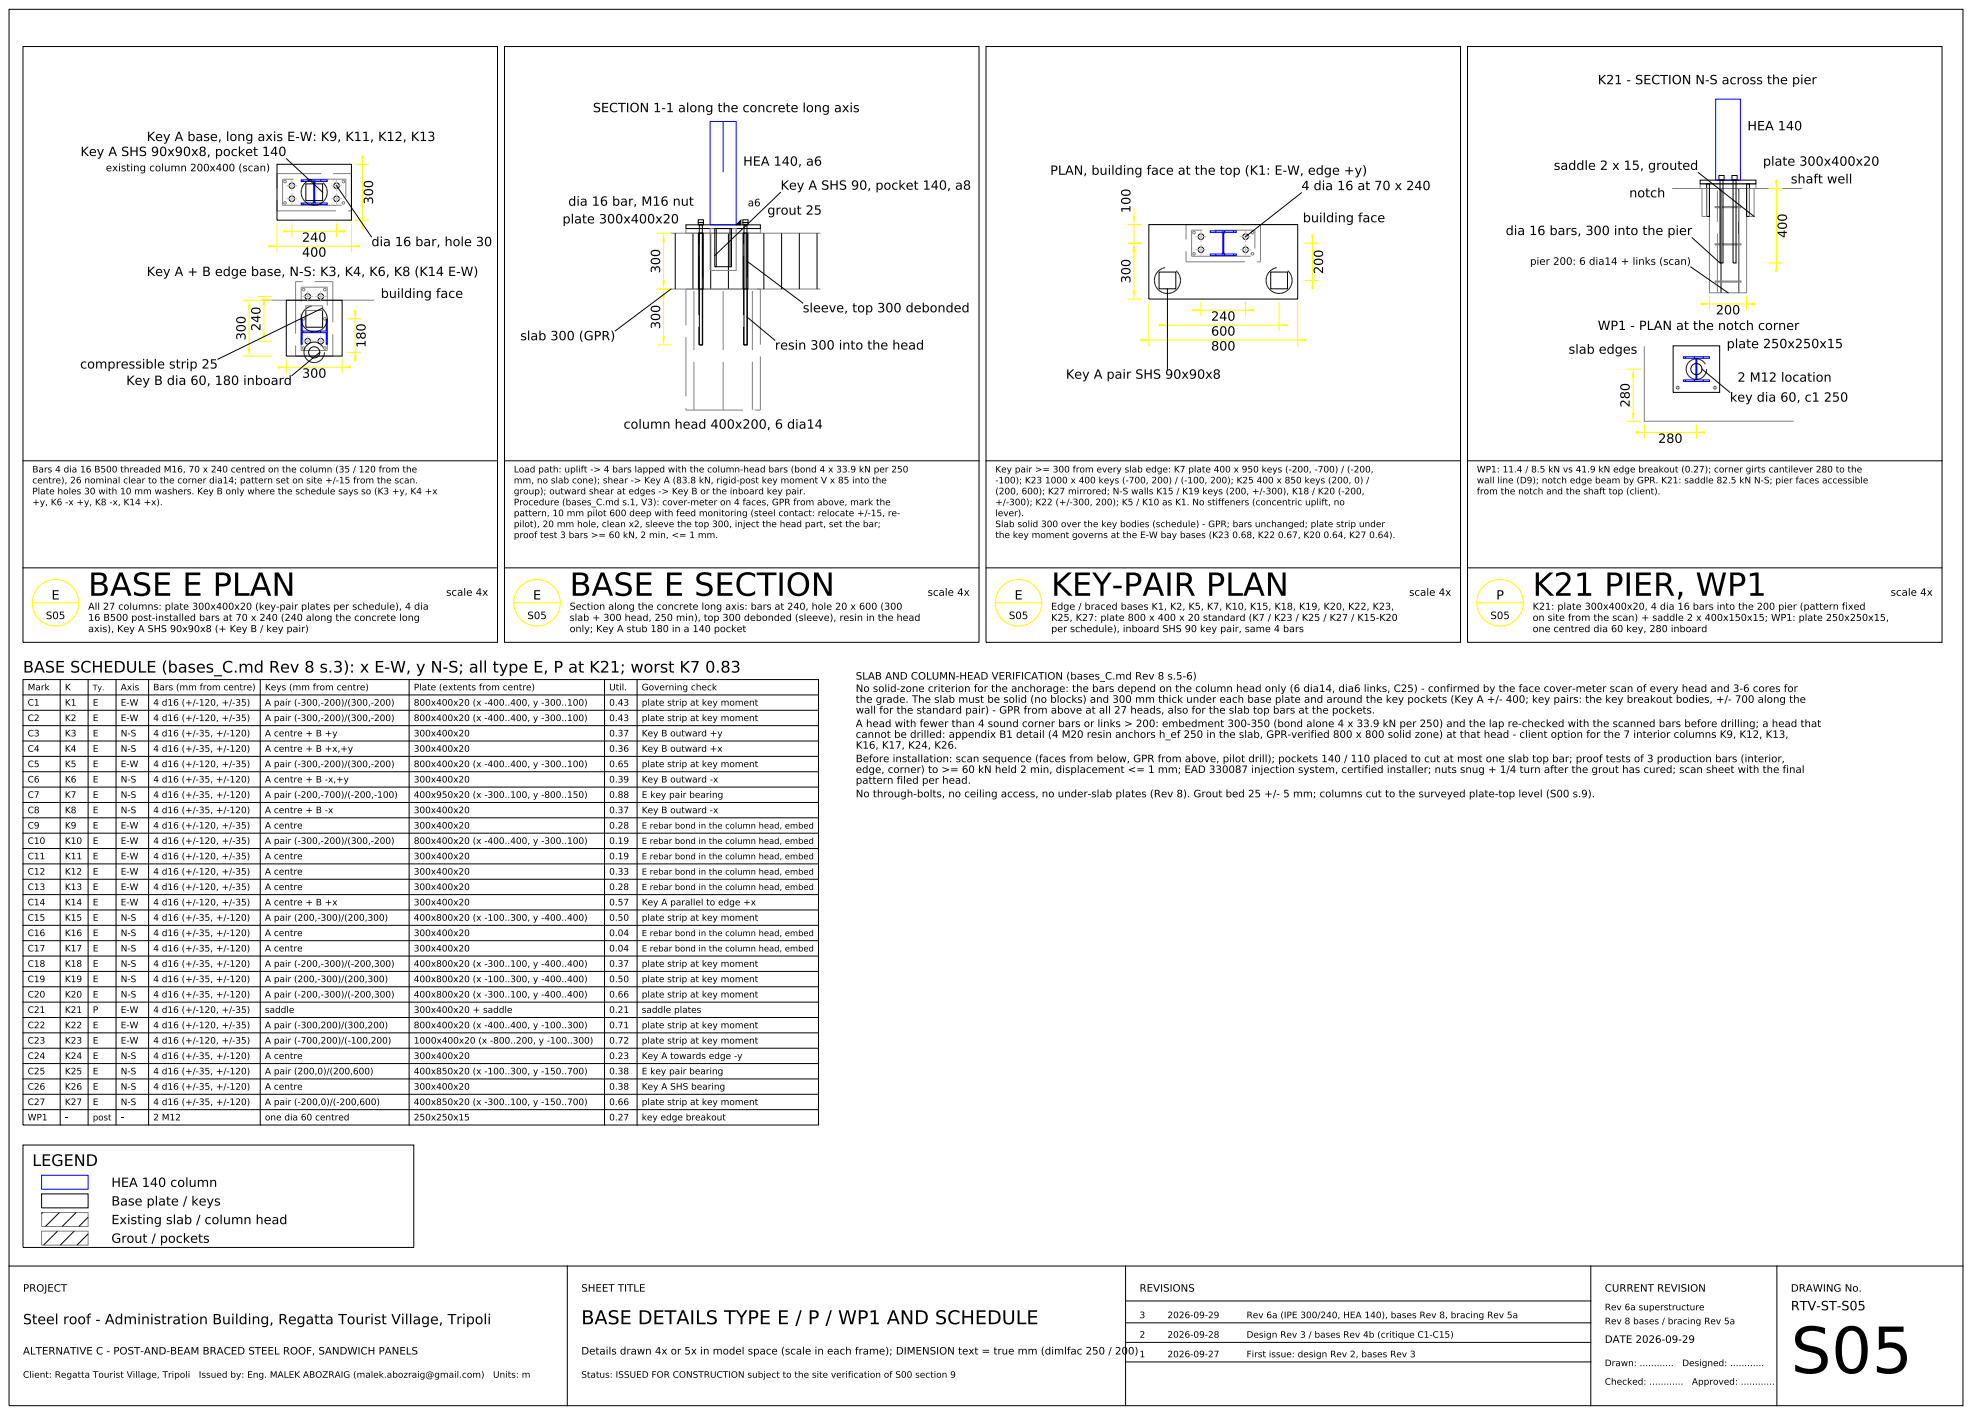
[picture p60: page 8]

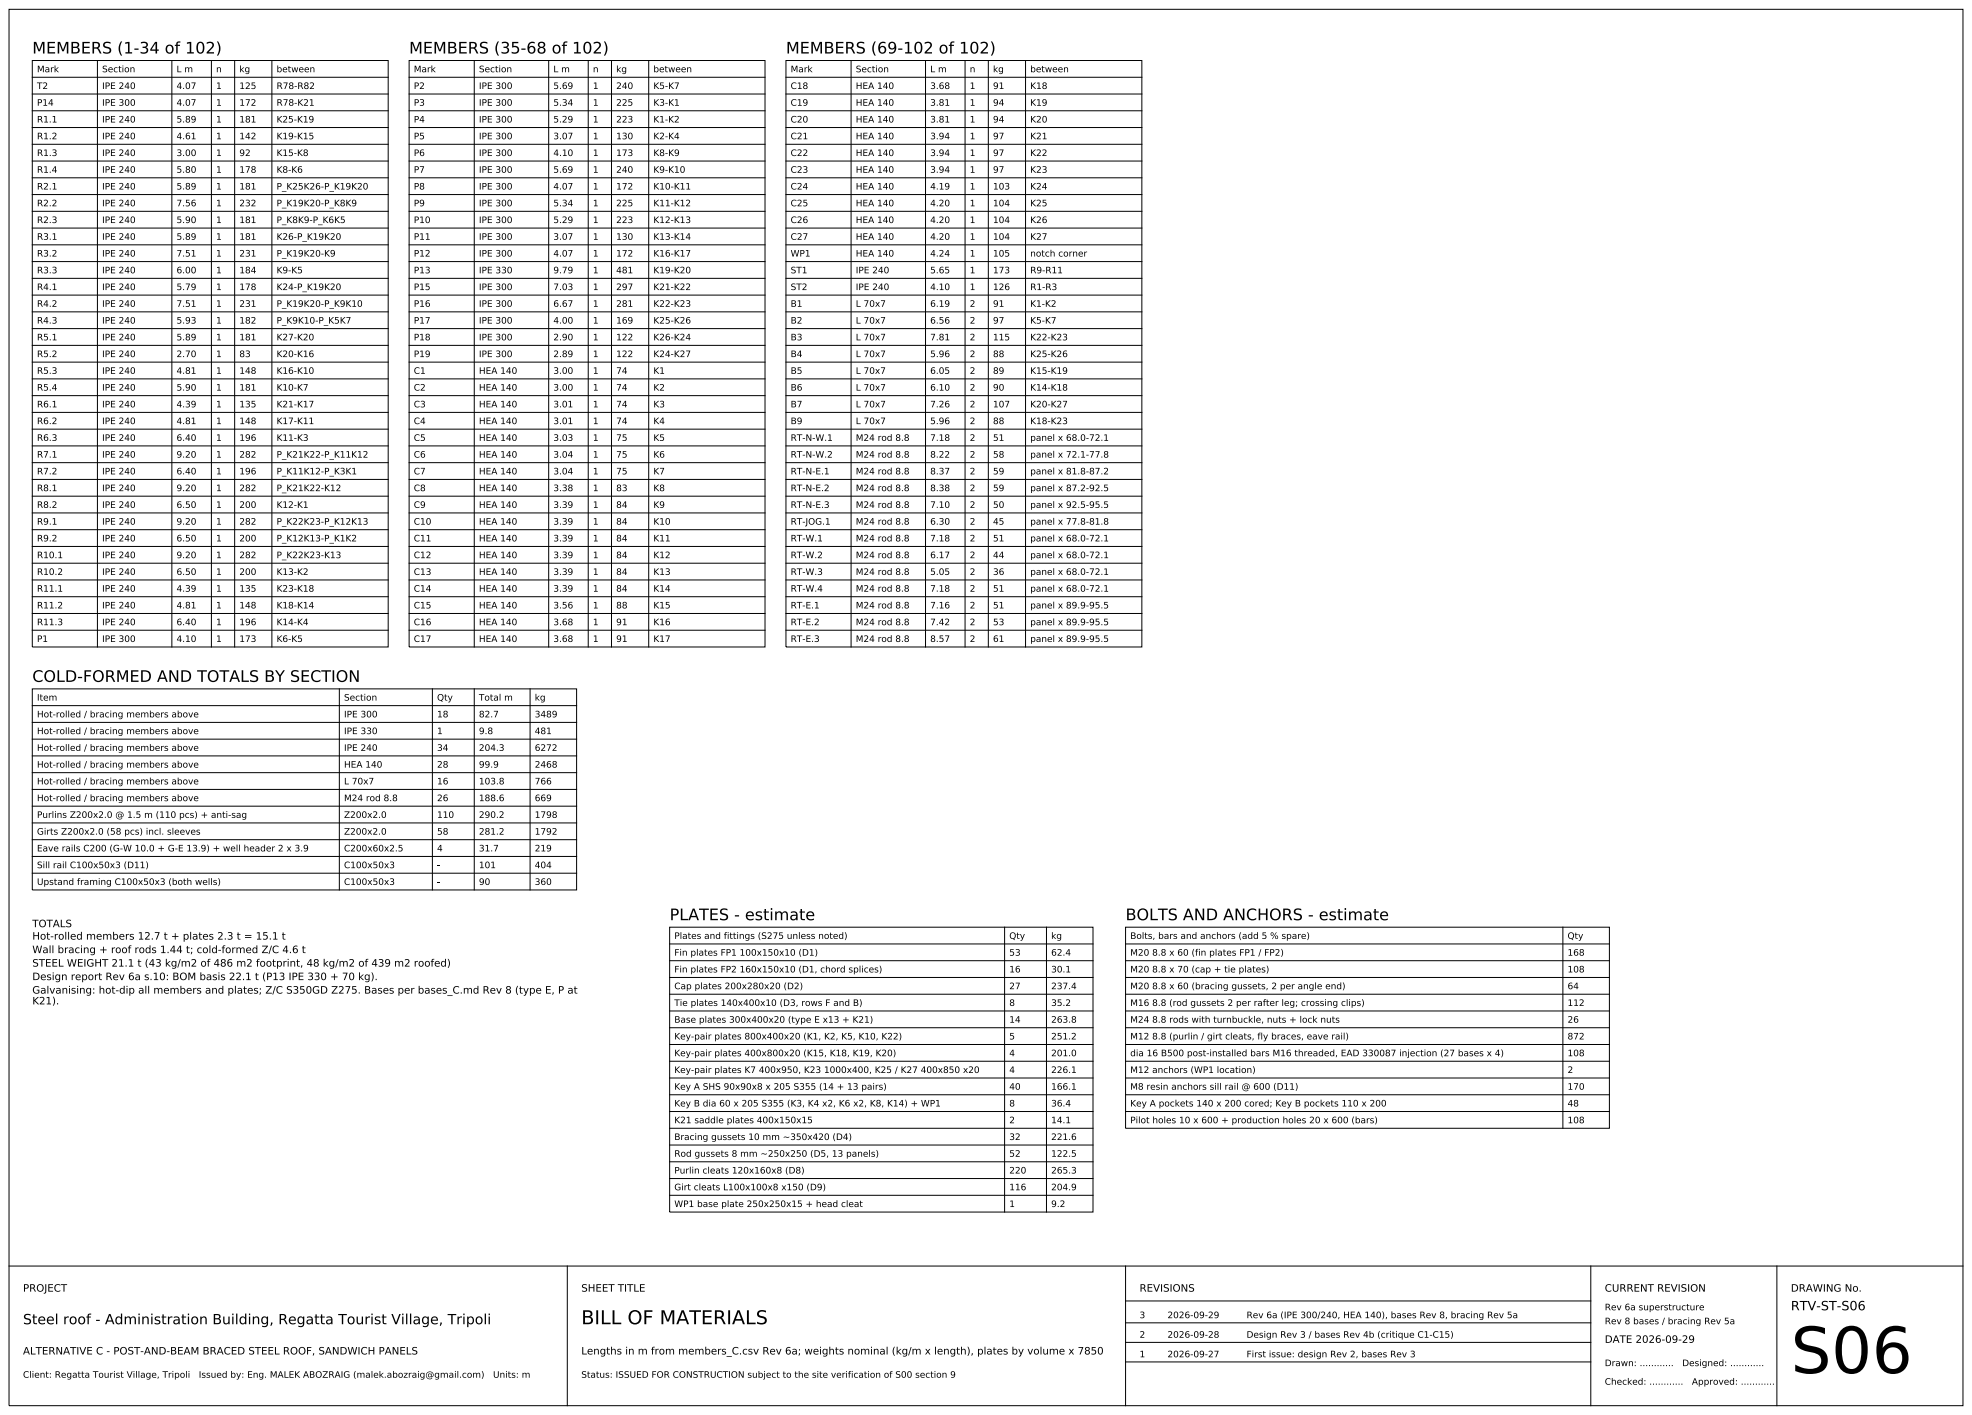
[picture p61: page 9]
