loka92/test1strsteel/(commit log)

2026-09-27 Rescale embedded OLE floor-plan image to match the vector drawing
    The OLE2FRAME bitmap on the right of Drawing1.dxf was smaller than the
    vector plan on the left. Scaled the frame by 1.3118 (23.39 x 17.51 ->
    30.68 x 22.97 drawing units) so the building envelope in the picture
    has the same size as the vector plan, and aligned its kitchen top wall
    with the vector kitchen top wall (y = 35.87). Updated the frame corners
    in the DXF tags and in the OLE binary header, the OLE text-size mapping,
    and the drawing extents.
    Claude-Session: https://claude.ai/code/session_01XH4r6AwHsj3D1hXuG1H5pc
    [Drawing1.dxf]
2026-09-27 Replace embedded floor-plan picture with vector linework plus columns
    Traced the OLE bitmap on the right of Drawing1.dxf into DXF geometry at
    the same position and scale: wall polylines with a solid hatch, stair
    treads and the blue stair path, elevator X, terrace railings, tables and
    chairs, and the room labels. Overlaid the 27 columns and their C1 labels
    from the structural plan on the left, aligned to the building envelope.
    Removed the OLE2FRAME picture. New geometry lives on ARCH-* layers.
    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
    [Drawing1.dxf]
2026-09-27 Add structural system A proposal (portal frames)
    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
2026-09-27 Add system DXF drawings (in progress)
    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
    [A_portal.dxf, B_truss.dxf, C_postbeam.dxf]
2026-09-27 Update system DXF drawings
    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
    [A_portal.dxf]
2026-09-27 Add merged DXF with the three structural systems side by side
    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
    [three_systems.dxf]
2026-09-27 System C revision 1: roof openings and single-plane slope
    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
    [A_portal.dxf, B_truss.dxf, C_postbeam.dxf]
2026-09-27 Rev 1: merged three-systems DXF and comparison update
    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
    [three_systems.dxf]
2026-09-27 Steel design alternative A: portal frames, report, checks and reactions
    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
    [members_A.csv, members_C.csv, reactions_A.csv, reactions_C.csv]
2026-09-27 Steel design C work in progress
    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
    [members_C.csv]
2026-09-27 Design C Rev 2: load basis Rev 2, review fixes, base and anchor note
    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
    [members_C.csv, reactions_C.csv]
2026-09-27 Design C bases Rev 3: slab-only anchors, inboard shear keys, solid-zone criterion, through-bolt fallback
    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
    [members_C.csv, reactions_C.csv]
2026-09-27 Bases Rev 3 sign-off review
    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
    [C_detail_drawings.dxf]
2026-09-27 Detailing package: DXF sheets S00-S06, renders, generator, README
    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
    [C_detail_drawings.dxf]
2026-09-27 Design C bases Rev 4: real slab edges, B1/B2 base types, inboard key pairs
    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
    [reactions_C.csv]
2026-09-27 Bases Rev 4 sign-off: acceptable with fixes (T1-T6)
    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
    [C_detail_drawings.dxf]
2026-09-27 Detailing: sheet S05 and BOM updated to bases Rev 4
    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
2026-09-27 Design C bases Rev 4a: T1-T6 closed, per-base plate extents, consistent key model
    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
    [reactions_C.csv]
2026-09-27 Detailing: S05/S06 updated to bases Rev 4a
    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
    [C_detail_drawings.dxf]
2026-09-28 Design C Rev 3 (bases Rev 4b): north jog, raised plane, thermal check, critique items C1-C15
    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
    [members_C.csv, reactions_C.csv]
2026-09-28 Detailing package regenerated to design Rev 3 / bases Rev 4b
    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
    [C_detail_drawings.dxf]
2026-09-28 Design C: X1 weight 25.4 t and X2 grout-bed note
    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
    [C_detail_drawings.dxf]
2026-09-28 Final package: drawing notes X1/X2, package README
    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
    [C_detail_drawings.dxf]
2026-09-28 Brief Rev 4: no through-bolts, slab 300 mm, 3D model requested
    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
2026-09-28 Design C bases Rev 5: anchored from above only, 300 mm slab, column-head anchors at edge bases
    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
    [reactions_C.csv]
2026-09-28 Bases Rev 5 sign-off: acceptable with fixes (V1-V6)
    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
    [C_concept_3d.dxf]
2026-09-28 Design C bases Rev 5a: post-installed rebar into column heads, one base type at all 27 columns
    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
    [reactions_C.csv]
2026-09-28 Design C Rev 4 on load basis Rev 3: seismic two-mass check, bases Rev 6, Rev 3 vs Rev 4 comparison
    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
    [members_C.csv, reactions_C.csv]
2026-09-28 Design C Rev 5: bracing rationalised (13 roof panels, 8 wall bays), bases Rev 7
    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
    [members_C.csv, reactions_C.csv]
2026-09-28 Design C Rev 5a: strut and fin-plate checks corrected, seismic drift check, erection notes
    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
    [members_C.csv]
2026-09-29 Design C Rev 6: IPE 300 / IPE 240 / HEA 140 adopted, bases Rev 8, 22.1 t
    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
    [members_C.csv, reactions_C.csv]
2026-09-29 Design C Rev 6a: primary offset +0.03, exact column lengths, P13 IPE 330, Y1/Y2 closed
    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
    [members_C.csv, reactions_C.csv]
2026-09-29 Detailing package Rev 6a: nine sheets, zero text overlaps, README with layout check
    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
    [C_detail_drawings.dxf]
2026-09-29 A2 PDF drawing set with project title block; technical and financial offer RTV-2026-01
    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
    [C_detail_drawings.dxf]
2026-09-29 Design Rev 7: reduced roofed area (316 m2, 20 columns), report, offer Rev A and bilingual tables
    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
    [members_C7.csv, reactions_C7.csv]
2026-09-29 Design Rev 7b: light section set on the reduced footprint (IPE 200 rafters, IPE 240 primaries, IPE 330 long eaves); heavy set kept as comparison
    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
    [members_C7.csv, reactions_C7.csv]
2026-09-29 Design Rev 8: continuous IPE 180 rafters on IPE 200 primaries, L60x6 / M20 bracing; continuous-beam solver; report and quotation-priced cost sheet
    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
    [members_C7.csv, reactions_C7.csv]
2026-09-29 Design Rev 8a: existing columns K28-K30 under the south eaves, all primaries IPE 200; offer Rev D (213,000 LYD)
    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
    [members_C7.csv, reactions_C7.csv]
